SqueakyFloors/ubertooth/README.md

<p align="center">
  <picture>
    <source media="(prefers-color-scheme: dark)" srcset="docs/images/ubertooth_wordmark_dark.png">
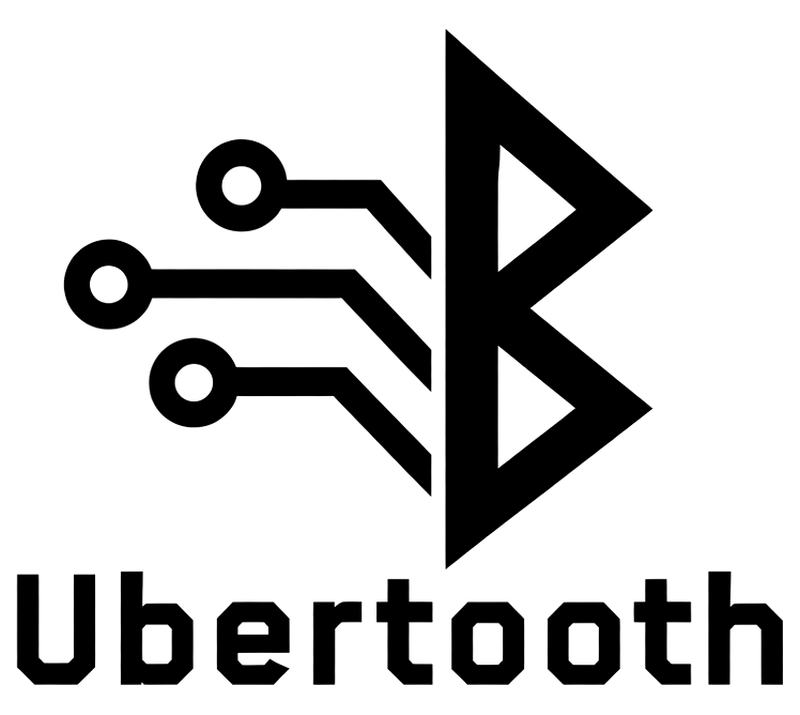
[picture p1: docs/images/ubertooth_wordmark.png]
Ubertooth
    
  </picture>
</p>

# Ubertooth

Project Ubertooth is an open source wireless development platform
suitable for Bluetooth experimentation. Ubertooth ships with a capable
BLE (Bluetooth Smart) sniffer and can sniff some data from Basic Rate
(BR) Bluetooth Classic connections.

This fork was developed largely with the help of AI coding agents, directed by
the maintainer. See [AI-DISCLOSURE.md](AI-DISCLOSURE.md) for how.

## Hardware

An Ubertooth One is a USB 2.4 GHz radio: a CC2400 transceiver behind a CC2591
front end, driven by an LPC175x ARM Cortex-M3, with an RP-SMA antenna jack.

Ubertooth One

The [hardware page](docs/source/ubertooth_one.rst) describes the board, what its
radio can and cannot do, and its connectors and LEDs. The KiCad
[design files](hardware/ubertooth-one) it is built from are in this tree.

## What it is good for

Ubertooth is a sniffer. Unlike a phone app such as nRF Connect or
LightBlue, which sees only its own connection after the operating system
has handled it, Ubertooth listens to the air and hears other devices'
traffic.

- **Passive BLE capture** of advertising and of connections between
  other devices: link-layer packets, connection setup, channels and
  timing, saved as PCAP for Wireshark.
- **Spectrum analysis** of the 2.4 GHz band, to see what else is
  transmitting and where.
- **Bluetooth Classic discovery**: finding nearby piconets by address,
  including devices that are not discoverable.
- **Scriptable**: every feature is a command-line tool with defined output
  and exit codes, so it fits test rigs and automation.
- **Open**: the firmware and host tools can be changed for custom 2.4 GHz
  radio experiments.

## What it cannot do

- **BLE on the 1M PHY only.** The CC2400 radio cannot receive the
  Bluetooth 5 LE 2M or Coded (long-range) PHYs, so it cannot capture
  extended-advertising data, and it loses a connection that switches to
  2M. Most current phones, computers and peripherals switch to 2M right
  after connecting.
- **Classic Bluetooth: Basic Rate only.** The CC2400 radio demodulates only
  GFSK, so no firmware can capture EDR payloads, which use phase modulation
  and carry most audio and fast data. Their access code and header are still
  seen. Following a piconet is slow and partial.
- **No decryption** of encrypted links without their keys.

To sniff Bluetooth 5 traffic, use a sniffer built on a Bluetooth 5 radio,
for example Nordic's nRF Sniffer for Bluetooth LE on an nRF52840 dongle.

## Versions, libbtbb, and firmware

The most recent upstream release is
[2020-12-R1](https://github.com/greatscottgadgets/ubertooth/releases/tag/2020-12-R1),
whose firmware build is on that release page. This fork's own tags are under
[Releases](#releases) below.

That release is paired with [libbtbb 2020-12-R1](https://github.com/greatscottgadgets/libbtbb/releases/tag/2020-12-R1).
The current tree instead builds against this project's
[libbtbb fork](https://github.com/SqueakyFloors/libbtbb), pinned to one commit
that `install.sh`, CI and the build guide all use, so a push to libbtbb cannot
change an Ubertooth build. The fork builds with current CMake and Python
tooling, so no extra policy or compatibility flags are needed.

Instructions for flashing the firmware are in this tree's
[firmware page](docs/source/firmware.rst).

Host tools and firmware belong together: they are built to run against each
other's firmware API version, so flash the firmware whenever you update the
tools, from the same commit or tag —
`./install.sh --flash-device <index|serial|all>`. The API version is bumped
only when a firmware change breaks older host tools, so the same version does
not mean the same commit. Tools built from a release refuse a board whose
firmware reports a different version; tools built from a clone, which is what
`./install.sh` gives you, warn about it and run the command anyway, so reflash
from the commit you built the tools from before trusting what they report.

## Building

Instructions for building libbtbb by hand, with the pin, are in this tree's
[build guide](docs/source/build_guide.rst). libbtbb and libubertooth both
install to whichever library directory the system uses — `lib`, `lib64`, or
`lib/<triplet>` — so the two land together; the host build and `install.sh`
ask CMake and pkg-config which it is rather than assuming, and
`-DCMAKE_INSTALL_LIBDIR=` chooses it.

Build dependencies (required vs optional, and what each enables) are listed in [REQUIREMENTS.md](REQUIREMENTS.md).

The install writes `libubertooth.pc`, so a program of your own built against
the installed library takes its flags from
`pkg-config --cflags --libs libubertooth` rather than being given them by
hand. A CMake project of your own finds the same install with
`find_package(ubertooth)` and links `ubertooth::ubertooth`; see
[host/README.cmake.md](host/README.cmake.md).

## Quick install (Debian/Ubuntu, Fedora, and macOS)

From a checkout of this repository, [`install.sh`](install.sh) does the whole
from-source setup in one command — system dependencies, libbtbb, the host
tools, specan_ui Python deps, and (on Linux) udev rules:

```sh
./install.sh                              # everything but the firmware
./install.sh --venv ~/ubertooth-venv      # isolate the Python tools in a venv
./install.sh --flash-device <index|serial|all>   # also build + flash firmware
./install.sh --uninstall                  # take it all back off again
```

`--update-bootloader`, alongside `--flash-device`, also installs the bootloader
this tree builds and puts the firmware back afterwards. A board that already
has that bootloader is left alone, and boards are done one at a time. Keep a
serial programmer to hand before you run it: an interrupted bootloader write
leaves a board needing one. See `ubertooth-dfu(1)`, UPDATING THE BOOTLOADER.

`--uninstall` removes the files an earlier run recorded — the tools, the
libraries, the man pages, the udev rule — and nothing else: the distribution
or Homebrew packages, the Python packages, and a `--venv` directory all stay.
The libbtbb it installed stays too unless you ask for it with
`--remove-libbtbb`, or say yes when it asks, because anything else
on the machine built against that libbtbb stops building until it is put back.

On Linux it installs into `/usr/local` with `sudo`, taking the dependencies
from `apt` on Debian/Ubuntu and from `dnf` on Fedora. On macOS it needs
[Homebrew](https://brew.sh), installs into the Homebrew prefix without `sudo`,
and skips `ubertooth-scan`/`ubertooth-follow` (no BlueZ on macOS); use
`--venv` there so the Python packages stay out of the system Python. Run
`./install.sh --help` for all options, including `--prefix`,
`--skip-deps` (use already-installed system packages), and
`--libbtbb-url`/`--libbtbb-ref`, which build a libbtbb other than the pinned
fork commit (`--help` prints the pin). This is the from-source path; it is not
a replacement for distro packaging (apt/dnf/brew).

## Releases

Release tags take three forms, all built on the `YYYY-MM-Rn` one this project
has always used:

- `YYYY-MM-DEVn` is a development pre-release: a snapshot of `main` published
  for integration testing. It may be deleted later, so do not build anything
  long-lived on one.
- `YYYY-MM-RCn` is a release candidate.
- `YYYY-MM-Rn` is the release.

Development and release-candidate tags are published as GitHub pre-releases, so
the release page's "Latest" link always points at a release.

Flash the firmware from the same tag as the tools you installed, for the reason
given [above](#versions-libbtbb-and-firmware).

The current pre-release is
[2026-11-DEV1](https://github.com/SqueakyFloors/ubertooth/releases/tag/2026-11-DEV1).

--------------------

# Tools

Ubertooth ships a set of host command-line tools. Each links to its manual page.
"Needs" indicates what a test/use requires beyond the Ubertooth itself.

New to Bluetooth internals? [How Bluetooth sniffing works](docs/concepts.md)
explains the ideas these tools are built on — hopping, address parts,
whitening, clock recovery, the Low Energy connection request — and which tool
does which step.

### BLE
| Tool | What it does | Needs |
|---|---|---|
| [ubertooth-btle](host/doc/ubertooth-btle.md) | Passive BLE monitoring; follow connections (`-f`), capture advertising (`-n`), or stream PCAP to stdout (`-q -`/`-c -`) | ambient BLE |
| [btle-extcap.py](host/doc/btle-extcap.md) | Lets Wireshark capture BLE advertising from an Ubertooth directly, by running `ubertooth-btle` for it ([guide](docs/source/using_ubertooth_with_wireshark.rst)) | Wireshark |

### Classic Bluetooth (BR/EDR)
| Tool | What it does | Needs |
|---|---|---|
| [ubertooth-rx](host/doc/ubertooth-rx.md) | Passive Classic BT discovery/decode (finds piconets, LAP/UAP); saves raw captures (`-d`) and replays them without a device (`-i`) | a Classic BT peer |
| [ubertooth-afh](host/doc/ubertooth-afh.md) | Passively recover a piconet's AFH channel map | an active piconet |
| [ubertooth-follow](host/doc/ubertooth-follow.md) | Active clock discovery + follow a piconet for a target address | BlueZ + target; **Linux only** |
| [ubertooth-scan](host/doc/ubertooth-scan.md) | Active inquiry scan (uses a BlueZ dongle + Ubertooth) | BlueZ dongle; **Linux only** |
| [ubertooth-btbr](host/doc/ubertooth-btbr.md) | **Experimental**, and the only tool that needs the separate `btbr` firmware: take part in Classic BT — inquiry, paging, `monitor` mode (capture a connection as it is set up), and transmitting chosen packet types | the `btbr` image; a Classic BT peer |

`ubertooth-follow` and `ubertooth-scan` drive a second, ordinary Bluetooth
adapter through BlueZ, so they are built on Linux only and are not coming to
macOS: the operations they ask of that adapter — a clock read and the AFH map
for `ubertooth-follow`, the remote version and features for `ubertooth-scan
-x` — are not in macOS's public Bluetooth APIs. On a Mac, cover much of the
same ground passively with `ubertooth-rx` and `ubertooth-afh`, which need no
adapter — see
[COMPATIBILITY.md](COMPATIBILITY.md#macos-ubertooth-scan-and-ubertooth-follow-are-linux-only)
for the operation-by-operation comparison and the alternatives.

### Signal / low-level
| Tool | What it does | Needs |
|---|---|---|
| [ubertooth-specan](host/doc/ubertooth-specan.md) | Spectrum analyzer: stream of 2.4GHz signal strengths | — |
| [ubertooth-specan-ui](host/doc/ubertooth-specan-ui.md) | Graphical live spectrum plot of 2.4GHz ([guide](docs/source/specan_ui.rst)) | Python 3.8+: numpy, qtpy, PySide6 or PyQt5 |
| [ubertooth-dump](host/doc/ubertooth-dump.md) | Raw stream of received bits/symbols, Bluetooth or generic (`-g`, experimental) | — |
| [ubertooth-debug](host/doc/ubertooth-debug.md) | Low-level CC2400 radio register reads, and writes (`-w`, experimental) | — |

### Device administration & firmware
| Tool | What it does | Needs |
|---|---|---|
| [ubertooth-util](host/doc/ubertooth-util.md) | Device admin: versions (`-V`), the board's bootloader (`-B`), LEDs, reset, channel, device count, the watchdog state, why the board last reset itself, and how many radio waits gave up (`-w`) | — |
| [ubertooth-dfu](host/doc/ubertooth-dfu.md) | Flash/read firmware over DFU | — |

### Special-purpose
| Tool | What it does | Needs |
|---|---|---|
| [ubertooth-ducky](host/doc/ubertooth-ducky.md) | Drive an Uberducky BLE HID-injection gadget | Uberducky hardware |
| [ubertooth-ego](host/doc/ubertooth-ego.md) | Sniff a Yuneec E-GO skateboard (niche) | Yuneec E-GO |
| [ubertooth-tx](host/doc/ubertooth-tx.md) | Transmit a generic packet (`-g`, experimental); retransmitting dumped symbols is **non-functional** | — |

### Options every tool has

`-h` prints a tool's usage text. `-V` prints the version, in the same words
whichever tool you ask: the release the host tools and libbtbb were built
from, then the firmware version of the board `-U` names, or of
each attached board. Both are in every tool, including the three written in
Python — `ubertooth-btbr`, `btle-extcap.py` and `ubertooth-specan-ui` — which
answer `-V` by running `ubertooth-util -V` and passing its answer on, so they
need it on their `PATH`. `-v` is not in every tool: see below.

```sh
$ ubertooth-util -V
Host tools version: 2026-11-DEV1+22 (libbtbb 2026-11-DEV1+22)
Firmware version: bluetooth_rxtx 2026-11-DEV1+22 (API:<version>)
```

With no board attached it prints the host line and `Firmware version: no
Ubertooth attached`, and still exits 0, so it answers "which tools am I
running?" on its own. Reading the version does not stop a mode the board is
running, and works on whatever firmware the board is carrying.

`-v` means verbose where a tool has verbose output (`ubertooth-btle -v`,
`ubertooth-specan -v`, `ubertooth-debug -v <0-2>`). One older spelling is kept
for existing scripts: `ubertooth-util -v` prints the firmware version line
alone (deprecated: use `-V`). See the
[Ubertooth overview man page](host/doc/ubertooth.md), COMMON OPTIONS.

### Which firmware a tool needs

Two firmware images run the tools, and a board carries one at a time.
`ubertooth-btbr` needs `btbr`; every other tool needs `bluetooth_rxtx`, the
standard image that `./install.sh --flash-device` builds and writes. Switch a
board to `btbr` and back with:

```sh
ubertooth-dfu -d firmware/btbr/btbr.dfu -r                      # for ubertooth-btbr
ubertooth-dfu -d firmware/bluetooth_rxtx/bluetooth_rxtx.dfu -r  # for everything else
```

Add `-U <index|serial>` to either command to pick one board of several; it
works from both images. A tool run against the wrong image fails rather than
waiting: `ubertooth-btbr` says it could not set the Ubertooth up, naming
`bluetooth_rxtx` and the image to flash, and the other tools fail on the first
request the `btbr` image does not answer. Neither is refused over its firmware
API version, because both images report this tree's.

To see which image a board is carrying, ask it — `-V` names the image as well
as the revision, and answers whichever image is running:

```sh
$ ubertooth-util -U <serial> -V
Host tools version: 2026-11-DEV1+22 (libbtbb 2026-11-DEV1+22)
Firmware version: bluetooth_rxtx 2026-11-DEV1+22 (API:<version>)
```

`ubertooth-dfu` names what is in a firmware file before it writes anything
(`Image: btbr 2026-11-DEV1+22 (API:<version>)`), and refuses a file that is not an
Ubertooth image, so the wrong file is caught before the board is touched.

The API version moves with the firmware, so these samples write it as
`<version>`; [COMPATIBILITY.md](COMPATIBILITY.md) names the value this tree
requires.

See also the [Ubertooth overview man page](host/doc/ubertooth.md).

--------------------

# Documentation

The documentation files are in the [docs folder](docs) of this repository:
[docs/source](docs/source) holds the chapters and `host/doc` the manual pages.
The [Read the Docs site](https://ubertooth.readthedocs.io/en/latest/) is built
from upstream, so it describes upstream rather than this fork.

[CONTRIBUTING.md](CONTRIBUTING.md) covers what a change to this fork needs:
the tests to run, and the CI checks a pull request has to pass.

The [validation folder](validation) holds the manual pre-release checklist a
person works through on a real Ubertooth, and will hold the description of the
validation bench and the per-release validation reports.

After editing a man page source in `host/doc/`, regenerate its committed roff
page and commit both, or the `Man pages` CI job fails:

```sh
cmake -S host -B build
cmake --build build --target refresh-manpages
```

--------------------

# Getting Help

Before asking for help with Ubertooth, check to see if your question is listed
in the [FAQ](docs/source/faq.rst).

For something this fork does, or does not do, open an
[issue here](https://github.com/SqueakyFloors/ubertooth/issues); searching the
closed ones first often answers the question. For Ubertooth in general, the
[upstream issues](https://github.com/greatscottgadgets/ubertooth/issues) are
where most questions have already been asked and answered.

Great Scott Gadgets hosts the project's community discussions on
[Discord](https://discord.gg/rsfMw3rsU8). Technical support requests are
welcome there, but there is no support staff on duty at all times, so open an
issue as well if you have found a bug or want your request tracked. Response
times on this fork's issues are whatever the maintainer can manage; the
two-week response time Great Scott Gadgets offers for "technical support"
issues applies to the upstream repository, not to this one.

--------------------

# Credits

Ubertooth was created by Great Scott Gadgets, with Michael Ossmann
([@mossmann](https://github.com/mossmann)), Dominic Spill
([@dominicgs](https://github.com/dominicgs)), and Mike Ryan
([@mikeryan](https://github.com/mikeryan)) as its principal authors. This fork
builds on their work and on contributions from the wider community. See
[CREDITS.md](CREDITS.md) for the original authors, contributors whose work is
incorporated here, and every upstream contributor.
