SqueakyFloors/ubertooth/firmware/bootloader/README

bootloader.c is the first level firmware on the Ubertooth.  With this installed
you can update the main application over USB.

The bootloader must be installed using a hardware programmer (serial or JTAG).
For example, a Pogoprog (serial programmer) may be used with the In-System
Programming (ISP) mode.  Once the bootloader is installed, application firmware
may be loaded repeatedly over USB without requiring additional hardware.
Commercially produced Ubertooth devices should have the bootloader installed at
the factory.

Operation:

The bootloader executes every time the device starts up from reset or power
cycle.  Normally it just gets out of the way and passes control to the
application firmware very quickly.  Alternatively it can enter DFU mode which
permits firmware upload and download over USB.  There are two ways to tell the
bootloader that you want it to enter DFU mode:

1. soft bootloader entry: By setting a flag in RAM, the application firmware
can instruct the bootloader to enter DFU mode following a reset (without loss
of power).  For example, with the bluetooth_rxtx firmware running you can
update the firmware via DFU mode using the 'ubertooth-dfu' (located in
host/ubertooth-tools/src/).  Soft entry only works on Ubertooth One, not
Ubertooth Zero.

2. hard bootloader entry (aka pin entry): By connecting the entry pin to ground
on the expansion header during reset, you can force the bootloader into DFU
mode. Keep the bridge connected while applying power/reset. Once the distinctive
LED sequence starts or the DFU USB device enumerates, the pin has been sampled
and the bridge may be removed without exiting DFU. Start a DFU request promptly
because an untouched pin-entry session times out after a few seconds.

Remove the bridge before resetting into the application. If it remains
connected, the next reset samples the asserted entry pin again and re-enters the
bootloader. A permanently installed bridge is therefore suitable only when
repeated bootloader entry is intended, not for normal application boot.

The bootloader indicates DFU mode by flashing the LEDs in a distinctive
pattern.  It also identifies itself as "usb_bootloader" on USB.

During DFU mode, firmware may be uploaded or downloaded using ubertooth-dfu.
For usage instructions, run 'ubertooth-dfu -h'.

It is possible that soft bootloader entry may be broken by installing a faulty
application or an application that does not provide a method of triggering soft
entry.  In this case, pin entry must be used (e.g. by holding a paper clip in
the expansion header while plugging in the device) to "unbrick" the unit.

For Ubertooth One, the pins to connect are pins 1 and 3 of the expansion header
(P4).  For Ubertooth Zero, the pins to connect are pins 1 and 13 of the
expansion header (J1).

The bootloader is installed at 0x0000.  It installs application firmware at
0x4000.

To build the bootloader you will need to install libstdc++ for ARM.
On Debian based systems:
apt-get install libstdc++-arm-none-eabi-newlib
