SqueakyFloors/ubertooth/docs/source/sniffing_BR_EDR.rst

Sniffing Classic Bluetooth
~~~~~~~~~~~~~~~~~~~~~~~~~~

Classic Bluetooth Basic Rate/Enhanced Data Rate (BR/EDR) sniffing works
differently from BLE. There is no
advertising channel to watch: a piconet hops across 79 channels, 1600 times a
second, in a sequence derived from the central's address and clock. Ubertooth
recovers those parameters from the air before it can follow a piconet.

Ubertooth's CC2400 radio supports Basic Rate using Gaussian Frequency-Shift
Keying (GFSK) at 1 Mbit/s only. EDR payloads cannot be demodulated, and
encrypted traffic cannot be decrypted.

Bluetooth address parts
^^^^^^^^^^^^^^^^^^^^^^^

A Classic Bluetooth Device Address (BD_ADDR) such as ``22:44:66:88:AA:BB``
has three parts:

.. list-table::
  :header-rows: 1

  * - Part
    - Bits
    - Example
    - How Ubertooth gets it
  * - Non-significant Address Part (NAP)
    - top 16
    - ``22:44``
    - Not transmitted in normal packets (see :ref:`finding-the-nap`)
  * - Upper Address Part (UAP)
    - next 8
    - ``66``
    - Calculated from captured packets (header error check / CRC)
  * - Lower Address Part (LAP)
    - low 24
    - ``88:AA:BB``
    - Read directly from every packet's access code

Normal packets in an established piconet do not carry the NAP. Their access
code is derived from the LAP; their hop sequence uses the LAP, the low bits of
the UAP, and the central's clock; and their header error check and CRC are
seeded with the UAP. Frequency Hop Synchronization (FHS) packets used during
inquiry and paging are the exception: their payload can carry the full
address.

Choosing the tool and firmware
^^^^^^^^^^^^^^^^^^^^^^^^^^^^^^

.. list-table::
  :header-rows: 1
  :widths: 25 20 55

  * - Tool
    - Firmware
    - Use it to
  * - ``ubertooth-rx``
    - ``bluetooth_rxtx``
    - Discover piconets by LAP and UAP, recover the clock, and follow
      passively. Works on Linux and macOS.
  * - ``ubertooth-afh``
    - ``bluetooth_rxtx``
    - Detect the adaptive frequency hopping (AFH) channel map of a known
      piconet.
  * - ``ubertooth-scan``
    - ``bluetooth_rxtx``
    - Find undiscoverable devices with Ubertooth and read each one's name with
      a normal BlueZ adapter; ``-x`` adds its version and features, and ``-s``
      adds a BlueZ inquiry for the discoverable ones. Linux only.
  * - ``ubertooth-follow``
    - ``bluetooth_rxtx``
    - Follow a piconet, given the target's whole address (``-t``) or the LAP
      and UAP a survey found (``-l`` and ``-u``), using a BlueZ adapter to
      recover the clock. Linux only.
  * - ``ubertooth-btbr``
    - ``btbr``
    - Inquiry, paging, and *monitor* mode (capture a connection as it is set
      up, including the FHS packet). Experimental.

``bluetooth_rxtx`` is the standard firmware that every other tool, including
``ubertooth-btle``, needs. The ``btbr`` firmware is a separate image for
``ubertooth-btbr`` only. Flash it with
``ubertooth-dfu -d firmware/btbr/btbr.dfu -r`` (see
:ref:`the-two-firmware-images`), and flash ``bluetooth_rxtx.dfu`` again
afterwards to use the other tools.
``ubertooth-util -V`` says which image a board is carrying, so it confirms
either switch:

	.. code-block:: sh

		$ ubertooth-util -U <serial> -V
		Host tools version: 2026-11-DEV1+22 (libbtbb 2026-11-DEV1+22)
		Firmware version: btbr 2026-11-DEV1+22 (API:<version>)

Typical workflow
^^^^^^^^^^^^^^^^

#. **Survey** for nearby piconets. Survey mode records each LAP it sees and
   calculates UAPs where it can. Devices only show up while they are actively
   communicating, so start some traffic (for example, play audio to a
   headset) during the survey:

	.. code-block:: sh

		ubertooth-rx -z -t 30

#. **Follow** a piconet. With only a LAP, ``ubertooth-rx`` calculates the
   UAP; with both, it skips straight to clock recovery. Write packets to a
   capture file for Wireshark:

	.. code-block:: sh

		ubertooth-rx -l 88aabb -u 66 -r capture.pcapng

   The clock takes a while to arrive: the search needs enough hops of the
   piconet to tell the candidate clocks apart, so following starts some way
   into the capture, and a link heard rarely, or held to a few channels, may
   give no clock at all. The addresses and the packets the board hears are
   recovered either way, and the capture above is still written.
   ``ubertooth-rx(1)``, THE CLOCK SEARCH describes what the search needs and
   what else reaches a clock.

#. **Check the AFH map** if following is unreliable. Many piconets use AFH
   to avoid busy channels, which changes the hop sequence:

	.. code-block:: sh

		ubertooth-afh -l 88aabb -u 66

#. **Open the capture** in Wireshark. The Bluetooth Baseband (BTBB) and
   BR/EDR dissectors are built into Wireshark 2.2 and newer; see the
   Wireshark plugins section of the :doc:`build_guide` for older versions.
   :doc:`bluetooth_captures_PCAP` describes the capture format.

See the man pages in ``host/doc/`` (`ubertooth-rx.md <https://github.com/SqueakyFloors/ubertooth/blob/main/host/doc/ubertooth-rx.md>`__, `ubertooth-afh.md <https://github.com/SqueakyFloors/ubertooth/blob/main/host/doc/ubertooth-afh.md>`__,
`ubertooth-scan.md <https://github.com/SqueakyFloors/ubertooth/blob/main/host/doc/ubertooth-scan.md>`__, `ubertooth-follow.md <https://github.com/SqueakyFloors/ubertooth/blob/main/host/doc/ubertooth-follow.md>`__) for all options.

Following with help from a local Bluetooth device
^^^^^^^^^^^^^^^^^^^^^^^^^^^^^^^^^^^^^^^^^^^^^^^^

``ubertooth-rx`` above recovers the piconet's clock from the air alone, which
takes a piconet that keeps transmitting and can take a while.
``ubertooth-follow`` shortens that: it pages the target through a local
Bluetooth device, reads the clock offset of the connection it gets, and hands
that to the board. It needs Linux with BlueZ and a working local Bluetooth
device; there is none on macOS, so the tool is not built there.

#. **Check the local Bluetooth device.** With none, ``ubertooth-follow`` stops
   before it opens the board:

	.. code-block:: sh

		hciconfig hci0 up

#. **Survey** for the piconet as above, so you have its LAP and UAP:

	.. code-block:: sh

		ubertooth-rx -z -t 30

#. **Follow the piconet**, by the whole address of the device that leads it if
   you know it, or by the four bytes the survey reported:

	.. code-block:: sh

		ubertooth-follow -t 22:44:66:88:aa:bb -q capture.pcap
		ubertooth-follow -l 88aabb -u 66 -q capture.pcap

   The two are the same follow. ``-t`` pages the address as given; ``-l`` and
   ``-u`` are four of the six bytes, so the tool pages ``00:00`` in place of
   the NAP, as described above. Either way the board is given the same LAP and
   UAP, which is all the ordinary traffic of an established piconet carries.

   Neither form stops on its own. Interrupt the run with Ctrl-C when you have
   the capture you wanted, or give it a length with ``timeout``.

#. **Find the right delay for this machine** with ``-w``, if the run prints
   packets and decodes little of what it prints. ``-w`` pays for the host's own
   delay between reading the clock and the board starting to hop, and its
   default of 5 does not suit every machine. "Decoded" here means the packet's
   header passed its check, which is what a wrong ``-w`` spoils while the
   record is still written. Sweep ``-w`` and keep the answer: on this project's
   bench a 25-second capture got 6169 good headers at ``-w 2`` and 28 at the
   default of 5. The ``-w`` section of
   `ubertooth-follow.md <https://github.com/SqueakyFloors/ubertooth/blob/main/host/doc/ubertooth-follow.md>`__
   says how to sweep it and how to read the result.

	.. code-block:: sh

		ubertooth-follow -t 22:44:66:88:aa:bb -w <value the sweep found> -q capture.pcap

#. **Add the AFH map** with ``-a`` if the piconet uses AFH and the follow is
   patchy. It reads the map over a connection it
   makes to the target, so it needs ``-t``; the AFH section of
   `ubertooth-follow.md <https://github.com/SqueakyFloors/ubertooth/blob/main/host/doc/ubertooth-follow.md>`__
   says what that map is, what it is not, and why the option is experimental.

	.. code-block:: sh

		ubertooth-follow -t 22:44:66:88:aa:bb -a -q capture.pcap

A follow captures the piconet's basic rate packets. EDR payloads are sent in a
modulation the radio cannot demodulate, so such a packet
arrives with its header and without its payload, and the contents of an
encrypted link stay unreadable whatever the capture holds.
`ubertooth-follow.md <https://github.com/SqueakyFloors/ubertooth/blob/main/host/doc/ubertooth-follow.md>`__
has the whole procedure, what a follow that has not locked on looks like, and
what it cannot capture.

.. _finding-the-nap:

Finding the NAP
^^^^^^^^^^^^^^^

The NAP is never sent in normal packets, so ``ubertooth-rx`` cannot recover
it.
You need it wherever a tool asks for the whole address: ``ubertooth-follow -t``
and its ``-a`` both do. Some ways to get it:

- **Use a placeholder NAP to connect.** A page uses the paged device's LAP and
  UAP, 32 bits, and no more of its address: the LAP builds the access code that
  every packet of the exchange begins with, the LAP with the low four bits of
  the UAP selects the page hopping frequencies, and the whole 8-bit UAP seeds
  the header error check and the CRC of the FHS packet the pager sends
  (Bluetooth Core, Vol 2, Part B 1.2, 1.3, 6.3.3, 6.4.6, 7.1, and Table 2.3).
  The paged device's NAP is in no packet of the exchange; the only whole address
  that goes out is the pager's own, in that FHS packet (8.3.3.2).
  BlueZ's ``hci_create_connection()`` hands the controller all six bytes, and a
  page teaches the controller no NAP, so the address it reports back in its
  events is the one it was given. BlueZ's own address checks therefore match,
  and the reads that follow a page are keyed on the connection handle or on that
  same address. ``ubertooth-scan`` relies on this: it pages
  ``00:00:<UAP>:<LAP>`` through BlueZ to read the device's name, and with
  ``-x`` its version and features. It prints ``??:??`` where the NAP would be
  in its results, and
  ``00:00`` in the address line of the extended report, which is the address it
  really connected to.

  Three things a placeholder does not cover. The whole UAP is used, so a wrong
  UAP stops the page. Anything that pairs with the target or authenticates the
  link needs its real address; neither ``ubertooth-scan``'s reads nor
  ``ubertooth-follow -a``'s map read does. And a controller refuses to page its
  own address (8.3.2), so a placeholder that happened to match the local
  adapter's would fail. What a real controller makes of the guess has not been
  measured on this project's bench.
- **Narrow it by manufacturer.** The NAP and UAP together form the
  manufacturer's 24-bit Organizationally Unique Identifier (OUI)
  (``22:44:66`` above). Search the `IEEE OUI registry
  <https://regauth.standards.ieee.org/standards-ra-web/pub/view.html#registries>`__
  for OUIs whose last byte equals the recovered UAP. Combined with the device's
  name or vendor, this often leaves a single candidate.
- **Capture an FHS packet.** The FHS packet carries the full BD_ADDR,
  including the NAP (see below).
- **Read it from the device.** If you control a paired device, its Bluetooth
  settings show the full address.

Capturing FHS packets
^^^^^^^^^^^^^^^^^^^^^

FHS packets are brief discovery and connection-establishment traffic. Devices
send them as inquiry responses, and the central sends one to the peripheral
during paging. They contain the sender's full BD_ADDR and clock. Because they are sent only during inquiry or paging,
passively following an established piconet with ``ubertooth-rx`` will not see
them.

``ubertooth-btbr`` monitor mode targets the paging phase. Flash the ``btbr``
firmware, then watch for pages to a peripheral whose address you know:

	.. code-block:: sh

		ubertooth-btbr
		bt> monitor 11:22:33:44:55:66

With more than one board attached, name the one carrying ``btbr`` with
``-U <index|serial>``, as the other tools take it; without it the tool lists
the attached boards and opens none.

Then connect to that peripheral from another device. If Ubertooth receives the
FHS before the real peripheral does, it synchronizes to the new piconet and
prints the FHS and the unencrypted Link Manager Protocol (LMP) traffic that
follows. If no FHS appears,
the peripheral responded first; try connecting again.

Limitations:

- This is a race and often takes several attempts.
- Packets sent after encryption is enabled are shown as raw data and cannot be decrypted.
- ``ubertooth-btbr`` needs the ``btbr`` image. On a board carrying
  ``bluetooth_rxtx`` it stops before its prompt with
  ``error: could not set up``, naming the board it got and the image to
  flash: that
  firmware never reads the endpoint the tool writes to, which is what the
  reports of the tool hanging shortly after start (upstream issue
  `#520 <https://github.com/greatscottgadgets/ubertooth/issues/520>`__) turned
  out to be.

`ubertooth-btbr.md <https://github.com/SqueakyFloors/ubertooth/blob/main/host/doc/ubertooth-btbr.md>`__ documents the other prompt commands
(``inquiry``, ``page``, ``inquiry_scan``, ``page_scan``, ``discoverable``,
``l2ping``, ``tx``, ``bdaddr``, ``idle``), the options, and the limitations.
