SqueakyFloors/ubertooth/host/doc/ubertooth-btle.md

# ubertooth-btle(1) -- Bluetooth Low Energy (BLE) sniffing and more

## SYNOPSIS

    ubertooth-btle {-f | -n | -p} [-A 37|38|39] [-t <BD ADDR>] [-i | -I]
    [-k [01]] [-v] [-x <0-32>] [-r <output.pcapng>] [-q <output.pcap>|-]
    [-c <output.pcap>|-] [-d <output.bin>|-] [-U <index|serial>]
    ubertooth-btle {-f | -n | -p} -R <input.bin> [-v] [-x <0-32>]
    [-r <output.pcapng>] [-q <output.pcap>|-] [-c <output.pcap>|-]
    [-d <output.bin>|-]
    ubertooth-btle -s <BD ADDR> [-A 37|38|39] [-U <index|serial>]
    ubertooth-btle [-a [<address>]] [-k [01]] [-t <BD ADDR>]
    [-U <index|serial>]
    ubertooth-btle [-U <index|serial>] -V
    ubertooth-btle -h

## DESCRIPTION

`ubertooth-btle` is a tool for doing Fun Stuff(TM) with BLE. It can do
the following things:

 - Sniff connections
 - Interfere with connections
 - Send advertising packets (experimental)

Sniffing connections is the most robust feature supported by
`ubertooth-btle`. It has two primary modes of operation: follow mode and
promiscuous mode.

Follow mode is the preferred mode for general use. In this mode,
Ubertooth will listen on one of three advertising channels waiting for a
BLE connection to be established. When a connection is established,
Ubertooth will hop along the data channels, passively capturing the data
sent between the central and peripheral. After the connection
terminates, Ubertooth will return to the advertising channel and wait
for another connection.

One connection is followed at a time. A connection request heard while a
connection is being followed is recorded in the capture like any other packet,
but is not acted on: the follow stays with the connection it started on until
that connection ends.

Ubertooth sees a connection end in one of two ways.

A pair of devices that closes the connection says so on the air. The follow
ends at the first connection event in which nothing is heard, counting from
the packet that closes the connection and the acknowledgment of it that the
other device sends. In practice that is one or two connection events after the
packet, and the capture usually holds the whole exchange: an acknowledgment
the board does not hear is not in it, and counts as the silence that ends the
follow.

Waiting for the connection to go quiet is what tells a real close from a
damaged packet. CRC verification is off unless it is asked for, so a
bit-errored data packet can look like the one that closes a connection, and a
connection that keeps delivering packets after it keeps being followed. The
wait cuts both ways, and `-k1` is the only thing that removes the exposure, by
dropping a damaged packet before the board reads it:

  * A connection event the board simply misses is silence too, so a damaged
    packet followed by a missed event does end a follow.
  * A connection that carries on for more than a connection event or two after
    a real close -- the devices still exchanging something -- keeps its follow
    and then ends it at the supervision timeout, as a connection that dies
    without warning does.

A connection that dies without warning ends at its supervision timeout
instead. The connection itself sets that timeout, anywhere from 100 ms to
32 s, and until it has passed a new connection between the same devices is
not followed.

Follow mode hops with whichever of the two channel selection algorithms the
connection uses. Which one that is was settled when the connection was made:
both ends say in their advertising and connect packets whether they support
algorithm 2, and a connection uses it only if both did. Ubertooth therefore
needs the advertisement as well as the connection request. If it caught only
the request, because the advertisement was lost, it follows the algorithm the
request asks for. That is right unless the advertiser was an older device with
no support for algorithm 2.

No-follow mode is similar to follow mode, but it only logs advertising
packets and will not follow connections as they are established.

Promiscuous mode is an experimental mode for sniffing connections after
they have already been established. This mode can be used to sniff
long-lived connections.

Promiscuous mode takes connections hopping with either channel selection
algorithm, by two different routes. What it has to work out is where the
connection goes next, and it starts from the spacings between the
connection's visits to the channel it is listening on.

Under algorithm 1 the pattern of those spacings repeats every 37 connection
events, however many channels the connection's map leaves in use, and that
gives the connection interval; timing one hop then gives the hop increment,
and the connection is followed from there.

Algorithm 2 has no hop increment: it takes each event's channel from the
access address, the 16-bit event counter, and the channel map. The access
address is known by then, so what remains is the interval -- which still
divides every spacing -- and the event counter. Promiscuous mode searches for
them: for each candidate interval and counter it works out where the
connection would have come to this channel, and takes the pair that accounts
for what it actually heard. Bluetooth 5.0 devices normally use algorithm 2.

That search starts once the algorithm-1 route has had its chance, after about
forty visits to the channel being listened on, and runs again on every set of
that many after it. A connection comes back to one channel about every 37
events, so forty visits is about eleven seconds at the shortest connection
interval a connection may use and many minutes at the longest. The search needs no channel map,
and it declines rather than answer on thin evidence, so a connection whose map
keeps about half the channels may take two or three sets before it is
recovered.

A connection recovered this way is followed without its channel map, because
the map is given out when the connection is made and never repeated. The
follow lands on the right channel for the events whose channel the map did
not move, which is roughly as many as the map keeps out of the 37, so a
capture of such a connection has gaps in it. Capturing from the setup with
`-f` has the map and does not.

That also means a recovered connection is heard less often than it speaks, so
promiscuous mode gives an algorithm-2 follow 64 connection intervals of
silence before it treats the connection as over, or five seconds, whichever is
longer. Five seconds is the longer of the two for any interval under about
78 ms, which is most connections; the 64 intervals are what matters on a slow
one, where they can be minutes.

Three limits are worth knowing. The search needs a run of about forty visits
to the channel being listened on, and a connection at the longest interval the
specification allows, 4 s, comes back to one channel so rarely that the board
cannot time the gaps: at that interval no run is collected and nothing is
recovered. A connection whose channel map keeps less than about a third of the
37 channels is out of reach as well: too many of the visits the board hears
are events the map moved to this channel, which no event counter predicts, so
the search never gets a winner clear enough to adopt. And the interval it
reports is the one the board's clock measured,
which at a long interval can be a unit of 1.25 ms away from the figure the
connection was given, because the two clocks differ by a few hundred parts
per million.

A recovered connection using all 37 channels is not captured whole either. The
follow starts from one packet of one connection event, and where in that event
the packet fell is where every later hop lands, so what share of the
connection a recovered follow catches is settled by that first packet and
differs from run to run. Capturing from the setup with `-f` does not have
that.

When sniffing, Ubertooth can only operate in either follow mode or
promiscuous mode, but not both at the same time. If you are unsure which
mode to use, use follow mode.

While promiscuous mode hunts for an access address it is gated by the board's
squelch; follow and no-follow mode are not. `ubertooth-btle` does not set the
squelch, so it is the default -120 dBm unless `ubertooth-util -z` set another
value while the board was idle, and the firmware resets it on every mode
change, so it never carries over from an earlier capture. See
ubertooth-util(1), SQUELCH.

By default, Ubertooth will follow any connection it observes. You can
limit this to following a specific Bluetooth Address (BD ADDR) using the
`-t` command line flag. `-t` is for follow mode: it picks out a connection by
the device address its advertising and connect packets carry, which is what
`-f` watches for (in `-n` the board drops the advertising packets that do not
match it, and nothing else). Promiscuous mode starts on a connection that is
already running, whose packets carry no device address at all, so `-t` has
nothing to match there and is refused with `-p`. For example, the following
command will only sniff connections where the central or peripheral's BD ADDR
is `22:44:66:88:AA:CC`:

    ubertooth-btle -f -t 22:44:66:88:AA:CC

`-t` can also take a mask length in CIDR-like notation. Masks can be
0 to 48 bits long: 48 matches the entire address, and 0 clears the target as
`-t none` does. Using a /24 mask will filter on just the OUI. For example, to
limit sniffing to just TI devices with the OUI 00:1A:7D, use the
following:

    ubertooth-btle -t 00:1A:7D:00:00:00/24

Filters persist until they are explicitly cleared or the system restarts
(either via `ubertooth-util -r` or unplug/replug). To clear a filter,
use the special filter `none`. Example:

    ubertooth-btle -t none

When filtering, advertising packets that do not match the filter are
dropped.

In all sniffing modes, Ubertooth can log data to PCAP or PcapNG with a
variety of pseudoheaders. The recommended logging format is PcapNG
(`-r`) or PCAP with LE Pseudoheader (`-q`). For compatibility with
crackle (see [USING WITH CRACKLE][]), use PCAP with PPI (`-c`).

A PcapNG capture records the parameters of each connection it sees -- the
interval, the latency, the timeout and the channel map -- so that Wireshark
can follow that connection. They go in a part of the file that is set aside
when it is created, and it has room for a few hundred connections. A capture
long enough to fill it reports

    warning: the capture file has no more room for connection parameters; the packets are still recorded, but later connections cannot be followed in Wireshark

once on standard error and carries on. Start a new capture file to record
more. The format of a PcapNG capture's own options is specified in
`docs/source/bluetooth_captures_PCAP.rst`.

In every sniffing mode, a packet carrying a Bluetooth 4.2 Data Length
Extension payload, up to its 251-byte maximum, is captured whole: on the
screen, in PCAP and in PCAPNG. The board sends such a packet in several
fixed-size records, which are put back together before anything is decoded or
written.

Interfering with connections is a feature for causing intentional
interference with newly established or long-lived connections. When this
attack succeeds, the BLE connection between the central and peripheral
will be terminated. Pair the `-i` or `-I` flag with `-f` to interfere
with new connections or `-p` to interfere with long-lived connections.
`-i` or `-I` (or their older spellings `-j` and `-J`) with neither `-f` nor
`-p` is refused before any device is opened: there is no connection to
interfere with.
This describes the feature as it is meant to work; no capture mode acts on it
at the moment (see KNOWN BROKEN FEATURES).
Note that causing intentional interference may be illegal in your
jurisdiction. Check your local laws before using this feature.

Finally, `ubertooth-btle` supports transmitting advertising packets with
a specified BD ADDR. This feature, referred to as faux peripheral mode, is
experimental and may not function as intended. Use at your own risk.

## EXAMPLES

Sniff all connections on advertising channel 38, logging all data to
PcapNG:

    ubertooth-btle -f -A 38 -r log.pcapng

Log advertising packets without following connections:

    ubertooth-btle -n

Interfere with connections recovered with promiscuous mode:

    ubertooth-btle -p -I

Send advertising packets using BD ADDR `22:44:66:88:AA:CC`:

    ubertooth-btle -s 22:44:66:88:AA:CC

## OPTIONS

 - `-h` :
   Displays help message
 - `-V` :
   print the version: the host tools, then the firmware version of
   each attached board; see ubertooth(7), COMMON OPTIONS

Major modes:

 - `-f` :
   Follow mode: sniff connections as they are established
 - `-n` :
   No-follow mode: log advertising packets but don't follow connections
 - `-p` :
   Promiscuous mode: sniff already-established connections, hopping with
   either channel selection algorithm. An algorithm-2 connection, which is
   what Bluetooth 5.0 devices normally use, takes longer to recover and is
   then followed without its channel map, so the capture has gaps in it:
   where the connection can be caught as it is made, `-f` captures all of it.
   See DESCRIPTION.

   The connection parameters it recovers are reported as they are found:
   `Access Address`, `CRC Init`, `Hop interval`, and then either `Hop
   increment` for an algorithm-1 connection or `Algorithm 2 event counter`,
   the connection event the follow starts on, for an algorithm-2 one.

   It sets no channel of its own, except that an odd frequency becomes 2440
   MHz: the odd frequencies are not BLE data channels, and the board's default
   is 2441 MHz, so a board nobody has tuned listens on 2440. It discovers the
   access address of a connection on the channel it starts on, unless an
   earlier `ubertooth-btle -a <address>` command gave the board one to follow;
   nothing else makes it skip discovery, and `-t` is refused with it. A run
   that discovered its own address works the CRC init value and the interval
   out on 2440 MHz whatever `ubertooth-util -c` asked for, because finishing
   the discovery leaves the board on 2441; a run handed an address keeps the
   channel it was tuned to. Measuring the hop increment then moves the board
   between 2404 MHz and 2406 MHz, from whichever channel the earlier stages
   used. As it
   works a connection out it reports each parameter it has recovered: the
   access address, the CRC init value, the hop interval, and then either the
   hop increment or, for a connection hopping with algorithm 2, the event
   counter the follow starts on.
   Those lines go to standard output, or to standard error once `-q -` or
   `-c -` has taken standard output, so a capture written to a file still says
   which connection it is of.

   The hop interval is not read off the air; it is worked out by timing how
   long the connection takes to come back to the channel being listened on.
   That needs several of those returns in a row, so it arrives well after the
   CRC init value: about ten seconds on a 30 ms connection whose returns are
   all heard, and proportionally longer on a slower one. It is reported only
   once the spacings repeat and give a figure inside the range a connection
   interval may take, so a connection the board hears only part of gives the
   access address and the CRC init value and no interval or increment.

   Three things it does not report an interval for. A connection using fewer
   than about five data channels comes back too often for its pattern to fit
   in what the board keeps. A connection event that runs on for more than one
   interval, which a long exchange does, puts sightings inside it that are
   not returns. And a board that hears the returns unevenly, as a capture
   losing packets does, never sees a pattern repeat.

   One case it cannot see through: a board that hears exactly every second
   return, every time, reports twice the real interval, because two returns
   of one connection and one return of a connection twice as slow are the
   same span.

   Nothing hops until the interval is known, so a capture up to that point
   holds the one channel.
 - `-s <BD ADDR>` :
   Inject advertising packets using specified BD ADDR. Like `-a`, it does not
   go with `-f`, `-n` or `-p`. The value is one whole address and nothing
   else: a faux peripheral advertises from a single address, so the `/<bits>` mask
   and `none` that `-t` takes are refused here, each as the address it is not
   (`error: faux peripheral address must be xx:xx:xx:xx:xx:xx (got none)`).

Interference (only with `-f` or `-p`):

 - `-i` :
   Interfere with one connection and return to idle. Accepted but inert at the
   moment; see KNOWN BROKEN FEATURES
 - `-I` :
   Interfere continuously with many connections. Accepted but inert at the
   moment; see KNOWN BROKEN FEATURES
 - `-j` :
   Original "jam" spelling of `-i`; does exactly what `-i` does
 - `-J` :
   Original "jam" spelling of `-I`; does exactly what `-I` does

Filtering:

 - `-t <BD ADDR>` :
   Limit connection following and interference in follow mode to the
   specified BD ADDR. It is for the follow modes: `-f` follows only a
   connection whose advertising or connect packets carry this address, and
   `-n` drops the advertising packets that do not. Every form of it, `-t none`
   included, is refused with `-p`, which has no device address to match
   against: `error: -t does not go with -p: promiscuous mode has no device
   address to match a target against`. `-s` and `-t` are two different
   addresses and a command can give both: `-s A -t B` advertises from A and
   follows B, and `-t none` clears the target without touching the address
   `-s` was given.

Logging:

 - `-r <output.pcapng>` :
   Log to PcapNG (preferred). PcapNG output cannot be streamed to stdout because
   the writer must seek while finalizing the file, so a value that names that
   stream is rejected, `-r -`, `-r /dev/stdout`, and a symbolic link pointing
   there alike.
 - `-q <output.pcap|->` :
   Log to PCAP with `DLT_BLUETOOTH_LE_LL_WITH_PHDR`. Use `-` to stream binary
   PCAP to stdout.
 - `-d <output.bin|->` :
   Dump the records as the board sent them, which `-R` replays; see
   REPLAYING A SAVED CAPTURE, which also says which records a dump leaves out.
   It is the only one of these files that keeps the parameters promiscuous
   mode recovers, since those records carry no packet for a PCAP writer to
   take. Use `-` to stream the records to stdout.
 - `-c <output.pcap|->` :
   Log to PCAP with PPI (for compatibility with crackle(1)). Use `-` to stream
   binary PCAP to stdout, for example:

       ubertooth-btle -f -c - | wireshark -k -i -

   When stdout capture is selected, regular packet/status text is suppressed so
   it cannot corrupt the binary stream; errors remain on stderr. Such a run
   does not produce the per-packet dump at all, so the decoder's complaints
   about an advertising field it could not read in one of those packets do not
   reach stderr either. The lines that
   answer an option in the same command go to stderr rather than being
   suppressed with it: the `Access address:` line of `-a`, the `CRC:` line of
   `-k`, the target lines of `-t`, and the connection parameters `-p`
   recovers. The tool
   refuses to write binary capture data directly to an interactive terminal:
   `error: stdout is a tty, refusing to write binary capture data to it`, with
   exit status 1 and before any device is opened.

`-` means standard output as the whole value of `-q`, `-c` or `-d`, and so
does a path that names this process's descriptor 1, such as `/dev/stdout` or
`/dev/fd/1`, and a symbolic link pointing at one of those (ubertooth(7),
OPTION VALUES). Standard output carries one stream,
so only one capture can have it: `-d` together with `-q` or `-c` is refused,
however each of the two was spelled, naming the PCAP option written --
`error: -q and -d cannot both write to standard output` -- as it is in
ubertooth-rx(1). The one that asked second would otherwise write to
`/dev/null` without a word.

No two capture options may be one file either: each writer opens its own
destination for writing, which truncates what another has put there, so
`-q collision.pcap -d collision.pcap` is refused with
`error: -q and -d cannot both write to collision.pcap`, before either is
opened and with the file left as it was. Every pair of `-r`, `-q`/`-c`, and
`-d` is checked, and the file is identified rather than the name
(ubertooth(7), OPTION VALUES).

The times in a logged capture follow the board's capture clock, which starts
over every 429.50 s in the `-f` and `-n` modes and every 327.68 s in
promiscuous mode. A promiscuous packet carries a count of how often it has;
the packets of the other two modes carry none, so how often it started over is
worked out from the host's own clock instead: the time the host saw pass
between two packets says how many periods lie between their clock readings, so
a quiet gap keeps its time however long it was.

The `delta_t` printed beside each packet is the gap between two of these
times, so it too holds the whole of a quiet gap and a dump and a capture of
one run agree about a packet. The first packet of a capture reports no gap,
there being nothing to measure from.

Times that still come out short are reported, on standard error: `warning:
packet times are behind the host clock by more than half the capture clock's
429.50 s period: a quiet gap lost a clock wrap, or the host clock was stepped
forwards`. Both causes look the same from here, which is why the message names
each.

A `-q` or `-r` capture record carries the packet's own power, which is the
figure printed as `rssi=` as well. Follow and advertising capture (`-f`, `-n`)
average the readings of the packet in power rather than in dBm, which is what
the average of a set of dBm readings means. A promiscuous record (`-p`) carries
no average of its own, so the figure is the strongest reading the board took
around the packet.

No low-energy record carries a figure for the background, whatever the mode
read: the two status bits that would make one readable are set on Classic
records alone. Those records leave the noise-power-valid flag clear, Wireshark
shows the field as `Unused signed byte`, and no reader computes a
signal-to-noise ratio from them. Classic capture does carry one, which
ubertooth-rx(1) describes.

A `-c` PPI record carries the board's own RSSI readings instead, as described
below.

Miscellaneous:

 - `-A <37|38|39>` :
   Which advertising channel to use in follow mode (`-f`, `-n`) and faux peripheral
   mode (`-s`) (default: 37). Refused with `-p`, which sets no channel of its
   own.
 - `-a [address]` :
   Get (`-a`) or set (`-a <address>`) the access address used in promiscuous
   mode. The address is 1 to 8 hex digits (`-a 8e89bed6`); fewer than 8 means
   leading zeros (`-a 12345` sets `00012345`). Anything else is refused before
   the device is opened. Getting and setting in one command is refused; other
   options such as `-k` still run after a get. `-a` does not go with a
   sniffing mode (`-f`, `-n`, `-p`), which runs until it is interrupted; the
   combination is refused before any device is opened. So an address for `-p`
   is given by a command of its own first: `ubertooth-btle -a <address>` and
   then `ubertooth-btle -p`. It is the one setting that makes `-p` skip
   discovery, and the board keeps it until its low-energy state next resets:
   a connection timing out during a `-p` run, a `-p` run that went looking for
   an address itself, `ubertooth-util -r`, or a re-plug. A follow run (`-f`,
   `-n`) does not clear it. Promiscuous mode then discovers an address again
   rather than falling back to the advertising one.
 - `-k [01]` :
   Read (`-k`) or set (`-k 0` or `-k 1`) CRC verification
   (default: 0). Any other value is refused. A set and a read in one command
   both happen, the set first, so the read reports the new value, in whichever
   order they are written; two sets are refused, as two values for one setting
   are everywhere (ubertooth(7), OPTION VALUES). In a sniffing mode both
   run once the mode has started, because entering a mode clears the setting,
   and the firmware then turns verification on and off itself as it recovers a
   connection.

   Verification also decides what a follow (`-f`) acts on. With it off, a
   bit-errored data packet still reaches the board's reading of the
   connection, where its length and type fields are all that tell it from a
   connection update, a channel map change, or the packet that closes the
   connection; with it on, such a packet is dropped before any of that. It is
   the only way to rule those mistakes out (DESCRIPTION).
 - `-v` :
   Verbose, as in every other tool (ubertooth(7), COMMON OPTIONS): the decoder
   describes each packet whose data it could not read, on standard error, as
   the run goes. Without it a run counts those packets and says how many there
   were in one line when it ends (DIAGNOSTICS). It needs `-f`, `-n` or `-p`,
   since there is no decode to describe otherwise, and it takes no value. A
   capture on standard output, however it was named (`-q -`, `-c -`, `-d -`,
   `-d /dev/stdout`), prints no packets at all, so that too is refused:
   `error: -v does not go with a capture on standard output: a run that hands
   the capture that stream prints no packets to describe`.

   There is one level of it, so writing it twice says what writing it once
   said (ubertooth(7), OPTION VALUES).

   A value written here is refused as any valueless option's value is, and
   `-v` without a sniffing mode reads `error: -v needs -f, -n or -p: there is
   no decode for it to describe; the CRC verify setting is -k now`.
 - `-x <0-32>` :
   Allow n access address violations (default: 32). Filtering occurs on
   host.

Data source:

 - `-U <index|serial>` :
   select an Ubertooth by enumeration index or serial number; see
   ubertooth(7), SELECTING A DEVICE
 - `-R <input.bin>` :
   Replay a dump saved with `-d` instead of opening a board. It needs the
   major mode the dump was recorded with, and goes with no option that drives
   a board; see REPLAYING A SAVED CAPTURE.

## KNOWN BROKEN FEATURES

Interference (`-i`, `-I`, and their original jam spellings `-j` and `-J`) is
accepted, but no capture mode acts on it yet: the board follows or listens to
the connection as usual and transmits nothing, so a run with one of these
options is no different from a run without it. The tool prints one `warning:`
line saying so when any of them is given. The DESCRIPTION and OPTIONS below
describe the feature as it is meant to work; making it work again is tracked in
[issue #871](https://github.com/SqueakyFloors/ubertooth/issues/871).

## USING WITH CRACKLE

`crackle` is a tool for cracking the BLE key exchange and decrypting
encrypted data. To capture data for use with `crackle`, sniff
connections in follow mode using `-f` and log data to PCAP/PPI using
`-c`. Example:

    ubertooth-btle -f -c crack.pcap

Refer to `crackle` documentation for further details.

## TRANSMIT POWER

Injecting advertising packets (`-s`) transmits at the CC2400 power level set
with `ubertooth-util -a` and leaves it unchanged. A board that has not been
given a level transmits at 7 (0 dBm), the CC2400's reset value. Sniffing does
not transmit and does not change the level. Interference (`-i`, `-I`, `-j`,
`-J`) would transmit at the same level, but no capture mode acts on it at the
moment (see KNOWN BROKEN FEATURES), so it transmits nothing.
These levels are at the CC2400 radio; the Ubertooth One's RF amplifier changes
the actual output after that.

## REPLAYING A SAVED CAPTURE

Record the raw records once with `-d <file.bin>`, then decode them as often as
you like with `-R <file.bin>`, without the Ubertooth and without the
connection. Use it to decode again with other options (a tighter `-x`, or `-v`
to see what the decoder could not read), to write a PCAP from a dump you
already have, to analyse on another machine, to attach a capture to a bug
report, or as fixed input for tests:

    ubertooth-btle -p -d promisc.bin               # live, saving the records
    ubertooth-btle -p -R promisc.bin -r log.pcapng # later, no device needed

A dump is the only file that keeps what promiscuous mode works out about the
connection it found. Those four parameters -- the access address, the CRC init
value, the hop interval, and the hop increment or algorithm-2 event counter --
arrive in records of their own, which carry no packet, so a PCAP or PcapNG
capture has nowhere to put them. A replay prints them again, in the order they
were recovered, exactly as the live run did.

A replay needs the major mode the dump was recorded with (`-f`, `-n` or `-p`),
or it is refused: `error: -R needs -f, -n or -p: a dump does not record which
mode wrote it, and the modes stamp their packets with different clocks`. The
mode is what says which of the board's two capture clocks the records carry:
the low-energy engine behind `-f` and `-n` stamps packets from a counter that
starts over every 429.50 s, promiscuous mode from one that starts over every
327.68 s. A replay read with the wrong one comes out a period wrong once a
capture has run longer than the first of them, and nothing in the file would
say so.

The decoding options (`-v`, `-x`) and the capture files (`-r`, `-q`, `-c`,
`-d`) work as they do on live data. Every other option asks for a board the
replay has not opened, and is refused by name: `error: -U cannot be combined
with -R; a replay reads a saved dump rather than driving a board`, exit 1.
That covers `-U`, `-A`, `-k`, `-t` and the interference options; `-a` and `-s`
are already refused beside any major mode.

None of those capture files may be the dump being replayed: each is opened for
writing, which truncates it, so the dump would be emptied before a record of
it was read. `error: -d would write over the dump -R is replaying
(promisc.bin)`, exit 1, with the file left as it was. It is the file that is
compared and not the name, so `./promisc.bin`, a symbolic link to it and a
hard link to it are all refused, and so is a `-d -`, `-q -` or `-c -` whose
standard output the shell has already pointed at the dump. Naming that same
standard output as `/dev/stdout` or `/dev/fd/1` is caught as well, and so is a
destination reached through a descriptor the calling shell opened,
`-d /dev/fd/3` beside `3>>promisc.bin`: the descriptor is asked which file it
holds, rather than the path being looked up.

A redirection of the whole run names no capture option, so there is nothing
to refuse: the shell has already opened the file and pointed standard output
at it. What the decode would land in is said instead. With
`ubertooth-btle -p -R promisc.bin > promisc.bin` the shell empties the file
before ubertooth-btle(1) starts, as it would for any command; with `>>` the
decode is appended to the records, which leaves the file unreadable as a dump.
Either way the run prints `warning: the decode is going to the dump -R is
replaying, so the capture is lost` on standard error and goes on, and its exit
status is the one it would have had anyway. Only a regular file on standard
output is compared, since a pipe or a terminal holds no records to spoil.

The times reported are the recorded ones, not the time of the replay. The
`systime` of each packet line is the host time stored with that record, a
capture written with `-q`, `-c` or `-r` starts from the host time of the first
packet it decodes and follows the board's clock from there, and `-d` writes
the records back out with their original times.

A dump holds every record that carries a packet or a parameter, which for a
dump of a dump this tool wrote is all of them, byte for byte. Two kinds are
left out, live and on a replay alike: a keep-alive, which only says a quiet
capture is still running and holds neither, and a record whose channel is
outside the Bluetooth band. So a dump is a record of what was captured rather
than of every byte the board sent.

A replay that reaches the end of the file exits 0, including for an empty
file. These two are reported on standard error and exit 1, after whatever was
decoded:

 - a file that cannot be read, for example a directory:
   `error: reading <file> failed: Is a directory`
 - a last record cut short:
   `error: <file> ends in a partial record: 58 of 68 bytes, ignored`

A file that cannot be opened at all is reported the same way, before anything
is decoded: `error: <file>: No such file or directory`, exit 1.

A dump of a Classic capture, or any other file of 68-byte records this tool
does not recognize, is read to its end and decoded as nothing: no packets, no
message, exit 0. Nothing in a record says which tool wrote it, so a run that
prints nothing may be the wrong file rather than a quiet capture; ubertooth-rx(1)
replays a Classic dump.

A replay that could not read one whole record takes its own capture files away
again, so a failed run leaves no empty capture to be told apart from one that
caught nothing. From the first whole record on they are kept, however little
of the input came after it.

## ARGUMENTS

`ubertooth-btle` takes options only. A word that is not an option, including a
bare `-`, is refused before any device is opened and named:
`error: unexpected argument '<word>'`, with exit status 1.

`-h` and `-V` end the command only once the whole command line has
parsed, so a stray word or a bad option value is reported even
alongside them. Both answer on standard output, so a command line with both
prints both, the usage text last; the order they were written in makes no
difference.

An option value must be a whole value in its range, or it is refused the same
way instead of being read as 0, for example
`error: advertising channel index must be 37-39 (got 40)`.

A bare `-` is still the stdin/stdout value of `-q`, `-c` and `-r`. See
ubertooth(7), OPTION VALUES, for the forms an option's value can take,
including the optional values of `-a` and `-k`, which may be written as the
next word or attached. `-v` takes no value in either form.

An option combination the tool cannot carry out is refused there too, before
any device is opened, so the message never depends on which boards are
attached: more than one of `-f`, `-n` and `-p` gives
`error: choose one of -f, -n or -p`, and a read and a set of the
access address in one command gives
`error: -a cannot both read and set the access address`.

`-a` or `-s` alongside a sniffing mode gives
`error: -a and -s do not go with -f, -n or -p: a sniffing mode runs until it
is interrupted`, so there is nothing for an access address or faux peripheral mode
request to run after. `-t` and `-k` are not in that list: `-t` is sent before
the mode starts, which is what it is for, and the `-k` options run once it has
started.

`-t` with `-p` gives
`error: -t does not go with -p: promiscuous mode has no device address to
match a target against`, whatever the target is: a connection that is already
running names no device, so `-t none` is refused beside `-p` as well.

`-i` or `-I` without `-f` or `-p` gives
`error: -i needs -f or -p: there is no connection to interfere with
otherwise`, naming the spelling that was used (`-j` and `-J` included).

That includes `-i` on its own: it says more than listing every major mode
would, because only two of them can carry interference.

A command line with no work in it is refused the same way. `-U`, `-A`, `-x`
and the capture options only shape work another option asks for, so a command
made up of those alone, or a bare `ubertooth-btle`, gives
`error: nothing to do: choose a major mode (-f, -n or -p), or -a, -k, -s or -t`,
on standard error with nothing on standard output. A bare `ubertooth-btle` is
the one refusal the usage text follows, also on standard error; every other
refused command line is the `error: ` line alone, and `-h` prints the usage
text on standard output.

A refused command line creates and truncates nothing: `-r`, `-q` and `-c` name
their file while the command line is read, and it is opened only once every
check has passed. The board is opened and its firmware is checked before that,
so a run refused for either reason leaves no empty file behind either.

## DIAGNOSTICS

Standard output carries only what was asked for: either the decoded packets or
the capture data of `-q -` or `-c -`, plus the lines that answer `-a`, `-k` and
`-t` and the parameters `-p` recovers. With the capture on standard output,
standard output belongs to the capture for the whole run: those lines move to
standard error, and the decoded packets are not printed at all.

The `rssi=` figure on each packet's `systime=` line is that packet's own level
in dBm, through a piecewise-linear model of the CC2400 datasheet's RSSI curve:
the mean power of the packet's readings where the record carries that figure,
and the strongest reading the board took around the packet where it does not --
a promiscuous record, or one from a board older than the figure. It is the same
number the signal field of a `-q` or `-r` capture carries for that packet, so a
dump and a capture of one run agree. A `-c` PPI capture carries the board's raw
counts instead, which are not dBm.

The model has ends. Above the top of it the radio reports the same reading for
every level, so there is no figure for how loud such a packet was, and the
column reads `rssi=none` rather than a number the board did not measure. That
is the word the Basic Rate `s=` and `n=` columns of ubertooth-rx(1) already use
for a level the board does not have. An advertiser a few tens of centimeters
away reaches it easily, low-energy receive turning the board's amplifier and
high-gain mode on, so it is a common reading rather than a corner case. At the
bottom, `rssi=-120` means "no louder than this".

A `-q` or `-r` capture records the figure for such a packet regardless, as a
Basic Rate capture does: a record has no way to say that a level was not
measured. So a capture file reads 0 dBm where the screen reads `none`.

Errors, warnings and progress go to standard error, each error as one line
starting `error: `, for example `error: USB poll failed` when the board stops
answering during a capture, `error: jamming not supported by this firmware`,
`error: target set failed`, or
`error: target address must be xx:xx:xx:xx:xx:xx (got 11:22:33:44:55)`. A value
that is not an address reads the same way whatever is wrong with it, and names
the address the option sets, so `-s` gives
`error: faux peripheral address must be xx:xx:xx:xx:xx:xx (got <word>)`, including
for the `none` and `22:44:66:88:aa:cc/24` that `-t` takes, and a bad target
mask gives `error: target mask must be 0-48 (got 49)`. A capture
file that cannot be created is reported as `error: <file>: <reason>`.

A capture that is losing packets says so. This tool reads its packets one at a
time, and a reply that held part of a record cannot be read as one, so it is
dropped and reported once per run: `warning: a poll reply arrived with 32 of a
packet's 64 bytes and was dropped; the capture is losing packets`. The capture
runs on and ends as it otherwise would, so the warning is the only sign.

Packets the board had to throw away are reported too. It holds captured packets
in a queue until this tool reads them, and a queue with no room left loses the
next packet; a packet longer than 50 bytes takes several of the queue's slots
and is lost whole, so a busy capture can lose the long packets while the short
ones still arrive. The first time it happens the capture warns `warning: the
recording board's packet queue filled up and it dropped at least one packet;
this capture has a gap`, and when the capture ends it says how many such gaps
there were: `warning: the capture has 3 gaps where the board's queue filled up
and it dropped packets`. The count is of gaps, not of lost packets: one full
queue can swallow several packets, and the board sends no number. Nothing says
which packets are missing, so a capture with gaps is complete only between
them. The board reports a gap on the first packet that gets through after it,
so a capture that ends in the moment after a gap does not report that last one.

A capture transfer error is reported the same way. The chip's transfer
controller can report an error on the channel a capture receives into: what the
board was receiving at the time had arrived, so it is kept and marked, while
some of its bytes may be wrong and whatever the fault cut short before it is
lost. The first mark warns `warning: the recording board had a transfer error
while capturing; what it was receiving was kept, but some of those bytes may be
wrong and the capture may be missing packets around it`, and when the capture
ends it says how many there were: `warning: the capture has 3 transfer errors
where a packet may be wrong or missing`. ubertooth-util(1) `-w` reports the
board's own count of them since power-on, over every capture the board has run.

Symbols the board wrote over are reported the same way. The board receives
into one block of symbols while its capture loop reads the one before it, and
when a block finishes arriving before the loop has read that one, the new
symbols go over the old ones. The block is gone before anything looked in it
for a packet, so this loss has no packet to point at and nothing in the output
marks where it happened. The first one warns `warning: the recording board fell
behind while capturing and wrote new symbols over a block it had not read yet;
whatever was in the air then is missing from this capture`, and when the
capture ends it says how many such places there were: `warning: the capture has
3 places where the board wrote new symbols over a block it had not read`. The
count is of those places, not of the blocks lost at them: the board has one
flag for this and no field to send a number in, so one place can stand for
several blocks.

Of this tool's capture modes only `-p` can report this loss, because it is the
one that has the board search a stream of symbols. Under `-f` and `-n` the
board receives one whole packet at a time, arming each receive and waiting for
it, so there is no unread block for the next one to go over.

A receiver being driven harder than the radio can measure is the one capture
problem this tool does not report, and it is worth knowing how it looks. It is
the `rssi=none` case above -- the level the model has no number above -- on
packet after packet rather than on one. Beyond that point the radio is also
past where it demodulates reliably, so packets start arriving with bits wrong,
and closer still none arrives at all and the capture simply goes quiet. Put
more distance or more attenuation between the two boards, or turn the transmit
power down with `ubertooth-util -a`.

ubertooth-rx(1) does report it, with the message ubertooth(7) gives, and that
is what to reach for here: this tool's board sends a record for a packet it
demodulated and for nothing else, so a record at the top of the range means a
packet that decoded there, which an ordinary close link produces all day. The
Basic Rate stream sends a record for every block of air instead, so on a bench
where two boards hear each other and nothing decodes, running `ubertooth-rx`
on the same channel is how to tell a deafened receiver from an empty one.

Packets whose data the decoder could not read are summed up in one line when
the run ends: `note: 312 packets held data that could not be decoded; -v
describes each one`, where `-v` is what asks for that description as the run
goes. Data off the air that does not hold what its own length fields describe
is ordinary, not a failure -- both a real packet with a corrupted byte and
noise that decoded as a packet produce one, and busy air gives many of them --
so the run says how many rather than a line per packet, and the
packets are recorded as they arrived. The line goes where the decoded packets
went, because that is what it is about: a run that writes a capture file and
shows no packets decodes nothing and says nothing, which is why a capture
through btle-extcap(1) leaves Wireshark's error output empty.

A poll the board does not answer is tried again, up to three attempts, before
the capture gives up: a board busy elsewhere for a moment no longer ends a
capture that has been running for hours. A board that has left the bus ends it
at once. The retry saves the capture, not the packet: the board takes a packet
out of its queue as it answers the poll, so the one a timed-out poll was
carrying is gone.

Each request that sets a mode up is named on its own, so the line says which
one the board refused: `error: could not set the advertising channel`,
`error: could not set the advertising data`, `error: could not start
advertising` for `-s`, and `error: could not start follow mode` (or
`no-follow`, or `promiscuous`) for the sniffing modes. No capture starts after
one of these.

`-q` and `-c` share one capture handle, so a second file between them is
ignored with `warning: ignoring extra capture file: <name>` and the first one
given is used; `-r` has its own handle, so `-q a.pcap -r b.pcapng` writes both.

A command line the tool will not take is reported as that one `error: ` line
on standard error, with no usage text after it: the line describes the
problem, and `-h` prints the usage text for a reader who wants it. An option
the tool does not know reads `error: unrecognized option '-Z'`; one whose
value is missing reads `error: option '-A' requires a value`.

`-h` is what the user asked for, so the usage text goes to standard output.
Nothing else goes to standard error either, unless the rest of the command
line produced a warning before `-h` ended the command. A bare
`ubertooth-btle`, with no arguments at all, is the one refusal the usage text
does follow, on standard error with the `error: ` line.

## EXIT STATUS

0 when the command did what was asked, including `-h`, and after a capture is
interrupted (Ctrl-C) having polled cleanly to that point.

0 as well for a run stopped by Ctrl-C before it had opened a board: see
ubertooth(7), SELECTING A DEVICE.

1 for a command line the tool will not take or with nothing to do, for a
capture file that cannot be created, when the selected Ubertooth is not found
or cannot be opened, when the board refuses the jam mode, a `-t` target, a
sniffing or faux peripheral mode, or an access address or CRC verify request, and
when a capture stops short because a poll failed. No device is opened for a
refused command line.

A poll the board does not answer is tried again, up to three attempts of one
second each, so one unlucky poll does not end a capture that has been running
for a quarter of an hour. A stop (Ctrl-C, or SIGTERM, SIGHUP or SIGQUIT) drops
the attempts still to come: the attempt already under way finishes, which costs
up to a second, and if it failed, that failure is reported (`error: USB poll
failed`) and the run exits 1, where a capture left to use its remaining
attempts might have recovered and exited 0.

1 as well when the board refuses the request that ends a capture: it is left
in the capture mode, and no other tool can open it until it is reset or
re-plugged. What was captured stays written out, and libubertooth names the
refused request on standard error.

A `-q`, `-c`, `-r` or `-d` file is created once the board has been opened and
its firmware accepted, not before, so a run refused for either reason leaves
no empty capture behind. A file the tool then cannot create is reported with
the name the user gave, and the board is given back.

1 as well for a replay (`-R`) of a file that cannot be opened or cannot be
read whole, after whatever was decoded; see REPLAYING A SAVED CAPTURE.

`-V` reads the attached board, so it exits 1 when a board is attached and
cannot be read, or when the USB bus cannot be listed at all; see ubertooth(7),
COMMON OPTIONS.

## SEE ALSO

ubertooth-util(1): sets the receive squelch (`-z`); SQUELCH describes how
long it lasts

crackle(1): https://github.com/mikeryan/crackle

ubertooth(7): overview of Project Ubertooth; OPTION VALUES describes how
option values are written

## COPYRIGHT

`ubertooth-btle` is Copyright (C) 2012-2018 Mike Ryan. This tool is
released under the GPLv2. Refer to COPYING for further details.
