SqueakyFloors/ubertooth/host/doc/ubertooth-follow.md

# ubertooth-follow(1) -- active (BlueZ) CLK discovery and follow for a target address

## SYNOPSIS

    ubertooth-follow [-t <BD ADDR> | -l <lap> -u <uap>] [-b <hciN>] [-e <0-5>]
    [-w <timeslots>] [-r <file.pcapng>] [-q <file.pcap>|-] [-d <file.bin>|-]
    [-U <index|serial>]
    ubertooth-follow -t <BD ADDR> -a [-b <hciN>] [-e <0-5>] [-w <timeslots>]
    [-r <file.pcapng>] [-q <file.pcap>|-] [-d <file.bin>|-]
    [-U <index|serial>]
    ubertooth-follow [-U <index|serial>] -V
    ubertooth-follow -h

## DESCRIPTION

Follows a classic Bluetooth (BR/EDR) piconet for a given target address.
It uses a local BlueZ Bluetooth device to assist with clock discovery and an
Ubertooth to follow the piconet's frequency hopping.

Name the target one of two ways:

 - `-t` is its whole address, `xx:xx:xx:xx:xx:xx`, in either case of hex
   digit. That is what the tool connects to, and it gives the LAP and UAP the
   board follows, so `-t` needs neither `-l` nor `-u`. Use `-t` for a real
   target: it is the only form `-a` works with, and the only one that connects
   to the target's address rather than a partly guessed one (see AFH below).
 - `-l` and `-u` together are the lower and upper address parts, which is what
   `ubertooth-rx` reports for a piconet it has seen. They are four of the six
   bytes of an address; the two missing ones are the non-significant address
   part (NAP), which ordinary piconet traffic does not carry, and the tool
   fills them in as zero. A page does not carry the paged device's NAP either,
   so that placeholder has nothing to do with whether the page this form makes
   to collect the clock offset succeeds, unless it happens to match the local
   Bluetooth device's own address, which a controller refuses to page (see AFH
   below).

One of `-l` and `-u` without the other names no piconet, so it is refused and
the missing half is named: `error: -l <LAP> requires -u <UAP>`.

`-t` with `-l` or `-u` is refused: the two are the same setting written two
ways, and the tool does not reconcile them. With no target at all, the address
is read from the local Bluetooth device — note this may yield the wrong
address in some cases, so naming the target explicitly is recommended.

A clock read through the adapter can still turn out not to be the piconet's,
and the capture then goes back to searching for one, as ubertooth-rx(1)
describes under THE CLOCK SEARCH. The UAP is not searched for again. However
the target was named, its UAP came from the command line or from the local
Bluetooth device rather than from the air, so a header that fails to decode is
no evidence against it: the UAP is put back and the warning names it.

    warning: the clock being followed was not this piconet's; searching for its clock again, and putting UAP 0d back

If that UAP is in fact wrong, nothing of the piconet will decode, and the line
above says which one the tool is holding you to.

The capture is gated by the board's squelch, which this tool does not set: it
is the default -120 dBm unless `ubertooth-util -z` set another value while the
board was idle, and the firmware resets it whenever the board leaves a mode,
so it never carries over from an earlier capture. See ubertooth-util(1),
SQUELCH.

Requires BlueZ (Linux only). The clock and AFH-map reads this tool is built
around are not reachable from macOS's public Bluetooth APIs, so it is not
built there and no macOS version is planned. `ubertooth-rx -l <LAP>` recovers
the addresses and the clock from the air without an adapter, which takes it
hops of the piconet and some of a capture, and against a link heard rarely may
not get there at all: see ubertooth-rx(1), THE CLOCK SEARCH. Reading the clock through an adapter, as this tool does, takes one page and
one read, with a one-second deadline on the read. See
COMPATIBILITY.md for the comparison.

## OPTIONS

 - `-t <BD_ADDR>` :
   the target's whole address, `xx:xx:xx:xx:xx:xx`, which gives the LAP and
   UAP to follow as well as the address to connect to. Not with `-l` or `-u`,
   and given once.
 - `-l <LAP>` :
   target LAP (3 bytes / 6 hex digits), given once, and with `-u`. Not with
   `-t`.
 - `-u <UAP>` :
   target UAP (1 byte / 2 hex digits), given once, and with `-l`. Not with
   `-t`.
 - `-U <index|serial>` :
   select an Ubertooth by enumeration index or serial number; see
   ubertooth(7), SELECTING A DEVICE
 - `-V` :
   print the version: the host tools, then the firmware version of
   each attached board; see ubertooth(7), COMMON OPTIONS
 - `-r <filename>` :
   capture packets to a PCAPNG file. A PcapNG writer seeks back over what it
   has written, which standard output cannot do, so a value that names that
   stream is refused, `-r -`, `-r /dev/stdout`, and a symbolic link pointing
   there alike:
   `error: PCAPNG capture to stdout is not supported; use -q -`
 - `-q <filename>` :
   capture packets to a PCAP file. `-q -` writes the capture to standard
   output; see CAPTURING TO STANDARD OUTPUT
 - `-d <filename>` :
   dump received symbols to the named file. `-d -` writes them to standard
   output; see CAPTURING TO STANDARD OUTPUT
 - `-e <0-5>` :
   maximum access-code errors to tolerate (default: 2).
 - `-a` :
   enable AFH (adaptive frequency hopping); experimental, and needs `-t`. See
   AFH below.
 - `-b <hciN>` :
   local Bluetooth device to use (default: hci0).
 - `-w <timeslots>` :
   USB delay in 625us timeslots (default: 5). The right value belongs to the
   machine, not to the piconet, and the default is not it on every machine;
   see THE -w DELAY below.
 - `-h` :
   print the usage text on standard output and exit 0. It takes effect once
   the whole command line has parsed, so a bad option value, a stray word or
   an option given twice is still reported.

A record of a `-q` or `-r` capture carries the packet's own power and the
board's estimate of the background on its channel, and the screen shows the two
as `s=` and `n=` with `snr=` the difference. Where the board has admitted no quiet
reading since it last started counting there is no estimate: the capture's
noise-power-valid flag stays clear, Wireshark shows the field as `Invalid Noise
Power`, and the screen prints `n=none snr=none`. A packet whose level is at the
top of the receiver's range is not measured either, and the screen prints
`s=none snr=none` for it. ubertooth-rx(1) describes both figures, what the
estimate rests on, and where the dBm scale ends.

The board has one reading of the channel to work from, so both figures are of
whatever is on it. A transmitter louder than the packet, on the same channel at
the same moment, is what the signal figure describes, and the packet is then
part of the background.

## AFH

`-a` is experimental. It makes the local BlueZ device connect to the target and
asks the local controller for the AFH channel map of *that* link, then follows
the piconet keyed on the target's LAP/UAP. The two are the same hop sequence
only when the target is the Central of the piconet you want to follow, which
`ubertooth-follow` cannot check. Treat a capture made with `-a` accordingly.

`-a` reads the map over a connection to the target, and the tool asks for the
target's own address before it will make one: `-a` without `-t` is refused
before any file is created or device opened, with
`error: -a reads the AFH map over a Bluetooth connection to the target, so it needs the whole target address: give -t xx:xx:xx:xx:xx:xx`.
That is a requirement of the command line rather than of the air interface, as
the next paragraph explains.

A follow keyed on `-l` and `-u` instead connects to `00:00:<UAP>:<LAP>`, with
the two most significant bytes zero, because ordinary piconet traffic does not
carry them. That guess is not what decides whether the page reaches the target:
of the target's address, a page uses only the LAP and the UAP, as the access
code, as the input that selects the page hopping sequence, and as the seed of
the header error check and CRC of the FHS packet the pager sends (Bluetooth
Core, Vol 2, Part B 1.3, 6.4.6, 7.1, and Table 2.3), and the AFH map and clock
offset reads that follow the page are keyed on the connection handle rather
than on an address. So a page that fails here has an ordinary cause: the
target is out of range, it is not accepting connections, or the `-u` given is
wrong. The one way
the guess itself can stop the page is by matching the local Bluetooth device's
own address, which a controller refuses to page. What a real controller makes
of the guessed NAP has not been verified
([#699](https://github.com/SqueakyFloors/ubertooth/issues/699)). When the
page does fail, the command stops, saying what to do about it:

    error: connecting to 00:00:33:44:55:66 failed: Host is down; -l and -u give four of the six bytes of the target address, so 00:00 is a guess: give the whole target address with -t xx:xx:xx:xx:xx:xx

The line offers `-t` because it is the only way to take the guess out of the
picture and is what `-a` needs, not because the guess is why the page failed.
Give the target as `-t` and the connection is made to the address as it is, so
the line is then the reason alone, without the advice. A page that fails
without leaving a reason behind drops the `: <reason>` from whichever of the
two lines it is.

The map is read as soon as the connection is up, which is the earliest the
tool can read it and the latest it can act on it before the follow starts. A
controller that has not yet settled on a hop sequence for a link it has only
just made answers that AFH is off, so that is the common answer against a
freshly paged target, and the follow goes ahead without a map.

The map that comes back is used only when it could be a hop sequence at all:

 - a failed read stops the command (`error: AFH map read failed: ...`), rather
   than following with whatever the map happened to contain. `-a` therefore
   does not work on a controller that does not implement
   HCI_Read_AFH_Channel_Map; run without `-a` on one of those;
 - a reply of AFH off is followed without it:
   `the remote device is not using AFH; following without it`. The board is
   then told to clear its map, as a follow without `-a` does: a board left
   streaming by a follow that was killed is still in the same mode, so it
   takes this run's mode request as a re-sync of the old one and keeps the map
   that run set. An accepted map is applied after the follow has started
   rather than before, because a mode start that does begin afresh forgets a
   map set first (see ubertooth-util(1), CARRY-OVER BETWEEN RUNS);
 - a map with fewer than the 20 channels AFH requires, or none at all, is read
   again — three reads in total, 200ms apart — in case it has not settled. If
   it still reports too few, the command stops and says so;
 - a mode byte that is neither off nor on is refused and printed.

A refused `-a` never reaches the Ubertooth: the map is read before any board is
opened, so the board is left alone and the connection the tool made to the
target is dropped on the way out. The only AFH request a run without an
accepted map makes is the map clear above, from a follow that goes ahead
without one.

## EXAMPLES

Follow a target whose address you know, writing a PCAP:

    ubertooth-follow -t 11:22:33:44:55:66 -q capture.pcap

Follow the same target with an AFH map (see AFH above):

    ubertooth-follow -t 11:22:33:44:55:66 -a

Follow a piconet by the LAP and UAP `ubertooth-rx` reported for it. This
connects to `00:00:33:44:55:66`, whose two most significant bytes are a guess.
If that page fails the command stops and asks for the whole address (see AFH
above). Use `-t` for a real target:

    ubertooth-follow -l 445566 -u 33 -q capture.pcap

## A FOLLOW FROM START TO FINISH

What a run looks like, from not knowing the target to a capture file. It needs
a Linux machine with a working local Bluetooth device, an Ubertooth carrying
`bluetooth_rxtx`, and a piconet that is carrying traffic throughout: a phone
streaming audio to a headset will do. A piconet that goes quiet leaves nothing
to capture.

1. Check the local Bluetooth device is there and up. With none,
   `ubertooth-follow` stops before it opens the board, naming the device it
   looked for. `hciconfig hci0 up` brings one up.

2. Survey for the piconets around you, thirty seconds to start with and longer
   in a crowded room. Each line is a LAP the board heard, with a UAP where it
   has worked one out. That UAP is a guess from the packets the board decoded
   and a short survey can get it wrong, so give the survey time, or take the
   address from the device itself:

       ubertooth-rx -z -t 30

3. Point the follow at the piconet the target leads: `-t` with its whole
   address if you know it, or `-l` and `-u` with the four bytes the survey
   reported. Either way the tool names the target on standard error before it
   opens the board, so a run against the wrong piconet shows before any packet
   does: `-t` prints a `Target` line with the address and the LAP and UAP taken
   from it, and `-l` with `-u` prints the address the page will use, carrying
   `00:00` in place of the two bytes they do not name.

       ubertooth-follow -t 11:22:33:44:55:66 -q capture.pcap
       ubertooth-follow -l 445566 -u 33 -q capture.pcap

4. Watch what the run prints. The tool pages the target through the local
   Bluetooth device, reads the clock of the connection it gets, hands that to
   the board as the clock to hop on, and starts capturing. Unlike
   ubertooth-rx(1), it does not search the air for a clock: it is given one, so
   there is no acquisition to wait for and a follow that is working prints
   packets from the start: the wait before the first record is the wait for a
   packet of the piconet to arrive. A run that prints none has one of five causes: the
   piconet is not transmitting, the board cannot hear the piconet, the `-u`
   given is wrong, the clock the board was given is off by enough to put it on
   the wrong channel, which is what `-w` adjusts for, or the target is not the
   Central of the piconet. The last of those finds nothing at all rather than
   part of the traffic: every packet in a piconet carries the Central's access
   code and hops on the Central's clock, so a follow keyed on a Peripheral's
   address is listening for a piconet that is not there.

   A wrong `-u` silences a run by putting the board on the wrong channels. The
   hop sequence is built from the LAP and the low four bits of the UAP, so a
   `-u` wrong in any of those four bits hops differently from the piconet and
   meets it only now and then. A `-u` wrong only in its top four bits leaves
   the hop sequence alone: such a run prints packets and decodes none of them,
   which is the case DESCRIPTION above describes. A wrong `-u` can also stop
   the page, and then the run exits 1 with the reason.

   The run ends when you interrupt it (Ctrl-C), with exit status 0 and the
   capture written, so give it a length with `timeout` when you script one.
   `timeout` reports 124 for a run it ended; `timeout --preserve-status` gives
   the tool's own status instead.

5. Find the `-w` this machine needs, if the run prints packets and almost none
   of their headers pass, and the `-u` is not the cause (step 4 describes the
   `-u` that looks the same). `-w` pays for the host's own delay between
   reading the clock and the board starting to hop, and the default is not the
   right value on every machine. It is worth doing once per machine and keeping
   the answer; see THE -w DELAY below.

       ubertooth-follow -t 11:22:33:44:55:66 -w <value the sweep found> -q capture.pcap

6. Add `-a` once the capture works without it, if the piconet uses AFH and the
   follow is patchy (see AFH above). It needs `-t`:

       ubertooth-follow -t 11:22:33:44:55:66 -a -q capture.pcap

7. Open `capture.pcap` in Wireshark, which has dissected this format since
   2.2. ubertooth-rx(1) describes the per-packet report the run printed, and
   the project documentation describes the capture format.

## THE -w DELAY

A follow is handed the piconet's clock, so it has nothing to search for. But
between reading that clock through the local Bluetooth device and the board
starting to hop, the host spends time of its own on the USB transfers and the
kernel, and the board's clock has to be moved on by that much to stay with the
piconet. `-w` is how much: a whole number of 625us Bluetooth timeslots, 5 by
default.

The delay is the host's own, so the value that suits one machine is no guide to
another and the default does not suit every machine. Sweep it over a piconet
that is carrying steady traffic, a few values either side of the default, each
leg the same length. Sweep in the form you will capture in, with `-t` or
without: the two take the clock by different routes, so a value found one way
need not hold for the other.

    d=$(mktemp -d)
    for w in 0 1 2 3 4 5 6 7 8; do
      cap="$d/w$w.pcapng"
      timeout 25 ubertooth-follow -t 11:22:33:44:55:66 -e 0 -w $w -r "$cap"
      records=$(tshark -r "$cap" | wc -l)
      bad=$(tshark -r "$cap" -V | grep -c 'Incorrect Packet Header or HEC')
      echo "w=$w $((records - bad / 2)) of $records headers passed"
    done

The count that matters is the headers that passed, not the records written: a
board hopping on a wrong clock still matches the access code now and then and
records every match, so a bad value can write hundreds of records and get
nothing out of any of them. Wireshark marks a bad header `Incorrect Packet
Header or HEC` and `tshark -V` prints that twice per frame, which is the
halving above. Do not count the packet detail the run printed instead: that
needs the payload too, which an enhanced data rate payload never reaches, so
on a link carrying EDR every value would read as zero.

Sweep with `-e 0`, exact access codes only: at the default `-e 2` the extra
records matched with an error allowed are how a bad value comes to look like a
working capture.

Throw away any leg where the piconet went quiet, and any leg that printed the
warning that the clock being followed was not this piconet's (see DESCRIPTION
above): the first reads as a clean zero and the second is no longer a reading
of `-w` at all. Confirm from the devices themselves that each leg had traffic
to capture.

The useful range is narrow: a value a slot or two out can decode nothing at
all, so a machine whose value is not the default captures nothing until the
sweep finds it. The best value repeats from sweep to sweep; how much it
captures does not, and no value of `-w` takes that variation out. So treat
`-w` as deciding whether a follow decodes anything, not how much.

## WHAT A FOLLOW DOES NOT CAPTURE

A capture holds the basic rate packets of one piconet, decoded as far as they
can be without the link's keys. Three things are not in it however well the
follow goes:

 - **Enhanced data rate payloads.** The board's radio demodulates Gaussian
   frequency-shift keying at 1 Mbit/s, which is basic rate. An enhanced data
   rate packet starts at basic rate, so its access code and header are decoded
   and the packet appears in the capture; its payload is sent in a phase-shift
   keying the radio cannot demodulate, and that part is missing.
 - **The contents of an encrypted link.** Encryption covers the payload, and
   the keys are agreed during pairing, which has usually happened long before a
   follow starts. The capture holds the packets, their headers and their
   timing; what the devices said to each other stays unreadable.
 - **Any piconet but the one named.** A follow hops with one piconet's
   sequence, so traffic from everything else around it is off-channel almost
   all of the time. Capture a second piconet with a second board, not with a
   second filter.

Packets lost for other reasons are reported while the run goes; see GAPS IN A
CAPTURE below.

## ARGUMENTS

`ubertooth-follow` takes options only. A word that is not an option, including a
bare `-`, is refused before any device is opened and named:
`error: unexpected argument '<word>'`, with exit status 1.

`-h` and `-V` end the command only once the whole command line has
parsed, so a stray word or a bad option value is reported even
alongside them. Both answer on standard output, so a command line with both
prints both, the usage text last; the order they were written in makes no
difference.

An option the tool does not know is refused the same way, as one line on
standard error with no usage text after it: `error: unrecognized option '-Z'`.
An option whose value is missing reads `error: option '-l' requires a value`.

An option value must be a whole value in its range, or it is refused the same
way instead of being read as 0, for example
`error: LAP must be 6 hex digits (got 4466)` and
`error: target address must be xx:xx:xx:xx:xx:xx (got 11:22:33:44:55)`.

Three more kinds of command line are refused before any device is opened, each
with its one line:

 - any option given a value twice, `error: option '-t' given more than once`:
   the tool does not pick between two answers to the same question. This is
   the rule for every tool; see ubertooth(7), OPTION VALUES;
 - `-t` with `-l` or `-u`,
   `error: -t gives the whole target address, so it cannot be combined with -l or -u`;
 - one of `-l` and `-u` without the other,
   `error: -l <LAP> requires -u <UAP>` or
   `error: -u <UAP> requires -l <LAP>`: the two name a piconet only together.
   `-a` beside half a pair still reports `-a` needing `-t`, since completing
   the pair would not let `-a` run.

`-` means standard output as the whole value of `-q` or `-d`, and so does a
path that names this process's descriptor 1, such as `/dev/stdout` or
`/dev/fd/1`, and a symbolic link pointing at one of those (ubertooth(7),
OPTION VALUES). Any other value is a file name,
including one that starts with `-`: `-q -x` writes the file `-x`. Standard
output carries one stream, so `-q` and `-d` cannot both have it in one
command: `error: -q and -d cannot both write to standard output`. `-r` is not
part of that pair, since it never has the stream: every value naming standard
output is refused when `-r` is read, not only a lone `-`.

A file name cannot be shared either. Each of `-r`, `-q` and `-d` opens its own
destination for writing, which truncates whatever another has put there, so no
two of them may name one file: `error: -q and -d cannot both write to
capture.pcap`, exit 1, with the file left as it was. The file is identified
rather than the name, so two spellings of one path, a symbolic link, a hard
link, a `/dev/fd/N` beside the file that descriptor holds, and `-q -` beside a
`-d` naming the file the shell has pointed standard output at are all caught.
Two destinations that both reach that stream, however each was spelled, get
the one-capture-on-standard-output refusal above instead. `-` is the
stream and `./-` is an ordinary file of that name, so `-q - -d ./-` is two
destinations unless the shell really has pointed standard output at that file.

Writing both captures to `/dev/null` is not refused, since nothing is kept
there and nothing is lost. Some pairs that are one file cannot be told apart
from the names alone and are not refused either; see ubertooth(7), OPTION
VALUES.

What the tool is following — the target address, or the LAP and UAP it read
from the local device — is reported on standard error, with the rest of the
tool's progress. Standard output carries the decoded packets, and, with `-a`,
the accepted channel map — unless a capture has taken that stream, and then
the map is on standard error with the progress; see CAPTURING TO STANDARD
OUTPUT.

A refused command line creates and truncates nothing: `-r`, `-q` and `-d` name
their file while the command line is read, and it is opened only once every
check has passed. The board is opened and its firmware is checked before that,
so a run refused for either reason leaves no empty file behind either. A file
that cannot be created is one `error: ` line naming it, for example `error:
/no/such/dir/dump.bin: No such file or directory`, and exit 1.

## CAPTURING TO STANDARD OUTPUT

`-q -` writes the PCAP capture to standard output and `-d -` the raw symbols,
for a pipe into another program. Either way the capture owns standard output
for the whole run, so the per-packet report is not printed; the packets
themselves are in the capture.

What the tool is following, the notes and the failures are on standard error
and still arrive, and so is the `AFH map:` line of `-a`, which is the answer to
that option.

Redirect standard output to a new file or a pipe, not to one being appended
to: the capture is opened again through a descriptor-filesystem path,
`/dev/fd` where there is one and `/proc/self/fd` otherwise, which truncates,
so `ubertooth-follow -q - >> capture.pcap` loses what the file held.

Binary on a terminal is a mistake rather than a stream anyone reads, so it is
refused: `error: stdout is a tty, refusing to write binary capture data to
it`, exit 1. Redirect or pipe standard output instead.

## GAPS IN A CAPTURE

A capture that is losing packets says so. The board holds captured packets in a
queue until this tool reads them, and a queue with no room left loses the next
packet. The first time it happens the capture warns `warning: the recording
board's packet queue filled up and it dropped at least one packet; this capture
has a gap`, and when the capture ends it says how many such gaps there were:
`warning: the capture has 3 gaps where the board's queue filled up and it
dropped packets`. The count is of gaps, not of lost packets: one full queue can
swallow several packets, and the board sends no number. Nothing says which
packets are missing, so a capture with gaps is complete only between them. The
board reports a gap on the first packet that gets through after it, so a
capture that ends in the moment after a gap does not report that last one.

A capture transfer error is reported the same way. The chip's transfer
controller can report an error on the channel a capture receives into: what the
board was receiving at the time had arrived, so it is kept and marked, while
some of its bytes may be wrong and whatever the fault cut short before it is
lost. The first mark warns `warning: the recording board had a transfer error
while capturing; what it was receiving was kept, but some of those bytes may be
wrong and the capture may be missing packets around it`, and when the capture
ends it says how many there were: `warning: the capture has 3 transfer errors
where a packet may be wrong or missing`. ubertooth-util(1) `-w` reports the
board's own count of them since power-on, over every capture the board has run.

Symbols the board wrote over are reported the same way. The board receives
into one block of symbols while its capture loop reads the one before it, and
when a block finishes arriving before the loop has read that one, the new
symbols go over the old ones. The block is gone before anything looked in it
for a packet, so this loss has no packet to point at and nothing in the output
marks where it happened. The first one warns `warning: the recording board fell
behind while capturing and wrote new symbols over a block it had not read yet;
whatever was in the air then is missing from this capture`, and when the
capture ends it says how many such places there were: `warning: the capture has
3 places where the board wrote new symbols over a block it had not read`. The
count is of those places, not of the blocks lost at them: the board has one
flag for this and no field to send a number in, so one place can stand for
several blocks.

A receiver being driven harder than it can measure is reported once per run:
`warning: the signal is at the top of the receiver's range, so the board
cannot measure it and may not demodulate it; the boards may be too close
together, or the transmit power too high`. The radio reports the power of each
block of air on a scale that runs out, and a receiver held at the top of it is
also past where it demodulates reliably -- so this is the case where nothing
decodes and the board is not at fault. Put more distance or more attenuation
between the boards, or turn the transmit power down. See ubertooth(7).

When the capture ends it says how many such stretches there were:
`warning: the capture has 3 stretches where the signal was at the top of the
receiver's range`, one per block of records judged to be there. The running
warning is said once, so the total is what tells one bad stretch from a
capture that was deaf throughout.

## EXIT STATUS

A follow that was interrupted (Ctrl-C) exits 0 with whatever it captured, and
so does `-h`. A refused command line exits 1 (see ARGUMENTS), as does a file
that cannot be opened and a target the tool could not set up a follow on.

A run stopped by Ctrl-C before it had opened a board exits 0 as well: see
ubertooth(7), SELECTING A DEVICE. That covers everything from the board being
found onwards. The adapter setup before it, and the page in particular, is the
part of a follow that a signal ends the way it would end any other program: the
page waits up to 25 seconds, BlueZ takes its own calls again when a signal cuts
them short, and no handler of this tool's is installed yet, so Ctrl-C there
ends the tool at once rather than cleanly.

A page to the target that fails exits 1 as well, before any board is opened:
the page is what yields the target's clock offset, and a follow of a named
target without it would hop on the local device's clock instead. A follow keyed
on `-l` and `-u` pages a guessed `00:00:<UAP>:<LAP>`, so that line also asks
for the whole address with `-t` (see AFH above).

A board that refuses the target's address, the clock reset, the Basic Rate
modulation, or the AFH map the follow sets or clears exits 1 before the
capture runs, with the request named on standard error. The two map requests
read `error: setting the board's AFH map failed` and `error: clearing the
board's AFH map failed`. Following anyway
would mean a board that is not set up for the piconet: without the target's
address it matches no packet, and with its clock never zeroed it hops on a
clock the offset was not measured from.

Standard output stays empty in that case, and standard error names the request,
why the board refused it and the libusb code, adding a note where there is
something to try:

    error: could not zero the board's clock: the board did not answer in time (libusb -7)
    note: if a mode is running, stop it with ubertooth-util -S; a board that does not answer at all usually resets itself within a few seconds, so run the command again, then reset it with ubertooth-util -r on the same board if it stays silent, and unplug it or power-cycle its hub port if that does not reach it either

That pair is the report, the same one ubertooth-rx(1) and ubertooth-scan(1)
give: the request named as `set the Bluetooth address` for the address, and as
`zero the board's clock` for the clock reset. A request the board's firmware
has not got is stalled, which reads `error: could not zero the board's clock:
the board's firmware does not support it (stalled, libusb -9)`, with notes
naming the board's firmware API version and the one these tools need, and the
reset that recovers a board which stalls every request (see ubertooth(7),
FIRMWARE OF ANOTHER API VERSION). A board that took only part of
either write gives the counts instead, as `error: Bluetooth address write
failed: board took 8 of 16 bytes` or `error: clock write failed: board took 2
of 4 bytes`, and the follow stops on that one line.

A follow whose USB stream fails part-way also exits 1: the board stopped
answering, or dropped off the bus, so the capture stops there and holds only
what arrived before it. The failure is reported on standard error as it
happens, as `error: receive transfer failed: <reason>`. A board that never
hands the transfer back at all exits 1 too, reported by the `warning:` line
ubertooth(7) describes rather than that error.

A follow the board would not stop exits 1 as well: the request that takes the
board out of its capture mode was stalled, so the board is left in that mode
and no other tool can open it until it is reset or re-plugged. What was
captured stays written out, and libubertooth names the refused request on
standard error.

The `-q`, `-r`, and `-d` files are created once the board has been opened and
its firmware accepted, and a run refused after that removes them again, so a
refused follow leaves no empty capture behind whatever refused it. For this
tool they are created later than it sounds: the adapter, the connection to the
target, and the AFH read all come first, so a path that cannot be opened is
reported after them. Every fault in the command line, a terminal on standard
output included, is refused before any of it.

A regular file named by `-q` or `-d` is removed, whether this run created it
or truncated one that was already there, so removing it does not bring the old
contents back. Anything else is left where it is, along with whatever the run
wrote through it: a device, a pipe, a symbolic link, a path naming one of this
process's descriptors, and the file standard output was redirected to. A removal that will not go is
reported as `warning: cannot remove <path>: <reason>` and does not change the
exit status. `-r` refuses a path that exists rather than writing over it, so
it never reaches this.

A run that cannot allocate the piconet it follows exits 1 with `error: out of
memory`, before the adapter or a board is opened; `-h` and `-V` are answered
first and so still work on a machine with no memory for one.

A capture that could not be started at all exits 1 as well, whichever step
failed: the receive transfer libusb would not take, the host thread that
collects the capture, or the request that starts hopping. Standard error
carries the one `error: ` line for that step, for example `error: could not
start the thread that collects the capture: Resource temporarily unavailable`.
The status is 1 in every case, never the failing call's own return value: a
negative libusb code handed to the exit status is wrapped into a byte, so
`libusb -9` reached a script as 247.

An adapter `-b` names that does not exist, or that cannot be opened, exits 1
with one `error: ` line naming it, the same wording ubertooth-scan(1) uses:
`error: Bluetooth device hci7 not found: No such device`.

`-V` reads the attached board, so it exits 1 when a board is attached and
cannot be read, or when the USB bus cannot be listed at all; see ubertooth(7),
COMMON OPTIONS.

## SEE ALSO

ubertooth-util(1): sets the receive squelch (`-z`); SQUELCH describes how
long it lasts, and CARRY-OVER BETWEEN RUNS what else a board keeps from one
command to the next

ubertooth-rx(1): recovers the addresses and the clock from the air, with no
adapter; THE CLOCK SEARCH describes what that costs

ubertooth-scan(1): the other BlueZ tool, which finds the piconets an adapter
cannot see

ubertooth-afh(1): recovers the channel map of a piconet whose LAP and UAP are
known, with no adapter

ubertooth(7): overview of Project Ubertooth; OPTION VALUES describes how
option values are written

## COPYRIGHT

Released under the GPLv2. Refer to [COPYING](https://github.com/SqueakyFloors/ubertooth/blob/main/COPYING) for further details.
