SqueakyFloors/ubertooth/host/doc/ubertooth.md

# ubertooth(7) -- Project Ubertooth

## OVERVIEW

Ubertooth is a platform for Bluetooth experimentation. It is able to
sniff BLE, discover undiscoverable classic Bluetooth devices, and perform
rudimentary sniffing of classic Bluetooth devices.

Ubertooth is **not** a Bluetooth dongle and it will not show up as one
when running `hciconfig`.

## COMMAND LINE TOOLS

The following command line tools included in this package are the
primary means of using Ubertooth. Refer to their manual pages for
example usage and comprehensive documentation.

Useful commands:

 - ubertooth-btle(1) : BLE sniffing and other fun
 - ubertooth-rx(1) : Classic Bluetooth device discovery and rudimentary sniffing
 - ubertooth-scan(1) : Active (BlueZ) scanning of undiscoverable devices; Linux only
 - ubertooth-afh(1) : Detecting the AFH map of a Classic Bluetooth piconet
 - ubertooth-ego(1) : Yuneec E-Go electric skateboard sniffing
 - ubertooth-follow(1) : Active (BlueZ) clock discovery and piconet following;
   Linux only
 - ubertooth-btbr(1) : Experimental Classic Bluetooth connections and
   monitoring; needs the separate `btbr` firmware image

Utility commands:

 - ubertooth-dfu(1) : Firmware update tool
 - ubertooth-dump(1) : Dumping raw RF symbols to disk, Bluetooth or generic
   (experimental)
 - ubertooth-tx(1) : Transmitting a generic packet (experimental), and
   retransmitting symbols dumped with ubertooth-dump
 - ubertooth-ducky(1) : Driving an Uberducky as a BLE USB Rubber Ducky
 - ubertooth-util(1) : "Everything else"

Less useful commands:

 - ubertooth-debug(1) : Reading registers on the CC2400, and writing them
   (experimental)
 - ubertooth-specan(1) : Raw RSSI values used by graphical specan
 - ubertooth-specan-ui(1) : The spectrum analyzer window that plots them

Run by another program rather than by hand:

 - btle-extcap.py(1) : Wireshark's own capture interface, which puts an
   Ubertooth in Wireshark's capture list and captures BLE into the window
   with no file in between. Wireshark starts it; its page says where to
   install it

## COMMON OPTIONS

`-h` and `-V` mean the same thing in every tool, including the three written
in Python -- ubertooth-btbr(1), `btle-extcap.py` and ubertooth-specan-ui(1) --
which take their command lines from getopt in Python, from Wireshark's extcap
protocol and from `argparse`. Those three answer `-V` by running
ubertooth-util(1) `-V` and passing its answer on, so the lines below are the
same words whichever tool was asked; `ubertooth-util` has to be on their
`PATH`, as it is when the tools are installed together, and one that is not
there is reported as `error: could not run ubertooth-util: No such file or
directory`. `btle-extcap.py` has no `-U`, so its `-V` reports every attached
board. ubertooth-specan-ui(1) answers `-V` and `-h` without the `numpy` and
Qt binding its window needs, and ubertooth-btbr(1) answers them without the
Python `libusb1` package a session of its own needs. `-v` is not in every tool; the last paragraph here says what it means
where it is.

`-h` prints that tool's usage text on standard output and exits 0.

`-V` prints the version on standard output, and is the way to ask what is
installed and what a board is running. It exits 0, except for the two
failures below: a board that is attached and cannot be read, and a USB bus
that cannot be listed at all. Every tool answers it in the same words, one
labelled line each, so a script can take the line it wants whichever tool it
ran:

    Host tools version: <release> (libbtbb <release>)
    Firmware version: <image> <release> (API:<version>)
    Firmware build: <the date the image was built>

The first line is the host's and needs no board: the release these tools were
built from, with libbtbb's beside it. A release name, not a commit, so it is
the line to quote when reporting a problem; a build after a release carries
how many commits it is past that release, as in `2026-11-R1+22`, and a `*`
where the tree it was built from had uncommitted changes. Where this run
loaded a libbtbb from somewhere other than the one these tools were built
against -- a distribution or Homebrew build beside this fork's, which decodes
packets its own way -- a `warning:` line on standard error says so.

The two firmware lines describe the board `-U` names, or the only board
attached. With several boards attached and no `-U`, both lines are printed for
each of them with its index in the label, as the identity queries of
ubertooth-util(1) are: `Firmware version (0): ...`, `Firmware build (0): ...`.

With no Ubertooth attached the host line is followed by `Firmware version:
no Ubertooth attached` and the status is still 0: the host half of the answer
needs no board, and nothing attached is an answer rather than a failure. A
board sitting in the DFU bootloader is named in a `note:` on standard error
there, with a second line saying what reaches it where it is the only one
waiting, because no tool but ubertooth-dfu(1) can open one and that is the
usual reason a board is not in the answer. A
board that is attached but cannot be read -- in use by another program, or not
answering -- has the reason on its own line (`Firmware version: unavailable,
in use by another program`, or `Firmware version: read failed`) and the status
is 1. So does a USB bus that cannot be listed at all, which is nothing known
rather than nothing attached: `Firmware version: unavailable, the USB bus
could not be listed`.

Part of an answer can go missing on its own, and the status is 1 then too: a
board that answered its version but not its build string prints `Firmware
build: read failed` under a good version line, or `Firmware build: not
reported` if the read worked and the board had no build string to give, and
one whose API version could not be read prints the version with no
` (API:...)` after it.
So a script that cares about the whole answer should test the status, not
only look for a reason in place of a version.

Asking for the version does not disturb a board: it is not told to stop, so a
mode running on it keeps running, and any firmware is read whatever API
version it reports, which is what makes `-V` the way to identify an unknown
board.

`-v` means verbose, where a tool has verbose output: ubertooth-specan(1) `-v`,
ubertooth-debug(1) `-v <0-2>`, and ubertooth-btle(1) `-v`, which describes each
packet whose data the decoder could not read. One tool spells something else
`-v`, an older spelling kept so that existing scripts keep working:
ubertooth-util(1) `-v` prints the `Firmware version:` line on its own
(deprecated, and unchanged: use `-V`). ubertooth-btle(1) `-v` named that tool's
CRC verify setting until `-k` took it over, so a value written after it is
refused with a line naming `-k`.

## OPTION VALUES

These pages write an option's value as a separate word: `ubertooth-util -c
2440`, `ubertooth-btle -a 8e89bed6`, `ubertooth-rx -l 446688 -u 22`. This
follows a standard, the POSIX Utility Syntax Guidelines (guideline 6: an option
and its value are separate arguments). The value placeholders are written the
same way (`-c <2402-2480>`). The older attached form is still accepted for
backward compatibility with existing scripts, so `-c 2440` and `-c2440` are the
same. Where the value is optional, the next word
is taken as the value only when it is a valid value, so an option never
swallows the option after it: `-c -b` reads the channel and then the board ID,
while `-z -90` sets the squelch to -90 dBm. The `ubertooth-*` tools written in
C take single-letter options only, apart from ubertooth-dfu(1), whose
`--update-bootloader` and `--force` are words because of what they do; a long
option no tool knows is refused with `error:
unrecognized option '--bogus': the tools take single-letter options`, and so
does ubertooth-btbr(1). The long options that take a value belong to two
tools -- `btle-extcap.py`, whose are Wireshark's, and ubertooth-specan-ui(1)
`--wifi` and `--padding` -- and are written `--name value` or `--name=value`,
never attached without the `=`. ubertooth-dfu(1)'s two take no value and have
to be written out in full. A lone `-` as the value of
a file option means standard output, so `ubertooth-btle -q -` writes the
capture to stdout. A capture destination that names the same descriptor by
path -- `/dev/stdout` or `/dev/fd/1`, and `/proc/self/fd/1` on Linux, with any
redundant `/` or `.` between
the names in it -- is that stream too, so the capture owns it and the tool's
own report lines stay out of it, and so is a symbolic link whose chain ends at
one of those names, because a writer writes through a link. Any other spelling
the system itself answers with descriptor 1 counts as well: the BSDs read a
leading zero as part of the number, so `/dev/fd/01` is that stream there and
names nothing at all on Linux. `/dev/fd/N` for
any other `N` is not that stream: it reaches whatever the calling shell opened
on that descriptor, so the capture goes there and the report stays on standard
output. `/dev/stdin` and `/dev/stderr` are the same -- not standard output, but
still identified as the descriptor they name, so the check below sees one of
them beside the file that descriptor is on. A descriptor the shell has pointed
at standard output itself (`-d /dev/fd/3 3>&1`) is one place a capture and the
tool's own report do still share the stream, and the report interleaves into
the capture: write `-` or `/dev/stdout` to hand the capture that stream.
No option reads its input from a lone `-`: for those it is
a file name like any other, and there is no such file. Any other value is a
file name too, including one that starts with `-`, so a forgotten file name
writes a file rather than guessing. A destination whose writer seeks back over
what it has written cannot be `-` at all, which a pipe does not allow: the
PcapNG captures (`-r`) and `ubertooth-dfu -u` refuse that value and say what
to use instead. The PcapNG option refuses every destination that reaches
standard output, a link to it included, while the command line is read, rather
than leaving the writer to report the stream's own device entry as a name that
already exists. Another unseekable destination -- a named pipe, or a
descriptor the shell opened on one -- is still the writer's to turn down. Standard output carries one stream, so two capture options cannot
both have it, and the tool whose capture has it prints none of its own packet
report there. A file cannot be shared between two capture options either:
each writer opens its own destination for writing, which truncates whatever
another has put there, so a run whose destinations are one file is refused
before any of them is opened, naming both options. The file is identified
rather than the name, so a second spelling of one path, a link, a hard link, a
`-` beside a file name the shell has pointed standard output at, and a
`/dev/fd/N` beside the file that descriptor holds are all caught, while
`/dev/null` twice is not, since nothing is kept there. Some pairs that
are one file cannot be told apart from the names alone and are not refused:
a symbolic link whose target is not there yet and more than sixteen links
away, two names whose directory does not exist yet, and two names a
case-folding filesystem would make one file while neither is there yet. Each
is caught once the file exists. ubertooth-rx(1), ubertooth-btle(1), and
ubertooth-follow(1) all make this check.

Options can be written together behind one dash (`-f -n` is `-fn`), so a stray
dash inside such a word is a letter the tools do not have. The refusal names
the word it was written in rather than the dash on its own:
`ubertooth-util -v-` and `ubertooth-util -r-x` both read
`error: unrecognized option '-' in '<word>'`. The trailing form used to be
blamed on `--`, or on the option after it (`ubertooth-util -v- -h` named
`-h`), neither of which the user had written. Where several words hold a dash,
the one named is the word the parse stopped in, which is the first word the
tools would not take: `ubertooth-util -v- -Ufoo-` names `-v-`, because the
dash in `-Ufoo-` is part of `-U`'s value and nothing in that word is wrong.

An option may be given a value only once. `-l 446688 -l aabbcc` names two
LAPs for one capture, so it is refused with `error: option '-l' given more
than once` before any board is opened, rather than one of them being kept and
the other dropped without a word. Only a value counts: repeating an option
that takes none says the same thing twice, and an option whose value is
optional has two jobs, so `ubertooth-util -c 2426 -c` sets the channel and
then reads it back. A tool may still refuse a repeat of its own where the
second one is more likely a typo than a request, and says so on its page:
`ubertooth-specan -v` is the one that does.

The rule covers every `ubertooth-*` tool. `btle-extcap.py` and
`ubertooth-specan-ui` take their command lines from Wireshark's extcap
protocol and from `argparse`, and still keep the last value.

For the same reason, two options that cannot both run are refused with one
`error: ` line: two major modes, two modulations for one capture, two output
formats for one sweep, or the same setting written two ways
(`ubertooth-util -c 2440 -C 24`). Each page lists its own.

## SELECTING A DEVICE

With a single Ubertooth attached, the tools find it automatically. With more
than one attached, every tool takes `-U <index|serial>` to choose one: an
index is a position in the list of attached Ubertooths (`-U 0` is the first),
and a serial-number string selects that board whatever the enumeration order.
An index that is not attached is refused (`error: no Ubertooth at index 2 (2
attached)`) and the tool exits non-zero. Indexes are positions in the list of
boards attached when the command runs, so they shift when a board is added or
removed; to keep targeting the same board, select it by serial.

With several attached and no `-U`, no board is selected: the tools refuse the
command and then list the boards, so the next command can name one. Reading
those serials opens each board briefly, and none is kept open.

    error: multiple Ubertooth devices found; select one with -U <index|serial>
      Device 0: aa1100112233445566778899aabbccdd
      Device 1: 19bb00112233445566778899aabbccdd

With none attached, every tool says `error: no Ubertooth devices found`.

Selecting by serial number is the slower form, because every attached board is
opened and asked for its serial, and a board that does not answer costs a
second. A Ctrl-C during that search ends the run: the search gives up where it
is, no board is selected, and the tool exits 0 without a message of its own,
because the user stopped a run that had not yet asked anything of a board. A
Ctrl-C between the board being opened and the first request made of it ends the
run the same way. A search that did finish and matched nothing still says so
and exits 1, whether or not a signal arrived while it ran: the answer is true
either way, and a script reading the status to learn whether its board is there
must not be told that it is.

SIGTERM, SIGHUP, SIGQUIT and an alarm (SIGALRM, as `timeout` and `kill` send
them) end a run the same way Ctrl-C does, which means exit 0 rather than death
by the signal. SIGHUP is caught even when it was inherited ignored, so a
capture run under `nohup` stops when the terminal closes instead of carrying on
with its mode left running on the board.

A serial may be shortened to its first few characters, in either case, so
`-U aa11` and `-U AA11` select the same board. If those characters start more
than one attached board's serial, the tool lists the matching serials and
selects neither. An all-digits string is read as an index, so include a
non-digit (`-U 19b` rather than `-U 19`). See ubertooth-util(1), SELECTING A
DEVICE, for the full description and for listing the attached devices.

## WHEN A BOARD CANNOT BE USED

A board can be attached and still be unavailable, because only one program at
a time can use it and because a mode keeps running on the board until it is
stopped. Both cases are reported in words, with the libusb code in parentheses
for a bug report.

The board opened, and then something else turned out to be holding it:

    error: Ubertooth 19bb00112233445566778899aabbccdd is in use by another program (libusb -3)

That is another tool from this package, a graphical specan, or anything else
holding its USB interface; on Linux it may be a kernel driver. Stop that
program and run the command again. Which libusb code says so depends on the
system, which is why the message does not depend on it. Nothing is sent to the
board on this path, so the command does not disturb whatever is using it.

With one board attached and no `-U`, there is no name to use, and a `-U
<index>` run has only the index:

    error: the Ubertooth is in use by another program (libusb -6)
    error: Ubertooth at index 1 is in use by another program (libusb -3)

The board took the request and sent nothing back:

    error: the Ubertooth did not answer in time (libusb -7)

A board that has stopped answering control requests does this: it happens
after some captures end, and a board left in a mode that keeps polling can do
it too. Try `ubertooth-util [-U <selector>] -S` to stop a mode and
`ubertooth-util -r` to reset the board; a board that answers neither usually
resets itself, as the next paragraphs describe. The line says
only what happened, because what it means depends on what the command was
doing: mid-flash, for instance, it is a bootloader that lost its place, and no
mode is involved.

A board still answering, left in a mode by a run that was killed, needs no
`-S` before most captures. `ubertooth-rx`, `ubertooth-dump`, `ubertooth-scan`,
`ubertooth-follow`, `ubertooth-afh` and `ubertooth-specan` read which mode the
board is in as they start, stop a mode they find and wait for the board to
report itself idle before they read. They say so, because the capture they
stopped was somebody's:

    warning: the board is still in mode 9 from an earlier run; stopping it first (ubertooth-util -w names the modes)

Without that wait, the stopped mode could hand the board's receive endpoint
one more packet before the new capture's own mode had started, and the capture
would open with a packet or two of the earlier run's. A board that does not
reach idle within about a second is a second warning, and the capture goes
ahead.

`ubertooth-btle` and `ubertooth-ego` read their packets a different way — one
request per packet rather than the stream endpoint — so neither does this, and
a board left in a mode is still theirs to meet: stop it with
`ubertooth-util -S` first.

A board running this tree's firmware usually recovers itself: it resets about
three seconds after it stops servicing USB, drops off the bus and comes back
idle, so the fix is to run the command again. `ubertooth-util [-U <selector>]
-w` then says how often that has happened and which mode and which wait the
board was in the last time.

Not every board gets that self-reset, and where it does not the fallback is
always the same: unplug the board or power-cycle its hub port. That is what the
`note: ` line the tools print after the error names (see ubertooth-rx(1),
EXIT STATUS). Firmware without the watchdog, such as `2020-12-R1`, has
no self-reset at all. Neither has anything that feeds the watchdog from its
loop rather than from a USB service pass — the six modes that service USB from
the interrupt, and the `btbr` image — because that loop keeps turning when the
USB path alone has died (see ubertooth-util(1), WATCHDOG). The bootloader runs
with the watchdog off by design, so a `-7` mid-flash, where no mode is
involved, waits for nothing either; ubertooth-dfu(1) reports that one in its
own words, and its page says the same about a board that answers nothing.

A serial-number selector names the reason, because a board it could not read
may be the board asked for:

    error: no Ubertooth found with serial matching 'aa1'
    1 attached Ubertooth device did not answer the serial read
    note: a board that does not answer may be in use by another program, or busy in a mode; stop a mode with ubertooth-util -U <index> -S, or reset a board that answers nothing with -r

The remedy is by index there because a board whose serial could not be read
cannot be selected by serial. `-r` on a board that answers nothing resets its
USB connection before it asks the board to reset itself, because the board
would refuse that request as it refuses every other one; the connection reset
is what recovers it, and the board is then reset like any other. See
ubertooth-util(1).

A board in the DFU bootloader is named too, because it is not a board that
went away: while it is being flashed it enumerates as the bootloader, which no
tool but ubertooth-dfu(1) can open, so every selection finds nothing until the
flash finishes. An interrupted flash leaves it there until the next one
succeeds. Neither form of `-U` can name such a board -- the bootloader reports
no serial number, and an index counts only the boards running their firmware
-- so the second line says what reaches it instead.

    error: no Ubertooth found with serial matching 'aa1'
    note: a board is in the DFU bootloader, so no tool but ubertooth-dfu can open it: it is being flashed, or a flash left it there
    note: ubertooth-dfu with no -U is what reaches that board: -d <image> -r writes an image and asks the board to start it, and -r alone asks without writing

`-r` on its own is the shorter way out, and enough for a board that was asked
into DFU by a command and still holds its application. Both forms say what
they ask for rather than what the board will do, because neither can be
promised: the bootloader starts an application only when the region passes its
check, so a board left half-written by an interrupted download stays there
until a whole image is written, and a board whose bootloader entry pin reads
grounded is asked into DFU again by every reset, with or without a fresh
image, until the bridge is removed. A write needs `-r` as well, or the board
stays in the bootloader.

Several boards in the bootloader are counted instead, with no such advice:
ubertooth-dfu(1) with no `-U` refuses to choose between them, and this note
cannot say which of them was meant.

A board that cannot be *opened* at all is a different problem, usually file
permissions: on Linux, install the udev rules shipped with this package (see
ubertooth-util(1), SELECTING A DEVICE).

## FIRMWARE OF ANOTHER API VERSION

These tools drive the firmware built from the same source tree, which both
run-time images report as their USB device version. A release build refuses
anything else, naming both versions and which side to replace:

    error: Ubertooth firmware API version <version> found, libubertooth 1.1 requires <version>.
    note: flash the firmware built from the same source tree, for example: ./install.sh --flash-device aa11

A build made from a git checkout that is not on a tag is a development build,
and says the same thing as a warning and carries on, because host tools and
firmware from different commits are the normal state of lab work and
debugging:

    warning: Ubertooth firmware API version <version> found, libubertooth 1.1 requires <version>.
    note: flash the firmware built from the same source tree, for example: ./install.sh --flash-device aa11
    note: this is a development build, so the command runs on; what it reports may be wrong, and a request this firmware has not got will fail

Both notes are worth reading before the output is trusted. What the two
versions disagree about may be the layout of a record, in which case the
capture is decoded by the wrong rules and is wrong rather than empty. Where
the firmware is simply missing a request, the command fails on it:

    error: could not set the channel: the board's firmware does not support it (stalled, libusb -9)
    note: the board reports firmware API version <version>, libubertooth 1.1 requires <version>
    note: a board that stalls every request is wedged rather than short of this one; reset it with ubertooth-util -r on the same board

That is the one wording for a request the board refuses, wherever the request
came from. The board answers such a request by stalling it and says nothing
else, so the line names the request that was refused, and the first note puts
the two versions beside each other: different versions name the reflash that
fixes it, and equal versions say the version is not the problem. The libusb
code is there for a request sent and answered one at a time; a request sent
without waiting for its answer has only the stall to report, so that line ends
`(stalled)`. A board in the DFU bootloader runs no application firmware, so
ubertooth-dfu(1) reports a refused request without either note.

The second note is for the other reason a request stalls, which the first
cannot be told apart from: a wedged board stalls everything sent to it,
whatever its firmware implements, so a report naming the firmware would send
the user to reflash a board that is not short of the request at all. The
question that separates the two is whether any request gets through, and
`ubertooth-util -r` is the recovery for the wedge: it resets the board's USB
connection and then the board, with no one at the bench.

A board that has left the USB bus stalls a request too, on some hosts, and its
firmware is not the reason: the board whose version the note would quote is
not there any more. Before the firmware is blamed the bus is listed, and a
board that has gone from it gets one line of its own, with no note:

    error: could not stop the running mode: the board is no longer attached

Nothing is asked of the board to find that out, so a board that is merely
silent is left alone. A bus that cannot be listed says nothing either way, and
the request is reported as the stall it arrived as. So is one sent to a board
whose version was never recorded, which is ubertooth-dfu(1) talking to the
bootloader: there is no handle there to ask the bus about. Every board these
tools open through libubertooth is recorded as it is opened, so every board a
mode runs on is covered.

Which answer a build gives can be set either way with
`UBERTOOTH_ALLOW_API_MISMATCH` (see ENVIRONMENT below).

The version is only half of it: this tree builds two run-time images, and they
report the same version. So the tools that check the version check the image
as well, as the board is opened, and one carrying the other image is refused
by name with the line that flashes it:

    error: the Ubertooth is running btbr; this tool needs bluetooth_rxtx
    note: flash it with ubertooth-dfu -U aa11 -d firmware/bluetooth_rxtx/bluetooth_rxtx.dfu -r

`btbr` answers the requests both images share and nothing else, so without
that the command failed on the first request it does not answer, reported as a
refused request — true, but about the wrong thing. ubertooth-btbr(1) is the
tool that drives `btbr`, and makes no such check: a board carrying
`bluetooth_rxtx` reaches its session and is reported from the write that times
out there. ubertooth-util(1) and ubertooth-dfu(1) check neither version nor
image, because both have to work on whatever firmware a board is carrying.
ubertooth-debug(1) checks the image and not the version: reading CC2400
registers is debugging work on whatever revision a board carries, but the
other image answers no register read, so that board is named rather than left
to fail on the read.

A board that will not say which image it runs is left to the request that
needs it. Two boards answer nothing there: one too busy to take the read, and
one running firmware older than the info block, which a development build
reaches because it reports the version mismatch and runs on. Both are boards
somebody means to use, and neither can be told from the other, so neither is
refused.

## GENERIC RADIO MODE

Experimental, and all of it is reachable from the command line now:
`ubertooth-debug -w` writes the radio's registers, `ubertooth-dump -g`
receives with them, and `ubertooth-tx -g` transmits one packet. Both halves of
the receive work on our bench -- the symbol stream, and the packet framing
where the radio matches a sync word -- and two boards set to the same framing
pass a payload between them. Expect the options and the output to change.

The CC2400 on an Ubertooth is a plain 2.4 GHz radio, and Bluetooth is only
what the firmware usually asks it to do. The generic receive hands that choice
to you: it programs no demodulator of its own and receives with whatever
configuration is already in the radio's registers. So a 2.4 GHz protocol that
is not Bluetooth can be captured without new firmware, as long as the CC2400
can be set up for it.

Two commands do it. `ubertooth-debug -w` writes the registers, and
`ubertooth-dump -g` starts the capture:

    ubertooth-debug -w %manand=0x7fff,%lmtst=0x2b22,%mdmtst0=0x134b,%grmdm=0x0101,%fsdiv=2401,%mdmctrl=0x0029
    ubertooth-dump -g -b -d symbols.txt

One `-w` takes the whole list, so the registers go in one of them.

That example is Bluetooth Basic Rate, as a case you can check against
`ubertooth-dump -c`: GFSK at 160 kHz deviation (MDMCTRL `0x0029`) on 2402 MHz
(FSDIV is the frequency in MHz less the 1 MHz intermediate frequency), with
GRMDM `0x0101` for un-buffered mode and no packet framing. The board streams
demodulated symbols and `-b` prints them as `0` and `1`.

The registers that matter, and what each decides:

 - MDMCTRL : the frequency deviation, which is the data rate the demodulator
   expects. `0x0029` is 160 kHz, `0x0040` is 250 kHz.
 - FSDIV : the channel, as the frequency in MHz less 1 for the intermediate
   frequency.
 - GRMDM : buffered or un-buffered, packet mode or not, how many preamble
   bytes, how much of the sync word to match, and whether the radio checks a
   CRC. Its packet-mode bit is what the board reads to choose between the two
   receives below.
 - SYNCH and SYNCL : the sync word, in packet mode.
 - MANAND, LMTST and MDMTST0 : the analog and test settings the Bluetooth
   receives use; a protocol at a different rate may want others.

`ubertooth-debug -r` reads any of them back, and the CC2400 datasheet is where
the fields come from. Nothing in these tools knows which values make sense
together: a configuration that does not work gives a capture with nothing in
it, not an error.

With GRMDM's packet-mode bit set, the board waits for the sync word instead,
and sends one record each time the radio reports one: the four sync-word
bytes, then a fixed 32 bytes read out of the radio's FIFO. It reads no length
and waits for no end of packet, so a record is a sample of the FIFO and not
necessarily one whole packet. It keeps waiting on a quiet channel, answering
requests, until the capture is stopped.

That path asks more of the configuration than the symbol stream does, because
the radio does the framing: the preamble length, how much of the sync word it
matches and its CRC choice all have to match what is on the air, and a choice
that does not gives a capture with no records in it rather than a message.

The configuration lives in the radio and nothing stores it, so write the
registers and start the capture as two commands with nothing in between. A
mode ending takes the radio through its own reset, which clears what `-w`
wrote; the board being idle is what keeps it. `ubertooth-util -S` leaves an
idle board, so a run that is stopped properly can be set up again and
restarted.

### A generic packet between two boards

`ubertooth-tx -g` transmits one generic packet, and that is the way to see the
packet-framing receive above work: it is the one transmitter whose framing is
known. The board frames the packet in the radio -- 6 preamble bytes of
`01010101`, the whole 32-bit sync word, the radio's CRC, which is GRMDM
`0x0f71` -- so the receiving board has to be set to the same value and the
same sync word.

Two boards, the first receiving on 2402 MHz and the second sending it 32
counted bytes ten times:

    ubertooth-debug -U 0 -w %manand=0x7fff,%lmtst=0x2b22,%mdmtst0=0x134b,%grmdm=0x0f71,%mdmctrl=0x0057,%synch=0xcb87,%syncl=0x6543,%fsdiv=2401
    ubertooth-dump -U 0 -g -d packets.bin &
    ubertooth-util -U 1 -a 1
    ubertooth-tx -U 1 -g 0102030405060708090a0b0c0d0e0f101112131415161718191a1b1c1d1e1f20 -a cb876543 -c 2402 -n 10

What has to agree between the two, and what does not:

 - GRMDM, exactly: `0x0f71` at the receiving end is the value the transmit
   programs, so the preamble, the part of the sync word matched, and the CRC
   all match. The CRC bit is what makes the record's CRC byte mean anything:
   with it clear the radio reports a CRC_OK for packets that carry no CRC at
   all. The payload above is 32 bytes because that is the length the CRC byte
   has been measured at: the receive reads a fixed 32 bytes and the radio
   answers the CRC question at the point the read stopped. See
   ubertooth-dump(1), THE GENERIC RECEIVE.
 - the sync word: `-a cb876543` is SYNCH `0xcb87` and SYNCL `0x6543`.
 - the channel, less 1 MHz at the receiving end: a transmit tunes the carrier
   directly and a receive subtracts its 1 MHz intermediate frequency, so
   `-c 2402` goes with FSDIV `2401`.
 - the deviation: MDMCTRL `0x0057`, which is what the firmware writes for the
   packet as it stands. It is wider than any of the Bluetooth receives use,
   and writing it on both boards is the recipe that works whether or not the
   firmware goes on setting it for the packet.
 - the power: `ubertooth-util -a` sets it, and two boards side by side at the
   default 7 are too loud for each other -- the receiving board reads nothing
   at all. Turn the transmitter down to 0 or 1 for a short path, or put an
   attenuator in front of the receiver.

Each record in `packets.bin` then holds the sync word the radio matched, the
payload that followed it, and what the radio made of the packet's CRC;
ubertooth-dump(1), THE GENERIC RECEIVE says where in the record they are, so a
counted payload can be checked against what was sent. The receive reads a
fixed 32 bytes, so keep a payload that is meant to be read back whole to 32
bytes or fewer.

## OUTPUT AND DIAGNOSTICS

Every tool follows this split. Each tool's own page gives the lines it prints
and the statuses it exits with, under DIAGNOSTICS, EXIT STATUS, or both.

Standard output carries only what was asked for: the report a query returns,
the packets or samples a capture decodes, the capture data itself when the
file argument is `-`, and the usage text for `-h`. Everything else goes to
standard error, so a script reading a tool's standard output is not fed a
diagnostic or a progress line.

Errors are one line starting `error: `; warnings start `warning: ` and notes
start `note: `. Progress and status ("Resetting ...", "Ubertooth stopped", DFU
progress) carry no prefix. The usage text goes to standard output for `-h`, and
to standard error after the `error: ` line when a tool that needs arguments is
run with none (a tool with work to do and no options, such as
ubertooth-specan(1), runs instead). Every other refused command line is the
`error: ` line alone: it describes the problem, so `-h` is where the usage text
comes from.

Exit status is 0 only when the command did what was asked, including `-h`, and
1 otherwise: a usage error, a command line with nothing to do, a device that
is missing or failed, a partial failure. ubertooth-afh(1) also uses 2, for a
detection phase that received no packet.

One warning is worth knowing on sight. When a capture ends, the USB transfer
it was reading into has to come back before the device can be closed; a board
that never returns it leaves the tool no safe way to close the device, so it
says `warning: the receive transfer did not finish; the Ubertooth is left open
and may still be capturing`, asks that board for nothing further, and exits 1:
the capture lost its stream, so it holds less than was asked for. The
board usually needs `ubertooth-util [-U <selector>] -S` or `-r` afterwards, and
one that answers neither usually resets itself about three seconds later and
comes back idle.

A capture that is losing packets says so, whichever way it reads them. A
receive transfer that arrived with part of a packet cannot be read as a
record, so it is dropped, and the capture reports it once per run, because
such a fault usually repeats: `warning: a receive transfer arrived with 32 of
a packet's 64 bytes and was dropped; the capture is losing packets`. That is
the path `ubertooth-dump`, `ubertooth-rx`, `ubertooth-scan`, `ubertooth-afh`,
`ubertooth-follow` and `ubertooth-specan` read through. `ubertooth-btle` and
`ubertooth-ego` poll for their packets one at a time instead, and report the
same fault in the same way: `warning: a poll reply arrived with 32 of a
packet's 64 bytes and was dropped; the capture is losing packets`. The short
replies a board sends on purpose are not reported: the keep-alive a quiet
streaming capture gets, a single byte, and the one-byte "nothing queued"
answer every poll of a quiet capture gets. The capture runs on and ends as it
otherwise would, so the warning is the only sign: it says packets were lost,
it does not fail the run.

A capture also says when its receiver is being driven harder than it can
measure: `warning: the signal is at the top of the receiver's range, so the
board cannot measure it and may not demodulate it; the boards may be too close
together, or the transmit power too high`. Said once per capture, with a
total when the capture ends: `warning: the capture has 3 stretches where
the signal was at the top of the receiver's range`, one per block of
records judged to be there.

The signal figure a record carries comes from the radio on a scale that runs
out: above a certain reading the host can only say "at least this loud", and a
receiver held there is also past where it demodulates reliably. A Basic Rate
packet line says as much, printing `s=none snr=none` in place of a figure the
board did not measure, and a low-energy line prints `rssi=none`; see
ubertooth-rx(1) and ubertooth-btle(1). A capture record still holds 0 dBm for
such a packet, because a record has no way to say the level was not measured,
so a capture file reads 0 dBm where either line reads `none`.

Every receive that captures turns the board's amplifier on and the Basic Rate
and low-energy ones turn its high-gain mode on too, which is what makes the
near end of a bench reach it. On the bench this measures as two separate
regimes rather than
a borderline: a transmitting board a few centimeters from the receiver holds
every record at the top of the scale at every one of the eight transmit power
levels, while the same board a meter away behind a 20 dB attenuator stays well
below it even at level 7. So where the link is two boards of your own, the
warning is about the link rather than the setting of any one option: put more
distance or more attenuation between them, or turn the transmit power down,
and the capture has a signal it can both measure and read. Anything else close
and loud enough will do it too, and the board cannot say what is deafening
it -- only that something is.

One packet at the top of the scale is not this, and is not reported: a short
packet from a board a few centimeters away arrives with a valid CRC, reported
as `none` in place of its level on either kind of line. What is reported is a
receiver held there, which is judged over a block of records rather than one.

Only the captures whose records are samples of the air report it, and that is
the point rather than a limitation. The Basic Rate stream sends a record for
every block of air it collects, packet or no packet, so `ubertooth-rx`,
`ubertooth-dump` with `-c` or `-l` (which is every run that does not ask for
`-g`), `ubertooth-scan`, `ubertooth-afh` and `ubertooth-follow` notice a
receiver that is pinned even while they decode nothing at all -- which is the
case worth knowing about, since that is what a deafened receiver looks like.

ubertooth-btle(1) does not report it, under any of `-f`, `-n` and `-p`. Its
board sends a record for a packet it demodulated and for nothing else, so a
record at the top of the range there says a packet decoded at the top of the
range, which an ordinary close link produces all day: a short packet from a
board a few centimeters away arrives at the ceiling with a valid CRC. Judging
such records would warn about captures that are working, and the case that
matters -- a link so loud that nothing decodes -- sends that tool no records
to judge at all. Run ubertooth-rx(1) on the same channel to tell a deafened
receiver from an empty one.

The generic receive (`ubertooth-dump -g`) reports it or not according to which
of its two receives the radio's configuration selects, which GENERIC RADIO
MODE above describes: with GRMDM's packet-mode bit clear it reads a stream of
symbols through the same path as a Basic Rate capture, takes a reading per
poll and reports this as that capture does, while with the bit set the board
waits on a sync word, takes no readings at all, and its records state no
signal figure for anything to judge.

ubertooth-ego(1) never reports it: its records state no signal figure either,
and its receive leaves the high-gain mode off in any case.
ubertooth-specan(1) is left out for a different reason: its sweep also reads
the radio with the high-gain mode off and reports the raw readings themselves,
so its figures are not on the scale this warning is about. The `btbr` image's
own tools report nothing here at all, because that firmware sends none of
these records.

libubertooth follows the split already: it returns what it reads to the tool
that called it and reports its own problems on standard error, so a library
message does not land in the middle of a capture. The clock trim and AFH
channel notes raised while following a piconet are `note: ` lines on standard
error. What the library still writes to standard output is the calling tool's
result — the decoded packet reports, the AFH map of `ubertooth-afh`, the
version line — which is the right stream for them, whichever layer prints
them. libbtbb writes there for that reason and nothing else, which today is
the decoded packet's type and payload and that same map. What it says while it
works out a piconet's address and clock — the candidate counts, `got CLK1-27`,
the clock offset, the UAP it settled on — is on standard error, so a capture
collected on standard output holds the capture alone. The channel map the two
BlueZ tools report is the exception to all of this: those tools print it
themselves, so no library writes it. libubertooth's device-selection
messages are `error: ` lines on standard error, each with whatever detail it
needs under it: the boards listed after a refusal for several attached, and
the counts and reason after a serial that matched nothing.

## ENVIRONMENT

`UBERTOOTH_ALLOW_API_MISMATCH` decides what a tool does about firmware of
another API version, whatever the build it came from. `1` warns and runs the
command, which is how a release build is made to talk to firmware from
another commit for debugging; `0` refuses it, which is how a development
build is made strict, for a test harness that wants a refusal rather than a
warning. Only those two exact values decide: unset, empty or anything else leaves the
build's own answer, so a typo cannot turn the guard off. See FIRMWARE OF
ANOTHER API VERSION above.

`UBERTOOTH_TEST_NO_DEVICES=1` makes every tool behave as if no Ubertooth were
attached: nothing is listed or opened on the USB bus, and the tool reports that
it found no device. It exists for the project's own test suite, which runs the
tools while boards may be in use elsewhere, and it is the only setting that
changes device selection. Only the exact value `1` turns it on; unset, empty or
any other value leaves device selection alone. A tool that finds no board
because of it says so:
`note: UBERTOOTH_TEST_NO_DEVICES is set, so no board is selected`.

## SUPPORT

Ubertooth is an open source project maintained primarily by volunteers.
Please keep that in mind when seeking support.

If you are having issues with one of these tools or believe you have found a
bug, please file an issue on this fork:
<https://github.com/SqueakyFloors/ubertooth>

Upstream Project Ubertooth, which this fork builds on, is at
<https://github.com/greatscottgadgets/ubertooth>, and that is where to report
something these tools share with it.

For interactive support, join the `#ubertooth` channel on Discord:
<https://discord.gg/rsfMw3rsU8>

## COPYRIGHT

The code and documentation for Project Ubertooth are Copyright 2010-2017
and are available under the terms of the GPLv2. Refer to [COPYING](https://github.com/SqueakyFloors/ubertooth/blob/main/COPYING) for
details. Ubertooth is a registered trademark of Great Scott Gadgets.

## AUTHOR

This manual page was written by Mike Ryan.
