SqueakyFloors/ubertooth/host/README.md

Ubertooth Host
==============
This is host code for use with bluetooth_rxtx firmware.

Required Software
-----------------
These tools link to libbtbb, and are built and tested against this project's
fork of it (https://github.com/SqueakyFloors/libbtbb) at one pinned commit.
The [build guide](../docs/source/build_guide.rst) names that commit; the
simplest way to get it is [install.sh](../install.sh), which clones and builds
it for you. By hand:
```
$ git clone https://github.com/SqueakyFloors/libbtbb.git
$ cd libbtbb/
$ git checkout <the commit named in the build guide>
$ mkdir build
$ cd build
$ cmake -DENABLE_PYTHON=OFF ..
$ make
$ sudo make install
```

libbtbb installs its library to the directory the system keeps libraries in
(`lib`, or `lib64` and `lib/<triplet>` on the systems that use those), and the
build below asks pkg-config and CMake where it is rather than assuming `lib`.

This software also requires libusb 1.0 or higher, which can be found at
http://www.libusb.org or installed from your OS's package repository.

An optional, but recommended, dependency is libPcap, which is available from
http://www.tcpdump.org or can be found in your OS's package repository.

Building
--------
Build the library and tools using the following steps:
```
$ mkdir build
$ cd build
$ cmake ..
$ make
$ make install (may require root privileges)
```

If previous versions of libbtbb or Ubertooth tools are installed they should be
removed before building the latest release.  A script to do so can be found in
the libbtbb archive and run as follows:
```
$ sudo libbtbb/cmake/cleanup.sh -d
```
Running the script without the '-d' option will print the files to be removed.

The Tools
---------
ubertooth-util: various utility functions including firmware and host versions,
LEDs, reset, channel and the attached-device count. Reflashing is
ubertooth-dfu's job.

ubertooth-rx: a general purpose Bluetooth sniffing tool, will promiscuously
find LAPs or, if given a LAP, will determine a UAP.  Given both a LAP and a UAP
it will attempt to calculate a clock and hop along with the piconet.

ubertooth-dump: dumps a raw Bluetooth symbol stream from an Ubertooth board.
If you pipe it into xxd, you should see various ones and zeros.  If you pipe it
into dd, you can find out the transfer rate (should be 1 MB/s).  Timestamps are
dumped to stderr.

ubertooth-specan: outputs signal strength data suitable for feeding into spectrum
analyser software. e.g.
```
ubertooth-specan -G | feedgnuplot --stream 0.5 --domain --3d
```

will use feedgnuplot to drive gnuplot to draw a realtime animated 3D plot of the
frequency spectrum.

Privledge Reduction
-------------------
If you desire to run any program which accesses the ubertooth hardware as a user
you may do so by copying libubertooth/40-ubertooth.rules to wherever your distro
keeps udev rules, typically /lib/udev/rules.d

This action will allow any user in the "usb" group to access the ubertooth
hardware. If you want to give access to a different group you can easily edit
the rules file and change usb to whatever group you prefer.

Troubleshooting
---------------

If trying to run any of the host tools results in error message like 
```
ubertooth-specan: error while loading shared libraries: libubertooth.so.1: cannot open shared object file: No such file or directory
```
there could be a problem with your library path configuration.

On Arch Linux and Fedora it could be neccessary to edit the `/etc/ld.so.conf` (or create a corresponding file with the path in `/etc/ld.so.conf.d/`) file to include the default library installation path `/usr/local/lib`.
