SqueakyFloors/ubertooth/COMPATIBILITY.md

# Compatibility and Support

This document states which platforms and tool versions this fork **requires**,
which it has been **tested against**, and which are **not supported**.

> **Honesty rule for this doc:** a cell is only marked *Verified* if it was
> actually exercised — by a CI run or on real hardware (see
> [validation/](validation/)). Requirements we intend to meet but have **not yet verified**
> are marked *Target (unverified)*. We do not claim support we have not proven:
> this fork exists to make the tree build and run on current systems, and the
> matrix is the record of where that has actually been exercised.

Legend:
- ✅ **Verified** — exercised by CI or hardware, known good.
- 🎯 **Target (unverified)** — intended to be supported; not yet tested. Must
  not be advertised as working until verified.
- ❌ **Unsupported** — explicitly not supported; will not be fixed.

---

## Support matrix

| Dimension | Minimum (required) | Tested / known-good | Unsupported | Status of minimum |
|---|---|---|---|---|
| **Ubuntu** | 20.04 LTS | 20.04, 22.04, 24.04 (CI, host+fw); 24.04.4 x86_64 on hardware (host tools) | ≤ 18.04 (use 2020-12-R1) | ✅ 20.04 verified in CI (container) |
| **Fedora** | none declared: whatever `fedora:latest` is ([note below](#fedora-is-the-unpinned-canary)) | `fedora:latest` (CI): the host tools and their tests, and all of `install.sh` | older than `latest`: untested | ✅ verified in CI only; no Fedora machine has run it, and `install.sh --with-firmware` there is unverified |
| **macOS** | 14 (Sonoma) | 14, 15, 26 / arm64 (CI, host+fw); 26.7.1 arm64 on hardware (host tools) | ≤ 13 | ✅ 14 verified in CI |
| **Windows** | — | — | all | ❌ Unsupported (libusb + udev; use Linux/VM) |
| **CMake** | 3.5 | 3.5 … 3.27 (enforced range); 3.28.3 (Ubuntu 24.04) and 4.4.4 (macOS 26) build the host tools | < 3.5 (CMake 4 removed it) | ✅ floor enforced in CMakeLists |
| **GNU make (firmware)** | 3.81 | 3.81 (macOS), 4.3 (Linux) | — | ✅ 3.81 verified; build avoids make ≥ 4.0 features |
| **perl (firmware tests)** | 5, any version | the system perl on the Ubuntu 24.04 and macOS 26 CI runners | — | ✅ verified in CI on both. Only `make -C firmware test` needs it |
| **Python (host tools)** | 3.8 | 3.8 (U20 CI) … 3.14 (macOS CI) | 2.x (removed upstream) | ✅ 3.8 verified in CI |
| **GCC (host)** | 9.4 | 9.4 (Ubuntu 20.04 CI), 11.4 (22.04), 13.3 (24.04), 16.2 (Fedora CI); Apple clang 15 (macOS 14), 17 (macOS 15), 21 (macOS 26); also `-std=c17`/`-std=c2x` | older than 9.4 (not tested) | ✅ 9.4 verified in CI (oldest tested) |
| **arm-none-eabi-gcc (firmware)** | 9-2019-q4 (GCC 9.2.1) | 9-2019-q4 (Ubuntu 20.04 CI), 10.3-2021.07 (22.04), 13.2.rel1 (24.04), 15.3.1 (macOS 14/15/26 CI); 13.2 (Linux) and 15.3 (macOS) on hardware | older than 9-2019-q4 (not tested) | ✅ 9-2019-q4 verified in CI (oldest tested) |
| **libusb** | 1.0.23 | 1.0.23 (Ubuntu 20.04 CI), 1.0.25 (22.04), 1.0.27 (24.04), 1.0.30 (macOS) | pre-1.0; older than 1.0.23 (not tested) | ✅ 1.0.23 verified in CI (oldest tested) |
| **libbtbb** | the pinned fork commit ([`d356e9d`](https://github.com/SqueakyFloors/libbtbb/commit/d356e9da7fb03969371aa14d603a8aad2f0ef198), C lib) | that commit (CI, `install.sh`); upstream master was CI's dependency until the switch to the pin | one missing a function the tools call or a macro they read: refused at configure time; one from another commit: a warning. Any other libbtbb, upstream's included: untested here | ✅ the pin is what CI builds |
| **libbluetooth (BlueZ)** — optional, for `ubertooth-scan` and `ubertooth-follow` | 5.53 | 5.53 (Ubuntu 20.04 CI), 5.64 (22.04), 5.72 (24.04), 5.87 (Fedora CI) | macOS: no BlueZ, and the operations these tools need are not in macOS's public APIs either, so both are skipped there and will stay that way ([note below](#macos-ubertooth-scan-and-ubertooth-follow-are-linux-only)) | ✅ 5.53 verified in CI. Both tools have since run against a real adapter: `ubertooth-scan` ([#1175](https://github.com/SqueakyFloors/ubertooth/pull/1175)) and `ubertooth-follow` ([#518](https://github.com/SqueakyFloors/ubertooth/issues/518)), the latter not yet reliably, for a timing reason rather than a BlueZ one (the `-w` delay, in `host/doc/ubertooth-follow.md`). Neither run recorded the adapter's BlueZ version |
| **ronn-ng (man pages)** | 0.10.1, exactly | 0.10.1 (`Man pages` CI job on Ubuntu 24.04; macOS 26 via Homebrew) | any other version: it renders the same Markdown differently, so the committed pages would stop matching a refresh | ✅ 0.10.1 verified in CI. Optional: only `refresh-manpages` needs it, and a build neither needs it nor runs it |
| **git (only to make a source archive)** | 2.35 | 2.48 and 2.51 (`git archive` of a release tag, read back and built) | older than 2.35: `git archive` does not fill the release into `RELEASE-VERSION` (`%(describe)` arrived in 2.32 and its `tags` option in 2.35), so an archive it makes reports its release as `unknown` | ✅ verified by building an archive of a tag. Optional: building from a git checkout, or from an archive someone else made, needs no particular git |
| **Ubertooth firmware (API)** | 1.58 (this tree), exactly | 1.58 on an Ubertooth One, both images reporting this tree's version | any other, 1.57 and 1.07 (`2020-12-R1`) included: refused, except by the three tools that have to work on whatever firmware a board is carrying ([note below](#firmware-api-version-exact-match-bumped-for-a-breaking-change)) | ✅ 1.58 verified on the air; 1.56 and 1.57 over USB. 🎯 1.52, 1.54, and 1.55 untested on hardware, 1.53 only in part ([#824](https://github.com/SqueakyFloors/ubertooth/issues/824)). The symbol transmit mode and the E-GO access code have not been on the air |
| **Ubertooth bootloader** | whichever one is on the board; no tool checks it (its DFU-mode `bcdDevice` is a fixed 1.00) | the one the boards shipped with; this tree's is compiled and linked in CI, which also checks that it fits its 16 KiB region and carries its version block. `ubertooth-util -B` reports which bootloader a board has: this tree's (2.00 and up) by version and revision, an earlier or factory one by the hash of its region alone | — | ✅ `ubertooth-dfu --update-bootloader` installs one over USB, verified on a real part (an LPC1756) ([#1056](https://github.com/SqueakyFloors/ubertooth/issues/1056)) |

---

## Key compatibility notes

### Ubuntu 18.04 and older: not supported by this fork (use 2020-12-R1)
This fork targets modern distributions and does **not** support Ubuntu 18.04 or
older. We will not verify or maintain compatibility with that era's toolchain
(CMake 3.10, Python 3.6, GCC 7.x).

Users on Ubuntu 18.04 should use the **`2020-12-R1` legacy release**, which was
built for that era. A maintainer of this fork has run that release on Ubuntu
18.04 for years in regular use, so the common workflows are known to work there;
that is the known-good path for 18.04 — not this fork's current branch. It is
mirrored on this fork (unmodified upstream code, provided as-is) for convenience:
<https://github.com/SqueakyFloors/ubertooth/releases/tag/2020-12-R1>
(original: <https://github.com/greatscottgadgets/ubertooth/releases/tag/2020-12-R1>)

### Fedora is the unpinned canary
Every other row of the matrix names the versions it was exercised against.
Fedora deliberately does not: the job follows `fedora:latest`, so each run
takes whatever Fedora ships now. That is the point of having it. Fedora gets a
new compiler, CMake and Python before the distributions pinned above, so a
break that would reach an Ubuntu LTS user a year from now shows up here first,
which is the one thing a pinned image could not tell us. The cost is that a
green run says nothing about an older Fedora, and that a failure can be the
new toolchain rather than this tree.

Two CI jobs cover it, both in containers, because GitHub hosts no Fedora
runner: `build.yml`'s full tier builds the host tools and runs their tests,
and `install-sh.yml` runs all of `install.sh` — the `dnf` dependencies,
libbtbb, the build, the install, and the uninstall. Neither covers
`--with-firmware`: the ARM toolchain packages are named in the script and
present in the Fedora repositories, but nothing has built firmware with them.

### Windows is not supported
libusb on Windows and the absence of udev rules make this impractical. Run the
host tools under Linux (native or VM). Documented as a hard non-goal.

### macOS: arm64 verified, Intel (x86_64) not CI-tested
CI covers Apple-Silicon (arm64) macOS 14/15/26. Intel macOS is not tested in CI:
GitHub's `macos-13` (last Intel) runners are capacity-constrained and queue
unreliably, so an Intel CI job stalls rather than giving a timely signal. The
code should build on Intel (no include path in the build names a Homebrew
prefix: the configure step takes libusb's include directories from libusb,
wherever Homebrew put it), but this is unverified. Test locally if you build on
an Intel Mac.

### macOS: `ubertooth-scan` and `ubertooth-follow` are Linux only
These two are the only tools that need a second, ordinary Bluetooth adapter
beside the Ubertooth, and they drive it through BlueZ, which exists on Linux
only. On macOS they are not built, and that is where it stays: the adapter
operations they depend on are not reachable from macOS's public Bluetooth
APIs. CoreBluetooth is an LE API and cannot do Classic at all; IOBluetooth
does Classic, but only the parts Apple exposes:

| Adapter operation | Used by | BlueZ | Public IOBluetooth |
|---|---|---|---|
| Choose and open a local adapter (`-b hciN`) | both tools | `hci_devid()`, `hci_open_dev()`, `hci_devinfo()` | only the default controller, `+defaultController`, with no choice of adapter; its address is there (`-addressAsString`), its LMP features are not |
| Inquiry | `ubertooth-scan -s` | `hci_inquiry()` | yes, `IOBluetoothDeviceInquiry` |
| Connect / disconnect | `ubertooth-scan -x`, `ubertooth-follow` | `hci_create_connection()`, `hci_disconnect()` | yes, `-openConnection:`, `-closeConnection` |
| Remote name, bound to the address it was asked of | `ubertooth-scan` | `hci_send_req()` with `OCF_REMOTE_NAME_REQ`, reading the completing event so that the name can be held against the address asked about; `hci_read_remote_name()` returns the name alone | yes, `-remoteNameRequest:`, which answers on the `IOBluetoothDevice` the request was made of, so the binding is there |
| Remote version, LMP features | `ubertooth-scan -x` | `hci_read_remote_version()`, `hci_read_remote_features()`, `hci_read_remote_ext_features()` | **no** |
| Clock offset | `ubertooth-scan -x`, `ubertooth-follow` | `hci_read_clock_offset()` | only `-getClockOffset`, whose value its own documentation calls meaningful only for a device seen during an inquiry; the read itself cannot be asked for |
| The adapter's own clock, which with that offset gives the piconet's CLKN | `ubertooth-follow` | `hci_read_clock()` | **no** |
| AFH channel map of a link | `ubertooth-scan -x`, `ubertooth-follow -a` | `hci_read_afh_map()` | **no** |

So a native backend could cover `ubertooth-scan`'s inquiry and names, but not
the extra device detail of `-x`, and it could not choose which adapter to use.
`ubertooth-follow` exists for the clock and the AFH map, so it cannot be
supported at all. Sending the missing HCI commands needs private Apple
interfaces, which this project will not ship. (The per-piconet channel map
`ubertooth-scan` prints in its survey results is a different thing, built by
libbtbb from what the Ubertooth itself heard, and it needs no adapter.)

Driving an external USB adapter directly, through a user-space stack such as
BTstack or Bumble, would sidestep the public API, but it means taking the
controller away from macOS (`nvram bluetoothHostControllerSwitchBehavior`),
re-implementing the Classic operations against that stack, and living with a
macOS 26 bug in the USB host stack that can panic the machine for particular
devices and operations — BTstack's
[libusb port](https://github.com/bluekitchen/btstack/tree/master/port/libusb)
documents it and avoids device resets because of it. Not worth it for two
tools, so this fork does not take that route either.

**What to do on a Mac instead.** Both tools exist to shorten work the Ubertooth
can do by listening, so do that work passively: `ubertooth-rx -z` surveys the
band and reports the LAPs it hears, `ubertooth-rx -l <LAP>` recovers that
piconet's UAP and clock and then follows and decodes it, and `ubertooth-afh`
recovers a piconet's AFH channel map. None of them needs an adapter, and all
three are built on macOS. They cover much of the same ground, not all of it:
if you need an active inquiry, the remote version and features of
`ubertooth-scan -x`, or a clock read from an adapter, run these two tools on
Linux, native or in a virtual machine with the Ubertooth and the adapter
passed through.

### The host library needs C11 atomics
`libubertooth` uses `<stdatomic.h>` for the two pointers of the capture ring
buffer, which one thread advances and the other reads. The header is a public
one, so the C11 floor applies to any C program that includes `ubertooth.h`, not
only to this project's own build. Every compiler in the table above has
atomics, and the default standard of GCC and clang (`gnu17`) is past C11, so a
normal build is unaffected; a `CFLAGS` of `-std=c99` or older is not supported,
and an implementation that defines `__STDC_NO_ATOMICS__` is refused with a
message. C++ code that includes the header is unaffected: it sees those two
fields as the plain integer they are built on, and nothing outside the library
touches them.

### `install.sh` platforms
`install.sh` supports Debian/Ubuntu (`apt`), Fedora (`dnf`) and macOS with
Homebrew. On macOS it installs into the Homebrew prefix without `sudo`, builds
without BlueZ (no `ubertooth-scan`/`ubertooth-follow`), and installs no udev
rules. Verified on macOS 26 arm64 with two Ubertooths: a full run that
installed the missing Homebrew packages (`fftw`, `dfu-util`), the host tools,
and a firmware build and flash of both boards with `--flash-device all`. Intel
Macs are unverified.

Fedora is verified in CI only, by the `install-sh` workflow's `fedora:latest`
container leg: that run lets the script install the dependencies itself, so the
Fedora package names are exercised rather than assumed, and then builds,
installs, and uninstalls as the Ubuntu leg does. No Fedora machine has run it
by hand, and the firmware packages (`arm-none-eabi-gcc-cs`,
`arm-none-eabi-newlib`) are listed from the Fedora repositories rather than
built with: `--with-firmware` on Fedora is unverified.

### CMake 4.x
Modern CMake (4.x) removed compatibility with `cmake_minimum_required < 3.5`.
This fork declares `cmake_minimum_required(VERSION 3.5...3.27)`, and the
pinned `libbtbb` fork commit declares a range too, so neither needs
`-DCMAKE_POLICY_VERSION_MINIMUM=3.5` any more. Upstream `libbtbb` still
declares `VERSION 2.8` and does need it. That is moot for these tools now:
they call entry points only the fork's libbtbb has, so upstream's does not
configure at all (see below).

### libbtbb comes from this project's fork, at a pinned commit
CI, `install.sh` and the build guide all build the same
`SqueakyFloors/libbtbb` commit, so a push to libbtbb cannot change an
Ubertooth build. The pin lives in `.github/workflows/build.yml`; the
`libbtbb pin` workflow, which runs on every change including a documentation
one, fails if any other file naming it, this one included, falls behind, or if
the pin is not a commit on the fork's default branch: a squash-merged pull request
head whose branch has been deleted is still served to CI by its hash, but is
in nobody's clone. Only the C library is built (`-DENABLE_PYTHON=OFF`): the
Ubertooth tools link nothing else from libbtbb.

These tools call entry points the fork's libbtbb adds to `btbb.h`, so the pin
is what they build against and upstream master — which CI built until the pin
— no longer configures: the configure-time check in the table above names the
functions a libbtbb is missing and stops there, which no CMake option
settles. Older upstream releases, `2020-12-R1` included, have not been
exercised here either.

That check catches a libbtbb that cannot satisfy a call these tools make, which
is what a pin bump adding an entry point leaves behind. A bump that only
changes how libbtbb behaves adds none, so the configure step also prints the
commit the library it found was built from beside the pinned commit, and warns
when the two differ; the [build guide](docs/source/build_guide.rst) shows the
line. It warns rather than refusing, because a libbtbb from a distribution
package records no commit for the comparison to use.

### Firmware API version: exact match, bumped for a breaking change
The host tools require firmware whose API version (`UBERTOOTH_API_VERSION`,
reported as the USB `bcdDevice`) is exactly their own. A release build refuses
any other. Three tools have to work on whatever firmware a board is carrying,
so they do not check the version: `ubertooth-dfu`, which refuses a file its
image check rejects, or one with no firmware info block, both before the board
is asked to leave its application, but warns about -- and still writes -- an
image built for another API version, because it is the way back from a board
whose firmware does not match; `ubertooth-util`, whose only exception is `-I`,
which checks the version itself before it drives a mode; and
`ubertooth-debug`, which checks which of this tree's two images a board runs
but not the version.

A build made from a git checkout that is not on a tag is a development build:
it warns and runs the command, because host tools and firmware from different
commits are the normal state of lab work. `UBERTOOTH_ALLOW_API_MISMATCH` sets
either answer whatever the build (`1` runs on, `0` refuses). During development
the minor version stays where it is through an ordinary firmware change,
because host tools and firmware are built and flashed together and a
development build only warns when the two disagree; it is bumped for a change
that breaks older host tools -- a request removed or renumbered, a reply layout
an older host would misread -- so that such a board is reported rather than
used silently. The first fork release takes 2.00, to mark that its host tools
and firmware only work with each other.

The bootloader is not covered by that number. It reports a fixed `bcdDevice`
of 1.00, no host tool checks it, and `./install.sh --flash` writes the
application only, so a change to the bootloader reaches a board only when
someone flashes it deliberately. A bump that moves bootloader behaviour
therefore marks the change in the tree rather than anything a host can read
off a board sitting in DFU.

The number still does not pin down a commit, since every commit that does not
bump it shares the number before it, which is why the firmware revision shown
by `ubertooth-util -v` beside the API version is what identifies a build. Host
tools and firmware built from the same commit always match, so after pulling,
rebuild and reflash both from the same commit (`./install.sh --flash`).

The firmware keeps its largest buffers in the part's second RAM bank (AHB
SRAM, at `0x2007C000`), so the microcontroller has to have that bank. The
Ubertooth One's LPC1756 does. A part without it would fault at the first
access to one of those buffers, so check the part's own memory map before
building this firmware for anything else.

### Building the firmware: GNU make 3.81 (macOS) and the generated version.h
The firmware builds with the stock GNU make on macOS (**3.81**) as well as the
modern make on Linux (4.3). The build intentionally avoids make ≥ 4.0 features
(e.g. `$(file ...)`) so a Mac with only Xcode Command Line Tools can build
firmware without installing a newer make.

The firmware version string reported by `ubertooth-util -v` / `-V` is produced
by a generated `version.h`, not a `-D` compile flag. It names the release the
image was built from, or the nearest release and how many commits are past it;
`firmware/version.mk` works it out and `host/cmake/set_release.cmake` works
the host tools' out the same way, so a board and the tools that talk to it
report one version between them. It is regenerated only when the build
identity changes, so `-v` always matches the firmware actually built and
flashed — verified across incremental rebuilds on make 3.81 and 4.3, and
end-to-end on real hardware (built version == on-device `-v`) on both macOS
and the Linux test bench. The header carries nothing else about the build —
no date, no time, no user, no host — so the same source always builds the same
bytes, and telling apart two builds that report the same release means
comparing the `.dfu` file's checksum. A source archive with no `.git`
(downloaded zip / release tarball) uses a shipped `version.h` as-is, or the
release `git archive` wrote into `RELEASE-VERSION`, and reports `unknown` where
it has neither; `tools/ubertooth-release.sh` writes both into the archive it
builds.

### Python 3 only
Python 2 support was removed upstream in 2020-12-R1. This fork targets modern
Python 3; verified from 3.8 (Ubuntu 20.04) through 3.14 (current macOS runner).
Older distros (e.g. Ubuntu 18.04 / Python 3.6) are out of scope — see above.

**Prefix-safe Python installation.** CMake installs the in-tree pure-Python
`specan` and `ubtbr` modules directly under `CMAKE_INSTALL_PREFIX`, with no
`setup.py install` and no setuptools. The configured launchers locate those
modules relative to their own installed path, so custom prefixes and `DESTDIR`
work without `PYTHONPATH` and without modifying the system Python
([#33](https://github.com/SqueakyFloors/ubertooth/issues/33)). The runtime
dependencies stay external: NumPy, QtPy, and PySide6 for specan_ui, and
`libusb1` for ubtbr.

### Wireshark extcap: interfaces are named by serial
`btle-extcap.py` names each capture interface `ubertooth<serial>` rather than
`ubertooth<index>`
([#269](https://github.com/SqueakyFloors/ubertooth/issues/269)), so a board
keeps its interface across a replug. The
name changed with it: an interface saved by an earlier Wireshark session is
gone from the list and the Ubertooth has to be picked once more, after which
Wireshark remembers it. An `ubertooth<index>` from such a profile is still
accepted on the command line.

The script tolerates `--extcap-version` and `--extcap-capture-filter`, the
options Wireshark adds to its own calls, and refuses the ones Wireshark sends
only to an extcap program that advertised the feature behind them. A word that
is not an option or the value of one is refused, as the other host tools refuse
one. A capture filter is not applied: Wireshark's verification call is answered
with the reason, which turns the filter box red.

Every call exits 0 or 1, `--capture` included
([#343](https://github.com/SqueakyFloors/ubertooth/issues/343)); see
`host/python/extcap/README.md`.

---

## Hardware validation

Hardware evidence is not accumulated in this file. It is recorded per release in
a validation report published with the release (tracked in
[#85](https://github.com/SqueakyFloors/ubertooth/issues/85)). The "on
hardware" entries in the platform and toolchain rows above reflect the most
recent runs there, which covered the host tools only (build, unit tests,
read-only device queries, and firmware flashing), not radio capture. A row
resting on a run of its own says whether that run was over the air or over
USB; the pull request that did it holds the numbers.

---

## How these claims are kept honest

1. **Enforced floors** — minimums are asserted in the build where possible
   (`cmake_minimum_required(... )`) so the floor can't silently drift from the
   docs. The Python 3.8 floor is checked in `host/python/cmake/UbertoothPythonFloor.cmake`:
   an older interpreter skips the Python tools with a warning, or fails the
   configure with `-DREQUIRE_ALL=ON`.
2. **CI matrix = the "tested" column** — the "Tested / known-good" entries
   above must mirror the pinned full-tier CI matrix in
   `.github/workflows/build.yml`, which runs weekly, on a published release, or
   on request; a pull request runs a smaller tier, so the minimum versions are
   exercised by the weekly run rather than on every pull request. Pin explicit
   versions (not `-latest`) so the record is reproducible, and test the
   **minimum and the newest** of each dimension. Which workflow runs when, and
   what each one checks, is in
   [CONTRIBUTING.md](CONTRIBUTING.md#the-checks-a-pull-request-has-to-pass).
3. **Hardware-only claims** — anything about radio behaviour (BLE/BR-EDR
   capture) is only "tested" when run on a real Ubertooth per [validation/TEST_PLAN.md](validation/TEST_PLAN.md).
