SqueakyFloors/ubertooth/docs/source/index.rst

Ubertooth
=====================================

.. toctree::
  :maxdepth: 1
  :caption: User Documentation

  ubertooth_one
  build_guide
  How Bluetooth sniffing works <https://github.com/SqueakyFloors/ubertooth/blob/main/docs/concepts.md>
  faq
  getting_started
  getting_help
  using_ubertooth_with_wireshark
  capturing_BLE_Wireshark
  sniffing_BR_EDR
  bluetooth_captures_PCAP
  history
  ubertooth_projects_mentions

.. toctree::
  :maxdepth: 1
  :caption: Software

  building_from_git
  software
  hardware_leds
  specan_ui
  third_party_software

.. toctree::
  :maxdepth: 1
  :caption: Firmware

  firmware
  programming

.. toctree::
  :maxdepth: 1
  :caption: Hardware

  assembling_hardware

.. toctree::
  :maxdepth: 1
  :caption: Releases

  release_procedure
  Release_2015-10-R1
  Release_2017_03_R2
  Release_2018-08-R1
  Release_2018-12-R1
  Release_2020-12-R1

.. toctree::
  :maxdepth: 1
  :caption: Retired Content

  to_do
  ubertooth_two_wishlist
