SqueakyFloors/ubertooth/docs/images/ubertooth_mark.png

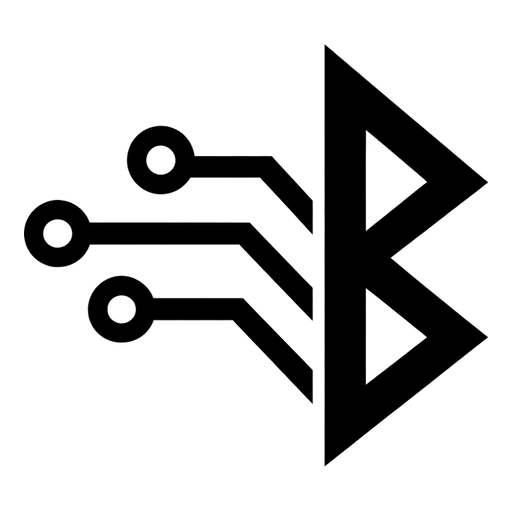
docs/images/ubertooth_mark.png
