SqueakyFloors/ubertooth/docs/images/ubertooth_mark_dark.png

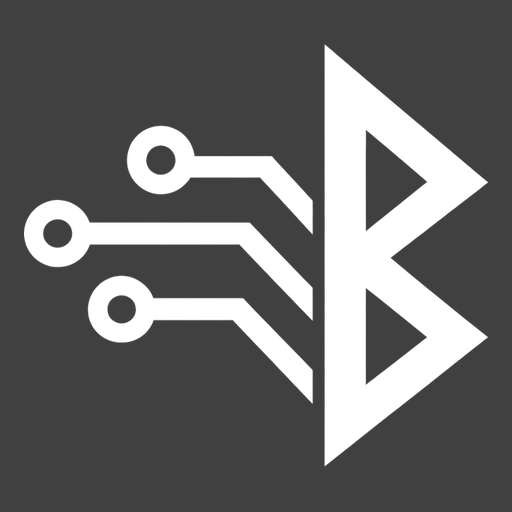
docs/images/ubertooth_mark_dark.png
