SqueakyFloors/ubertooth/docs/images/ubertooth_social_preview.png

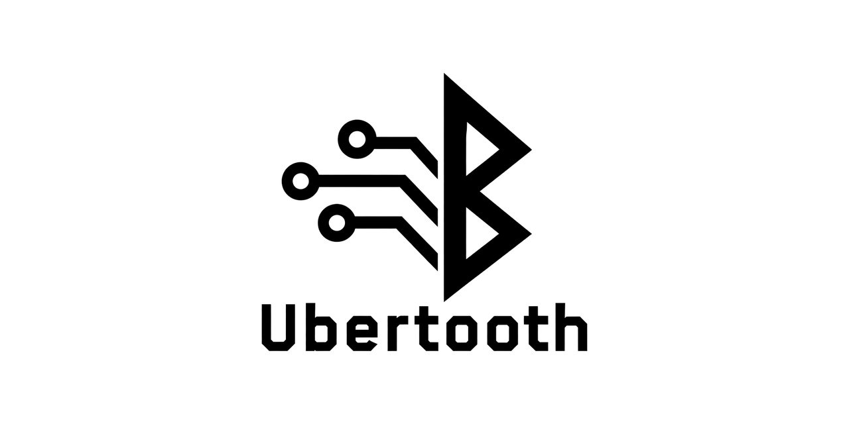
docs/images/ubertooth_social_preview.png
