SqueakyFloors/ubertooth/docs/images/ubertooth_wordmark_dark.png

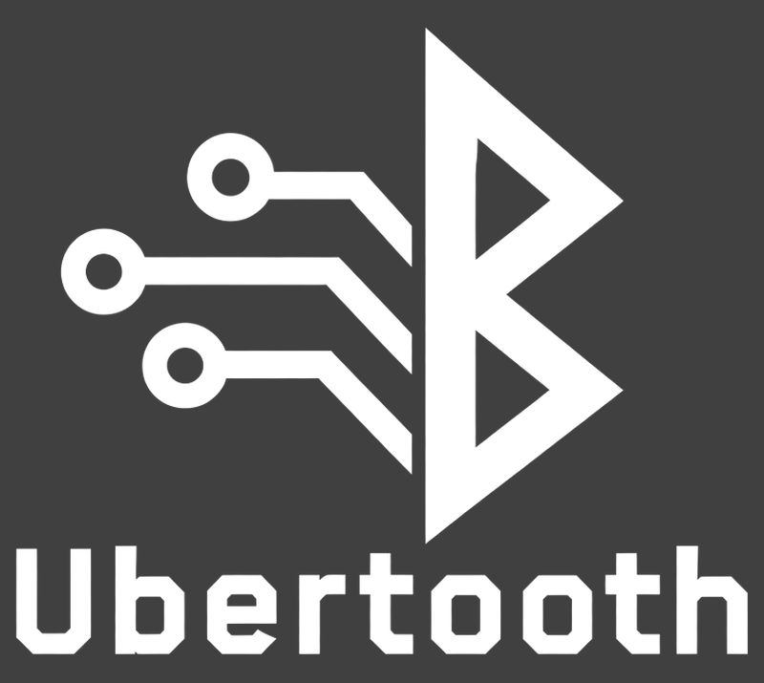
docs/images/ubertooth_wordmark_dark.png
