SqueakyFloors/ubertooth/docs/source/build_guide.rst

===========
Build Guide
===========

This page builds the current tree of this fork: the host tools, the libbtbb
commit they are pinned to, and the optional Wireshark plugins. `COMPATIBILITY.md
<https://github.com/SqueakyFloors/ubertooth/blob/main/COMPATIBILITY.md>`__ says
which systems and tool versions it has been tested on.
:doc:`building_from_git` is the same build starting from a git clone, and
:doc:`firmware` is the next step after it.

Older releases have notes of their own: :doc:`Release_2020-12-R1` and
:doc:`Release_2018-12-R1`.

Host tools and libbtbb
~~~~~~~~~~~~~~~~~~~~~~

Prerequisites
^^^^^^^^^^^^^

There are some prerequisites that need to be installed before building libbtbb and the Ubertooth tools. Many of these are available from your operating system's package repositories, for example:

Debian 10 / Ubuntu 20.04 / Kali
+++++++++++++++++++++++++++++++

	.. code-block:: sh

		sudo apt install git cmake libusb-1.0-0-dev make gcc g++ libbluetooth-dev \
		libfftw3-dev wget pkg-config python3 python3-numpy python3-qtpy \
		python3-pyqt5 python3-usb1

Fedora 33
+++++++++

	.. code-block:: sh

		sudo dnf install git libusb1-devel make gcc gcc-c++ cmake pkgconf-pkg-config \
		wget tar bluez-libs-devel fftw-devel
		# libbtbb and the Ubertooth library both install to /usr/local/lib64 on this system:
		printf '/usr/local/lib\n/usr/local/lib64\n' | sudo tee /etc/ld.so.conf.d/libc.conf

RHEL 8
++++++

	.. code-block:: sh

		sudo subscription-manager repos --enable=codeready-builder-for-rhel-8-x86_64-rpms
		sudo dnf install libusb1-devel make gcc gcc-c++ wget tar bluez-libs-devel python36 python36-devel
		# libbtbb and the Ubertooth library both install to /usr/local/lib64 on this system:
		printf '/usr/local/lib\n/usr/local/lib64\n' | sudo tee /etc/ld.so.conf.d/libc.conf
		# Note: you will also need to install CMake 3.12.0 or greater. See https://cmake.org/install/

CentOS 8
++++++++

	.. code-block:: sh

		sudo dnf config-manager --enable powertools
		sudo dnf install libusb1-devel make gcc gcc-c++ wget tar bluez-libs-devel python36 python36-devel
		# libbtbb and the Ubertooth library both install to /usr/local/lib64 on this system:
		printf '/usr/local/lib\n/usr/local/lib64\n' | sudo tee /etc/ld.so.conf.d/libc.conf
		# Note: you will also need to install CMake 3.12.0 or greater. See https://cmake.org/install/

macOS (Homebrew)
++++++++++++++++

macOS 15 (Sequoia) or newer is supported; see `COMPATIBILITY.md <https://github.com/SqueakyFloors/ubertooth/blob/main/COMPATIBILITY.md>`__ for the
tested versions and `REQUIREMENTS.md <https://github.com/SqueakyFloors/ubertooth/blob/main/REQUIREMENTS.md>`__ for what each dependency enables.
macOS 14 (Sonoma) should still build, but it is no longer tested: GitHub
retired the macOS 14 runner image.
Install the Xcode command line tools (``xcode-select --install``) and
`Homebrew <https://brew.sh>`__, then:

	.. code-block:: sh

		brew install git cmake pkg-config libusb wget fftw
		# firmware build and flashing (optional):
		brew install --cask gcc-arm-embedded
		brew install dfu-util

For the spectrum analyzer user interface's (UI) Python dependencies
(installed in a venv because Homebrew's Python rejects system-wide
``pip install``), see
:doc:`specan_ui`.

``ubertooth-scan`` and ``ubertooth-follow`` need BlueZ (Linux only), so they are
not built on macOS. The host tools in this repository need no CMake options of
their own, and neither does the pinned libbtbb; the archived host source of an
older release needs two, which the Ubertooth Tools section below gives.

FreeBSD users can install the host tools and library directly from the ports and package system:
++++++++++++++++++++++++++++++++++++++++++++++++++++++++++++++++++++++++++++++++++++++++++++++++++++++

	.. code-block:: sh

		sudo pkg install ubertooth

libbtbb
^^^^^^^

Next the Bluetooth baseband library (libbtbb) needs to be built for the Ubertooth tools to decode Bluetooth packets. These tools build against `this project's libbtbb fork <https://github.com/SqueakyFloors/libbtbb>`__, pinned to one commit so that a push to libbtbb cannot change an Ubertooth build. ``ENABLE_PYTHON=OFF`` skips libbtbb's own Python tools, which the Ubertooth tools do not use:

	.. code-block:: sh

		git clone https://github.com/SqueakyFloors/libbtbb.git
		cd libbtbb
		git checkout d356e9da7fb03969371aa14d603a8aad2f0ef198
		mkdir build
		cd build
		cmake -DENABLE_PYTHON=OFF ..
		make
		sudo make install
		sudo ldconfig     # Linux only

libbtbb installs its library to the directory the system keeps libraries in: ``lib`` under most prefixes, ``lib64`` on a 64-bit Fedora, RHEL or SUSE, and ``lib/<triplet>`` where the prefix is ``/usr`` on Debian or Ubuntu. The Ubertooth build asks pkg-config and CMake where it is rather than assuming ``lib``, so nothing here changes with it, and libubertooth goes into that same directory: ``-DCMAKE_INSTALL_LIBDIR=`` chooses it for either library, and `libbtbb's README <https://github.com/SqueakyFloors/libbtbb#where-it-installs>`__ says how to choose the directory there.

That is the commit CI tests against and `install.sh <https://github.com/SqueakyFloors/ubertooth/blob/main/install.sh>`__ builds, and a CI step fails if this page falls behind it. ``./install.sh`` does all of the above for you, and ``./install.sh --libbtbb-url``/``--libbtbb-ref`` build a different libbtbb, which has to carry the entry points the tools call: a libbtbb without them, upstream's included, is refused by the configure step described next.

The Ubertooth tools' own configure step checks the libbtbb it finds for the functions they call, and refuses one that is missing any of them, naming them and the commit above. So if you built the tools once and come back to them later, you may need to rebuild libbtbb at the commit the tree now asks for before the tools will configure.

It also prints one line saying which libbtbb it found, the commit that library was built from, and the commit these tools are built against:

	.. code-block:: text

		-- libbtbb: /usr/local/lib/libbtbb.so, built from commit d356e9da7fb03969371aa14d603a8aad2f0ef198, which is the commit this tree is built against (d356e9da7fb03969371aa14d603a8aad2f0ef198)

A libbtbb built from a git clone records the commit it came from, and the configure step reads that back out of the library. Where the two commits differ the line says both and a warning follows it, because the tools behave the way the libbtbb they link behaves: a capture or a clock measured against them is then a result for that libbtbb rather than for the pinned one. The build is not stopped on that account. A libbtbb installed from a distribution package, or built from a source archive rather than a clone, records no commit; the line says so and names the pin.

A release pins a tag of the libbtbb fork rather than a commit. A tag names no commit for the library's own to be compared with, so the line then names both ends and leaves it there, and no warning follows. The one thing it can still say is that a library was built from a tree with uncommitted changes, which is not the pinned libbtbb whatever the pin names; that warns either way.

Ubertooth Tools
^^^^^^^^^^^^^^^

The Ubertooth repository contains host code for sniffing Bluetooth packets, configuring the Ubertooth and updating firmware. All three are built and installed by default using the following method:

	.. code-block:: sh

		git clone https://github.com/SqueakyFloors/ubertooth.git
		cd ubertooth/host
		mkdir build
		cd build
		cmake ..
		make
		sudo make install
		sudo ldconfig     # Linux only

On macOS the install goes into the Homebrew prefix, which you own, so
``make install`` needs no ``sudo`` there; ``ldconfig`` is Linux only.

``./install.sh`` in the root of the checkout does the libbtbb step above and
this one together, installs the specan_ui Python dependencies, and on Linux
writes the udev rule. ``./install.sh --help`` lists its options, among them
``--prefix``, ``--venv``, ``--with-firmware``, and ``--uninstall``.

An older release is built from its own archive instead of a clone. The
archived host source needs two CMake options a current system does not give it
by default: ``-DCMAKE_POLICY_VERSION_MINIMUM=3.5`` under CMake 4, which current
Homebrew installs, and ``-DCMAKE_C_FLAGS="-I$(brew --prefix)/include"`` on any
Homebrew install, because it looks for libusb's headers in one place only and
that is not where the compiler searches:

	.. code-block:: sh

		wget https://github.com/greatscottgadgets/ubertooth/releases/download/2020-12-R1/ubertooth-2020-12-R1.tar.xz
		tar -xf ubertooth-2020-12-R1.tar.xz
		cd ubertooth-2020-12-R1/host
		mkdir build
		cd build
		cmake ..          # Linux / CMake before 4
		# macOS with CMake 4 (use instead of the command above):
		cmake -DCMAKE_POLICY_VERSION_MINIMUM=3.5 \
		  -DCMAKE_C_FLAGS="-I$(brew --prefix)/include" ..
		make
		sudo make install
		sudo ldconfig     # Linux only

That release's host tools want the firmware of their own era, and they are
built against upstream's libbtbb rather than the commit pinned above, so do not
mix the two trees.

Wireshark plugins
^^^^^^^^^^^^^^^^^

Wireshark 1.12 and newer ships the Ubertooth BLE plugin, and 2.2 and newer
needs none of the plugins below built by hand (see `this comment
<https://github.com/greatscottgadgets/libbtbb/issues/50#issuecomment-284128258>`__),
so users of Debian 10+, Ubuntu 20.04+, Fedora 33+, RHEL 8.3+, and most other
Linux distributions can skip this section. Help --> About Wireshark says which
version you have. It is also possible to :doc:`capture BLE from Ubertooth
directly into Wireshark <capturing_BLE_Wireshark>`.

The Wireshark Bluetooth Baseband (BTBB) and Basic Rate/Enhanced Data Rate
(BR/EDR) plugins allow Bluetooth baseband traffic captured with Kismet to be
analyzed and dissected in the Wireshark graphical user interface (GUI). They
are built separately from the rest of the Ubertooth and libbtbb software.

The directory passed to cmake as ``CMAKE_INSTALL_LIBDIR`` varies from system to system, but it should be the location of existing Wireshark plugins, such as ``asn1.so`` and ``ethercat.so``: the path in the commands below is one Wireshark 2.x layout, not a value to copy blindly. On macOS this is likely ``/Applications/Wireshark.app/Contents/PlugIns/wireshark/``.

	.. code-block:: sh

		sudo apt-get install wireshark wireshark-dev libwireshark-dev cmake
		cd libbtbb/wireshark/plugins/btbb
		mkdir build
		cd build
		cmake -DCMAKE_INSTALL_LIBDIR=/usr/lib/x86_64-linux-gnu/wireshark/libwireshark3/plugins ..
		make
		sudo make install

Then repeat for the BT BR/EDR plugin:

	.. code-block:: sh

		sudo apt-get install wireshark wireshark-dev libwireshark-dev cmake
		cd libbtbb/wireshark/plugins/btbredr
		mkdir build
		cd build
		cmake -DCMAKE_INSTALL_LIBDIR=/usr/lib/x86_64-linux-gnu/wireshark/libwireshark3/plugins ..
		make
		sudo make install

Third Party Software
~~~~~~~~~~~~~~~~~~~~

There are a number of pieces of :doc:`third party software <third_party_software>` that support the Ubertooth. Some support Ubertooth out of the box, while others require plugins to be built.

Firmware
~~~~~~~~

This completes the install of the Ubertooth tools, and the next step is :doc:`firmware`. The host tools require firmware of their own API version, so flash the firmware built from the same commit before you use them. Tools built from a tagged commit, or from a source archive with no git history, refuse a board reporting any other version; tools built from a checkout that is not on a tag warn and carry on, and ``UBERTOOTH_ALLOW_API_MISMATCH`` sets either answer whatever the build. ``./install.sh --flash-device <index|serial|all>`` builds and writes it for you.
