SqueakyFloors/ubertooth/validation/README.md

# Validation

This folder holds the hardware validation material for this fork:

- **The manual checklist**, [TEST_PLAN.md](TEST_PLAN.md): the tests a person
  runs on a real Ubertooth per release, with the command and the expected
  result for each.
- **The lab setup** used for validation: which Ubertooths, peer radios, and
  hosts are on the bench, and how they are wired. It will be written here from
  the configuration of the
  [test harness](https://github.com/SqueakyFloors/ubertooth-test-harness), so
  that it describes the bench as it actually is rather than a plan for one.
- **Validation reports** produced by the harness test runs: what was tested,
  on which hardware and firmware revision, and what the results were.

The checklist is the only one of the three in the tree so far.
