SqueakyFloors/ubertooth/TEST_PLAN.md

# Ubertooth Test Plan

Hardware required: Ubertooth One, Linux machine (Ubuntu 22.04+ preferred), a BLE device
(phone, fitness tracker, etc.) and a classic Bluetooth device for BR/EDR tests.
A second Ubertooth One for the range test (2i) and for the board-selection
checks (2a-1, 5b).

---

## 1. Build Verification

The clean build itself is CI's work: the `host` job builds the tools and runs
the unit tests on Ubuntu 22.04, Ubuntu 24.04, and macOS 26 on every change,
and the scheduled and release runs add macOS 14, macOS 15, and
`ubuntu-latest`; container jobs cover Ubuntu 20.04 and Fedora. What the steps
below add is the install side, which no job exercises: the staged and
installed Python launchers, and a source tree and a system Python that must
not be written to.

### 1a. Clean build on Ubuntu 22.04
- [ ] Clone repo fresh on Ubuntu 22.04
- [ ] Install dependencies: the Debian and Ubuntu `apt` line in
      [the build guide](docs/source/build_guide.rst), which is the list kept
      up to date
- [ ] Build libbtbb from the pinned fork commit (see the same guide)
- [ ] Run `cmake .. && make` in `host/build/`
- [ ] Confirm: no errors, no warnings about CMake version (the tree asks for
      the range 3.5 to 3.27)
- [ ] Confirm: `ubertooth-util` binary exists in build output, under
      `ubertooth-tools/src/`
- [ ] Install to a temporary `CMAKE_INSTALL_PREFIX`; with `PYTHONPATH` unset,
      confirm the installed `ubertooth-specan-ui --help` and
      `ubertooth-btbr -h` reach their normal usage output (no import error)

### 1b. Clean build on Ubuntu 24.04
- [ ] Same steps as 1a on Ubuntu 24.04
- [ ] Confirm: Python installation does not modify the source tree or system
      Python outside `CMAKE_INSTALL_PREFIX`
- [ ] Confirm: a `DESTDIR` install stages modules and launchers under
      `DESTDIR + CMAKE_INSTALL_PREFIX`, and staged launchers run without
      `PYTHONPATH`

### 1c. Clean build on macOS (Homebrew)
- [ ] `brew install cmake libusb pkg-config`
- [ ] Build libbtbb with local prefix
- [ ] Build host tools
- [ ] Confirm: binaries run (even without a device attached — `error: no
      Ubertooth devices found` is the expected refusal)

---

## 2. Basic Device Communication

*Requires: Ubertooth plugged in via USB*

### 2a. Firmware version check
- [ ] Run `ubertooth-util -v`
- [ ] Confirm: returns `Firmware version: <image> <revision> (API:1.58)` (firmware
      built from this tree; a release build of the host tools refuses any other
      API version and a development build warns about it, and a board whose
      firmware has no info block shows the revision without an image name)
- [ ] Confirm: no `is in use by another program` or `claiming the USB
      interface` errors
- [ ] Confirm: no timeout errors

### 2a-1. Choosing a board, and choosing none
*Requires: two or more Ubertooths attached*
- [ ] Run `ubertooth-util -S` with no `-U`
- [ ] Confirm: it exits 1 with one `error: multiple Ubertooth devices found;
      select one with -U <index|serial>` on standard error, then a
      `  Device <n>: <serial>` line per board, nothing on standard output, and
      no further line after the list
- [ ] Run `ubertooth-util -U 99 -s`
- [ ] Confirm: `error: no Ubertooth at index 99 (<n> attached)` and the line
      about indexes shifting, and nothing after them
- [ ] Run `ubertooth-util -U ffffffffffffffff -s`
- [ ] Confirm: `error: no Ubertooth found with serial matching
      'ffffffffffffffff'`
- [ ] Unplug every board and run `ubertooth-util -s`
- [ ] Confirm: `error: no Ubertooth devices found`, exit 1

### 2b. The version answer
- [ ] Run `ubertooth-util -V`
- [ ] Confirm: four lines -- `Host tools version:`, `libbtbb loaded from:`,
      `Firmware version:` and `Firmware build:` -- and exit 0
- [ ] Run `ubertooth-util -V` with no board attached
- [ ] Confirm: the two host lines, then
      `Firmware version: no Ubertooth attached`, and exit 0

### 2c. LED test (identify)
- [ ] Run `ubertooth-util -I` (flash all LEDs)
- [ ] Confirm: the command returns at once, and the LEDs keep flashing
- [ ] Run `ubertooth-util -d` a few times while it blinks
- [ ] Confirm: the board still answers, and the values change over time
- [ ] Run `ubertooth-util -S`
- [ ] Confirm: the blink stops and all three LEDs end off (`-d` reads 0 0 0)
- [ ] Run `ubertooth-util -I` then `ubertooth-util -x`
- [ ] Confirm: identify gives way to the xmas pattern; `-S` ends that too
- [ ] Flash the `btbr` image, which this tree builds, then run
      `ubertooth-util -v`, `ubertooth-util -I` and `ubertooth-specan`
- [ ] Confirm: `-v` names `btbr` at this tree's API version, so the version
      check passes; `ubertooth-specan` is refused by image instead, with
      `error: the Ubertooth is running btbr; this tool needs bluetooth_rxtx`
      and the `note:` that flashes it; `-I` still fails on a request that
      image does not answer, because `ubertooth-util` makes no such check.
      Both on stderr with exit 1, and nothing blinks
- [ ] Flash `bluetooth_rxtx` again before the rest of the plan

### 2c-i. Firmware of another API version
Needs a board carrying an older API version. Build `bluetooth_rxtx` from an
earlier commit of this tree whose `UBERTOOTH_API_VERSION` is lower and flash
that; it has a firmware info block, so `ubertooth-dfu` takes it. An older
upstream release such as `2020-12-R1` cannot be used, because `ubertooth-dfu`
refuses an image with no info block and putting one on a board needs ISP or
JTAG.

- [ ] Run `ubertooth-util -I` with host tools configured
      `-DUBERTOOTH_RELEASE=ON` (`-I` is the one ubertooth-util option that
      checks the version; `ubertooth-rx` and the other tools all do)
- [ ] Confirm: `error: Ubertooth firmware API version ...`, the note naming the
      reflash, nothing on stdout, exit 1
- [ ] Run the same command from host tools built from the checkout, with no
      `-DUBERTOOTH_RELEASE`
- [ ] Confirm: the same line as `warning:`, the note saying the command runs
      on because this is a development build, the tool's own result after it,
      exit 0
- [ ] Run it again with `UBERTOOTH_ALLOW_API_MISMATCH=0`
- [ ] Confirm: refused, as a release build refuses it
- [ ] Run a mode the older firmware does not answer
- [ ] Confirm: `error: could not <request>: the board's firmware does not
      support it (stalled, libusb -9)` and `note: the board reports firmware
      API version ..., libubertooth ... requires ...`
- [ ] Reflash the board with this tree's `bluetooth_rxtx` before the rest of
      the plan

### 2d. Hardware info
- [ ] Run `ubertooth-util -b` (board ID)
- [ ] Run `ubertooth-util -p` (part ID)
- [ ] Run `ubertooth-util -s` (serial number)
- [ ] Confirm: all return values without errors

### 2e. Watchdog state
- [ ] Run `ubertooth-util -w` on a freshly plugged-in board
- [ ] Confirm: `Last boot cause: power-on`, the watchdog is armed, and
      0 unrequested resets
- [ ] Run `ubertooth-util -r`, wait for the board, then `-w` again
- [ ] Confirm: `Last boot cause: watchdog` (that is how the part resets) and
      the unrequested count is still 0
- [ ] Confirm: `Most stack ever used since boot:` has started again from a few
      hundred bytes — it is measured from a word written at every boot, so a
      reset loses the figure
- [ ] Reflash with `ubertooth-dfu -d <image>.dfu -r`, then `-w`
- [ ] Confirm: the unrequested count is still 0 — a flash is not a wedge
- [ ] Run `ubertooth-util -x`, leave it blinking for a minute, then `-S` and
      `-w`. This is the tightest margin in the design: xmas mode waits up to
      1600 ms between blinks against a three-second timeout, and it is one of
      the modes whose loop feeds on its own rather than by answering the host.
- [ ] Confirm: the LEDs blink for the whole minute and the unrequested count
      is still 0 — a board working normally is never reset
- [ ] Repeat with `ubertooth-util -I` (identify), which toggles every 167 ms
- [ ] Confirm: the same
- [ ] Run `ubertooth-util -w` while a capture is running (`ubertooth-rx` in
      another shell)
- [ ] Confirm: the last line names a wait of the running mode, not "servicing
      USB" — a reply is always written from the USB path, so that line would
      say nothing
- [ ] Confirm: `Radio waits that gave up since boot:` reads 0 for every count
      on a board whose radio is working, before and after a capture
- [ ] Confirm: `Capture transfer errors since power-on:` reads 0 on a board
      whose radio is working, before and after a capture, and that no
      `Last processor fault:` line is printed — a board that has faulted
      names the fault's status register and the address it refused
- [ ] Confirm: `Most stack ever used since boot:` names a figure well under
      the size beside it, after a capture and after each mode above. An image
      anywhere near its size has a stack problem, whatever else it reports
- [ ] Force an overflow on a bench board: build `bluetooth_rxtx` with
      `COMPILE_OPTS=-DSTACK_GUARD_TEST`, flash it, run `ubertooth-util -S`,
      wait for the board to come back, then `-w`
- [ ] Confirm: the board blinks a fault code, resets itself, and `-w` prints a
      `Last processor fault:` line whose address is just below the stack. Flash
      a normal image back afterwards

### 2e-1. A mode starts from the same radio state every time

- [ ] Run `ubertooth-debug -U <serial> -r %manand` on a freshly reset board
- [ ] Confirm: `%MANAND = 0xFFFF`, the chip's reset value
- [ ] Run `ubertooth-util -U <serial> -e`, then read `%manand` again
- [ ] Confirm: `0x7FFF` — the running mode's own override
- [ ] Run `ubertooth-util -U <serial> -S`, then read `%manand` again
- [ ] Confirm: `0xFFFF` again, so the next mode inherits nothing
- [ ] Run `ubertooth-specan -U <serial> -t 5` on a freshly reset board, and
      again after a `ubertooth-btle -f` capture has been started and stopped
- [ ] Confirm: both sweeps cover the same range of levels — the sweep no
      longer depends on which mode ran before it

### 2e-2. The on-chip programmer answers the host first

*This leaves the board unusable until its power is cut, so run it last on a
board you can unplug or whose hub port you can power-cycle. Run it once on
`bluetooth_rxtx` and once on `btbr`: each image defers the hand-over in its
own way.*

- [ ] Run `ubertooth-util -U <serial> -i`
- [ ] Confirm: `Entering flash programming (ISP) mode`, then
      `note: the board hands itself to its on-chip programmer and answers
      nothing else until it is power-cycled`, no `libusb -7`, and exit 0
- [ ] Wait a few seconds — the board answers until it hands over, about a
      second on `bluetooth_rxtx` — then run `ubertooth-util -U <serial> -v`
- [ ] Confirm: the board no longer answers — it is in the programmer
- [ ] Power-cycle the board, then `-v` again
- [ ] Confirm: it answers with the firmware it was running

### 2f. Bootloader refuses a read-back past the end of flash

*Needs a board whose part is smaller than 512 KiB (`ubertooth-util -p` reports
0x25011722 for the 128 KiB LPC1754) and ISP or JTAG: `ubertooth-dfu` cannot
write a bootloader.*

*Attach only this board, and run the `ubertooth-dfu` steps below without `-U`:
these steps put the board in DFU by hand first, and DFU mode exposes no serial
number, so an explicit selector looks for an application device that is not
there and the run ends at `DFU entry failed`. See
[`ubertooth-dfu(1)`](host/doc/ubertooth-dfu.md).*

- [ ] Install `firmware/bootloader/bootloader.hex` over ISP or JTAG
- [ ] Put the board in DFU and send `REQ_UPLOAD` (class request 2) with wValue
      512, which is 0x20000, the first block past a 128 KiB part
- [ ] Confirm: the request is refused and `REQ_GETSTATUS` reports status 0x08
      (`ERRADDRESS`); the board still answers `REQ_GETSTATE`
- [ ] Send `REQ_CLRSTATUS`, then run `ubertooth-dfu -u <file> -r`
- [ ] Confirm: the read-back still returns all 114688 bytes above the
      bootloader, and the board comes back running its application

### 2g. Bootloader refuses an image past the end of flash

*Same board and the same ISP or JTAG requirement as 2f. `ubertooth-dfu -d`
refuses an oversize image before it sends anything, so these steps send the
requests directly. The first step starts from the running application, so it
can select the board by serial; the last one starts from DFU, so it must not,
for the reason given in 2f.*

- [ ] First, with nothing clever: flash the application with
      `ubertooth-dfu -U <serial> -d bluetooth_rxtx.dfu -r`
- [ ] Confirm: it succeeds and `ubertooth-util -U <serial> -v` reports the
      revision just written. This is the step that matters most, because the
      bootloader now reports a failed program instead of discarding it, and
      that is the only change that affects an ordinary flash
- [ ] Put the board in DFU and send `REQ_DNLOAD` (class request 1) with a
      256-byte block and a wValue past the end of the part's flash: 512, which
      is 0x20000, on a 128 KiB part. On a larger part use its own figure, or
      that block is flash the part has and will be programmed
- [ ] Confirm: `REQ_GETSTATUS` reports status 0x08 (`ERRADDRESS`), and the
      board still answers `REQ_GETSTATE`
- [ ] Send `REQ_CLRSTATUS`, then flash the application again with
      `ubertooth-dfu -d bluetooth_rxtx.dfu -r`, with no `-U`
- [ ] Confirm: it succeeds, so the refusal left the part usable
- [ ] Not reachable on an Ubertooth: the sector probe, which only runs on a
      part the bootloader's table has no entry for. Every board shipped is
      built from a listed part

### 2g-1. An interrupted download leaves the board in DFU

*Needs a board at the bench and the same ISP or JTAG requirement as 2f, since
the half that refuses to start an application is in the bootloader. It is a
destructive test: a board that ends up elsewhere needs the entry pin bridged
(pins 1 and 3 of P4 on an Ubertooth One), so run it only on a board you can
reach.*

- [ ] Install `firmware/bootloader/bootloader.hex` over ISP or JTAG
- [ ] Flash the application with
      `ubertooth-dfu -U <serial> -d bluetooth_rxtx.dfu -r` and confirm
      `ubertooth-util -U <serial> -v` reports the revision just written
- [ ] Start the same flash again and interrupt it part way through, before its
      last row of dots: unplug the board, or kill `ubertooth-dfu`
- [ ] Power-cycle the board with the entry pin left alone
- [ ] Confirm: it comes up as the bootloader, USB ID `1d50:6003`, with the
      chasing LED pattern, and not as the application; `ubertooth-util -v`
      finds no board
- [ ] Run `ubertooth-dfu -d bluetooth_rxtx.dfu -r`, with no `-U` for the
      reason given in 2f
- [ ] Confirm: the flash succeeds and the board comes back running the
      application, so a board left this way is recovered over USB
- [ ] Repeat the interruption inside the transfer's last row of dots, which is
      the sector holding the vector table: that sector has to be written as a
      whole, so the board ends up with a vector table in front of flash that
      is only partly written
- [ ] Confirm: the same result. The record the tool writes with the vector
      table covers every byte of the image, so the bootloader finds that the
      image does not add up and waits in DFU rather than starting it

### 2g-2. A flashed board carries the vector checksum and the record

*Any board, no ISP: this is the host half of 2g-1, and a board carrying an
earlier bootloader ignores both and runs as it always did.*

- [ ] Flash with `ubertooth-dfu -U <serial> -d bluetooth_rxtx.dfu -r`, then
      read the flash back with `ubertooth-dfu -U <serial> -u <dump> -r`
- [ ] Confirm: the board comes back running the image just written, and the
      first eight words of the dump add up to zero with the word at offset
      0x1c not zero — the checksum the tool filled in
- [ ] Confirm: the dump reads `UBTIMGCK` at offset 0xe0, with flags 0x0003 at
      0xea, a length at 0xec that matches the image rounded up to whole
      256-byte blocks, its bitwise complement at 0xf0, and that many bytes of
      the dump, read as little-endian words, adding up to zero

### 2h. Flashing back off the btbr image

*Needs a board that can be reached at the bench: a run that leaves it in the
bootloader needs the entry pin or a power cycle.*

- [ ] Run `ubertooth-dfu -U <serial> -d firmware/btbr/btbr.dfu -r`
- [ ] Run `ubertooth-dfu -U <serial> -d firmware/bluetooth_rxtx/bluetooth_rxtx.dfu -r`
- [ ] Confirm: each flash exits 0, with no `DFU entry failed`; the board comes
      back and `ubertooth-util -v` reports the image and revision just
      written, `btbr` for the first and `bluetooth_rxtx` for the second
      (`-r` reads both off the board directly). The image name is what makes
      this step a real check: both images carry the same revision, so a write
      that did not take between them would pass on the revision alone
- [ ] Flash `btbr.dfu` again, start `ubertooth-btbr`, and flash
      `bluetooth_rxtx.dfu` while it is capturing
- [ ] Confirm: the same result, and the board does not stop answering

### 2i. Two-board range test ([issue #601](https://github.com/SqueakyFloors/ubertooth/issues/601))

*Needs two Ubertooth boards a short distance apart, both running `bluetooth_rxtx`
from this tree, so both are at the API version the host tools require. The
packets carry no version of their own, so the two boards need not be built from
the same revision. The exchange completes within a couple of seconds.*

- [ ] Run `ubertooth-util -U <repeater> -e`; it keeps running until
      `ubertooth-util -U <repeater> -S` stops it
- [ ] Run `ubertooth-util -U <sender> -n`
- [ ] Confirm: it prints a level in each direction and exits 0 — not
      `error: invalid range test: mismatch on byte <n>`. Close together, the
      lowest level gets through first try both ways. It also prints a
      `waiting for the repeater... (<n> s)` line for each second the exchange
      is still running, which with the boards side by side is usually none at
      all: a repeater in range answers inside the first second.

      standard error:  Starting range test

      standard output: request PA level : 0
                       request number   : 0
                       reply PA level   : 0
                       reply number     : 0

- [ ] Run `ubertooth-util -U <sender> -m`
- [ ] Confirm: the same four lines, read back from the board
- [ ] Weaken the link — move the boards apart, or attenuate one — and run
      `ubertooth-util -U <sender> -n > out.txt 2> err.txt`
- [ ] Confirm: `out.txt` holds the four result lines and nothing else, and any
      `waiting for the repeater... (<n> s)` line a slower exchange printed is
      in `err.txt`, under `Starting range test`
- [ ] Confirm: the levels still report, with a higher packet number than
      before: more of the sixteen packets at that level were lost before one
      got through. The level itself may rise too, since the firmware moves up
      one once all sixteen are lost. What the figures come out at depends on
      the room, so these are an example rather than values to match:

      request PA level : 0
      request number   : 15
      reply PA level   : 0
      reply number     : 4

- [ ] Reset the sender (`ubertooth-util -U <sender> -r`), wait for it to come
      back, and run `-m` on it again
- [ ] Confirm: `no range test result yet` on standard output, exit 0 — a board
      that has not completed a test since it started has no result, which is
      not a failure
- [ ] Stop the repeater (`ubertooth-util -U <repeater> -S`) and run `-n` on the
      sender with nothing answering it
- [ ] Confirm, all on standard error: a waiting line a second for nine
      seconds, then `error: no reply from the repeater within 10 s: ...; the
      range test has been stopped`, with standard output empty and exit 1.
      `-m` afterwards says
      `no range test result yet`, and the board is idle: `-w` reads
      `Now in idle mode`
- [ ] Run `ubertooth-util -U <sender> -n 3` with nothing answering
- [ ] Confirm: the same, after three seconds, with `within 3 s` in the message
- [ ] Run `ubertooth-util -U <sender> -n 0` with nothing answering, let it
      print a few waiting lines, and stop it with Ctrl+C
- [ ] Confirm: `-n 0` waits with no deadline, and the interrupt ends the run
      with `error: interrupted before the range test finished; the range test
      has been stopped` and exit 1, leaving the board idle: `-w` reads
      `Now in idle mode`
- [ ] Swap the two roles — `-e` on the board that was the sender, `-n` on the
      other — and confirm the first two results again, so each board is seen
      transmitting

### 2j. Flashing with the bootloader entry pin still bridged ([issue #304](https://github.com/SqueakyFloors/ubertooth/issues/304))

*Needs a board at the bench: the entry pin has to be bridged by hand, and the
board is left in the bootloader at the end. Nothing here can wedge it; it comes
back by unplugging it with the bridge removed.*

*The bridge goes on while the board is already up and running its application,
not before it is plugged in. The pin is only sampled at reset, so the flash
below still starts normally and the reset at the end of it is the one that
lands in the bootloader. Fitting the bridge first would leave the board in DFU
with no application to open, and `-U <serial>` never adopts a device that was
already in DFU, so the run would end at `DFU entry failed` instead.*

- [ ] With the board plugged in and running its application, bridge pins 1 and
      3 of the expansion header (P4)
- [ ] Leave the bridge fitted and run
      `ubertooth-dfu -U <serial> -d firmware/bluetooth_rxtx/bluetooth_rxtx.dfu -r`
- [ ] Confirm: it exits 1 with
      `error: detach failed: the board reset and came back in the bootloader`,
      then the `note:` lines saying the firmware was written, naming the
      bootloader's three entry conditions, and telling you to remove the
      bridge. The note about an interrupted download is not among them,
      because this run wrote a whole image.
      No bare libusb status line in front of them, and no second copy of the
      failure from cleanup
- [ ] Unplug the board, remove the bridge, plug it back in, and run
      `ubertooth-util -U <serial> -v`
- [ ] Confirm: it reports the image and revision that were written, so the
      flash the command reported as failed had in fact reached the flash

---

## 3. BLE Sniffing (tests the cherry-picked CRC fix, [upstream #550](https://github.com/greatscottgadgets/ubertooth/pull/550))

*Requires: a BLE advertising device nearby (phone with BT on is sufficient)*

### 3a. Basic BLE advertising capture
- [ ] Run `ubertooth-btle -f` for 10 seconds, Ctrl+C
- [ ] Confirm: packets are captured (non-zero output)
- [ ] Confirm: no hangs or crashes

### 3b. CRC verification mode
- [ ] Run `ubertooth-btle -k1 -f` for 10 seconds
- [ ] Confirm: fewer packets than without `-k1` (bad-CRC packets are now filtered)
- [ ] Confirm: no crash
- [ ] Compare packet count with and without `-k1` — `-k1` should be equal or fewer

### 3b-2. CRC verification on a followed connection
*Requires: a BLE central and peripheral that connect and keep exchanging data
(two scripted nRF52840 DKs, or a phone and any peripheral it talks to)*
- [ ] Run `ubertooth-btle -f -k1 -c follow.pcap` and let the pair connect while
      it listens
- [ ] Confirm: the capture shows the CONNECT_REQ and then data-channel packets
      for as long as the connection lasts
- [ ] Confirm: the capture does not stop at the CONNECT_REQ. It did until
      [#657](https://github.com/SqueakyFloors/ubertooth/issues/657): the
      connection's CRC starting value was reversed over 32 bits instead of 24,
      so every data packet failed verification and was dropped. Section 3b
      cannot catch that, because dropping everything is also "fewer"

### 3c. BLE PCAP capture
- [ ] Run `ubertooth-btle -f -c capture.pcap` for 10 seconds
- [ ] Confirm: `capture.pcap` file is created and non-empty
- [ ] Open in Wireshark and confirm valid BLE packets visible
- [ ] Confirm: in each packet's PPI header the average RSSI sits between the
      minimum and the maximum of the same packet

### 3d. Data Length Extension packet capture
*Requires: a DLE-capable BLE central and peripheral (recommended: two scripted
nRF52840 DKs) plus one Ubertooth.*
- [ ] Have the endpoints negotiate DLE and send deterministic 100-byte and
      251-byte data-channel payloads
- [ ] Run `ubertooth-btle -f -r long-packets.pcapng` before establishing the
      connection, so the CONNECT_IND and subsequent data-channel traffic are
      captured
- [ ] Confirm: PCAPNG contains complete packets over 50 bytes, including the
      expected payload pattern and CRC (no truncation)
- [ ] Confirm: short/legacy advertising packets remain unchanged
- [ ] Repeat with `ubertooth-btle -p -r long-packets-promisc.pcapng`, the
      other capture path in the firmware and the one whose long-packet
      handling is covered only by unit tests. `-p` cannot be pointed at a
      connection: leave it running on the established connection and wait
      while it works the connection out, reporting each parameter as it goes.
      Allow a minute or two.
- [ ] Confirm: the access address is reported, as the first of the four
      parameters and before the CRC init value, and matches the one the
      capture's packets carry
- [ ] Confirm: the packets of that connection which land on the channel the
      board is holding are recorded whole, 251-byte payloads included
- [ ] Confirm: with the nRF52840 DKs as the endpoints, which negotiate channel
      selection algorithm 2, the run reports the access address and then no
      interval and no increment, and never follows. That is the documented
      limit of `-p`, not a failure of this step; see ubertooth-btle(1). Raise
      the squelch while the board is idle first (`ubertooth-util -z-60`, which
      gates only the discovery pass): at the default -120 dBm candidate
      addresses from ambient traffic crowd the search and the run may not get
      as far as the CRC init value.
- [ ] Confirm, only with endpoints that hop with algorithm 1, which the DKs
      cannot be made to do: the hop interval is the connection's own, within a
      1.25 ms unit of what the peer says it negotiated, and the same complete
      payloads arrive once the capture is following. The interval is worked
      out from several returns to one channel in a row, so allow ten seconds
      or more after the CRC init value. A figure that disagrees with the
      peer's is a failure.

### 3e. Promiscuous mode finds its own access address

*Needs a BLE connection that stays up, and a board reset (`ubertooth-util -r`)
before the first step so nothing is carried over.*

- [ ] Run `ubertooth-btle -t <peer BD ADDR> -p`
- [ ] Confirm: `error: -t does not go with -p: promiscuous mode has no device
      address to match a target against`, exit status 1, nothing on standard
      output. The same for `-t none -p`.
- [ ] Run `ubertooth-btle -f -t <peer BD ADDR>` for half a minute, stop it,
      then run `ubertooth-btle -p`
- [ ] Confirm: `-p` reports the connection's own access address and the
      CRCInit, and captures its packets. The target left on the board must not
      send it to `8e89bed6`, where it would capture nothing.
- [ ] Run `ubertooth-btle -a <that access address>`, then `ubertooth-btle -p`
- [ ] Confirm: it takes that address at once, with no discovery pass, and
      every packet it reports carries it
- [ ] With that `-p` still running, drop the connection for a minute and
      bring it back up
- [ ] Confirm: it goes back to discovering and finds the new connection's
      access address. No packet is reported on `8e89bed6`.

---

## 4. Spectrum analyzer, LED specan, and board state between modes

4b is the one step in this section that exercises the specan_ui Python fixes.
The rest are the command-line sweep, the LED threshold, and what state a board
is left in when a mode stops.

### 4a. CLI spectrum analyzer
- [ ] Run `ubertooth-specan > sweep.bin`, or `ubertooth-specan -g` to read it
      at a terminal: without `-g` or `-G` the samples are raw 3-byte records,
      and a terminal on standard output is refused with
      `error: stdout is a tty, refusing to write binary samples to it`
- [ ] Confirm: it starts and reports no error
- [ ] Confirm: the file grows, or the `-g` lines arrive

### 4a-1. A sweep that cannot be written
*Linux only: `/dev/full` stands in for a full disk*
- [ ] Run `ubertooth-specan -U <serial> -l 2402 -u 2410 -v -d /dev/full`, then
      the same with `-g` and with `-G`
- [ ] Confirm: each ends within a second, exits 1, and says
      `error: writing samples failed: ...` once -- `wrote <n> of 3 bytes` for the
      raw form, `could not write the sample` for `-g` and `-G`, both naming
      `No space left on device`. A run that swept for seconds before reporting
      `could not flush the samples` is the fault to report
- [ ] Run the same three into a file on a disk with room
- [ ] Confirm: each exits 0 on Ctrl-C and the file holds the samples, as text
      for `-g`/`-G` and as 3-byte records without them

### 4b. Spectrum analyzer UI
- [ ] Run `ubertooth-specan-ui`
- [ ] Confirm: GUI launches without `ModuleNotFoundError: No module named 'specan'`
- [ ] Confirm: spectrum data displayed
- [ ] The rest of what only a person at a desktop can judge — the window, the
      waterfall, the controls — is section 10's
      [manual test](https://github.com/SqueakyFloors/ubertooth/issues/952)

### 4c. LED spectrum analyzer threshold
- [ ] Run `ubertooth-util -q 120`, then `ubertooth-util -d` a few times
- [ ] Confirm: LEDs light (ambient noise is above -120 dBm)
- [ ] Run bare `ubertooth-util -q` (-85 dBm)
- [ ] Confirm: an LED lights only with Wi-Fi traffic on its channel (TX: 1, RX: 6, USR: 11)
- [ ] Run `ubertooth-util -q 20`
- [ ] Confirm: LEDs stay off (-20 dBm is far above ambient signals)
- [ ] Run `ubertooth-util -q 19` and `-q 121`
- [ ] Confirm: each is refused (exit 1)
- [ ] Run `ubertooth-util -S`

### 4d. Stopping a mode resets the board
- [ ] Run `ubertooth-util -c2470 -z-60`, then `-q 120`, then `-S`
- [ ] Run `ubertooth-util -d -C -z -a`
- [ ] Confirm: LEDs 0 0 0, channel 2441 MHz, squelch -120, PA level unchanged
- [ ] Repeat with `ubertooth-specan` stopped by Ctrl+C, then `-d -C -z`
- [ ] Repeat with `ubertooth-btle -s22:44:66:88:aa:cc` (faux peripheral, transmits)
      stopped by Ctrl+C, then `-d -C -z`
- [ ] Repeat with `ubertooth-btle -p` stopped by Ctrl+C, then `-d -C -z`
      (this one already reset before the fix; it must still do so)
- [ ] Confirm: the same idle state each time

### 4e. Control requests while a mode runs
- [ ] Run `ubertooth-util -q 120`, then `ubertooth-util -d`, `-C` and `-z`
      300 times each, 0.1 s apart, recording the exit status of each
- [ ] Confirm: every read succeeds; no stalled transfer (`-9`), no timeout
      (`-7`), and every `-d` reports all three LEDs
- [ ] Run `ubertooth-util -S`

### 4f. Two mode requests in a row
- [ ] Run `ubertooth-util -c2470 -z-60`, then `-q 120` and `-x` with no `-S`
      between them, then `ubertooth-util -d -C -z`
- [ ] Confirm: channel 2441 MHz and squelch -120, so leaving `-q` reset the
      board before xmas started
- [ ] Repeat the other way round (`-x` then `-q 120`), then `-S`, then
      `-d -C -z`
- [ ] Confirm: LEDs 0 0 0, channel 2441 MHz, squelch -120

### 4g. A new capture holds only its own packets
- [ ] Run `ubertooth-btle -n -A37` for about 3 s and stop it with Ctrl+C
- [ ] Run `ubertooth-util -S`
- [ ] Run `ubertooth-dump -d dump.bin` for about 2 s and stop it with Ctrl+C
- [ ] Read byte 4 (`pkt_type`) of each record in `dump.bin`. A record is 68
      bytes: a four-byte big-endian host timestamp, then the 64 bytes the
      board sent
- [ ] Confirm: every record is 0 (`BR_PACKET`) — no 1 (`LE_PACKET`) left by
      the BLE capture, and no 3 (`KEEP_ALIVE`), which the dump drops before
      writing anything so that no record in the file has packet fields
      nothing ever set
- [ ] Repeat about ten times: it used to show two `LE_PACKET` records at the
      head roughly one run in three

### 4h. Modes still start after repeated starts and stops
- [ ] Five times in a row: run `ubertooth-btle -n` for about 3 s, Ctrl+C, then
      `ubertooth-util -S`
- [ ] Five times in a row: run `ubertooth-specan -d - > sweep.bin` for about
      3 s, Ctrl+C, then `ubertooth-util -S`. The redirect is needed: raw
      samples to a terminal are refused, as 4a says
- [ ] Confirm: every run produces data, and `ubertooth-util -v` still answers
      after the last one
- [ ] Why: the firmware's waits on the radio give up after a bound rather than
      waiting forever, so a bound set too low would show here as a mode that
      starts but produces nothing

---

## 5. Classic Bluetooth / BR/EDR (tests the cherry-picked paging improvement, [upstream #540](https://github.com/greatscottgadgets/ubertooth/pull/540))

*Requires: a classic BT device (not BLE-only)*

### 5a. Basic BR/EDR capture
- [ ] Run `ubertooth-rx` for 10 seconds
- [ ] Confirm: no crash, some output
- [ ] Look at the `s=` and `n=` columns: `s=` is the packet's own power and
      `n=` the board's estimate of the background on that channel, with `snr=`
      the difference. `n=none snr=none` is normal, on any record whose channel
      the board has not heard both loud and quiet lately. The fault to report is
      `n=` sitting at one value across hundreds of records on many channels, or
      every record reading `n=none` over a capture long enough to visit many
      channels

### 5b. Paging
*Requires: the board carrying the `btbr` image*
- [ ] Run `ubertooth-btbr -U <serial>`, then `page <BD_ADDR>` at its prompt
      against a known classic BT device. The command line takes no address;
      the target is a prompt command (see
      [`ubertooth-btbr(1)`](host/doc/ubertooth-btbr.md))
- [ ] Confirm: with two boards attached and no `-U`, the tool lists both and
      opens neither (`error: multiple Ubertooth devices found; select one
      with -U <index|serial>`)
- [ ] Confirm: the `bt> ` prompt appears within a couple of seconds
- [ ] Confirm: packets captured after paging completes
- [ ] Confirm: on a board carrying `bluetooth_rxtx` instead, the tool exits 1
      within a few seconds with `error: could not set up Ubertooth <serial>: `
      and a reason, naming the board it was given, and a
      `note: ` naming that firmware and the image to flash, rather than waiting
      on the board
- [ ] Confirm: Ctrl-C before the `bt>` prompt appears ends the tool with exit
      status 1
- [ ] Confirm: Ctrl-C with a command running returns to the `bt>` prompt, and
      `q` then exits

### 5c. AFH channel map detection ([issue #238](https://github.com/SqueakyFloors/ubertooth/issues/238))
*Requires: two classic BT devices with an active connection, for example audio
streaming, so the piconet is transmitting throughout*
- [ ] Find the piconet's LAP and UAP with `ubertooth-rx`
- [ ] Run `ubertooth-afh -l <lap> -u <uap> -t 30`
- [ ] Confirm: the detection phase prints a map that fills in across many
      different channels, and the monitor phase that follows holds it — the
      board is hopping, not parked on one channel (parked, only one channel
      number can ever appear, and the map holds one bit)
- [ ] Run `ubertooth-afh -l <lap> -u <uap> -r -m 30` and confirm the
      once-a-second binary map has bits in different places over successive
      lines, not a single 1 in the same place every time (individual bits
      coming and going is expected here: `-m 30` drops a channel far sooner
      than the default of 800, see
      [#194](https://github.com/SqueakyFloors/ubertooth/issues/194))
- [ ] Interrupt each run with Ctrl-C, confirm exit status 0, then confirm
      `ubertooth-util -d -C -z` reports LEDs 0 0 0, channel 2441 MHz,
      squelch -120

### 5d. What a board carries over between runs ([issue #261](https://github.com/SqueakyFloors/ubertooth/issues/261), [issue #312](https://github.com/SqueakyFloors/ubertooth/issues/312))
*Requires: the same active piconet as 5c. The channel a mode is on is sampled
with `ubertooth-util -c`, which answers while a capture runs: a few dozen reads
in a row show whether the board is hopping and over which channels.*
- [ ] Run `ubertooth-afh -l <lap> -u <uap> -t 20` and let it find a map with
      clearly fewer than 79 channels, then interrupt it (Ctrl-C)
- [ ] Start `ubertooth-rx -l <lap> -u <uap>`, sample the channel a few dozen
      times while it runs, and confirm: the channels seen cover the whole band,
      including ones the map above had marked unused — the map did not carry
      over
- [ ] Repeat with the `ubertooth-afh` run killed rather than interrupted
      (`kill -9`, so no stop reaches the board and it is left streaming), and
      confirm the same: the capture that follows does not inherit the killed
      run's hopping. `ubertooth-util -S` puts such a board back to idle
- [ ] With no mode running, confirm `ubertooth-util -C 10` then
      `ubertooth-util -c` still reads `2412 MHz` back, and that a mode started
      afterwards runs on it: a channel set on its own is kept, and the next mode
      starts on it unless that tool sets a channel of its own

---

## 6. RSSI (tests the cherry-picked channel bounds, [upstream #481](https://github.com/greatscottgadgets/ubertooth/pull/481))

- [ ] Run `ubertooth-btle -f` and observe RSSI values in output
- [ ] Confirm: RSSI values are in a plausible range (-100 to 0 dBm)
- [ ] Confirm: no out-of-bounds channel values in RSSI output

---

## 7. Scapy Integration (tests the cherry-picked `PcapReader` update, [upstream #519](https://github.com/greatscottgadgets/ubertooth/pull/519))

*Requires: Python scapy installed (`pip3 install scapy`)*

This change is in a documented recipe rather than in a script the package
ships: see "Capturing BLE in Scapy" in
[Capturing BLE with Wireshark](docs/source/capturing_BLE_Wireshark.rst).

- [ ] Capture to a PCAP file with `ubertooth-btle -n -c /tmp/bluesCap`
- [ ] Read it back with the recipe's `PcapReader`, as the page gives it
- [ ] Confirm: the packets are read, and Scapy prints no deprecation warning
- [ ] Confirm: reading the same handle again after a pause returns the packets
      that arrived in between, which is what `PcapReader` is there for

---

## 8. Stress / Stability

### 8a. Long-running BLE capture (tests the reported memory leaks, [upstream #542](https://github.com/greatscottgadgets/ubertooth/issues/542) and [upstream #543](https://github.com/greatscottgadgets/ubertooth/issues/543))
- [ ] Run `ubertooth-btle -f` for 30 minutes
- [ ] Monitor memory usage: `watch -n 5 'ps aux | grep ubertooth'`
- [ ] Confirm: RSS memory does not grow unboundedly
- [ ] Note: if memory grows consistently, memory leaks are NOT fixed yet

### 8b. Device reconnection
- [ ] Start `ubertooth-btle -f`
- [ ] Unplug and replug Ubertooth
- [ ] Confirm: tool detects disconnect and exits cleanly (rather than hanging)

### 8c. Recovering a board that answers nothing ([issue #731](https://github.com/SqueakyFloors/ubertooth/issues/731), [issue #239](https://github.com/SqueakyFloors/ubertooth/issues/239))
A board that stops answering control requests is reached by killing a capture
mid-stream; about one run in ten does it, so this may take several tries.
- [ ] Run `ubertooth-btle -U <serial> -n`, kill it with `SIGKILL` after a few
      seconds, then run `ubertooth-util -U <serial> -v`
- [ ] Repeat until the version read fails with `1 attached Ubertooth device did
      not answer the serial read`
- [ ] Run `ubertooth-util -U <index> -r` on that board, by index: its serial
      cannot be read, so it cannot be selected by serial
- [ ] Confirm: `Ubertooth device <index> is not answering; resetting its USB
      connection`, then the reset, and `-r` exits 0
- [ ] Run `ubertooth-util -U <serial> -v`, `-b` and a capture
      (`ubertooth-rx -U <serial> -l <LAP> -u <UAP> -t 20`)
- [ ] Confirm: the board answers again and captures, with no re-plug and no
      hub port power cycle

---

## 9. Features once deferred, now in main

Both are in `main`, and no branch is waiting to be tried.

### Selecting a board by index or serial
Every tool's `-U` takes a USB enumeration index or a serial number, which is
how the rest of this plan addresses a board. 2a-1 covers the choice and each
refusal, and the host test suite pins those messages, so nothing extra is
needed here.

### Capture to standard output, [upstream #362](https://github.com/greatscottgadgets/ubertooth/pull/362)
`ubertooth-btle -q -` and `-c -` write PCAP to standard output, so
`ubertooth-btle -f -c - | wireshark -k -i -` works; everything else the tool
says goes to standard error. PCAPNG has no such form: `-r -` is refused with a
line naming the two options that do. The `host` CI job checks on every change
that standard output stays byte-for-byte empty on that path when no board is
found, so what is left to try on hardware is that a live capture reaches
Wireshark.

---

## 10. Manual tests

Checks that only a person can do: they need a graphical application, a
judgment about what appeared on screen, or hands on the hardware, so neither
the host test suite nor the test harness can run them. Each one is tracked as
an issue labeled
[`manual test`](https://github.com/SqueakyFloors/ubertooth/issues?q=label%3A%22manual+test%22),
which carries the setup, the boxes to tick and where to report the result.
Close the issue when every box is ticked, and file a bug for anything that
fails.

- [The Wireshark plugin in the Wireshark GUI](https://github.com/SqueakyFloors/ubertooth/issues/892)
  — `btle-extcap.py` driven from Wireshark itself: the interface
  appears with the board's serial, the options dialog opens, a capture runs
  and stops cleanly, a capture filter is refused in the capture-filter box,
  a real failure is reported, and a second capture works without restarting
  Wireshark. The automated tests drive the plugin the way Wireshark does and
  the harness checks it with `tshark`, but nothing exercises the GUI.
  See [Using Ubertooth with Wireshark](docs/source/using_ubertooth_with_wireshark.rst)
  for the install and capture steps.
- [The `ubertooth-specan-ui` window on a real desktop](https://github.com/SqueakyFloors/ubertooth/issues/952)
  — the live plot, the keys and the on-screen key help, `--wifi 14` at
  2484 MHz, and exit status 0 on quitting from the window. The unit tests and
  4b above cover the launcher and the module import; a plot that draws wrongly
  or a window that never appears would pass both.

The same label also carries jobs for a person that are not checks of the
tools: photographing the board for the hardware docs
([#915](https://github.com/SqueakyFloors/ubertooth/issues/915)) and exporting
the Ubertooth One schematic to PDF from the KiCad application
([#1092](https://github.com/SqueakyFloors/ubertooth/issues/1092)).

---

## Notes

- The host `ctest` suite needs no Ubertooth, and the tests that run the tools
  do not open one, so the suite can run while boards are in use. Those tests
  set `UBERTOOTH_TEST_NO_DEVICES=1`, which makes device selection behave as if
  nothing were attached; nothing else sets it, so normal use is unaffected.
  Every check in this plan needs a real board unless it says otherwise.
- Tests 3b, 5b, 6 directly exercise the cherry-picked fixes — these are the most important to run
- Memory leak tests (8a) require extended time but are important for production use
- Document any unexpected behavior as a new issue in the repo
