SqueakyFloors/ubertooth/hardware/ubertooth-one/ubertooth-one-schematic.pdf

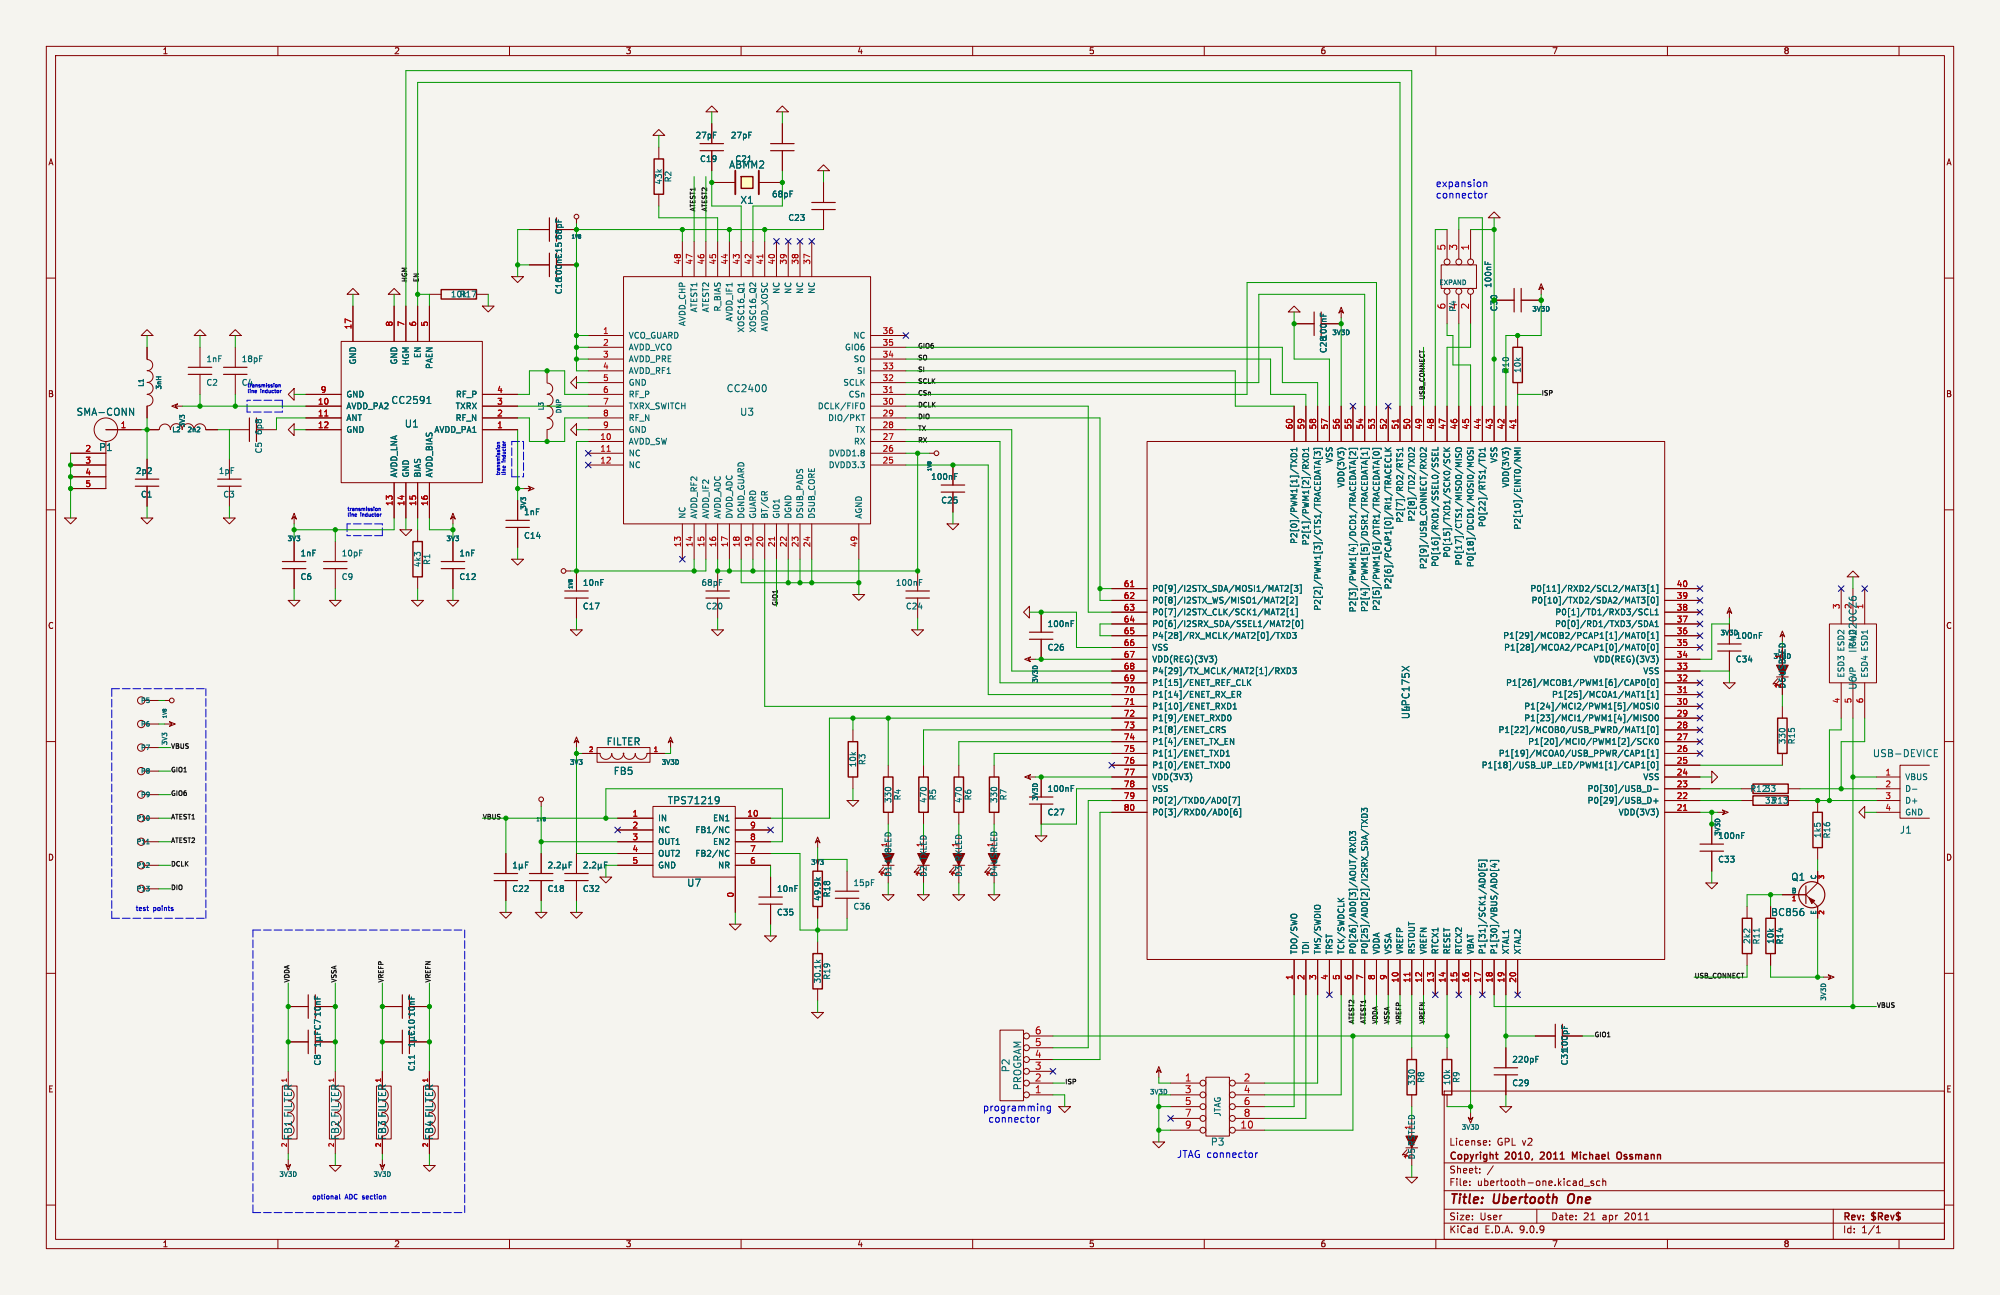
[picture p8: page 1]

8 GND 17 GND 12 ANT 11 AVDD_PA2 10 GND 9 U1 CC2591

8 GND 17 GND 12 ANT 11 AVDD_PA2 10 GND 9

connector transmission line inductor

9 VREFP 10 RSTOUT 11 VREFN 12 RTCX1 13 RESET 14 RTCX2 15 VBAT 16 P1[31]/SCK1/AD0[5] 17 P1[30]/VBUS/AD0[4] 18 XTAL1 19 XTAL2 20

Id: 1/1 Title: Ubertooth One
