SqueakyFloors/ubertooth/firmware/bluetooth_rxtx/bluetooth_rxtx.c

/*
 * Copyright 2010-2013 Michael Ossmann
 * Copyright 2011-2013 Dominic Spill
 *
 * This file is part of Project Ubertooth.
 *
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
 * You should have received a copy of the GNU General Public License
 * along with this program; see the file COPYING.  If not, write to
 * the Free Software Foundation, Inc., 51 Franklin Street,
 * Boston, MA 02110-1301, USA.
 */

#include <stddef.h>
#include <string.h>

#include "version.h"
#include "ubertooth.h"
#include "ubertooth_usb.h"
#include "ubertooth_interface.h"
#include "ubertooth_rssi.h"
#include "ubertooth_cs.h"
#include "ubertooth_dma.h"
#include "ubertooth_clock.h"
#include "bluetooth.h"
#include "bluetooth_le.h"
#include "cc2400_rangetest.h"
#include "cc2400_wait.h"
#include "ego.h"
#include "rx_fifo_lead.h"
#include "debug_uart.h"
#include "xmas.h"
#include "identify.h"
#include "watchdog.h"
#include "bl_report.h"

#define MIN(x,y)	((x)<(y)?(x):(y))
#define MAX(x,y)	((x)>(y)?(x):(y))

#ifdef STACK_GUARD_TEST
/*
 * A stack overflow on demand, so the guard at the bottom of the stack can be
 * shown to catch one. No shipped image defines STACK_GUARD_TEST.
 * UBERTOOTH_STOP is the trigger because every tool sends it as it exits.
 *
 * Every word of each frame is written, so the descent cannot step over the
 * 32-byte guard, and the recursive call goes through a volatile pointer: at
 * -Os the compiler otherwise turns plain self-recursion into a loop over one
 * frame and the stack never grows.
 */
static volatile uint8_t overflow_the_stack_now = 0;

static unsigned long overflow_the_stack(unsigned long depth);
static unsigned long (*volatile overflow_next)(unsigned long) =
	overflow_the_stack;

static __attribute__((noinline)) unsigned long
overflow_the_stack(unsigned long depth)
{
	volatile unsigned long frame[8];
	unsigned i;

	for (i = 0; i < 8; i++)
		frame[i] = depth;
	return frame[depth & 7] + overflow_next(depth + 1);
}
#endif

/*
 * The build string reported by UBERTOOTH_GET_COMPILE_INFO, which is the date
 * this image was built. Keep it identical to the one in
 * btbr/src/btctl/vendor_request_handler.c. The image name and version a host
 * matches against are in the firmware info block (../common/fw_info.c), not
 * here, and who built it is in neither: an image is handed around, so a
 * builder's user and host names say nothing a reader of it needs.
 */
const char compile_info[] = TIMESTAMP;

/* hopping stuff */
volatile uint8_t  hop_mode = HOP_NONE;
volatile uint8_t  do_hop = 0;                  // set by timer interrupt
volatile uint16_t channel = 2441;
volatile uint16_t hop_direct_channel = 0;      // for hopping directly to a channel
volatile uint16_t hop_timeout = 158;
volatile uint16_t requested_channel = 0;
volatile uint16_t le_adv_channel = BT_FREQ_MIN;
volatile int      cancel_follow = 0;

/* bulk USB stuff */
volatile uint8_t  idle_buf_clkn_high = 0;
volatile uint32_t idle_buf_clk100ns = 0;
volatile uint16_t idle_buf_channel = 0;
volatile uint8_t  dma_discard = 0;
volatile uint8_t  status = 0;

/* operation mode */
volatile uint8_t mode = MODE_IDLE;
volatile uint8_t requested_mode = MODE_IDLE;
volatile uint8_t jam_mode = JAM_NONE;
volatile uint8_t ego_mode = EGO_FOLLOW;
/* Set by UBERTOOTH_EGO, read and cleared by ego_main(): a mode start for the
 * running E-GO loop, which the mode dispatch never sees. */
volatile uint8_t ego_restart = 0;

volatile uint8_t modulation = MOD_BT_BASIC_RATE;

/* specan stuff */
volatile uint16_t low_freq = 2400;
volatile uint16_t high_freq = 2483;
/* raw-scale LED specan threshold; 16-bit so the host's whole -q range fits
 * (see ubertooth_rssi.h) */
volatile int16_t rssi_threshold = -30;  // -54dBm - 30 = -84dBm

/* Generic TX stuff */
generic_tx_packet tx_pkt;

/*
 * How many times to send tx_pkt, from the request's wValue.
 *
 * One request per packet cannot keep up: the board answers no USB request
 * while a packet is going out, about a millisecond of radio waits, so a
 * request handed over in that window fails and the packet is lost. Carrying
 * the count costs one transfer for the whole burst.
 */
volatile uint16_t tx_pkt_repeat;

/* The registers, length and level a UBERTOOTH_TX_GENERIC_PACKET request
 * carries in front of its payload. */
#define TX_GENERIC_HEADER_LEN offsetof(generic_tx_packet, data)

/* le Peripheral stuff */
uint8_t peripheral_mac_address[6] = { 0, };
/* The advertising data MODE_BT_PERIPHERAL_LE transmits, as the host set it. Sized
 * for the most a legacy ADV_IND can carry, which is all this ever sends. */
uint8_t le_adv_data[ADV_IND_MAX_DATA] = { 0x02, 0x01, 0x05 };
unsigned le_adv_len = 3;

le_state_t le = {
	.access_address = 0x8e89bed6,           // advertising channel access address
	.access_address_set = 0,                // the host has not given one
	.synch = 0x6b7d,                        // bit-reversed adv channel AA
	.syncl = 0x9171,
	.crc_init  = 0x555555,                  // advertising channel CRCInit
	.crc_init_reversed = 0xAAAAAA,
	.crc_verify = 0,

	.link_state = LINK_INACTIVE,
	.conn_epoch = 0,
	.do_follow = 1,
	.target_set = 0,
	.last_packet = 0,
};

typedef struct _le_promisc_active_aa_t {
	u32 aa;
	int count;
} le_promisc_active_aa_t;

/* How many of the gaps between one connection's returns to this channel the
 * estimator keeps. It needs two runs of a pattern to see a repeat, so this is
 * twice the longest pattern it can find: up to eight returns a trip round the
 * channels. A smaller channel map returns more often, about 37/U times for U
 * used channels, because the remapping spreads the unused positions over the
 * used ones: a map of five fills this exactly, and a smaller one returns too
 * often for the pattern to fit, so nothing is reported. */
#define LE_PROMISC_GAPS 16

typedef struct _le_promisc_state_t {
	// LFU cache of recently seen AA's
	le_promisc_active_aa_t active_aa[32];

	/* Recovering the connection interval. The mode listens on one data
	 * channel, so every gap between two sightings is a whole number of
	 * connection intervals. The spacings repeat every trip round the 37 hop
	 * positions, so the gaps are kept in arrival order and the estimator
	 * looks for the pattern they repeat. The oldest falls off the end,
	 * which is how a figure stops being reported once the connection it
	 * described has changed or gone. */
	u32 gap[LE_PROMISC_GAPS];
	u8 gap_count;
	int consec_intervals;

	/* When a packet of the connection was last seen on the channel being
	 * listened to, and whether one has been. A pass must start with no
	 * stamp: the mode's teardown stops and zeroes the capture clock, so a
	 * stamp from an earlier pass reads a clock that has since restarted and
	 * the gap computed from it belongs to nothing. */
	u32 prev_clk;
	/* The same moment on CLKN, which does not come round again for a
	 * fortnight. The capture clock does every 327 s, and a gap longer than
	 * that cannot be told from a short one without this. */
	u32 prev_clkn;
	u8 seen_a_packet;

	/* When any packet was last seen, as against prev_clk above, which is
	 * the last one taken as the start of a connection event. The two
	 * differ while an event is running, which is how a packet is told from
	 * an event -- see promisc_recover_hop_interval(). */
	u32 last_clk;

	/* The sighting on 2404 MHz that the hop increment is counted from,
	 * which is the same kind of stamp and wants the same clearing. */
	u32 first_ts;

	/* The same gaps again for the algorithm-2 search, which needs more of
	 * them: a ring of its own, because the estimator above is bounded by
	 * the pattern length its own ring can hold. sightings is how many have
	 * arrived since the last search, which gives each estimator a run of
	 * consecutive returns to work from. */
	u32 csa2_gap[LE_CSA2_SIGHTINGS - 1];
	u8 csa2_gap_count;
	u16 sightings;
} le_promisc_state_t;
le_promisc_state_t le_promisc;
#define AA_LIST_SIZE (int)(sizeof(le_promisc.active_aa) / sizeof(le_promisc_active_aa_t))

/* LE jamming */
#define JAM_COUNT_DEFAULT 40
int le_jam_count = 0;

/* set LE access address */
static void le_set_access_address(u32 aa);

/* Tell the host one parameter of the connection promiscuous mode has worked
 * out. The access address is reported by bt_le_sync(), which is further up the
 * file than this definition. */
void le_promisc_state(u8 type, void *data, unsigned len);

typedef int (*data_cb_t)(char *);
data_cb_t data_cb = NULL;

typedef void (*packet_cb_t)(u8 *);
packet_cb_t packet_cb = NULL;

/*
 * The receive buffer of a low-energy mode. The two halves of such a mode need
 * very different buffers and share one because they never run at the same
 * time: bt_generic_le() fills `symbols` and has returned before bt_le_sync(),
 * which receives whole packets into `packet`, is entered. bt_promisc_le()
 * runs the two in that order.
 *
 * It is in the other RAM bank (AHB_SRAM), which the transfer controller
 * reaches as it reaches main SRAM.
 */
static AHB_SRAM union {
	/* One byte per received symbol, two DMA buffers' worth: the previous
	 * buffer followed by the one just received, so an access address that
	 * straddles the two is still found. */
	char symbols[DMA_SIZE*8*2];
	/* One whole captured packet: the four bytes of the access address the
	 * radio synchronized on, then the PDU header, the payload and the CRC.
	 * Long enough for any payload the header's 8-bit length field can
	 * claim, so a Data Length Extension packet arrives whole. */
	uint8_t packet[LE_MAX_USB_PACKET_SIZE];
} le_rx;

/* How many bytes the radio can put after the access address: everything in
 * le_rx.packet except the four the access address takes. */
#define LE_RX_PDU_MAX (LE_MAX_USB_PACKET_SIZE - 4)

/* dma_init_le() splits what it is given into a first item of LE_DMA_HEAD
 * bytes and a second of the rest, and the controller's transfer size is a
 * 12-bit field. Both bounds are checked at compile time because the length is
 * a constant at the only call site; a size that overflowed would run into the
 * burst-size bits and mis-program the controller rather than fail. */
_Static_assert(LE_RX_PDU_MAX > LE_DMA_HEAD,
               "the low-energy receive buffer is shorter than the first DMA item");
_Static_assert(LE_RX_PDU_MAX - LE_DMA_HEAD <= 0xfff,
               "the low-energy receive buffer does not fit one DMA transfer");

static int enqueue(uint8_t type, uint8_t* buf)
{
	usb_pkt_rx* f = usb_enqueue();

	/* fail if queue is full */
	if (f == NULL) {
		status |= FIFO_OVERFLOW;
		return 0;
	}

	f->pkt_type = type;
	/* A record comes off the ring with whatever the last one left in it, so
	 * clear what the branch below may not fill in. The status bits that
	 * would make a noise figure readable stay clear with it, so a zero is
	 * not reported as a measurement. */
	f->rssi_noise = 0;
	f->reserved = 0;
	if(type == SPECAN) {
		f->clkn_high = (clkn >> 20) & 0xff;
		f->clk100ns = CLK100NS;
	} else {
		f->clkn_high = idle_buf_clkn_high;
		f->clk100ns = idle_buf_clk100ns;
		f->channel = ubertooth_channel_byte(idle_buf_channel);
		f->rssi_min = rssi_min;
		f->rssi_max = rssi_max;
		f->rssi_avg = rssi_get_signal();
		f->rssi_count = rssi_count;
		/* Only a record that carries a packet gets the power figures: a
		 * state change or a message has no packet for one to belong to. */
		if (type == BR_PACKET && rssi_count != 0) {
			status |= SIGNAL_VALID;
			if (rssi_noise_estimated()) {
				f->rssi_noise = (uint8_t) rssi_get_noise();
				status |= NOISE_ESTIMATE;
			}
		}
	}

	memcpy(f->data, buf, DMA_SIZE);

	f->status = status;
	status = 0;

	return 1;
}

int enqueue_with_ts(uint8_t type, uint8_t* buf, uint32_t ts)
{
	usb_pkt_rx* f = usb_enqueue();

	/* fail if queue is full */
	if (f == NULL) {
		status |= FIFO_OVERFLOW;
		return 0;
	}

	f->pkt_type = type;

	f->clkn_high = 0;
	f->clk100ns = ts;

	f->channel = ubertooth_channel_byte(channel);
	f->rssi_avg = 0;
	f->rssi_count = 0;
	/* This path takes no readings, so no noise figure. */
	f->rssi_noise = 0;
	f->reserved = 0;

	memcpy(f->data, buf, DMA_SIZE);

	f->status = status;
	status = 0;

	return 1;
}

/*
 * Registers one UBERTOOTH_WRITE_REGISTERS request can write, three bytes
 * each. The count arrives in a 16-bit field, so without this bound the
 * handler would walk past the buffer the data stage landed in.
 */
#define WRITE_REGISTERS_MAX (VENDOR_REQ_DATA_LEN / 3)

/*
 * The registers UBERTOOTH_READ_ALL_REGISTERS answers with: every CC2400
 * address from MAIN (0x00) through SYNCH (0x2d), the last register below the
 * command strobes, three bytes of reply each. A few addresses in that run
 * are not registers the radio documents, and are read anyway, as they always
 * have been. The filling loop and the
 * reported length both come from this one count, so the reply cannot claim
 * fewer registers than it carries.
 */
#define READ_ALL_REGISTERS_COUNT (SYNCH + 1)
#define READ_ALL_REGISTERS_LEN   (READ_ALL_REGISTERS_COUNT * 3)

/*
 * Forget the AFH channel map and the flag that says to hop on it. The map
 * belongs to the run that found it: a channel set the host narrowed down for
 * one piconet says nothing about the next capture.
 */
static void clear_afh_map(void)
{
	size_t i;

	for (i = 0; i < sizeof(afh_map); i++)
		afh_map[i] = 0;
	afh_enabled = 0;
	used_channels = 0;
}

/*
 * The three modes bt_stream_rx()'s loop keeps streaming for. A request for one
 * of them that arrives while another of them runs is absorbed by that loop and
 * never reaches the mode dispatch in main().
 */
static int streams_symbols(uint8_t m)
{
	return m == MODE_RX_SYMBOLS || m == MODE_BT_FOLLOW || m == MODE_AFH;
}

/*
 * The hopping a mode start forgets. cc2400_idle() does this for a mode start
 * that reaches the dispatch; the two callers below are the mode starts that do
 * not, so the rule holds wherever a mode starts. The channel is not part of
 * it: one set while no mode was running belongs to the mode about to start.
 */
static void forget_hop_state(void)
{
	hop_mode = HOP_NONE;
	do_hop = 0;
	hop_direct_channel = 0;
	clear_afh_map();
}

/*
 * Reset what a mode start resets, for a mode request the running symbol
 * stream absorbs. Such a request never reaches the dispatch -- the loop
 * carries on under the new mode's name -- so without this it would also carry
 * on with the previous mode's hop mode, AFH map and modulation.
 *
 * Only state a running receive can be reset under: the radio stays tuned and
 * receiving, so the channel it is on is left alone, and so are the
 * per-channel power averages, which are what the radio has been hearing
 * rather than something the mode configures. Dropping those would cost the
 * new capture the few hundred packets the filter needs to build up again.
 *
 * Call this before the request's own setup. Re-sending the mode that is
 * already streaming resets nothing, which is what keeps a follow that
 * re-syncs its clock mid-session -- it sends UBERTOOTH_START_HOPPING again --
 * from throwing away the AFH map it is following on.
 *
 * The test is against `requested_mode`, not `mode`: an absorbed request never
 * reaches the dispatch, so `mode` still names the mode that entered the loop.
 * Reading `mode` would skip the reset on a second switch back, as in follow,
 * then capture, then follow again.
 */
static void reset_absorbed_mode_state(uint8_t requested)
{
	if (requested == requested_mode || !streams_symbols(mode) ||
	    !streams_symbols(requested))
		return;

	forget_hop_state();
	modulation = MOD_BT_BASIC_RATE;
}

/* Declared here because the request handler calls it; defined with the rest of
 * the copy below, where what it drops is explained. */
static void drop_kept_settings(uint8_t requested);

/*
 * Tune to a channel, or sweep the band, as UBERTOOTH_SET_CHANNEL asks.
 *
 * A frequency above the band's top asks for the band sweep rather than for a
 * channel. Every frequency that reaches here is one the radio can tune: the
 * request handler refuses the rest, and the channel the dispatch re-applies
 * is one it already accepted.
 */
static void set_channel_request(uint16_t requested)
{
	requested_channel = requested;
	/* bluetooth band sweep mode, start at the bottom of the band */
	if (requested_channel > MAX_FREQ) {
		hop_mode = HOP_SWEEP;
		requested_channel = BT_FREQ_MIN;
	}
	/* Fixed channel mode, which can be outside the Bluetooth band: the
	 * radio tunes from MIN_FREQ to MAX_FREQ and a frequency in that range
	 * is taken as it was asked for. There is nothing to clamp -- the
	 * request handler refuses anything below MIN_FREQ, and this branch is
	 * the one at or below MAX_FREQ. */
	else {
		hop_mode = HOP_NONE;
	}

	le_adv_channel = requested_channel;
	channel = requested_channel;
	requested_channel = 0;

	/* The carrier-sense threshold follows from the channel, so set it here
	 * for whichever mode is running -- except in LE follow mode, where the
	 * low-energy engine (le_phy.c) owns the radio and reaches it over the
	 * same serial bus a write from here would use, and uses no carrier
	 * sense anyway. Whatever mode starts next sets the threshold from
	 * `channel` as it brings the radio up (cc2400_rx()). */
	if (mode != MODE_BT_FOLLOW_LE)
		cs_threshold_calc_and_set(channel);
}

/*
 * What the host stated after its mode request, kept for the mode that is
 * starting.
 *
 * A mode start resets the board's mode state -- hop mode, channel,
 * modulation, AFH map, E-GO access code -- so that one run cannot capture
 * with what another left behind. A tool therefore states its channel, band
 * sweep, modulation, or access code after the request that starts its mode.
 *
 * On a board left in a mode that captures no symbols the reset runs late: the
 * mode's loop notices the request, returns, and the dispatch in main() resets
 * on the way out, by which time the stated channel has arrived and would be
 * thrown away. So the requests that state one of these keep a copy, and the
 * dispatch applies it again after the reset.
 *
 * The copy names the mode request it followed and is only applied to that
 * mode: one left behind by a run the host has moved on from is dropped rather
 * than carried into whatever starts next, which is the carry-over the reset
 * exists to prevent.
 */
#define STATED_CHANNEL     (1 << 0)
#define STATED_ACCESS_CODE (1 << 1)
#define STATED_AFH_MAP     (1 << 2)
#define STATED_MODULATION  (1 << 3)

static volatile uint8_t  stated_what;       /* STATED_* bits, 0 for nothing */
static volatile uint8_t  stated_for_mode;   /* the mode request it followed */
static volatile uint16_t stated_channel;    /* as the host asked for it */
static volatile uint8_t  stated_modulation;
static volatile uint32_t stated_access_code;
static volatile int      stated_access_code_len;
/* The ten map bytes as the host sent them, one bit per channel. The map is
 * kept rather than the hop sequence built from it, so applying it runs the
 * same code the request ran. */
static volatile uint8_t  stated_afh_map[sizeof(afh_map)];

/*
 * Note which mode request this setting followed. A copy kept for an earlier
 * request is replaced, not added to: that request's mode is not the one
 * starting. Only the value is recorded, not the state it leaves behind, so
 * applying it again runs the same code the request ran.
 */
static void stated_for_starting_mode(uint8_t what)
{
	if (stated_for_mode != requested_mode)
		stated_what = 0;
	stated_for_mode = requested_mode;
	stated_what |= what;
}

/*
 * Apply what was stated after the request for the mode now starting.
 *
 * Called from the dispatch after the reset and before the mode's own setup,
 * which still wins.
 *
 * A copy for another mode is dropped, unless that mode is still the one the
 * host is waiting for. The dispatch reads the request once on its way in and
 * the reset takes a while, so a second tool's request and its setting can
 * both be answered in between: dropping the second tool's copy would leave
 * its capture on the reset defaults.
 */
static void apply_stated_settings(uint8_t starting_mode)
{
	uint8_t what;

	if (stated_what == 0)
		return;

	if (stated_for_mode != starting_mode) {
		/* Still pending: leave it for the mode start it was stated for.
		 * Otherwise it belongs to a run that is over. */
		if (stated_for_mode != requested_mode)
			stated_what = 0;
		return;
	}

	what = stated_what;
	stated_what = 0;

	/* A modulation is never left on an idle board: a mode starting from
	 * idle runs no reset of its own to undo it. The channel is deliberately
	 * kept across a stop, which is what `ubertooth-util -S -c 2440` asks
	 * for. */
	if (starting_mode == MODE_IDLE)
		what &= ~STATED_MODULATION;

	if (what & STATED_CHANNEL)
		set_channel_request(stated_channel);
	if (what & STATED_MODULATION)
		modulation = stated_modulation;
	if (what & STATED_ACCESS_CODE) {
		access_code = stated_access_code;
		access_code_len = stated_access_code_len;
	}
	if (what & STATED_AFH_MAP) {
		uint8_t map[sizeof(afh_map)];
		unsigned i;

		/* Copied out first, because bluetooth_set_afh_map() takes a plain
		 * pointer and the copy is volatile. */
		for (i = 0; i < sizeof(map); i++)
			map[i] = stated_afh_map[i];
		bluetooth_set_afh_map(map);
	}
}

/*
 * What the host stated *before* its mode request, kept for the mode that
 * request starts.
 *
 * Two settings are sent in that order rather than after the request: the jam
 * mode, which ubertooth-btle sends for -j, and the E-GO capture length. A
 * mode start puts both back to their defaults, so without a copy
 * `ubertooth-btle -f -j` followed the connection and never jammed. The
 * dispatch applies the copy again after the reset, as it does for the
 * settings stated after a mode request above.
 *
 * The copy names no mode, because the request that names one has not arrived
 * yet, so it reaches exactly as far as the next mode request and is dropped
 * there whether it was used or not. That drop happens in both places such a
 * request can end up: the dispatch (apply_kept_settings()), and, for a
 * request the running loop absorbs, the request itself
 * (drop_kept_settings()). An absorbed request needs no copy -- no reset runs,
 * so the value the host set is already in force.
 *
 * Nothing is kept while the board is idle: a mode starting from idle runs no
 * teardown, so the value the host just set already survives.
 */
#define KEEP_JAM_MODE   (1 << 0)
#define KEEP_CAP_LEN    (1 << 1)

static volatile uint8_t keep_what;        /* KEEP_* bits, 0 for nothing */
static volatile uint8_t keep_jam_mode;
static volatile uint8_t keep_cap_len;

/* Keep what the request has just set, for the mode start it comes before. */
static void keep_for_next_mode_start(uint8_t what)
{
	if (mode == MODE_IDLE)
		return;
	if (what & KEEP_JAM_MODE)
		keep_jam_mode = jam_mode;
	if (what & KEEP_CAP_LEN)
		keep_cap_len = packet_len;
	keep_what |= what;
}

/*
 * Put the kept E-GO capture length back, and forget it.
 *
 * Its own function because the E-GO mode start happens in two places: the
 * dispatch below, and an E-GO request a running E-GO loop absorbs, which does
 * the mode start's work -- ego_capture_reset() included -- inside the request
 * handler.
 *
 * Only this bit is cleared, where the other absorbable requests throw the
 * whole copy away, so a jam mode kept by a killed `ubertooth-btle -j`
 * survives an E-GO request. Nothing today sets both in one run.
 */
static void apply_kept_cap_len(void)
{
	if (!(keep_what & KEEP_CAP_LEN))
		return;
	keep_what &= (uint8_t)~KEEP_CAP_LEN;
	packet_len = keep_cap_len;
}

/*
 * Drop a copy for a mode request the running loop absorbs.
 *
 * No mode start follows such a request, so the live value stands on its own
 * and keeping the copy would leave it waiting for whatever mode starts next.
 */
static void drop_kept_settings(uint8_t requested)
{
	if (requested == mode)
		keep_what = 0;
}

/*
 * Put back what was stated before the mode request, and forget it. Called
 * from the dispatch after the reset and before the mode's own setup, which
 * still wins.
 *
 * A stop keeps nothing: a value left on an idle board would reach the next
 * mode whatever that mode asked for, because a mode starting from idle runs
 * no reset of its own.
 */
static void apply_kept_settings(uint8_t starting_mode)
{
	uint8_t what = keep_what;

	keep_what = 0;

	if (starting_mode == MODE_IDLE)
		return;
	if (what & KEEP_JAM_MODE)
		jam_mode = keep_jam_mode;
	if (what & KEEP_CAP_LEN)
		packet_len = keep_cap_len;
}

/*
 * Returning 0 stalls the request. `data` is the buffer the USB stack filled
 * from the request's data stage and `data_in_len` how many bytes the host
 * sent with it, so a case that reads `data` must refuse a request carrying
 * less than it reads. That keeps out both a short request and a
 * device-to-host request of the same number, which arrives with no data stage
 * and a buffer still holding the previous request's bytes. A case whose body
 * may be empty cannot tell those apart by length, and uses `data_from_host`.
 */
static int vendor_request_handler(uint8_t request, uint16_t* request_params,
                                  uint8_t* data, int data_from_host,
                                  unsigned data_in_len, int* data_len)
{
	uint32_t clock;
	size_t length; // string length
	usb_pkt_rx* p = NULL;
	uint16_t reg_val;
	/* A frequency, not a register value, and named apart from the global
	 * `channel` the receives tune, which it must not shadow. */
	uint16_t tx_channel;
	uint8_t i;
	int32_t drift_ppm;

	switch (request) {

	case UBERTOOTH_PING:
		*data_len = 0;
		break;

	case UBERTOOTH_RX_SYMBOLS:
		/* A plain symbol capture sets nothing up of its own, so this is
		 * all that keeps it from inheriting a running stream's hopping. */
		reset_absorbed_mode_state(MODE_RX_SYMBOLS);
		drop_kept_settings(MODE_RX_SYMBOLS);
		requested_mode = MODE_RX_SYMBOLS;
		*data_len = 0;
		break;

#ifdef TX_ENABLE
	case UBERTOOTH_TX_SYMBOLS:
		hop_mode = HOP_BLUETOOTH;
		requested_mode = MODE_TX_SYMBOLS;
		*data_len = 0;
		break;
#endif

	case UBERTOOTH_GET_USRLED:
		data[0] = (USRLED) ? 1 : 0;
		*data_len = 1;
		break;

	case UBERTOOTH_SET_USRLED:
		if (request_params[0])
			USRLED_SET;
		else
			USRLED_CLR;
		break;

	case UBERTOOTH_GET_RXLED:
		data[0] = (RXLED) ? 1 : 0;
		*data_len = 1;
		break;

	case UBERTOOTH_SET_RXLED:
		if (request_params[0])
			RXLED_SET;
		else
			RXLED_CLR;
		break;

	case UBERTOOTH_GET_TXLED:
		data[0] = (TXLED) ? 1 : 0;
		*data_len = 1;
		break;

	case UBERTOOTH_SET_TXLED:
		if (request_params[0])
			TXLED_SET;
		else
			TXLED_CLR;
		break;

	case UBERTOOTH_GET_1V8:
		data[0] = (CC1V8) ? 1 : 0;
		*data_len = 1;
		break;

	case UBERTOOTH_SET_1V8:
		if (request_params[0])
			CC1V8_SET;
		else
			CC1V8_CLR;
		break;

	case UBERTOOTH_GET_PARTNUM:
		get_part_num(data, data_len);
		break;

	case UBERTOOTH_RESET:
		requested_mode = MODE_RESET;
		break;

	case UBERTOOTH_GET_SERIAL:
		get_device_serial(data, data_len);
		break;

#ifdef UBERTOOTH_ONE
	case UBERTOOTH_GET_PAEN:
		data[0] = (PAEN) ? 1 : 0;
		*data_len = 1;
		break;

	case UBERTOOTH_SET_PAEN:
		if (request_params[0])
			PAEN_SET;
		else
			PAEN_CLR;
		break;

	case UBERTOOTH_GET_HGM:
		data[0] = (HGM) ? 1 : 0;
		*data_len = 1;
		break;

	case UBERTOOTH_SET_HGM:
		if (request_params[0])
			HGM_SET;
		else
			HGM_CLR;
		break;
#endif

#ifdef TX_ENABLE
	case UBERTOOTH_TX_TEST:
		requested_mode = MODE_TX_TEST;
		break;

	case UBERTOOTH_GET_PALEVEL:
		data[0] = cc2400_get(FREND) & FREND_PA_LEVEL;
		*data_len = 1;
		break;

	case UBERTOOTH_SET_PALEVEL:
		if( request_params[0] < 8 ) {
			cc2400_set(FREND, FREND_RESERVED_ONE | request_params[0]);
		} else {
			return 0;
		}
		break;

	case UBERTOOTH_RANGE_TEST:
		requested_mode = MODE_RANGE_TEST;
		break;

	case UBERTOOTH_REPEATER:
		requested_mode = MODE_REPEATER;
		break;
#endif

	case UBERTOOTH_RANGE_CHECK:
		data[0] = rr.valid;
		data[1] = rr.request_pa;
		data[2] = rr.request_num;
		data[3] = rr.reply_pa;
		data[4] = rr.reply_num;
		data[5] = rr.discarded;
		*data_len = UBERTOOTH_RANGE_RESULT_LEN;
		break;

	case UBERTOOTH_STOP:
		requested_mode = MODE_IDLE;
#ifdef STACK_GUARD_TEST
		overflow_the_stack_now = 1;
#endif
		break;

	case UBERTOOTH_GET_MOD:
		data[0] = modulation;
		*data_len = 1;
		break;

	case UBERTOOTH_SET_MOD:
		/* Only the two modulations the radio setup configures.
		 * cc2400_rx() and cc2400_rx_sync() write no modem registers for
		 * a value they do not recognize, so storing any other would
		 * leave the next capture running on whatever the previous mode
		 * left in the radio. That rules out the rest of enum
		 * modulations too: no mode implements MOD_80211_FHSS, and the
		 * one mode that wants MOD_NONE -- spectrum analysis -- sets it
		 * itself. */
		if (request_params[0] != MOD_BT_BASIC_RATE &&
		    request_params[0] != MOD_BT_LOW_ENERGY)
			return 0;
		modulation = request_params[0];
		/* Stated after the mode request, as the channel is, so a mode
		 * start still to come keeps it; see
		 * stated_for_starting_mode(). */
		if (requested_mode != mode) {
			stated_modulation = request_params[0];
			stated_for_starting_mode(STATED_MODULATION);
		}
		break;

	case UBERTOOTH_GET_CHANNEL:
		data[0] = channel & 0xFF;
		data[1] = (channel >> 8) & 0xFF;
		*data_len = 2;
		break;

	case UBERTOOTH_SET_CHANNEL:
		/* A frequency the synthesizer cannot reach is refused rather
		 * than pulled up to MIN_FREQ, which would tune a frequency
		 * nobody asked for and report success. Anything from MIN_FREQ
		 * up is kept, including the deliberately out-of-band
		 * frequencies the radio can reach; above MAX_FREQ means the
		 * band sweep, which is how the host asks for it.
		 *
		 * The check comes first, so a refused request leaves the
		 * channel and the hop mode as it found them and no mode begins
		 * on a frequency the board said it could not have.
		 */
		if (request_params[0] < MIN_FREQ)
			return 0;

		set_channel_request(request_params[0]);
		if (requested_mode != mode) {
			stated_channel = request_params[0];
			stated_for_starting_mode(STATED_CHANNEL);
		}
		break;

	case UBERTOOTH_SET_ISP:
		/* Handed to the mode dispatch rather than done here, for the
		 * reason UBERTOOTH_RESET is: the on-chip programmer takes the
		 * board off the bus, and this transfer is not finished when the
		 * handler returns -- its status stage waits in the endpoint 0
		 * buffer for the host's next IN token, up to a whole 1 ms frame
		 * away. Leaving from in here throws that packet away, and the
		 * host reports a timeout for a request the board accepted.
		 *
		 * The price is that the running mode's loop has to notice this
		 * and return to the dispatch, as it does for a reset request. */
		requested_mode = MODE_ISP;
		break;

	case UBERTOOTH_FLASH:
		/* The bootloader is reached by resetting, so MODE_RESET below is
		 * what tells the watchdog the reset was asked for. Saying it here
		 * instead would excuse a board that wedged before getting there. */
		bootloader_ctrl = DFU_MODE;
		requested_mode = MODE_RESET;
		break;

	case UBERTOOTH_GET_WATCHDOG:
		watchdog_report(data);
		*data_len = UBERTOOTH_WATCHDOG_INFO_LEN;
		break;

	case UBERTOOTH_GET_RADIO_TIMEOUTS:
		cc2400_wait_report(data);
		*data_len = UBERTOOTH_RADIO_TIMEOUTS_LEN;
		break;

	case UBERTOOTH_SPECAN:
		if (request_params[0] < 2049 || request_params[0] > 3072 ||
				request_params[1] < 2049 || request_params[1] > 3072 ||
				request_params[1] < request_params[0])
			return 0;
		low_freq = request_params[0];
		high_freq = request_params[1];
		requested_mode = MODE_SPECAN;
		*data_len = 0;
		break;

	case UBERTOOTH_RX_GENERIC:
		requested_mode = MODE_RX_GENERIC;
		*data_len = 0;
		break;

	case UBERTOOTH_LED_SPECAN:
		/* the threshold is -N dBm, N as ubertooth-util accepts it; refuse
		 * anything else, as the other range-checked requests do */
		if (!rssi_threshold_n_valid(request_params[0]))
			return 0;
		rssi_threshold = rssi_threshold_from_n(request_params[0]);
		requested_mode = MODE_LED_SPECAN;
		*data_len = 0;
		break;

	case UBERTOOTH_GET_REV_NUM:
		data[0] = 0x00;
		data[1] = 0x00;

		length = strlen(GIT_REVISION);
		if (length > UBERTOOTH_REVISION_MAX)
			length = UBERTOOTH_REVISION_MAX;
		data[2] = (u8)length;
		memcpy(&data[3], GIT_REVISION, length);
		*data_len = 2 + 1 + length;
		break;

	case UBERTOOTH_GET_COMPILE_INFO:
		length = strlen(compile_info);
		if (length > UBERTOOTH_COMPILE_INFO_MAX)
			length = UBERTOOTH_COMPILE_INFO_MAX;
		data[0] = (u8)length;
		memcpy(&data[1], compile_info, length);
		*data_len = 1 + length;
		break;

	/* The same 64 bytes this image carries at a fixed offset, so a board and
	 * a firmware file describe themselves in one format. Keep this identical
	 * to the one in btbr/src/btctl/vendor_request_handler.c. */
	case UBERTOOTH_GET_FW_INFO:
		memcpy(data, &fw_info_block, UBERTOOTH_FW_INFO_LENGTH);
		*data_len = UBERTOOTH_FW_INFO_LENGTH;
		break;

	/* What this board's bootloader is. Keep this identical to the one in
	 * btbr/src/btctl/vendor_request_handler.c. */
	case UBERTOOTH_GET_BOOTLOADER_INFO:
		/* Refused until startup has worked the report out, rather than
		 * answered with a hash of zero. */
		if (!bl_report_build(data))
			return 0;
		*data_len = UBERTOOTH_BL_REPORT_LENGTH;
		break;

	case UBERTOOTH_GET_BOARD_ID:
		data[0] = BOARD_ID;
		*data_len = 1;
		break;

	case UBERTOOTH_SET_SQUELCH:
		cs_threshold_req = (int8_t)request_params[0];
		cs_threshold_calc_and_set(channel);
		break;

	case UBERTOOTH_GET_SQUELCH:
		data[0] = cs_threshold_req;
		*data_len = 1;
		break;

	case UBERTOOTH_SET_BDADDR:
		if (data_in_len < 16) /* an 8-byte address and an 8-byte syncword */
			return 0;
		target.address = 0;
		target.syncword = 0;
		for(int i=0; i < 8; i++) {
			target.address |= (uint64_t)data[i] << 8*i;
		}
		for(int i=0; i < 8; i++) {
			target.syncword |= (uint64_t)data[i+8] << 8*i;
		}
		precalc();
		break;

	case UBERTOOTH_START_HOPPING:
		if (data_in_len < 6) /* a 4-byte CLKN offset and a 2-byte 100 ns one */
			return 0;
		clkn_offset = 0;
		for(int i=0; i < 4; i++) {
			clkn_offset <<= 8;
			clkn_offset |= data[i];
		}
		reset_absorbed_mode_state(MODE_BT_FOLLOW);
		hop_mode = HOP_BLUETOOTH;
		dma_discard = 1;
		DIO_SSEL_SET;
		clk100ns_offset = (data[4] << 8) | (data[5] << 0);
		requested_mode = MODE_BT_FOLLOW;
		break;

	/*
	 * Start AFH detection: hop to the channels the piconet is not known to
	 * use and stream what arrives there, from an empty map that the host
	 * fills in with UBERTOOTH_SET_AFHMAP as packets come in. This is the
	 * whole request the host needs; a UBERTOOTH_RX_SYMBOLS on top of it
	 * would take the board straight back out of this mode.
	 */
	case UBERTOOTH_AFH:
		reset_absorbed_mode_state(MODE_AFH);
		hop_mode = HOP_AFH;
		requested_mode = MODE_AFH;

		clear_afh_map();
		afh_enabled = 1;
		break;

	case UBERTOOTH_HOP:
		do_hop = 1;
		break;

	case UBERTOOTH_SET_CLOCK:
		if (data_in_len < 4)
			return 0;
		clock = data[0] | data[1] << 8 | data[2] << 16 | data[3] << 24;
		clkn = clock;
		cs_threshold_calc_and_set(channel);
		break;

	case UBERTOOTH_SET_AFHMAP:
		if (data_in_len < sizeof(afh_map))
			return 0;
		bluetooth_set_afh_map(data);
		/* Kept for the mode request this followed, as a channel is:
		 * ubertooth-follow states its map just after asking for the
		 * hopping, and the teardown's clear_afh_map() can run a moment
		 * after that request was answered, which would leave the follow
		 * hopping all 79 channels.
		 *
		 * Only when the mode the host asked for is not the one running.
		 * A map sent by a capture already in that mode -- AFH detection
		 * sends one whenever it finds another channel -- needs no copy,
		 * and keeping one would hand that run's map to the next
		 * capture asking for the same mode. */
		if (requested_mode != mode) {
			for (i = 0; i < sizeof(afh_map); i++)
				stated_afh_map[i] = data[i];
			stated_for_starting_mode(STATED_AFH_MAP);
		}
		*data_len = 10;
		break;

	case UBERTOOTH_CLEAR_AFHMAP:
		clear_afh_map();
		/* Including a map stated for a mode whose start is still to come:
		 * a host that clears the map means the capture to hop the whole
		 * band, and applying the earlier map at the mode start would be
		 * the opposite of what it asked for. */
		stated_what &= ~STATED_AFH_MAP;
		*data_len = 10;
		break;

	case UBERTOOTH_GET_CLOCK:
		clock = clkn;
		for(int i=0; i < 4; i++) {
			data[i] = (clock >> (8*i)) & 0xff;
		}
		*data_len = 4;
		break;

	case UBERTOOTH_TRIM_CLOCK:
		if (data_in_len < 2)
			return 0;
		clk100ns_offset = (data[0] << 8) | (data[1] << 0);
		break;

	case UBERTOOTH_FIX_CLOCK_DRIFT:
		if (data_in_len < 2)
			return 0;
		/*
		 * Each request adds to a running figure, kept within what the
		 * correction can act on: one correction every CLKN tick is
		 * CLK_DRIFT_PPM_MAX, and nothing beyond it corrects any faster.
		 *
		 * Added in 32 bits and then stored, because the figure is 16
		 * bits wide: an overflowed figure comes back with the other
		 * sign, and the board would speed its clock up because the host
		 * had asked it to slow down.
		 */
		drift_ppm = (int32_t)clk_drift_ppm +
		            (int16_t)((data[0] << 8) | (data[1] << 0));
		if (drift_ppm > CLK_DRIFT_PPM_MAX)
			drift_ppm = CLK_DRIFT_PPM_MAX;
		else if (drift_ppm < -CLK_DRIFT_PPM_MAX)
			drift_ppm = -CLK_DRIFT_PPM_MAX;
		clk_drift_ppm = (int16_t)drift_ppm;

		/* How many CLKN ticks apart the corrections go. A correction
		 * interval of zero means "do not correct at all", so the floor
		 * of 1 stands: the fastest this can correct is once a tick. */
		// Too slow
		if (clk_drift_ppm < 0) {
			clk_drift_correction = CLK_DRIFT_PPM_MAX / (uint16_t)(-clk_drift_ppm);
			if (clk_drift_correction == 0)
				clk_drift_correction = 1;
			clkn_next_drift_fix = clkn_last_drift_fix + clk_drift_correction;
		}
		// Too fast
		else if (clk_drift_ppm > 0) {
			clk_drift_correction = CLK_DRIFT_PPM_MAX / clk_drift_ppm;
			if (clk_drift_correction == 0)
				clk_drift_correction = 1;
			clkn_next_drift_fix = clkn_last_drift_fix + clk_drift_correction;
		}
		// Don't trim
		else {
			clk_drift_correction = 0;
			clkn_next_drift_fix = 0;
		}

		break;

	case UBERTOOTH_BTLE_SNIFFING:
		le.do_follow = request_params[0];
		*data_len = 0;

		do_hop = 0;
		hop_mode = HOP_BTLE;
		drop_kept_settings(MODE_BT_FOLLOW_LE);
		requested_mode = MODE_BT_FOLLOW_LE;

		usb_queue_init();
		cs_threshold_calc_and_set(channel);
		break;

	case UBERTOOTH_GET_ACCESS_ADDRESS:
		for(int i=0; i < 4; i++) {
			data[i] = (le.access_address >> (8*i)) & 0xff;
		}
		*data_len = 4;
		break;

	case UBERTOOTH_SET_ACCESS_ADDRESS:
		if (data_in_len < 4)
			return 0;
		le_set_access_address(data[0] | data[1] << 8 | data[2] << 16 | data[3] << 24);
		/* The only request that gives promiscuous mode an access
		 * address to follow. It has to be a setting of its own:
		 * UBERTOOTH_BTLE_SET_TARGET names a device address and no
		 * access address at all, so a target set for follow mode must
		 * not make promiscuous mode skip its discovery half. */
		le.access_address_set = 1;
		break;

	case UBERTOOTH_GET_CRC_VERIFY:
		data[0] = le.crc_verify ? 1 : 0;
		*data_len = 1;
		break;

	case UBERTOOTH_SET_CRC_VERIFY:
		le.crc_verify = request_params[0] ? 1 : 0;
		break;

	case UBERTOOTH_POLL:
		p = dequeue();
		if (p != NULL) {
			memcpy(data, (void *)p, sizeof(usb_pkt_rx));
			*data_len = sizeof(usb_pkt_rx);
		} else {
			data[0] = 0;
			*data_len = 1;
		}
		break;

	case UBERTOOTH_BTLE_PROMISC:
		*data_len = 0;

		hop_mode = HOP_NONE;
		drop_kept_settings(MODE_BT_PROMISC_LE);
		requested_mode = MODE_BT_PROMISC_LE;

		usb_queue_init();
		cs_threshold_calc_and_set(channel);
		break;

	case UBERTOOTH_READ_REGISTER:
		reg_val = cc2400_get(request_params[0]);
		data[0] = (reg_val >> 8) & 0xff;
		data[1] = reg_val & 0xff;
		*data_len = 2;
		break;

	case UBERTOOTH_WRITE_REGISTER:
		cc2400_set(request_params[0] & 0xff, request_params[1]);
		break;

	case UBERTOOTH_WRITE_REGISTERS:
		/* A count the buffer cannot hold is refused before the count
		 * is used at all. */
		if (request_params[0] > WRITE_REGISTERS_MAX)
			return 0;
		/* a register number and a 16-bit value per register */
		if (data_in_len < request_params[0] * 3u)
			return 0;
		for (unsigned reg = 0; reg < request_params[0]; reg++) {
			reg_val = (data[(reg*3)+1] << 8) | data[(reg*3)+2];
			cc2400_set(data[reg*3], reg_val);
		}
		break;

	case UBERTOOTH_READ_ALL_REGISTERS:
		for (i = 0; i < READ_ALL_REGISTERS_COUNT; i++) {
			reg_val = cc2400_get(i);
			data[i*3] = i;
			data[(i*3)+1] = (reg_val >> 8) & 0xff;
			data[(i*3)+2] = reg_val & 0xff;
		}
		*data_len = READ_ALL_REGISTERS_LEN;
		break;

#ifdef TX_ENABLE
	case UBERTOOTH_TX_GENERIC_PACKET:
		/*
		 * The payload length is a byte of the request, checked before
		 * anything is copied: tx_pkt has room for DMA_SIZE payload
		 * bytes with other globals behind it, and the length reaches
		 * the radio's FIFO in tx_generic(). The length the host
		 * declared bounds the copy as well, so it cannot run past what
		 * was sent.
		 */
		if (data_in_len < TX_GENERIC_HEADER_LEN)
			return 0;
		i = data[offsetof(generic_tx_packet, length)];
		if (i > DMA_SIZE || data_in_len - TX_GENERIC_HEADER_LEN < i)
			return 0;
		/*
		 * The channel reaches FSDIV unchanged in tx_generic(), so a
		 * frequency outside the synthesizer's range would have the
		 * transmit wait out its lock timeout, send nothing, and leave
		 * that frequency in the register for whatever ran next.
		 *
		 * Both ends are refused, unlike UBERTOOTH_SET_CHANNEL, where a
		 * frequency above MAX_FREQ asks for the band sweep. Nothing
		 * here sweeps.
		 */
		tx_channel = data[offsetof(generic_tx_packet, channel)]
		           | ((uint16_t)data[offsetof(generic_tx_packet, channel) + 1] << 8);
		if (tx_channel < MIN_FREQ || tx_channel > MAX_FREQ)
			return 0;
		/*
		 * A running burst sends from tx_pkt, so a second request would
		 * splice its payload into the packets the burst has left and
		 * lose the count it asked for. It is refused, and refused
		 * before the copy, or the splice has happened by the time the
		 * refusal is decided.
		 */
		if (mode == MODE_TX_GENERIC)
			return 0;
		memcpy(&tx_pkt, data, TX_GENERIC_HEADER_LEN + i);
		/* wValue is how many of this packet to send; a host that leaves
		 * it 0 gets one. */
		tx_pkt_repeat = request_params[0] > 0 ? request_params[0] : 1;
		requested_mode = MODE_TX_GENERIC;
		*data_len = 0;
		break;

	case UBERTOOTH_BTLE_PERIPHERAL:
		if (data_in_len < 6)
			return 0;
		memcpy(peripheral_mac_address, data, 6);
		drop_kept_settings(MODE_BT_PERIPHERAL_LE);
		requested_mode = MODE_BT_PERIPHERAL_LE;
		break;
#endif

	case UBERTOOTH_LE_SET_ADV_DATA:
		/* An empty payload is a request in its own right, so the
		 * direction is what tells it apart from a read of this number;
		 * every other case that reads data needs a byte of it and is
		 * refused by its own length check.
		 *
		 * The bound is what the advertising mode can transmit, so a
		 * program that asks for more is refused here, where it can see
		 * which request the board turned down, rather than left with a
		 * board that quietly drops out of the mode. */
		if (!data_from_host || data_in_len > ADV_IND_MAX_DATA)
			return 0;
		le_adv_len = data_in_len;
		memcpy(le_adv_data, data, le_adv_len);
		break;

	case UBERTOOTH_BTLE_SET_TARGET:
		if (data_in_len < 7) /* six address bytes and a mask length */
			return 0;
		// Addresses appear in packets in reverse-octet order.
		// Store the target address in reverse order so that we can do a simple memcmp later
		if (data[6] > 48) {
			return 0; // invalid mask
		}
		else if (data[6] == 0) {
			le.target_set = 0;
			memset(le.target, 0, 6);
			memset(le.target_mask, 0, 6);
		} else {
			unsigned last;

			for (i = 0; i < 6; ++i)
				le.target[i] = data[5-i];

			// compute mask
			memset(le.target_mask, 0, 6);
			for (i = 5; data[6] > 8; --i, data[6] -= 8) {
				le.target_mask[i] = 0xff;
			}
			last = i;

			if (data[6] > 0) {
				uint8_t final_byte = 0;
				for (i = 0; i < data[6]; ++i) {
					final_byte >>= 1;
					final_byte |= 0b10000000;
				}
				le.target_mask[last] = final_byte;
			}

			// in case the user specifies a bad mask
			for (i = 0; i < 5; ++i)
				le.target[i] &= le.target_mask[i];

			le.target_set = 1;
		}
		break;

	case UBERTOOTH_CANCEL_FOLLOW:
		// cancel following an active connection
		cancel_follow = 1;
		break;

#ifdef TX_ENABLE
	case UBERTOOTH_JAM_MODE:
		jam_mode = request_params[0];
		/* ubertooth-btle sends this before its mode request too. */
		keep_for_next_mode_start(KEEP_JAM_MODE);
		break;
#endif

	case UBERTOOTH_EGO:
		/*
		 * Checked before anything is stored, so a refused request
		 * leaves no mode behind for a later run to start in: ego_main()
		 * has no state machine for a mode it does not know.
		 */
		switch (request_params[0]) {
		case EGO_FOLLOW:
		case EGO_CONTINUOUS_RX:
#ifdef TX_ENABLE
		case EGO_JAM:
#endif
			break;
		default:
			return 0;
		}

		ego_mode = request_params[0];

		/*
		 * A board already in E-GO mode absorbs this request, the way
		 * the symbol captures absorb theirs, so no mode starts and the
		 * dispatch's reset never runs. Do that mode start's work here
		 * instead: put the access code back to the one
		 * ubertooth-ego(1) documents, forget the hopping, and tell the
		 * loop to start its state machine over.
		 *
		 * The restart flag is what makes this a mode start at all:
		 * without it the state machine the first run entered carries
		 * on and the mode stored above is never read. Set it after the
		 * mode, because the loop reads the mode only once it has seen
		 * the flag.
		 */
		if (mode == MODE_EGO && requested_mode == MODE_EGO) {
			ego_capture_reset();
			/* The host sends the capture length before this
			 * request, so nothing else puts it back after the
			 * reset above. */
			apply_kept_cap_len();
			forget_hop_state();
			ego_restart = 1;
		}
		requested_mode = MODE_EGO;
		break;

	case UBERTOOTH_RFCAT_SUBCMD:
		if (!rfcat_subcommand(request_params[0], data, data_in_len))
			return 0;
		/* An access code stated after the mode request belongs to the
		 * capture that is starting, and the mode start puts the code
		 * back to its default: keep a copy for it. */
		if (request_params[0] == RFCAT_SET_AA && requested_mode != mode) {
			stated_access_code = access_code;
			stated_access_code_len = access_code_len;
			stated_for_starting_mode(STATED_ACCESS_CODE);
		}
		/* The capture length comes before the mode request instead, so
		 * it is kept rather than stated, or `ubertooth-ego -l` would
		 * capture at the default the mode start puts back. */
		if (request_params[0] == RFCAT_CAP_LEN)
			keep_for_next_mode_start(KEEP_CAP_LEN);
		break;

	case UBERTOOTH_XMAS:
		requested_mode = MODE_XMAS;
		break;

	case UBERTOOTH_IDENTIFY:
		requested_mode = MODE_IDENTIFY;
		break;

	default:
		return 0;
	}
	return 1;
}

/* Update CLKN. */
void TIMER0_IRQHandler()
{
	if (T0IR & TIR_MR0_Interrupt) {

		clkn += clkn_offset + 1;
		clkn_offset = 0;

		uint32_t le_clk = (clkn - le.conn_epoch) & 0x03;

		/* Trigger hop based on mode */

		/* NONE or SWEEP -> 25 Hz */
		if (hop_mode == HOP_NONE || hop_mode == HOP_SWEEP) {
			if ((clkn & 0x7f) == 0)
				do_hop = 1;
		}
		/* BLUETOOTH -> 1600 Hz */
		else if (hop_mode == HOP_BLUETOOTH) {
			if ((clkn & 0x1) == 0)
				do_hop = 1;
		}
		/* BLUETOOTH Low Energy -> 7.5ms - 4.0s in multiples of 1.25 ms */
		else if (hop_mode == HOP_BTLE) {
			// Only hop if connected
			if (le.link_state == LINK_CONNECTED && le_clk == 0) {
				--le.interval_timer;
				if (le.interval_timer == 0) {
					do_hop = 1;
					++le.conn_count;
					le.interval_timer = le.conn_interval;
				} else {
					TXLED_CLR; // hack!
				}
			}
		}
		else if (hop_mode == HOP_AFH) {
			if( (last_hop + hop_timeout) == clkn ) {
				do_hop = 1;
			}
		}

		// Fix linear clock drift deviation
		if(clkn_next_drift_fix != 0 && clk100ns_offset == 0) {
			if(clkn >= clkn_next_drift_fix) {

				// Too fast
				if(clk_drift_ppm >= 0) {
					clk100ns_offset = 1;
				}

				// Too slow
				else {
					clk100ns_offset = 6249;
				}
				clkn_last_drift_fix = clkn;
				clkn_next_drift_fix = clkn_last_drift_fix + clk_drift_correction;
			}
		}

		// Negative clock correction
		if(clk100ns_offset > 3124)
			clkn += 2;

		T0MR0 = 3124 + clk100ns_offset;
		clk100ns_offset = 0;

		/* Ack interrupt */
		T0IR = TIR_MR0_Interrupt;
	}
}

/* The carrier-sense edge on GIO6 arrives here, on the GPIO interrupt's shared
 * EINT3 vector. A board whose GIO6 cannot raise that interrupt (see
 * GIO6_HAS_INTERRUPT in ubertooth.h) never enables EINT3, so it gets no
 * handler from here and keeps the weak default; the badge has its own in
 * ubertooth.c for its button. */
#if GIO6_HAS_INTERRUPT
void EINT3_IRQHandler()
{
	/* TODO - check specific source of shared interrupt */
	GIO6_INT_CLR;           // clear interrupt
	DIO_SSEL_CLR;           // enable SPI
	cs_trigger  = 1;        // signal trigger
	if (hop_mode == HOP_BLUETOOTH)
		dma_discard = 0;

}
#endif // GIO6_HAS_INTERRUPT

/*
 * Sleep (busy wait) for 'millis' milliseconds
 * Needs clkn. Be sure to call clkn_init() before using it.
 */
static void msleep(uint32_t millis)
{
	uint32_t now = (clkn & 0xffffff);
	uint32_t stop_at = now + millis * 10000 / CLK100NS_PER_CLKN; // millis -> clkn ticks

	// handle clkn overflow
	if (stop_at >= ((uint32_t)1<<28)) {
		stop_at -= ((uint32_t)1<<28);
		while ((clkn & 0xffffff) >= now || (clkn & 0xffffff) < stop_at);
	} else {
		while ((clkn & 0xffffff) < stop_at);
	}
}

void legacy_DMA_IRQHandler();
void le_DMA_IRQHandler();
void DMA_IRQHandler(void) {
	if (mode == MODE_BT_FOLLOW_LE)
		le_DMA_IRQHandler();
	else
		legacy_DMA_IRQHandler();

	// DMA channel 7: debug UART
	if (DMACIntStat & (1 << 7)) {
		// TC -- DMA completed, unset flag so another printf can occur
		if (DMACIntTCStat & (1 << 7)) {
			DMACIntTCClear = (1 << 7);
			debug_dma_active = 0;
		}
		// error -- blow up
		if (DMACIntErrStat & (1 << 7)) {
			DMACIntErrClr = (1 << 7);
			// FIXME do something better here
			USRLED_SET;
			/* This loop never returns and never services USB, so the
			 * watchdog resets the board a few seconds later. The
			 * mark is what names this site in ubertooth-util -w
			 * afterwards. */
			watchdog_mark(WATCHDOG_SITE_DEBUG_DMA);
			while (1) { }
		}
	}
}

/*
 * Every mode that receives through the symbol DMA has to be listed here: the
 * buffer swap below is what makes a transfer complete for the mode loop
 * (rx_tc), so a mode left out of the list waits for a buffer that is never
 * handed over.
 */
void legacy_DMA_IRQHandler()
{
	if ( mode == MODE_RX_SYMBOLS
	   || mode == MODE_BT_FOLLOW
	   || mode == MODE_AFH
	   || mode == MODE_SPECAN
	   || mode == MODE_BT_FOLLOW_LE
	   || mode == MODE_BT_PROMISC_LE
	   || mode == MODE_BT_PERIPHERAL_LE
	   || mode == MODE_RX_GENERIC)
	{
		/* interrupt on channel 0 */
		if (DMACIntStat & (1 << 0)) {
			if (DMACIntTCStat & (1 << 0)) {
				DMACIntTCClear = (1 << 0);

				if (hop_mode == HOP_BLUETOOTH)
					DIO_SSEL_SET;

				idle_buf_clk100ns  = CLK100NS;
				idle_buf_clkn_high = (clkn >> 20) & 0xff;
				idle_buf_channel   = channel;

				/* Keep buffer swapping in sync with DMA. */
				volatile uint8_t* tmp = active_rxbuf;
				active_rxbuf = idle_rxbuf;
				idle_rxbuf = tmp;

				++rx_tc;
			}
			if (DMACIntErrStat & (1 << 0)) {
				DMACIntErrClr = (1 << 0);
				++rx_err;
				watchdog_count_transfer_error();
			}
		}
	}
}

/*
 * Put the radio and the board back to a known state.
 *
 * This decides nothing about what runs next: the main loop's dispatch owns
 * `mode` and `requested_mode`, and runs this whenever a mode is left. Keeping
 * the two apart is what stops the teardown from dropping a mode request that
 * arrives while it runs -- the LE paths call it with USB interrupts enabled,
 * so writing `requested_mode` here would leave the board idle while the host,
 * whose request had succeeded, believed the mode had started.
 */
static void cc2400_idle()
{
	cc2400_strobe(SRFOFF);
	cc2400_wait_fs_unlock();

	/*
	 * Drop the manual signal overrides the mode that is ending may have
	 * written, so the next mode starts with the radio front end a freshly
	 * booted board has. The LE PHY forces the low-noise amplifier and
	 * mixers on and the receive paths hold the receive gain amplifier out
	 * of reset, while the two spectrum analyzers write no MANAND value of
	 * their own, so without this what they measure depends on which mode
	 * ran before them.
	 */
	cc2400_set(MANAND, MANAND_RESET_VALUE);

#ifdef UBERTOOTH_ONE
	PAEN_CLR;
	HGM_CLR;
#endif

	RXLED_CLR;
	TXLED_CLR;
	USRLED_CLR;

	clkn_stop();
	dio_ssp_stop();
	cs_reset();
	rssi_reset();

	/* hopping stuff */
	hop_mode = HOP_NONE;
	do_hop = 0;
	channel = 2441;
	hop_direct_channel = 0;
	hop_timeout = 158;
	requested_channel = 0;
	le_adv_channel = BT_FREQ_MIN;

	/*
	 * The AFH map goes with the mode that was using it, or the next
	 * capture would hop adaptively on a channel set found for someone
	 * else's piconet while the host reported it was not using AFH. A mode
	 * that wants a map sends one once it has started.
	 */
	clear_afh_map();

	/* bulk USB stuff */
	idle_buf_clkn_high = 0;
	idle_buf_clk100ns = 0;
	idle_buf_channel = 0;
	dma_discard = 0;
	status = 0;

	/* operation mode */
	jam_mode = JAM_NONE;

	/* Not ego_mode. This teardown runs between the request that stores it
	 * and the dispatch that reads it, so resetting it here would throw
	 * away the mode that request asked for. Nothing else writes it, and
	 * MODE_EGO is only ever asked for by that request. */

	modulation = MOD_BT_BASIC_RATE;

	/* specan stuff */
	low_freq = 2400;
	high_freq = 2483;
	rssi_threshold = -30;

	target.address = 0;
	target.syncword = 0;
}

/*
 * What a polled mode loop does between radio status polls instead of spinning.
 *
 * USB in this firmware is polled from whichever mode loop is running
 * (handle_usb()), and endpoint 0 -- the one control requests arrive on -- is
 * single-buffered. A loop that polls once per pass is a whole pass behind the
 * host: a SETUP packet arriving while the previous transfer's status packet is
 * still in the endpoint is read back short, decodes to a request this
 * firmware does not know, and lpcusb halts the endpoint, which the host sees
 * as a stalled control transfer.
 *
 * Passing this into the bounded radio waits keeps endpoint 0 within a few
 * microseconds of the host, and keeps it serviced between the waits'
 * bit-banged CC2400 transfers rather than inside one.
 *
 * clkn is the bulk stream's keep-alive timestamp, and it stands still in the
 * modes that never start the Bluetooth clock. None of those streams bulk
 * packets, so there is no keep-alive to be late either way.
 */
void service_usb(void)
{
	handle_usb(clkn);
}

/* Whether the Bluetooth receive below configures the radio for this
 * modulation. The other values of enum modulations reach no modem register:
 * the generic receive is set up by the host, and spectrum analysis uses no
 * demodulator. */
static int programs_modulation(uint8_t m)
{
	return m == MOD_BT_BASIC_RATE || m == MOD_BT_LOW_ENERGY;
}

/*
 * The frequency deviation the demodulator expects for one of those two, as
 * MDMCTRL holds it. In one place rather than in each caller, so that the
 * capture loop -- which writes this register again when the host states a
 * modulation after its mode request -- writes what the mode start would have.
 */
static u16 mdmctrl_deviation(uint8_t m)
{
	if (m == MOD_BT_BASIC_RATE)
		return 0x0029; // 160 kHz frequency deviation
	return 0x0040;         // 250 kHz frequency deviation
}

/* start un-buffered rx */
static void cc2400_rx()
{
	if (programs_modulation(modulation)) {
		u16 mdmctrl = mdmctrl_deviation(modulation);

		cc2400_set(MANAND,  0x7fff);
		cc2400_set(LMTST,   0x2b22);
		cc2400_set(MDMTST0, 0x134b); // without PRNG
		cc2400_set(GRMDM,   0x0101); // un-buffered mode, GFSK
		// 0 00 00 0 010 00 0 00 0 1
		//      |  | |   |  +--------> CRC off
		//      |  | |   +-----------> sync word: 8 MSB bits of SYNC_WORD
		//      |  | +---------------> 2 preamble bytes of 01010101
		//      |  +-----------------> not packet mode
			//      +--------------------> un-buffered mode
		cc2400_set(FSDIV,   channel - 1); // 1 MHz IF
		cc2400_set(MDMCTRL, mdmctrl);
	}

	// Set up CS register
	cs_threshold_calc_and_set(channel);

	clkn_start();

	/* Bounded, so a radio that stops answering cannot keep the mode loop
	 * below from ever starting -- and that loop is what services USB, so a
	 * board stuck here answers no control request until it is re-plugged.
	 *
	 * No service callback: a control request serviced here could change the
	 * channel or the modulation between the register writes above and the
	 * receive strobe below. This happens once per mode start, not once per
	 * hop, so bounding it is enough. */
	cc2400_wait_xosc_stable(NULL);
	cc2400_strobe(SFSON);
	cc2400_wait_fs(1, NULL);
	cc2400_strobe(SRX);
#ifdef UBERTOOTH_ONE
	PAEN_SET;
	HGM_SET;
#endif
}

/* start un-buffered rx */
static void cc2400_rx_sync(u32 sync)
{
	u16 grmdm, mdmctrl;

	if (modulation == MOD_BT_BASIC_RATE) {
		mdmctrl = 0x0029; // 160 kHz frequency deviation
		grmdm = 0x0461; // un-buffered mode, packet w/ sync word detection
		// 0 00 00 1 000 11 0 00 0 1
		//   |  |  | |   |  +--------> CRC off
		//   |  |  | |   +-----------> sync word: 32 MSB bits of SYNC_WORD
		//   |  |  | +---------------> 0 preamble bytes of 01010101
		//   |  |  +-----------------> packet mode
		//   |  +--------------------> un-buffered mode
		//   +-----------------------> sync error bits: 0

	} else if (modulation == MOD_BT_LOW_ENERGY) {
		mdmctrl = 0x0040; // 250 kHz frequency deviation
		grmdm = 0x0561; // un-buffered mode, packet w/ sync word detection
		// 0 00 00 1 010 11 0 00 0 1
		//   |  |  | |   |  +--------> CRC off
		//   |  |  | |   +-----------> sync word: 32 MSB bits of SYNC_WORD
		//   |  |  | +---------------> 2 preamble bytes of 01010101
		//   |  |  +-----------------> packet mode
		//   |  +--------------------> un-buffered mode
		//   +-----------------------> sync error bits: 0

	} else {
		/* oops */
		return;
	}

	cc2400_set(MANAND,  0x7fff);
	cc2400_set(LMTST,   0x2b22);

	cc2400_set(MDMTST0, 0x124b);
	// 1      2      4b
	// 00 0 1 0 0 10 01001011
	//    | | | | |  +---------> AFC_DELTA = ??
	//    | | | | +------------> AFC settling = 4 pairs (8 bit preamble)
	//    | | | +--------------> no AFC adjust on packet
	//    | | +----------------> do not invert data
	//    | +------------------> TX IF freq 1 0Hz
	//    +--------------------> PRNG off
	//
	// ref: CC2400 datasheet page 67
	// AFC settling explained page 41/42

	cc2400_set(GRMDM,   grmdm);

	cc2400_set(SYNCL,   sync & 0xffff);
	cc2400_set(SYNCH,   (sync >> 16) & 0xffff);

	cc2400_set(FSDIV,   channel - 1); // 1 MHz IF
	cc2400_set(MDMCTRL, mdmctrl);

	// Set up CS register
	cs_threshold_calc_and_set(channel);

	clkn_start();

	/* Bounded without a service callback, as in cc2400_rx(). */
	cc2400_wait_xosc_stable(NULL);
	cc2400_strobe(SFSON);
	cc2400_wait_fs(1, NULL);
	cc2400_strobe(SRX);
#ifdef UBERTOOTH_ONE
	PAEN_SET;
	HGM_SET;
#endif
}

#ifdef TX_ENABLE
/* Polls before the wait for the radio's FIFO to empty gives up. The loop is
 * five instructions, about 80 ns at 100 MHz, so this is some fifteen
 * milliseconds -- far longer than the 256 us a full FIFO takes to go out at
 * 1 Mbit/s, and so out of reach of a radio that is transmitting at all. */
#define FIFO_EMPTY_POLLS 200000

/*
 * Wait, with a bound, for the radio to have sent what is in its FIFO, so the
 * next piece of a packet longer than the FIFO can go in.
 *
 * GIO6 has to be configured as the radio's FIFO_EMPTY signal for this to mean
 * anything; both callers do that before they start writing and put IOCFG back
 * when the packet is out.
 *
 * The bound matters because a radio that stops draining -- the synthesizer
 * dropped out, or the transmit strobe was lost -- would hold the transmit
 * loop forever, and that loop is what services USB.
 *
 * A caller that times out stops writing and lets the packet end there, rather
 * than carrying on as the other bounded radio waits do: the radio still holds
 * what it was given, so the next piece would go past the end of the FIFO. The
 * packet goes out short and the receiver drops it, and the board keeps
 * answering the host.
 *
 * These timeouts are not among the counts UBERTOOTH_GET_RADIO_TIMEOUTS
 * reports, so a board that keeps truncating packets reads as a quiet one.
 *
 * Returns 1 if the FIFO emptied, 0 if the wait timed out.
 */
static int fifo_wait_empty(void)
{
	unsigned polls;

	for (polls = FIFO_EMPTY_POLLS; polls != 0; polls--)
		if (GIO6)
			return 1;
	return 0;
}

/* start buffered tx */
static void cc2400_tx_sync(uint32_t sync)
{
	// Bluetooth-like modulation
	cc2400_set(MANAND,  0x7fff);
	cc2400_set(LMTST,   0x2b22);    // LNA and receive mixers test register
	cc2400_set(MDMTST0, 0x134b);    // no PRNG

	cc2400_set(GRMDM,   0x0c01);
	// 0 00 01 1 000 00 0 00 0 1
	//      |  | |   |  +--------> CRC off
	//      |  | |   +-----------> sync word: 8 MSB bits of SYNC_WORD
	//      |  | +---------------> 0 preamble bytes of 01010101
	//      |  +-----------------> packet mode
	//      +--------------------> buffered mode

	cc2400_set(SYNCL,   sync & 0xffff);
	cc2400_set(SYNCH,   (sync >> 16) & 0xffff);

	cc2400_set(FSDIV,   channel);
	// keep the amplifier level set with `ubertooth-util -a` (7 at power-on)
	cc2400_set(FREND,   frend_keep_pa_level(cc2400_get(FREND)));

	if (modulation == MOD_BT_BASIC_RATE) {
		cc2400_set(MDMCTRL, 0x0029);    // 160 kHz frequency deviation
	} else if (modulation == MOD_BT_LOW_ENERGY) {
		cc2400_set(MDMCTRL, 0x0040);    // 250 kHz frequency deviation
	} else {
		/* oops */
		return;
	}

	clkn_start();

	/* Bounded without a service callback, as in cc2400_rx(). */
	cc2400_wait_xosc_stable(NULL);
	cc2400_strobe(SFSON);
	cc2400_wait_fs(1, NULL);

#ifdef UBERTOOTH_ONE
	PAEN_SET;
#endif

	cc2400_wait_fsm(STATE_STROBE_FS_ON, NULL);
	cc2400_strobe(STX);

}
#endif

/* How long a packet le_transmit() can be asked to send. Its length is a u8,
 * so 255 bytes is the worst case, and the buffer it whitens into has to hold
 * that much. This is not a limit on advertising data -- ADV_IND_MAX_DATA is
 * that -- only on what the caller below can hand the radio. */
#define LE_TX_MAX_LEN 255

/*
 * Transmit a BTLE packet with the specified access address.
 *
 * All modulation parameters are set within this function. The data
 * should not be pre-whitened, but the CRC should be calculated and
 * included in the data length.
 *
 */
#ifdef TX_ENABLE
void le_transmit(u32 aa, u8 len, u8 *data)
{
	unsigned int fifo_space, i, j;
	int bit;
	u8 txbuf[LE_TX_MAX_LEN];
	u8 tx_len;
	u8 byte;
	uint32_t sync = rbit(aa);
	u16 gio_save;

	// whiten the data and copy it into the txbuf
	int idx = whitening_index[btle_channel_index(channel)];
	for (i = 0; i < len; ++i) {
		byte = data[i];
		txbuf[i] = 0;
		for (j = 0; j < 8; ++j) {
			bit = (byte & 1) ^ whitening[idx];
			idx = (idx + 1) % sizeof(whitening);
			byte >>= 1;
			txbuf[i] |= bit << (7 - j);
		}
	}

	// Bluetooth-like modulation
	cc2400_set(MANAND,  0x7fff);
	cc2400_set(LMTST,   0x2b22);    // LNA and receive mixers test register
	cc2400_set(MDMTST0, 0x134b);    // no PRNG

	cc2400_set(GRMDM,   0x0ce1);
	// 0 00 01 1 001 11 0 00 0 1
	//      |  | |   |  +--------> CRC off
	//      |  | |   +-----------> sync word: all 32 bits of SYNC_WORD
	//      |  | +---------------> 1 preamble byte of 01010101
	//      |  +-----------------> packet mode
	//      +--------------------> buffered mode

	cc2400_set(FSDIV,   channel);
	// keep the amplifier level set with `ubertooth-util -a` (7 at power-on)
	cc2400_set(FREND,   frend_keep_pa_level(cc2400_get(FREND)));
	cc2400_set(MDMCTRL, 0x0040);    // 250 kHz frequency deviation
	cc2400_set(INT,     0x0010);    // FIFO_THRESHOLD: 16 bytes
	// Nothing waits on that threshold: the loop below refills when the
	// radio reports its FIFO empty, which is a different signal.

	// set sync word to bit-reversed AA
	cc2400_set(SYNCL,   sync & 0xffff);
	cc2400_set(SYNCH,   (sync >> 16) & 0xffff);

	// GIO6 reports the radio's FIFO empty, which is what the write loop
	// below waits on. It must not be FIFO_FULL, which br_transmit() asks
	// for: that is a different signal with the opposite sense.
	gio_save = cc2400_get(IOCFG);
	cc2400_set(IOCFG, (GIO_FIFO_EMPTY << 9) | (gio_save & 0x1ff));

	// turn on the radio
	/* Bounded without a service callback: this sends one packet for the
	 * caller, which is a mode loop that services USB itself. */
	cc2400_wait_xosc_stable(NULL);
	cc2400_strobe(SFSON);
	cc2400_wait_fs(1, NULL);
	TXLED_SET;
#ifdef UBERTOOTH_ONE
	PAEN_SET;
#endif
	cc2400_wait_fsm(STATE_STROBE_FS_ON, NULL);
	/*
	 * The radio's FIFO holds CC2400_FIFO_SIZE bytes, so a longer packet
	 * goes in a piece at a time: wait for the radio to have sent what it
	 * has, write the next piece, strobe it out, repeat. A single longer
	 * write pushes past the end of the FIFO and what goes on the air is
	 * undefined.
	 */
	fifo_space = CC2400_FIFO_SIZE; // the FIFO is empty to start with
	i = 0;
	while (len != 0)
	{
		// Wait for the radio to have sent what is in the FIFO. Before
		// the first piece there is nothing to drain, so GIO6 already
		// reads high and this returns at once. A wait that gives up ends
		// the packet rather than writing the next piece past the end of
		// a FIFO the radio has not emptied.
		if (!fifo_wait_empty())
			break;
		// Decide how much we should send in this iteration
		if (len >= fifo_space) {
			len -= fifo_space;
			tx_len = fifo_space;
		} else {
			tx_len = len;
			len = 0;
		}
		// Signal FIFO to send data
		cc2400_fifo_write(tx_len, txbuf + i);
		cc2400_strobe(STX);
		i += tx_len;
		// Half a FIFO for every piece after the first, as the
		// advertising path has always written. The wait above is on the
		// FIFO being empty, so a whole FIFO would fit.
		fifo_space = CC2400_FIFO_SIZE / 2;
	}
	cc2400_wait_fsm(STATE_STROBE_FS_ON, NULL);
	TXLED_CLR;

	cc2400_strobe(SRFOFF);
	cc2400_wait_fs_unlock();

#ifdef UBERTOOTH_ONE
	PAEN_CLR;
#endif
	// Restore GIO
 	cc2400_set(IOCFG, gio_save);
}
#endif

#ifdef TX_ENABLE
void le_jam(void) {
	cc2400_set(MANAND,  0x7fff);
	cc2400_set(LMTST,   0x2b22);    // LNA and receive mixers test register
	cc2400_set(MDMTST0, 0x234b);    // PRNG, 1 MHz offset

	cc2400_set(GRMDM,   0x0c01);
	// 0 00 01 1 000 00 0 00 0 1
	//      |  | |   |  +--------> CRC off
	//      |  | |   +-----------> sync word: 8 MSB bits of SYNC_WORD
	//      |  | +---------------> 0 preamble bytes of 01010101
	//      |  +-----------------> packet mode
	//      +--------------------> buffered mode

	// cc2400_set(FSDIV,   channel);
	// jam at the amplifier level set with `ubertooth-util -a` (7 at power-on)
	cc2400_set(FREND,   frend_keep_pa_level(cc2400_get(FREND)));
	cc2400_set(MDMCTRL, 0x0040);    // 250 kHz frequency deviation

	/* Bounded without a service callback, as in le_transmit(). */
	cc2400_wait_xosc_stable(NULL);
	cc2400_strobe(SFSON);
	cc2400_wait_fs(1, NULL);
	TXLED_SET;
#ifdef UBERTOOTH_ONE
	PAEN_SET;
#endif
	cc2400_wait_fsm(STATE_STROBE_FS_ON, NULL);
	cc2400_strobe(STX);
}
#endif

/* TODO - return whether hop happened, or should caller have to keep
 * track of this? */
/*
 * Retune to the next channel.
 *
 * `service` is what to do between radio status polls while the synthesizer
 * settles: service_usb() from the loops that poll USB, NULL from the loops
 * that run USB off its interrupt. Those two waits are most of a hop, around
 * 300 us, and in follow mode a hop happens every 625 us, so without the
 * callback endpoint 0 goes unserviced for most of every slot pair (see
 * service_usb()).
 *
 * A request serviced inside those waits cannot disturb the hop mode or the
 * AFH map, which are read before the first wait, and that is also what keeps
 * the map rebuild safe (see precalc()). It can disturb the channel: FSDIV
 * below is written from the global, so a UBERTOOTH_SET_CHANNEL retunes this
 * hop to the host's channel. Nothing ends up inconsistent, since the channel
 * reported and the one in the packet headers come from that same global. A
 * request that writes a radio register directly, which only the developer
 * requests behind `ubertooth-util -a` and `ubertooth-debug` do, can land
 * between the register write and the strobe below and spoil the one hop.
 */
void hop(void (*service)(void))
{
	do_hop = 0;
	last_hop = clkn;

	// No hopping, if channel is set correctly, do nothing
	if (hop_mode == HOP_NONE) {
		if (cc2400_get(FSDIV) == (channel - 1))
			return;
	}
	/* Slow sweep (100 hops/sec)
	 * only hop to currently used channels if AFH is enabled
	 */
	else if (hop_mode == HOP_SWEEP) {
		do {
			channel += 32;
			if (channel > BT_FREQ_MAX)
				channel -= BT_FREQ_MAX - BT_FREQ_MIN + 1;
		} while ( used_channels != 0 && afh_enabled && !( afh_map[(channel-BT_FREQ_MIN)/8] & 0x1<<((channel-BT_FREQ_MIN)%8) ) );
	}

	/* AFH detection
	 * only hop to currently unused channesl
	 */
	else if (hop_mode == HOP_AFH) {
		do {
			channel += 32;
			if (channel > BT_FREQ_MAX)
				channel -= BT_FREQ_MAX - BT_FREQ_MIN + 1;
		} while( used_channels != NUM_BREDR_CHANNELS && (afh_map[(channel-BT_FREQ_MIN)/8] & 0x1<<((channel-BT_FREQ_MIN)%8)) );
	}

	else if (hop_mode == HOP_BLUETOOTH) {
		channel = next_hop(clkn);
	}

	else if (hop_mode == HOP_BTLE) {
		channel = btle_next_hop(&le);
	}

	else if (hop_mode == HOP_DIRECT) {
		channel = hop_direct_channel;
	}
	/* IDLE mode, but leave amp on, so don't call cc2400_idle(). */
	cc2400_strobe(SRFOFF);
	cc2400_wait_fs(0, service);

	/* Retune */
	if(mode == MODE_TX_SYMBOLS)
		cc2400_set(FSDIV, channel);
	else
		cc2400_set(FSDIV, channel - 1);

	/* Update CS register if hopping.  */
	if (hop_mode > 0) {
		cs_threshold_calc_and_set(channel);
	}

	/* Wait for lock */
	cc2400_strobe(SFSON);
	cc2400_wait_fs(1, service);

	dma_discard = 1;

	if(mode == MODE_TX_SYMBOLS) {
#ifdef TX_ENABLE
		cc2400_strobe(STX);
#endif
	} else {
		cc2400_strobe(SRX);
	}
}

/*
 * Program the demodulator for a modulation the host stated after its mode
 * request, and return the modulation the radio now has.
 *
 * `programmed` is the one cc2400_rx() wrote MDMCTRL for as the mode came up.
 * Every per-capture setting is stated after the mode request, because a mode
 * start puts it back to its default; the channel survives that order because
 * every hop writes FSDIV again, but MDMCTRL is written once, so without this
 * a modulation stated in the same order would reach the global and not the
 * radio.
 *
 * The radio comes off the air for the write and back on afterwards, as a hop
 * does, so the demodulator starts on the new deviation rather than taking it
 * part-way through a packet. The buffer being filled goes with it: a block
 * marked discarded is a better answer than a block of two halves.
 *
 * Only between the two modulations the Bluetooth receive configures. A generic
 * receive comes into the loop with MOD_NONE and its modem registers set by the
 * host, and those are not this function's to overwrite.
 */
static uint8_t program_stated_modulation(uint8_t programmed)
{
	/* One read of a value the request handler writes, so the register and
	 * the return below cannot be for two different modulations. */
	uint8_t wanted = modulation;

	if (wanted == programmed || !programs_modulation(wanted) ||
	    !programs_modulation(programmed))
		return programmed;

	/* IDLE mode, but leave the amplifier on, as hop() does. */
	cc2400_strobe(SRFOFF);
	cc2400_wait_fs(0, service_usb);

	cc2400_set(MDMCTRL, mdmctrl_deviation(wanted));

	cc2400_strobe(SFSON);
	cc2400_wait_fs(1, service_usb);

	dma_discard = 1;

	cc2400_strobe(SRX);

	return wanted;
}

/* Bluetooth packet monitoring */
void bt_stream_rx()
{
	int8_t rssi;
	int8_t rssi_at_trigger;
	/* The modulation MDMCTRL has been written for; see
	 * program_stated_modulation(). Read after cc2400_rx(), because that is
	 * what it programmed the radio from. */
	uint8_t radio_modulation;

	RXLED_CLR;

	usb_queue_init();
	dio_ssp_init();
	dma_init_rx_symbols();
	dio_ssp_start();

	cc2400_rx();
	radio_modulation = modulation;

	cs_trigger_enable();

	/*
	 * Every mode the dispatch runs through this loop has to be listed here,
	 * or the mode returns at once and the board streams nothing while the
	 * dispatch sits in it. test_mode_dispatch.c checks the list against the
	 * dispatch.
	 *
	 * Asking for one of these modes while another is streaming is absorbed
	 * here rather than going through the dispatch, so a mode in the list
	 * must be one whose own vendor request sets up everything it needs, and
	 * each of the three calls reset_absorbed_mode_state() first to clear
	 * what leaving a mode would have cleared.
	 *
	 * MODE_RX_GENERIC is listed only while it is the mode the dispatch
	 * recorded, because rx_generic() is where its two receives are told
	 * apart and the symbol stream is set up. So a request for it from
	 * another streaming mode ends this loop and goes through the dispatch
	 * instead, and the other three are kept out of a generic receive, which
	 * is entered with modulation = MOD_NONE and would stream unmodulated
	 * symbols under their name.
	 */
	while ( ( requested_mode == MODE_RX_GENERIC
	          && mode == MODE_RX_GENERIC )
	     || ( mode != MODE_RX_GENERIC
	          && ( requested_mode == MODE_RX_SYMBOLS
	            || requested_mode == MODE_BT_FOLLOW
	            || requested_mode == MODE_AFH ) ) )
	{

		RXLED_CLR;

		/* Wait for DMA transfer. TODO - need more work on
		 * RSSI. Should send RSSI indications to host even
		 * when not transferring data. That would also keep
		 * the USB stream going. This loop runs 50-80 times
		 * while waiting for DMA, but RSSI sampling does not
		 * cover all the symbols in a DMA transfer. Can not do
		 * RSSI sampling in CS interrupt, but could log time
		 * at multiple trigger points there. The MAX() below
		 * helps with statistics in the case that cs_trigger
		 * happened before the loop started. */
		rssi_reset();
		rssi_at_trigger = INT8_MIN;
		while (!rx_tc) {
			rssi = (int8_t)(cc2400_get(RSSI) >> 8);
			if (cs_trigger && (rssi_at_trigger == INT8_MIN)) {
				rssi = MAX(rssi,(cs_threshold_cur+54));
				rssi_at_trigger = rssi;
			}
			rssi_add(rssi);

			service_usb();

			/* Here rather than once per block, so a capture spends
			 * microseconds on a modulation it was not asked for
			 * rather than a whole block. */
			radio_modulation = program_stated_modulation(radio_modulation);

			/* If timer says time to hop, do it. The hop keeps
			 * servicing USB while the synthesizer settles. */
			if (do_hop) {
				/* A background level belongs to one channel. */
				rssi_noise_reset();
				hop(service_usb);
			} else {
				TXLED_CLR;
			}
			/* TODO - set per-channel carrier sense threshold.
			 * Set by firmware or host. */
		}

		RXLED_SET;

		if (rx_err) {
			status |= DMA_ERROR;
		}

		/* Missed a DMA trasfer? */
		if (rx_tc > 1)
			status |= DMA_OVERFLOW;

		if (dma_discard) {
			status |= DISCARD;
			dma_discard = 0;
		}

		rssi_iir_update(channel);

		/* Set squelch hold if there was either a CS trigger, squelch
		 * is disabled, or if the current rssi_max is above the same
		 * threshold. Currently, this is redundant, but allows for
		 * per-channel or other rssi triggers in the future. */
		if (cs_trigger || cs_no_squelch) {
			status |= CS_TRIGGER;
			cs_trigger = 0;
		}

		if (rssi_max >= (cs_threshold_cur + 54)) {
			status |= RSSI_TRIGGER;
		}

		enqueue(BR_PACKET, (uint8_t*)idle_rxbuf);

		service_usb();
		rx_tc = 0;
		rx_err = 0;
	}

	dio_ssp_stop();
	cs_trigger_disable();
}

static uint8_t reverse8(uint8_t data)
{
	uint8_t reversed = 0;

	for(size_t i=0; i<8; i++)
	{
		reversed |= ((data >> i) & 0x01) << (7-i);
	}

	return reversed;
}

static uint16_t reverse16(uint16_t data)
{
	uint16_t reversed = 0;

	for(size_t i=0; i<16; i++)
	{
		reversed |= ((data >> i) & 0x01) << (15-i);
	}

	return reversed;
}

/*
 * Transmit a BTBR packet with the specified access code.
 *
 * All modulation parameters are set within this function.
 */
#ifdef TX_ENABLE
/* How long before br_transmit()'s transmit point it stops servicing USB, in
 * T0TC's 100 ns ticks: 100 us, longer than a typical service pass.
 *
 * It is not a guarantee, since handle_usb() has no deadline of its own and a
 * single request can be long. A pass that overruns costs this packet its
 * slot, which the host sees as a gap in the transmitted stream rather than as
 * a board that stopped answering. */
#define TX_USB_SERVICE_MARGIN 1000

void br_transmit()
{
	uint16_t gio_save;

	uint32_t clkn_saved = 0;

	uint16_t preamble = (target.syncword & 1) == 1 ? 0x5555 : 0xaaaa;
	uint8_t trailer = ((target.syncword >> 63) & 1) == 1 ? 0xaa : 0x55;

	uint8_t data[16] = {
		reverse8((target.syncword >> 0) & 0xFF),
		reverse8((target.syncword >> 8) & 0xFF),
		reverse8((target.syncword >> 16) & 0xFF),
		reverse8((target.syncword >> 24) & 0xFF),
		reverse8((target.syncword >> 32) & 0xFF),
		reverse8((target.syncword >> 40) & 0xFF),
		reverse8((target.syncword >> 48) & 0xFF),
		reverse8((target.syncword >> 56) & 0xFF),
		reverse8(trailer),
		reverse8(0x77),
		reverse8(0x66),
		reverse8(0x55),
		reverse8(0x44),
		reverse8(0x33),
		reverse8(0x22),
		reverse8(0x11)
	};

	cc2400_tx_sync(reverse16(preamble));

	cc2400_set(INT,     0x0014);    // FIFO_THRESHOLD: 20 bytes

	// set GIO to FIFO_FULL
	gio_save = cc2400_get(IOCFG);
	cc2400_set(IOCFG, (GIO_FIFO_FULL << 9) | (gio_save & 0x1ff));

	while ( requested_mode == MODE_TX_SYMBOLS )
	{

		/* Wait for the next pair of slots, servicing USB meanwhile, or
		 * endpoint 0 goes unserviced for most of 625 us.
		 *
		 * The service has to stop before the transmit point. T0TC counts
		 * 100 ns ticks and wraps every 3125, so `T0TC < 2250` is the
		 * last 87.5 us of a tick and the FIFO write below has to land in
		 * it: the service stops a margin ahead of 2250 and the loop
		 * spins out the rest. While the slot pair has not advanced there
		 * is no deadline at all, because the wait for T0TC starts over
		 * on the next tick. */
		while ((clkn >> 1) == (clkn_saved >> 1) || T0TC < 2250) {
			if ((clkn >> 1) == (clkn_saved >> 1)
			    || T0TC < 2250 - TX_USB_SERVICE_MARGIN) {
				service_usb();
			}

			// If timer says time to hop, do it.
			if (do_hop) {
				hop(service_usb);
			}
		}

		clkn_saved = clkn;

		TXLED_SET;

		cc2400_fifo_write(16, data);

		/* The waits below are bounded and keep servicing USB, so a radio
		 * that stops advancing does not take the board with it: the host
		 * can still stop the mode. */
		cc2400_wait_fsm(STATE_STROBE_FS_ON, service_usb);
		TXLED_CLR;

		cc2400_strobe(SRFOFF);
		cc2400_wait_fs(0, service_usb);

		cc2400_wait_xosc_stable(service_usb);
		cc2400_strobe(SFSON);
		cc2400_wait_fs(1, service_usb);

		cc2400_wait_fsm(STATE_STROBE_FS_ON, service_usb);
		cc2400_strobe(STX);

		service_usb();
	}

#ifdef UBERTOOTH_ONE
	PAEN_CLR;
#endif

	// reset GIO
	cc2400_set(IOCFG, gio_save);
}
#endif

/* set LE access address */
static void le_set_access_address(u32 aa) {
	u32 aa_rev;

	le.access_address = aa;
	aa_rev = rbit(aa);
	le.syncl = aa_rev & 0xffff;
	le.synch = aa_rev >> 16;
}

/*
 * reset le state, called by bt_generic_le and bt_follow_le()
 *
 * This runs after the request that asked for the mode has been answered, so
 * every field of le_state_t is cleared except the four carrying what the host
 * asked this capture for: do_follow and the address filter (target,
 * target_mask, target_set). Clearing those would throw away the command line
 * the capture was started with.
 *
 * The CRC check is a host setting too, but a promiscuous capture recovers
 * CRCInit and turns it on by itself, so it starts off again here and
 * ubertooth-btle(1) sends it after the mode request rather than before.
 *
 * test_le_state_reset.c fails if a field is added to the struct without being
 * cleared here or named there as one to keep.
 */
void reset_le() {
	le_set_access_address(0x8e89bed6);     // advertising channel access address
	/* The address above is this reset's own, not one the host chose, so
	 * the next promiscuous pass has to discover one rather than follow
	 * it. The connection timeout resets here too, which is how an
	 * access address the host gave stops being followed after the
	 * connection it belonged to has gone. */
	le.access_address_set = 0;
	le.crc_init  = 0x555555;               // advertising channel CRCInit
	le.crc_init_reversed = 0xAAAAAA;
	le.crc_verify = 0;
	le.last_packet = 0;

	le.link_state = LINK_INACTIVE;

	le.channel_idx = 0;
	le.channel_increment = 0;
	le.chan_sel_2 = 0;
	le.event_counter = 0;

	le.conn_epoch = 0;
	le.interval_timer = 0;
	le.conn_interval = 0;
	le.conn_count = 0;

	le.win_size = 0;
	le.win_offset = 0;

	le.update_pending = 0;
	le.update_instant = 0;
	le.interval_update = 0;
	le.win_size_update = 0;
	le.win_offset_update = 0;

	do_hop = 0;
}

// reset LE Promisc state
void reset_le_promisc(void) {
	memset(&le_promisc, 0, sizeof(le_promisc));
}

/* generic le mode */
void bt_generic_le(u8 active_mode)
{
	u8 hold;
	int i, j;
	int8_t rssi, rssi_at_trigger;
	uint8_t site;

	modulation = MOD_BT_LOW_ENERGY;
	mode = active_mode;

	reset_le();

	/* The loop below searches the whole symbol buffer from the first pass
	 * on, including the half it has not filled yet. That half holds
	 * whatever the other half of the mode left in the shared buffer, so it
	 * is cleared rather than searched as if it were received symbols. */
	memset(le_rx.symbols, 0, sizeof(le_rx.symbols));

	// enable USB interrupts
	ISER0 = ISER0_ISE_USB;

	RXLED_CLR;

	usb_queue_init();
	dio_ssp_init();
	dma_init_rx_symbols();
	dio_ssp_start();
	cc2400_rx();

	cs_trigger_enable();

	hold = 0;

	while (requested_mode == active_mode) {
		watchdog_usb_ready();

		if (requested_channel != 0) {
			cc2400_strobe(SRFOFF);
			cc2400_wait_fs_unlock();

			/* Retune */
			cc2400_set(FSDIV, channel - 1);

			/* Wait for lock */
			cc2400_strobe(SFSON);
			cc2400_wait_fs(1, NULL);

			/* RX mode */
			cc2400_strobe(SRX);

			/* A background level belongs to one channel. */
			rssi_noise_reset();
			requested_channel = 0;
		}

		/* No service callback: this mode runs USB off its interrupt, which
		 * it enabled on the way in, so endpoint 0 is serviced during the
		 * hop without the loop doing anything. */
		if (do_hop) {
			/* A background level belongs to one channel. */
			rssi_noise_reset();
			hop(NULL);
		} else {
			TXLED_CLR;
		}

		RXLED_CLR;

		/* Wait for DMA. Meanwhile keep track of RSSI. */
		rssi_reset();
		rssi_at_trigger = INT8_MIN;
		/* This wait has no deadline: on a quiet channel no packet ever
		 * completes the transfer, so it can last as long as the capture
		 * does. It feeds the watchdog, as the top of the loop does,
		 * because it is the loop's own code and runs below every
		 * interrupt handler. */
		site = watchdog_mark(WATCHDOG_SITE_LE_RX);
		while ((rx_tc == 0) && (rx_err == 0))
		{
			watchdog_usb_ready();
			rssi = (int8_t)(cc2400_get(RSSI) >> 8);
			if (cs_trigger && (rssi_at_trigger == INT8_MIN)) {
				rssi = MAX(rssi,(cs_threshold_cur+54));
				rssi_at_trigger = rssi;
			}
			rssi_add(rssi);
		}
		watchdog_mark(site);

		if (rx_err) {
			status |= DMA_ERROR;
		}

		/* No DMA transfer? */
		if (!rx_tc)
			goto rx_continue;

		/* Missed a DMA trasfer? */
		if (rx_tc > 1)
			status |= DMA_OVERFLOW;

		rssi_iir_update(channel);

		/* Set squelch hold if there was either a CS trigger, squelch
		 * is disabled, or if the current rssi_max is above the same
		 * threshold. Currently, this is redundant, but allows for
		 * per-channel or other rssi triggers in the future. */
		if (cs_trigger || cs_no_squelch) {
			status |= CS_TRIGGER;
			hold = CS_HOLD_TIME;
			cs_trigger = 0;
		}

		if (rssi_max >= (cs_threshold_cur + 54)) {
			status |= RSSI_TRIGGER;
			hold = CS_HOLD_TIME;
		}

		/* Hold expired? Ignore data. */
		if (hold == 0) {
			goto rx_continue;
		}
		hold--;

		// copy the previously unpacked symbols to the front of the buffer
		memcpy(le_rx.symbols, le_rx.symbols + DMA_SIZE*8, DMA_SIZE*8);

		// unpack the new packet to the end of the buffer
		for (i = 0; i < DMA_SIZE; ++i) {
			/* output one byte for each received symbol (0x00 or 0x01) */
			for (j = 0; j < 8; ++j) {
				le_rx.symbols[DMA_SIZE*8 + i * 8 + j] = (idle_rxbuf[i] & 0x80) >> 7;
				idle_rxbuf[i] <<= 1;
			}
		}

		int ret = data_cb(le_rx.symbols);
		if (!ret) break;

	rx_continue:
		rx_tc = 0;
		rx_err = 0;
	}

	// disable USB interrupts
	ICER0 = ICER0_ICE_USB;

	// Reset the radio completely. bt_promisc_le() runs this mode and
	// bt_le_sync() in turn and starts each half from the state this leaves,
	// so it is not only a teardown.
	cc2400_idle();
	dio_ssp_stop();
	cs_trigger_disable();
}


/*
 * How long a followed connection may go unheard before it is taken to be over
 * and the mode starts again.
 *
 * Five seconds for a connection the board can hear every event of.
 *
 * A connection recovered by the algorithm-2 search is followed without its
 * channel map, so the board lands on the right channel for only some of its
 * events and a run of unheard events is normal. It is given
 * LE_CSA2_SILENCE_EVENTS connection intervals instead, so that a connection
 * being followed correctly is not thrown away and recovered from the
 * beginning, which at a long interval takes many minutes.
 */
static u32 le_silence_timeout(void)
{
	u32 events;

	if (!le.chan_sel_2 || le.conn_interval == 0)
		return 5 * 10000000u;

	/* Unsigned, as LE_PROMISC_MAX_GAP is: at the longest interval a
	 * connection may use this product is 2.56 billion, which does not fit
	 * in the int the operands would otherwise promote to. */
	events = (u32)LE_CSA2_SILENCE_EVENTS * le.conn_interval * LE_BASECLK;
	return events > 5 * 10000000u ? events : 5 * 10000000u;
}

/*
 * Keeps reads of the low-energy receive buffer after the wait that ended
 * because the DMA had filled it. The controller writes the buffer without the
 * compiler knowing, and the waits watch registers rather than the buffer, so
 * without this a load could legally be hoisted above one of them.
 *
 * A data barrier, not only a compiler one: the waits read the controller's
 * registers, which are device memory, and ARMv7-M allows a read of ordinary
 * memory to be reordered against those.
 */
static inline void le_rx_barrier(void)
{
	__asm__ volatile ("dmb" ::: "memory");
}

void bt_le_sync(u8 active_mode)
{
	int8_t rssi;
	uint8_t site;
	static int restart_jamming = 0;

	modulation = MOD_BT_LOW_ENERGY;
	mode = active_mode;

	le.link_state = LINK_LISTENING;

	// enable USB interrupts
	ISER0 = ISER0_ISE_USB;

	RXLED_CLR;

	usb_queue_init();
	dio_ssp_init();
	dma_init_le(le_rx.packet + 4, LE_RX_PDU_MAX);
	dio_ssp_start();

	/* The access address promiscuous mode is about to follow. Announced
	 * here because the queue reset above empties anything queued earlier,
	 * so this is the first point at which the host can be told and the only
	 * place it is told, and both ways into the mode come through here.
	 *
	 * The clock is stopped and the channel registers are clear here, so the
	 * record is stamped channel 0 at clock 0; the host prints the state
	 * line and returns before it reads either. */
	if (active_mode == MODE_BT_PROMISC_LE)
		le_promisc_state(0, &le.access_address, 4);

	cc2400_rx_sync(rbit(le.access_address)); // bit-reversed access address

	while (requested_mode == active_mode) {
		watchdog_usb_ready();

		if (requested_channel != 0) {
			cc2400_strobe(SRFOFF);
			cc2400_wait_fs_unlock();

			/* Retune */
			cc2400_set(FSDIV, channel - 1);

			/* Wait for lock */
			cc2400_strobe(SFSON);
			cc2400_wait_fs(1, NULL);

			/* RX mode */
			cc2400_strobe(SRX);

			/* A background level belongs to one channel. */
			rssi_noise_reset();
			requested_channel = 0;
		}

		RXLED_CLR;

		/* Wait for DMA. Meanwhile keep track of RSSI. */
		rssi_reset();
		/* Nothing bounds this wait: following a connection, the next
		 * thing to end it is the hop at the end of the connection
		 * interval, which BLE allows to be as long as 4 s. It feeds the
		 * watchdog for the reason the wait in bt_generic_le() does. */
		site = watchdog_mark(WATCHDOG_SITE_LE_RX);
		while ((rx_tc == 0) && (rx_err == 0) && (do_hop == 0) && requested_mode == active_mode)
			watchdog_usb_ready();
		watchdog_mark(site);

		/* One reading for the whole packet, taken as it ends: this mode
		 * has the radio deliver whole packets rather than polling
		 * through them, so there is one moment to read its power at. */
		rssi = (int8_t)(cc2400_get(RSSI) >> 8);
		rssi_add(rssi);

		if (requested_mode != active_mode) {
			goto cleanup;
		}

		if (rx_err) {
			status |= DMA_ERROR;
		}

		if (do_hop)
			goto rx_flush;

		/* No packet. A transfer error is the only thing that can end the
		 * wait without one, since a mode change and a hop are handled
		 * above, so this must go where the error is recovered from:
		 * rx_flush drains the symbols the error left in the receiver and
		 * arms the transfer again, and is the one place rx_err is
		 * cleared. A `continue` here would leave rx_err set, so every
		 * later pass would arrive back here and the capture would look
		 * alive while receiving nothing. */
		if (!rx_tc)
			goto rx_flush;

		/////////////////////
		// process the packet

		/* The packet as the host will see it: the access address the radio
		 * synchronized on, then the bytes the DMA put after it. */
		u8 *p = le_rx.packet;
		/* The DMA writes into that buffer without the compiler knowing,
		 * so a read of it must not be moved above the wait that has just
		 * ended because the bytes are there. The buffer is not volatile:
		 * the dewhitening below reads it a word at a time. */
		le_rx_barrier();
		memcpy(p, &le.access_address, 4);

		/* The first four bytes, which is what the DMA's first item has
		 * delivered so far (LE_DMA_HEAD). The length field is among
		 * them, and it is what says how much more to wait for. */
		le_dewhiten_from(p + 4, LE_DMA_HEAD, channel, 0);

		/* The buffer holds whatever the 8-bit length field can claim, so
		 * nothing has to be refused to keep the capture inside it. Two
		 * lengths are still refused, because waiting for bytes is not
		 * free: noise occasionally looks like a 32-bit access address,
		 * and the longest packet takes about 2 ms to arrive -- blind
		 * time in which the next connection event is missed. */
		if (!le_length_is_possible(p[5], le.crc_verify))
			goto rx_flush;

		unsigned len = p[5] + 2;
		unsigned pdu_bytes = len + 3;   /* header, payload and CRC */

		/* Take only the bytes this packet needs, so there is time to resume
		 * receive before the next packet on this channel.
		 *
		 * The wait ends when the controller has the bytes, when it runs out
		 * of packet to deliver them into, on a mode change, or when the
		 * bytes are overdue: a length field corrupted by noise can ask for
		 * the longest packet there is, and a host that stops the mode
		 * meanwhile must not be left waiting for bytes the radio has
		 * stopped sending.
		 *
		 * The deadline is what covers the radio stopping mid-packet
		 * while the transfer stays armed: nothing else ends the wait
		 * then, and a host waiting for capture data never changes mode,
		 * so the capture would look alive and record nothing.
		 *
		 * The time is added up step by step rather than compared against
		 * a deadline, because the capture clock briefly runs backwards:
		 * clk100ns_step() says why. */
		unsigned want = 4 * ((pdu_bytes + 3) / 4);
		uint32_t wait_budget = le_rx_byte_wait_clk100ns(want);
		uint32_t waited = 0;
		uint32_t last_tick = T0TC;
		int overdue = 0;
		while (DMACC0DestAddr < (uint32_t)(p + 4) + want
		       && (DMACC0Config & DMACCxConfig_E) && rx_err == 0
		       && requested_mode == active_mode) {
			uint32_t now_tick = T0TC;

			waited += clk100ns_step(last_tick, now_tick);
			last_tick = now_tick;
			if (waited > wait_budget) {
				overdue = 1;
				break;
			}
		}
		/* Whether the whole packet arrived, which is why the wait ended.
		 * The receive buffer is reused, so the bytes a packet cut short by
		 * a transfer error or by the deadline is missing are the previous
		 * packet's: a record built from those would be a packet that was
		 * never on the air. */
		int whole = rx_err == 0 && !overdue &&
		            DMACC0DestAddr >= (uint32_t)(p + 4) + want;
		if (requested_mode != active_mode)
			goto cleanup;
		if (rx_err)
			status |= DMA_ERROR;
		if (overdue)
			cc2400_wait_count_timeout(CC2400_WAIT_RX_BYTES);
		DIO_SSP_DMACR &= ~SSPDMACR_RXDMAE;
		if (!whole)
			goto rx_flush;
		le_rx_barrier();

		// strobe SFSON to allow the resync to occur while we process the packet
		cc2400_strobe(SFSON);

		/* Unwhiten the rest of the packet, carrying on from the four
		 * bytes already done above. */
		le_dewhiten_from(p + 4 + LE_DMA_HEAD, pdu_bytes - LE_DMA_HEAD,
		                 channel, LE_DMA_HEAD);

		if (le.crc_verify) {
			u32 calc_crc = btle_crcgen_lut(le.crc_init_reversed, p + 4, len);
			u32 wire_crc = (p[4+len+2] << 16)
						 | (p[4+len+1] << 8)
						 | (p[4+len+0] << 0);
			if (calc_crc != wire_crc) // skip packets with a bad CRC
				goto rx_flush;
		}


		RXLED_SET;
		packet_cb(p);

		le_pkt_meta meta;
		meta.status = status;
		meta.channel = ubertooth_channel_byte(idle_buf_channel);
		meta.clkn_high = idle_buf_clkn_high;
		meta.clk100ns = idle_buf_clk100ns;
		meta.rssi_min = rssi_min;
		meta.rssi_max = rssi_max;
		meta.rssi_avg = rssi_get_signal();
		meta.rssi_count = rssi_count;
		meta.rssi_noise = 0;
		if (rssi_count != 0) {
			meta.status |= SIGNAL_VALID;
			if (rssi_noise_estimated()) {
				meta.rssi_noise = (uint8_t) rssi_get_noise();
				meta.status |= NOISE_ESTIMATE;
			}
		}

		// hold the USB interrupt off while we touch USB data structures:
		// UBERTOOTH_POLL dequeues from the vendor request handler, which
		// runs from that interrupt in this mode
		u32 usb_irq = usb_irq_hold();
		/* A packet of more than 50 bytes goes out as several records, which
		 * the host puts back together. */
		if (usb_enqueue_le_packet(&meta, p, p + 4, pdu_bytes))
			status = 0;
		else
			status |= FIFO_OVERFLOW;
		usb_irq_release(usb_irq);

		le.last_packet = CLK100NS;

	rx_flush:
		// this might happen twice, but it's safe to do so
		cc2400_strobe(SFSON);

		// flush any excess bytes from the SSP's buffer
		DIO_SSP_DMACR &= ~SSPDMACR_RXDMAE;
		while (SSP1SR & SSPSR_RNE) {
			u8 tmp = (u8)DIO_SSP_DR;
		}

		// timeout - FIXME this is an ugly hack
		u32 now = CLK100NS;
		if (now < le.last_packet)
			now += CLK100NS_PERIOD; // handle rollover
		if  ( // timeout
			((le.link_state == LINK_CONNECTED || le.link_state == LINK_CONN_PENDING)
			&& (now - le.last_packet > le_silence_timeout()))
			// jam finished
			|| (le_jam_count == 1)
			)
		{
			reset_le();
			le_jam_count = 0;
			TXLED_CLR;

			if (jam_mode == JAM_ONCE) {
				jam_mode = JAM_NONE;
				requested_mode = MODE_IDLE;
				goto cleanup;
			}

			// go back to promisc if the connection dies
			if (active_mode == MODE_BT_PROMISC_LE)
				goto cleanup;

			le.link_state = LINK_LISTENING;

			cc2400_strobe(SRFOFF);
			cc2400_wait_fs_unlock();

			/* Retune */
			channel = le_adv_channel != 0 ? le_adv_channel : BT_FREQ_MIN;
			restart_jamming = 1;
		}

		cc2400_set(SYNCL, le.syncl);
		cc2400_set(SYNCH, le.synch);

		/* No service callback, as in bt_generic_le(): USB runs off its
		 * interrupt here. */
		if (do_hop) {
			/* A background level belongs to one channel. */
			rssi_noise_reset();
			hop(NULL);
		}

		/* The terminal count is cleared by dma_init_le() below, before it
		 * arms the channel, so nothing clears it here: a count raised after
		 * arming is this iteration's and has to be kept. */

		// ♪ you can jam but you keep turning off the light ♪
		if (le_jam_count > 0) {
#ifdef TX_ENABLE
			le_jam();
#endif
			--le_jam_count;
		} else {
			/* RX mode */
			dma_init_le(le_rx.packet + 4, LE_RX_PDU_MAX);
			dio_ssp_start();

			if (restart_jamming) {
				cc2400_rx_sync(rbit(le.access_address));
				restart_jamming = 0;
			} else {
				// wait till we're in FSLOCK before strobing RX
				cc2400_wait_fs(1, NULL);
				cc2400_strobe(SRX);
			}
		}
	}

cleanup:

	// disable USB interrupts
	ICER0 = ICER0_ICE_USB;

	// reset the radio completely (as in bt_generic_le(): bt_promisc_le()
	// starts its next pass from this state)
	cc2400_idle();
	dio_ssp_stop();
	cs_trigger_disable();
}



/* How much of a packet the callback below decodes out of the symbol buffer:
 * the four bytes of the access address and 42 bytes of PDU. Nothing may be
 * read past the bytes this number covers. */
#define FOLLOW_LE_BYTES 46

_Static_assert(FOLLOW_LE_BYTES <= DMA_SIZE,
               "the connection-follow callback decodes more than its buffer holds");

/* low energy connection following
 * follows a known AA around */
int cb_follow_le() {
	int i, j, k;
	int idx = whitening_index[btle_channel_index(channel)];

	u32 access_address = 0;
	for (i = 0; i < 31; ++i) {
		access_address >>= 1;
		access_address |= (le_rx.symbols[i] << 31);
	}

	for (i = 31; i < DMA_SIZE * 8 + 32; i++) {
		access_address >>= 1;
		access_address |= (le_rx.symbols[i] << 31);
		if (access_address == le.access_address) {
			for (j = 0; j < FOLLOW_LE_BYTES; ++j) {
				u8 byte = 0;
				for (k = 0; k < 8; k++) {
					int offset = k + (j * 8) + i - 31;
					if (offset >= DMA_SIZE*8*2) break;
					int bit = le_rx.symbols[offset];
					if (j >= 4) { // unwhiten data bytes
						bit ^= whitening[idx];
						idx = (idx + 1) % sizeof(whitening);
					}
					byte |= bit << k;
				}
				idle_rxbuf[j] = byte;
			}

			/* The length field is a whole byte in a low-energy
			 * header: the six-bit field belongs to the Basic Rate
			 * packets elsewhere in this file. */
			int len = idle_rxbuf[5] + 2;

			/* A header claiming more than the bytes decoded above
			 * belongs to a packet that arrived cut short: there is
			 * no CRC of it to check without reading past the
			 * buffer, and a record of it would claim bytes that
			 * were never decoded.
			 *
			 * This is the buffer's own bound, not the judgment
			 * le_length_is_possible() makes for the other capture
			 * loop, which allows a Data Length Extension payload
			 * that does not fit here. */
			if (4 + len + 3 > FOLLOW_LE_BYTES)
				break;

			// verify CRC
			if (le.crc_verify) {
				u32 calc_crc = btle_crcgen_lut(le.crc_init_reversed, (uint8_t*)idle_rxbuf + 4, len);
				u32 wire_crc = (idle_rxbuf[4+len+2] << 16)
				             | (idle_rxbuf[4+len+1] << 8)
				             |  idle_rxbuf[4+len+0];
				if (calc_crc != wire_crc) // skip packets with a bad CRC
					break;
			}

			// send to PC
			enqueue(LE_PACKET, (uint8_t*)idle_rxbuf);
			RXLED_SET;

			packet_cb((uint8_t*)idle_rxbuf);

			break;
		}
	}

	return 1;
}

/**
 * Called when we receive a packet in connection following mode.
 */
void connection_follow_cb(u8 *packet) {
	int i;
	u32 aa = 0;

#define ADV_ADDRESS_IDX 0
#define HEADER_IDX 4
#define DATA_LEN_IDX 5
#define DATA_START_IDX 6

	// u8 *adv_addr = &packet[ADV_ADDRESS_IDX];
	u8 header = packet[HEADER_IDX];
	u8 *data_len = &packet[DATA_LEN_IDX];
	u8 *data = &packet[DATA_START_IDX];
	// u8 *crc = &packet[DATA_START_IDX + *data_len];

	if (le.link_state == LINK_CONN_PENDING) {
		// We received a packet in the connection pending state, so now the device *should* be connected
		le.link_state = LINK_CONNECTED;
		le.conn_epoch = clkn;
		le.interval_timer = le.conn_interval - 1;
		le.conn_count = 0;
		le.update_pending = 0;

		// hue hue hue
		if (jam_mode != JAM_NONE)
			le_jam_count = JAM_COUNT_DEFAULT;

	} else if (le.link_state == LINK_CONNECTED) {
		u8 llid =  header & 0x03;

		// Apply any connection parameter update if necessary
		if (le.update_pending && le.conn_count == le.update_instant) {
			// This is the first packet received in the connection interval for which the new parameters apply
			le.conn_epoch = clkn;
			le.conn_interval = le.interval_update;
			le.interval_timer = le.interval_update - 1;
			le.win_size = le.win_size_update;
			le.win_offset = le.win_offset_update;
			le.update_pending = 0;
		}

		/* A connection update carries twelve bytes: the opcode and the
		 * eleven fields read below. A shorter control packet claiming to
		 * be one would have those fields read from whatever the buffer
		 * held before it, and the connection followed from there. */
		if (llid == 0x03 && *data_len >= 12 && data[0] == 0x00) {
			// This is a CONNECTION_UPDATE_REQ.
			// The host is changing the connection parameters.
			le.win_size_update = packet[7];
			le.win_offset_update = packet[8] + ((u16)packet[9] << 8);
			le.interval_update = packet[10] + ((u16)packet[11] << 8);
			le.update_instant = packet[16] + ((u16)packet[17] << 8);
			if (le.update_instant - le.conn_count < 32767)
				le.update_pending = 1;
		}

	} else if (le.link_state == LINK_LISTENING) {
		u8 pkt_type = packet[4] & 0x0F;
		if (pkt_type == 0x05) {
			uint16_t conn_interval;

			// ignore packets with incorrect length
			if (*data_len != 34)
				return;

			// conn interval must be [7.5 ms, 4.0s] in units of 1.25 ms
			conn_interval = (packet[29] << 8) | packet[28];
			if (conn_interval < LE_MIN_CONN_INTERVAL ||
					conn_interval > LE_MAX_CONN_INTERVAL)
				return;

			// This is a connect packet
			// if we have a target, see if InitA or AdvA matches
			if (le.target_set &&
				memcmp(le.target, &packet[6], 6) &&  // Target address doesn't match Initiator.
				memcmp(le.target, &packet[12], 6)) {  // Target address doesn't match Advertiser.
				return;
			}

			le.link_state = LINK_CONN_PENDING;
			le.crc_verify = 0; // we will drop many packets if we attempt to filter by CRC

			for (i = 0; i < 4; ++i)
				aa |= packet[18+i] << (i*8);
			le_set_access_address(aa);

#define CRC_INIT (2+4+6+6+4)
			le.crc_init = (packet[CRC_INIT+2] << 16)
						| (packet[CRC_INIT+1] << 8)
						|  packet[CRC_INIT+0];
			/* CRCInit is 24 bits wide. rbit() reverses all 32 bits of
			 * the word, so the result has to come down by a byte to be
			 * the reversal of the field: 0x123456 reverses to 0x6a2c48,
			 * not 0x2c4800. */
			le.crc_init_reversed = rbit(le.crc_init) >> 8;

#define WIN_SIZE (2+4+6+6+4+3)
			le.win_size = packet[WIN_SIZE];

#define WIN_OFFSET (2+4+6+6+4+3+1)
			le.win_offset = packet[WIN_OFFSET];

#define CONN_INTERVAL (2+4+6+6+4+3+1+2)
			le.conn_interval = (packet[CONN_INTERVAL+1] << 8)
							 |  packet[CONN_INTERVAL+0];

#define CHANNEL_INC (2+4+6+6+4+3+1+2+2+2+2+5)
			le.channel_increment = packet[CHANNEL_INC] & 0x1f;
			le.channel_idx = le.channel_increment;

			// Hop to the initial channel immediately
			do_hop = 1;
		}
	}
}

void le_phy_main(void);
void bt_follow_le() {
	le_phy_main();

	/* old method
	reset_le();
	packet_cb = connection_follow_cb;
	bt_le_sync(MODE_BT_FOLLOW_LE);
	*/
}

// issue state change message
void le_promisc_state(u8 type, void *data, unsigned len) {
	/* DMA_SIZE because that is what enqueue() copies, and one byte of it is
	 * the type. */
	u8 buf[DMA_SIZE] = { 0 };
	if (len > DMA_SIZE - 1)
		len = DMA_SIZE - 1;

	buf[0] = type;
	memcpy(&buf[1], data, len);
	enqueue(LE_PROMISC, (uint8_t*)buf);
}

/*
 * Handing a recovered connection to the follow.
 *
 * Promiscuous recovery works a connection out while listening on one channel,
 * then hands it to the hopping follow. Two of its paths do that -- the hop
 * increment of a connection using channel selection algorithm 1, and the
 * event counter of one using algorithm 2 -- and both set the same state:
 * hop_mode, do_hop, the connection's own fields, and le.link_state.
 *
 * The order matters, because TIMER0_IRQHandler() runs between any two of
 * these statements. It asks for a hop on whichever branch hop_mode selects,
 * and its low-energy branch asks only once link_state says connected. So:
 *
 *   hop_mode = HOP_BTLE   first: from here the interrupt is on a branch that
 *                         waits for the link state, so it asks for nothing
 *   do_hop = 0            then: drop a hop the previous mode asked for
 *   the connection's fields
 *   le_handoff_barrier()  then: hold all of those above the store below
 *   le.link_state = LINK_CONNECTED  last: this starts the hopping, and by
 *                         now there is a connection to hop
 *
 * Setting the state first leaves the interrupt on the previous mode's branch,
 * which asks for a hop on a plain clock tick with no connection to time it.
 * The follow takes that as its first hop, spends an event counter and retunes
 * at once, so the capture starts an event away from the connection and hears
 * nothing until the search runs again.
 */

/*
 * Keeps every store before this call ahead of every store after it.
 *
 * hop_mode, do_hop and le.link_state are volatile, so those three keep their
 * order on their own. The connection's other fields are plain, and
 * conn_epoch and conn_interval are read by TIMER0_IRQHandler(), so without
 * this the compiler may move those stores below the store of the link state
 * and hand the interrupt a connection with a stale epoch or interval. A
 * compiler barrier is enough: a core sees its own stores in program order.
 */
static inline void le_handoff_barrier(void)
{
	__asm__ volatile ("" ::: "memory");
}

/* Works the hop increment out from how long the connection takes to get from
 * 2404 MHz to 2406 MHz, and then follows it. Only channel selection
 * algorithm 1 has an increment to find, and only such a connection reaches
 * here: algorithm 2 picks each event's channel from the access address, the
 * event counter, and the channel map, so its visits to one channel do not
 * repeat on the 37-event cycle the interval estimator looks for.
 * promisc_try_csa2() takes those connections, from the same sightings. */
void promisc_recover_hop_increment(u8 *packet) {
	/* The interval the span below is divided by. The estimator hands over
	 * nothing outside the range a connection may use, but the division is
	 * checked anyway: the LPC17xx leaves DIV_0_TRP clear, so a zero divisor
	 * makes UDIV answer 0 rather than fault, and hop_interval_lut[0] is 0 --
	 * a board that has stopped hopping and reports both numbers as zero.
	 */
	if (le.conn_interval < LE_MIN_CONN_INTERVAL ||
			le.conn_interval > LE_MAX_CONN_INTERVAL) {
		hop_direct_channel = 2404;
		do_hop = 1;
		return;
	}

	if (channel == 2404) {
		le_promisc.first_ts = CLK100NS;
		hop_direct_channel = 2406;
		do_hop = 1;
	} else if (channel == 2406) {
		u32 second_ts = CLK100NS;
		if (second_ts < le_promisc.first_ts)
			second_ts += CLK100NS_PERIOD; // handle rollover
		// Number of channels hopped between previous and current timestamp.
		u32 channels_hopped = LE_DIVIDE_ROUND(second_ts - le_promisc.first_ts,
										   le.conn_interval * LE_BASECLK);
		/* At least one: the two sightings are a whole number of connection
		 * events apart, and a span shorter than half an interval rounds to
		 * none of them. hop_interval_lut[0] is 0, so taking it would be a
		 * hop increment of 0 and a board that stops hopping. */
		if (channels_hopped >= 1 && channels_hopped < LE_HOP_CHANNELS &&
				hop_interval_lut[channels_hopped] >= LE_MIN_HOP_INCREMENT &&
				hop_interval_lut[channels_hopped] <= LE_MAX_HOP_INCREMENT) {
			/* Move on to regular connection following: the hop mode first
			 * and the link state last; see "Handing a recovered connection
			 * to the follow" above. */
			hop_mode = HOP_BTLE;
			do_hop = 0;
			/* Only a dozen of the table's entries are an increment a
			 * connection may use; the rest come from a span measured
			 * against an interval that was not this connection's, and
			 * following one chases a sequence no connection uses. */
			le.channel_increment = hop_interval_lut[channels_hopped];
			le.interval_timer = le.conn_interval / 2;
			le.conn_count = 0;
			le.conn_epoch = 0;
			le.channel_idx = (1 + le.channel_increment) % LE_HOP_CHANNELS;
			le.crc_verify = 0;
			le_handoff_barrier();
			le.link_state = LINK_CONNECTED;
			packet_cb = connection_follow_cb;
			le_promisc_state(3, &le.channel_increment, 1);

			if (jam_mode != JAM_NONE)
				le_jam_count = JAM_COUNT_DEFAULT;

			return;
		}
		hop_direct_channel = 2404;
		do_hop = 1;
	}
	else {
		hop_direct_channel = 2404;
		do_hop = 1;
	}
}

/* Add a gap to the end of the ring, dropping the oldest. */
static void promisc_note_gap(u32 gap) {
	if (le_promisc.gap_count < LE_PROMISC_GAPS) {
		le_promisc.gap[le_promisc.gap_count++] = gap;
		return;
	}

	memmove(&le_promisc.gap[0], &le_promisc.gap[1],
			(LE_PROMISC_GAPS - 1) * sizeof(le_promisc.gap[0]));
	le_promisc.gap[LE_PROMISC_GAPS - 1] = gap;
}

/* The gap this many places back from the newest. */
static u32 promisc_gap_back(unsigned back) {
	return le_promisc.gap[le_promisc.gap_count - 1 - back];
}

/* The connection interval the gaps say, in units of 1.25 ms, or 0 when they
 * do not say one that can be believed.
 *
 * A connection returns to this channel at spacings that repeat every trip
 * round the 37 hop positions, and those spacings add up to 37 connection
 * events because the trip visits every position once. That holds whatever
 * the channel map is, and needs no guess about it: a full map gives one
 * spacing, a smaller map several, because every unused position is remapped
 * onto a used one.
 *
 * So: find the shortest pattern the gaps repeat, and take its total. Nothing
 * is reported until they do repeat, which is also what keeps a missed return
 * out of the answer: it makes one gap the sum of two, and a run containing
 * such a gap does not repeat.
 */
static u16 promisc_interval(void) {
	unsigned period, i;

	for (period = 1; period <= LE_PROMISC_GAPS / 2; ++period) {
		u32 total = 0;
		u32 interval, unit;

		if (le_promisc.gap_count < 2 * period)
			break;

		/* Two runs of `period` gaps back to back, the newer against the
		 * older. */
		for (i = 0; i < period; ++i)
			if (!le_same_span(promisc_gap_back(i),
					promisc_gap_back(i + period)))
				break;
		if (i < period)
			continue;

		for (i = 0; i < period; ++i)
			total += promisc_gap_back(i);

		/* One repeat is one trip round the channels, so it cannot be
		 * longer than the longest trip. Checked before the division,
		 * because the sum of this many gaps can also be more than a
		 * 32-bit count holds. */
		if (total > LE_PROMISC_MAX_GAP || total < promisc_gap_back(0))
			continue;

		interval = LE_DIVIDE_ROUND(total, LE_HOP_CHANNELS * LE_BASECLK);

		/* Nothing outside the range a connection interval may take is
		 * one. That rules out every pattern totalling less than the
		 * 277.5 ms a trip round 37 channels takes at the shortest
		 * interval. */
		if (interval < LE_MIN_CONN_INTERVAL ||
				interval > LE_MAX_CONN_INTERVAL)
			return 0;

		/* Every gap in the pattern is a whole number of connection
		 * events, so it has to be a whole number of this interval, and
		 * no more events than a trip round the channels holds. This is
		 * what tells a part of a longer pattern from the whole: a part
		 * repeats too, but its total is not 37 events, so the interval
		 * it gives does not measure its own gaps. */
		unit = interval * LE_BASECLK;
		for (i = 0; i < period; ++i) {
			u32 gap = promisc_gap_back(i);
			u32 events = LE_DIVIDE_ROUND(gap, unit);

			if (events < 1 || events > LE_HOP_CHANNELS)
				return 0;
			if (!le_same_span(gap, events * unit))
				return 0;
		}

		return (u16)interval;
	}

	return 0;
}

/*
 * How many sightings in a row the estimator above gets to itself before an
 * algorithm-2 search runs, and again between one search and the next.
 *
 * A search leaves the receiver deaf while it runs, so the two sightings either
 * side of one are not neighbours and the gap between them is not a gap between
 * consecutive returns. The estimator above reads the pattern the gaps repeat
 * and needs a run of consecutive ones: two runs of the longest pattern it
 * looks for, so 16 gaps, the pattern being capped at half the ring, and then
 * five more reports that agree, so 21. Both estimators start again after every
 * search, so this has to be more than that or a connection the estimator
 * above could have settled on would never get the chance.
 */
#define LE_PROMISC_CSA2_RUN 40

/*
 * Throw away what both estimators have collected and start again from the
 * next sighting.
 *
 * Both read a run of gaps between consecutive returns to this channel: the one
 * above looks for the pattern they repeat, and the algorithm-2 search adds
 * them up to say how many connection events apart the sightings are. So
 * anything that breaks the run has to empty them, not just leave a gap out.
 * A ring with a gap missing from the middle is still a chain of numbers that
 * add up, and every sighting older than the hole then looks nearer the newest
 * than it was: the search finds the counter that explains those offsets,
 * scores it well, and adopts an answer that puts the follow on the wrong
 * channel for every event. Nothing in the answer says so; the capture simply
 * comes back empty.
 *
 * Clearing the stamp is what makes the next sighting an anchor rather than the
 * end of a gap measured across the break.
 */
static void promisc_restart_estimators(void) {
	le_promisc.gap_count = 0;
	le_promisc.csa2_gap_count = 0;
	le_promisc.sightings = 0;
	le_promisc.consec_intervals = 0;
	le_promisc.seen_a_packet = 0;
	le.conn_interval = 0;
}

/* Add a gap to the algorithm-2 ring, dropping the oldest. */
static void promisc_csa2_note_gap(u32 gap) {
	unsigned i;

	if (le_promisc.csa2_gap_count < LE_CSA2_SIGHTINGS - 1) {
		le_promisc.csa2_gap[le_promisc.csa2_gap_count++] = gap;
		return;
	}

	for (i = 0; i + 1 < LE_CSA2_SIGHTINGS - 1; ++i)
		le_promisc.csa2_gap[i] = le_promisc.csa2_gap[i + 1];
	le_promisc.csa2_gap[LE_CSA2_SIGHTINGS - 2] = gap;
}

/*
 * Search for a connection hopping with channel selection algorithm 2 in the
 * sightings collected so far, and follow it if the search finds one. Returns
 * whether it did.
 *
 * `sighting` is the capture clock at the packet that has just arrived, which
 * is the event the search's answer belongs to. The search takes a couple of
 * hundred milliseconds, so the clock is read again afterwards and the event
 * counter carried forward over the events that went by in the meantime.
 */
static int promisc_try_csa2(u32 sighting) {
	le_csa2_recovery_t rec;
	le_csa2_handoff_t handoff;
	u32 now, elapsed;
	uint8_t site;
	int found;

	/* The longest this capture goes without feeding the watchdog from its
	 * own loop: see WATCHDOG_SITE_LE_CSA2. */
	site = watchdog_mark(WATCHDOG_SITE_LE_CSA2);
	found = le_csa2_recover(le_promisc.csa2_gap, le_promisc.csa2_gap_count,
			btle_channel_index(channel), le.access_address, &rec);
	watchdog_mark(site);

	if (!found)
		return 0;

	now = CLK100NS;
	elapsed = now >= sighting ? now - sighting
			: (CLK100NS_PERIOD - sighting) + now;

	/* Where the follow's first hop lands against the connection's real
	 * event boundary.
	 *
	 * Everything that rounds here rounds early, so the hop is between
	 * about 1.6 ms early and however deep in its own event the sighting
	 * was. That depth is the part nothing here can bound or correct -- see
	 * LE_CSA2_SIGHTING_SPREAD -- and at the far end of it the receiver
	 * misses the central's packet of every event it hops to. Which packets
	 * of an event this follow hears is settled here and never revisited. */
	if (!le_csa2_handoff(&rec, elapsed, &handoff))
		return 0;

	le.conn_interval = rec.conn_interval;
	le.chan_sel_2 = 1;
	le.event_counter = handoff.event_counter;
	/* The follow compares a connection update's instant against this, and
	 * an instant is an event counter. */
	le.conn_count = handoff.conn_count;
	le.conn_epoch = clkn;
	le.interval_timer = handoff.interval_timer;
	/* The hop mode first and the link state last; see "Handing a recovered
	 * connection to the follow" above. */
	hop_mode = HOP_BTLE;
	do_hop = 0;
	le.crc_verify = 0;
	le_handoff_barrier();
	le.link_state = LINK_CONNECTED;
	packet_cb = connection_follow_cb;

	le_promisc_state(2, &le.conn_interval, 2);
	/* The counter the follow starts on, not the one the search answered
	 * with, which belongs to a sighting a few hundred milliseconds old. */
	le_promisc_state(4, &le.event_counter, 2);

	if (jam_mode != JAM_NONE)
		le_jam_count = JAM_COUNT_DEFAULT;

	return 1;
}
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
