SqueakyFloors/ubertooth/host/libubertooth/src/ubertooth_callback.c

/*
 * Copyright 2015 Hannes Ellinger
 *
 * This file is part of Project Ubertooth.
 *
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
 * You should have received a copy of the GNU General Public License
 * along with this program; see the file COPYING.  If not, write to
 * the Free Software Foundation, Inc., 51 Franklin Street,
 * Boston, MA 02110-1301, USA.
 */

#include <stdint.h>
#include <stdio.h>
#include <stdlib.h>
#include <string.h>
#include <time.h>
#include <unistd.h>

#include "ubertooth_callback.h"

extern unsigned int packet_counter_max;

/* An access code is 64 symbols long. The search reads all 64 from every start
 * position it tries, so a search allowed to start anywhere in the bank reads
 * past the symbols that were captured. */
#define AC_SYMBOLS 64

/* How many start positions a search for an access code may try, which is what
 * libbtbb's btbb_find_ac_n() takes as its search length: it tries positions 0
 * to search_length - 1. The last position whose whole access code lies inside
 * the bank begins AC_SYMBOLS symbols before the bank's end, so counting from
 * zero to that position inclusive is one more than the difference between them.
 *
 * The _n form also takes how many symbols the buffer holds, so the library
 * checks this bound instead of taking the caller's word for it. */
#define AC_SEARCH_POSITIONS (BANK_LEN - AC_SYMBOLS + 1)

/* How long a bank of symbols is in the 100 ns ticks the firmware stamps it
 * with. One symbol is one microsecond of air, so the 400-symbol bank a record
 * carries is 400 µs, and the firmware takes its stamp at the END of the bank:
 * the bank began this many ticks earlier. */
#define BANK_100NS (BANK_LEN * 10)

/* 100 ns ticks in a 625 µs Bluetooth slot, which is two CLKN ticks. A packet's
 * offset from the clock's rising edge is measured within one slot, and the
 * firmware's clock trim carries a correction within one slot. */
#define CLK100NS_PER_SLOT (2 * CLK100NS_PER_CLKN)

/* CLKN is CLK27-0: a counter of 2^28 312.5 µs ticks, which runs for 23 hours
 * and starts over. */
#define CLKN_MASK 0x0fffffffu

/* CLKN ticks in a second, and the parts per million one 100 ns tick of error
 * per CLKN tick comes to (1000000 / 3125). */
#define CLKN_PER_SECOND 3200
#define PPM_PER_100NS_PER_CLKN 320

/* Where the scale below runs out: the lowest raw reading that comes out as
 * 0 dBm. A record at or above it says only "at least this loud", so a capture
 * held there cannot be told how loud what it is hearing is -- and on this
 * radio that is also where it stops demodulating reliably, which is what
 * ubertooth_watch_signal_level() reports.
 *
 * The map below is written in terms of this rather than repeating the number,
 * so it stays the first reading that reports 0 dBm whatever the top segment
 * becomes. That makes it load-bearing twice over, and the two uses have to
 * move together: it is where the dBm scale ends as well as what the warning
 * goes on, so changing it to suit the warning would change the dBm figure
 * every capture reports and every capture file records. Retune the warning
 * through SIGNAL_BLOCK_RECORDS and SIGNAL_BLOCK_AT_CEILING instead, and
 * change this only to follow the radio's own curve. */
#define RSSI_CEILING_RAW 35

static int8_t cc2400_rssi_to_dbm( const int8_t rssi )
{
	/* models the cc2400 datasheet fig 22 for 1M as piece-wise linear */
	if (rssi < -48) {
		return -120;
	}
	else if (rssi <= -45) {
		return 6*(rssi+28);
	}
	else if (rssi <= 30) {
		return (int8_t) ((99*((int)rssi-62))/110);
	}
	else if (rssi < RSSI_CEILING_RAW) {
		return (int8_t) ((60*((int)rssi-RSSI_CEILING_RAW))/11);
	}
	else {
		return 0;
	}
}

/* The noise figure handed to the capture writers, which means "no background
 * figure for this packet".
 *
 * libbtbb sets the noise-power-valid flag of a record only when the noise
 * figure it is given is below that record's signal figure, so a figure no
 * signal can reach leaves the flag clear and a reader does not take the byte
 * for a measurement. +127 dBm is such a figure: the signal field is derived
 * from the board's RSSI and tops out at 0 dBm. With the flag clear the byte
 * itself means nothing, which is why a value no receiver could report is the
 * safe one to write there. */
#define NOISE_ABSENT INT8_MAX

/* The reading the packet's own power comes from.
 *
 * A record that does not say its average is this packet's power is one from a
 * board or a `.dump` file older than the measurement, where the field held the
 * board's running average for the channel. Its strongest reading of the packet
 * is the nearest thing to the packet's own level that such a record carries. */
static int8_t record_signal_rssi( const usb_pkt_rx *rx )
{
	return (rx->status & SIGNAL_VALID) ? rx->rssi_avg : rx->rssi_max;
}

/* What the board reports for this packet: the packet's own power, measured,
 * and an estimate of the background on its channel where the mode it came
 * from has one.
 *
 * Both figures are the board's, one record at a time. The signal used to be
 * worked out here instead, as the loudest reading in the last ten records of
 * the packet's channel, which reported the loudest of ten packets rather than
 * this one -- a quiet packet arriving after a loud one read as loud as the
 * loud one, in the capture file as well as on screen.
 */
static void determine_signal_and_noise( const usb_pkt_rx *rx, int8_t *sig,
                                        int8_t *noise )
{
	*sig = cc2400_rssi_to_dbm( record_signal_rssi( rx ) );
	*noise = (rx->status & NOISE_ESTIMATE)
	       ? cc2400_rssi_to_dbm( (int8_t) rx->rssi_noise )
	       : NOISE_ABSENT;
}

/* Whether this packet's level is at the top of the radio's scale, where the
 * dBm figure is no measurement of the packet but only "at least this loud".
 *
 * The raw reading rather than the dBm figure, because the scale stops rising
 * at RSSI_CEILING_RAW: every reading from there up gives the same figure, so
 * the figure cannot say which of them it came from. */
static int signal_is_at_the_ceiling( const usb_pkt_rx *rx )
{
	return record_signal_rssi( rx ) >= RSSI_CEILING_RAW;
}

/* Room for a dBm figure or the word that stands for a missing one. */
#define RSSI_FIELD_LEN 8

/* A level column: the figure, or `none` where the board has no level to give.
 * Shared by every such column, so that the words they print cannot drift
 * apart -- which is how the low-energy column came to say 0 dBm long after the
 * Basic Rate ones stopped. */
static void format_level( char field[RSSI_FIELD_LEN], int dbm, int have_it )
{
	if (have_it)
		snprintf(field, RSSI_FIELD_LEN, "%d", dbm);
	else
		snprintf(field, RSSI_FIELD_LEN, "none");
}

/* The three level columns of a per-packet line: the packet's power, the
 * background estimate, and the ratio between them. Each is a figure or the
 * word `none`, because neither level is always one the board has: a mode with
 * no background estimate has no noise figure, and a reading at the ceiling is
 * no measurement of the packet, only "at least this loud". The ratio needs
 * both, so it goes whenever either does.
 *
 * The figures are taken from the record here, so the level printed and the
 * judgment of whether it is a measurement always rest on the same reading. */
static void format_signal_noise_and_snr( const usb_pkt_rx *rx,
                                         char s[RSSI_FIELD_LEN],
                                         char n[RSSI_FIELD_LEN],
                                         char snr[RSSI_FIELD_LEN] )
{
	int8_t sig, noise;
	int measured = !signal_is_at_the_ceiling( rx );

	determine_signal_and_noise( rx, &sig, &noise );

	format_level( s, sig, measured );
	format_level( n, noise, noise != NOISE_ABSENT );
	format_level( snr, sig - noise, measured && noise != NOISE_ABSENT );
}

static uint64_t clock_ns( clockid_t clock_id )
{
	struct timespec ts = { 0, 0 };
	(void) clock_gettime( clock_id, &ts );
	return (1000000000ull*(uint64_t) ts.tv_sec) + (uint64_t) ts.tv_nsec;
}

/* The host time a packet arrived, from the two clocks read together and the
 * monotonic reading the packet itself arrived with: the time that has passed
 * since the packet arrived, measured on the monotonic clock, taken off the
 * current host time.
 *
 * Three readings are no use and give back the current host time instead: a
 * packet with no arrival reading at all, one that claims to have arrived after
 * the monotonic reading just taken, and one so far back that taking it off
 * would land before the host clock's epoch. A host whose clock has never been
 * set reaches that last one: its current time is only a few seconds past the
 * epoch, while the monotonic clock has been counting since this boot, which
 * happened earlier than that. */
static uint64_t host_ns_at_arrival( uint64_t real_ns, uint64_t mono_ns,
                                    uint64_t arrival_ns )
{
	uint64_t waited_ns;

	if (arrival_ns == 0 || arrival_ns > mono_ns)
		return real_ns;
	waited_ns = mono_ns - arrival_ns;
	if (waited_ns > real_ns)
		return real_ns;
	return real_ns - waited_ns;
}

/* The host time a packet arrived, worked out from the reading the record it
 * came from arrived with: for a replay the host time stored with that record,
 * so a capture written with -q/-r while replaying keeps the recorded times,
 * and for a live capture the current time less however long the packet has
 * been waiting. The first packet's is where a capture's timestamps start.
 *
 * It is the reading passed in that decides, never the record the caller
 * happens to be holding. A packet that arrived as a chain of records is
 * placed where the chain started, and reassembly hands back that record's
 * reading for it; a replay that read the host time of the chain's last record
 * into systime must not move the packet to it.
 *
 * A live capture cannot simply read the clock here, because the poll thread
 * fills the ring buffer well ahead of the loop that drains it: a capture
 * written to a pipe nothing is reading yet, or taken by a process that was
 * descheduled, reaches its first packet long after the packet arrived, and
 * the clock read here would start every timestamp in the capture that late.
 * What says how long ago the packet arrived is the monotonic reading the ring
 * buffer stamped it with as its transfer completed, and reading the two
 * clocks together is what relates that reading to a host time. */
static uint64_t packet_host_ns( uint64_t arrival_ns )
{
	uint64_t real_ns, mono_ns;

	/* A replayed record's reading is the host time it was recorded with,
	 * in nanoseconds: that is what ubertooth_packet_arrival_ns() pushed
	 * into the ring buffer with it. */
	if (infile != NULL)
		return arrival_ns;
	/* The host clock first, so the monotonic reading is the later of the
	 * two and the wait is never understated: the error that leaves is a
	 * packet time fractionally early, not late. */
	real_ns = clock_ns( CLOCK_REALTIME );
	mono_ns = clock_ns( CLOCK_MONOTONIC );
	return host_ns_at_arrival( real_ns, mono_ns, arrival_ns );
}

uint32_t ubertooth_packet_systime( uint64_t arrival_ns )
{
	return (uint32_t) (packet_host_ns( arrival_ns ) / 1000000000ull);
}

uint64_t ubertooth_packet_arrival_ns( void )
{
	if (infile != NULL)
		return 1000000000ull * (uint64_t) systime;
	return clock_ns( CLOCK_MONOTONIC );
}

void ubertooth_bredr_follow_reset( ubertooth_t* ut )
{
	ut->br_following = 0;
	ut->br_calibrated = 0;
	ut->br_heard_ms = 0;
	ut->br_clock_gone = 0;
	ut->br_trim_counter = 0;
	ut->br_clkn_trim = 0;
	ut->br_searching = 0;
	ut->br_search_start_ms = 0;
	ut->br_clock_confirmed = 0;
}

void ubertooth_capture_clock_reset( ubertooth_t* ut )
{
	ut->abs_start_ns = 0;
	ut->start_clk100ns = 0;
	ut->last_clk100ns = 0;
	ut->last_clkn_high = 0;
	ut->clk100ns_upper = 0;
	ut->clk100ns_started = 0;
	ut->clk100ns_counted = 0;
	ut->clk100ns_pending_move = 0;
	ut->clk100ns_moved = 0;
	ut->last_arrival_ns = 0;
	ut->clk100ns_anchor_open = 0;
	ut->clk100ns_gap_warned = 0;
	ut->prev_packet_ns = 0;
	ut->prev_packet_seen = 0;
}

/* How far what two packets' clock readings claim about the time between them
 * may be from the gap the host's own clock saw, and still be believed of one
 * capture. It is sized to how imprecisely that gap is known, not to the
 * clock's period: a replayed record's host time is a whole second, so two of
 * them can misstate the gap by just under a second either way, and a live
 * capture reads the host as each packet's transfer completes, a packet's
 * latency apart. Two seconds covers both, and a genuine gap's own figure is
 * good to well inside it.
 *
 * Whichever way the decision goes wrong it costs a whole period, so this does
 * not bound the error; what it bounds is how far the two measures have to
 * disagree before the decision flips. Small is still the safer direction. Too
 * small reads a real gap between the capture's first two packets as a leftover
 * packet, and the times come out that much short, which the host clock catches
 * and reports below. That is the one way a real gap can be lost here, and it
 * takes a gap whose two measures are further apart than this: a capture whose
 * first packet waited on the board while the host was not reading, for
 * instance, has the time it waited in the clock reading and not in the gap.
 * Too large reads the leftover packet as part of the capture: the times come
 * out a period or more long, and nothing says so, because that report only
 * looks for times behind the host clock. */
#define CLK100NS_WRAP_SLACK_NS 2000000000ull

/* Whether the period count the capture's first packet carried belonged to the
 * mode before it, that packet being one left over from it. The firmware resets
 * CLKN when a mode starts, so the capture's own first count drops to whatever
 * the new mode has reached; read as a difference from the leftover's, the drop
 * is time that never passed. Where the mode before had run 200 periods that
 * came to 56 periods forwards, five hours into every time from there on, and
 * where it had run fewer than 128 the difference read backwards and was
 * rejected, which left the stale count as the baseline and stopped the capture
 * counting its own periods at all.
 *
 * What says so is the host's own clock, as it does for a wrap above: the two
 * packets' counts and readings together claim how much time passed between
 * them, and only a count from another mode claims an amount the host never
 * saw. The slack is the wrap test's, for the same reason - it is how far the
 * host's measure of the gap may be out - plus a whole period, because the
 * firmware latches a packet's count and its clock reading with separate reads
 * of CLKN: a packet caught as the count ticks over carries one a period from
 * its own reading, which is legitimate and has to be believed. One period is
 * as far as that can take a single packet, and one period is also as far as it
 * can take a pair of them. The two reads happen at one place in the firmware
 * per capture, in a fixed order - a counted capture's packets are stamped by
 * the receive interrupt, which reads the clock before the count - so whichever
 * way that order leans, both packets lean the same way and the difference
 * between their counts is out by at most the one period. Two packets leaning
 * opposite ways would have to come from two different places, which is a mode
 * change: the case below.
 *
 * The two allowances share one budget, and the budget cannot be widened: a
 * leftover count two periods from the capture's own already claims only about
 * two periods, so anything wider would stop catching it. A packet whose count
 * really was latched a period from its reading therefore leaves only the gap
 * slack to cover error in the host's measure of the gap, which is why that
 * measure is taken as each packet's transfer completes rather than where the
 * reconstruction is reached: a capture whose output is blocked on a slow pipe
 * can be minutes behind by the time it reads its first packet, and measured
 * there the gap before the second would be almost nothing, rejecting a count
 * the firmware legitimately latched and losing the whole gap between the two.
 *
 * What is left unsettled is a leftover count a period from the capture's own,
 * which looks exactly like that latch, or two periods from it where the two
 * readings are also within the slack of a whole period apart. Either costs
 * those one or two periods, as it did before, and no more: the capture runs at
 * the right rate from there, a fixed amount behind. ubertooth-rx(1) says so. */
static int count_came_from_the_mode_before( const ubertooth_t* ut,
                                            uint32_t clk100ns, uint8_t periods,
                                            uint64_t since_last_ns )
{
	/* The periods the count moved, as a signed difference: a count that
	 * reads lower is time going backwards, not 255 periods forwards. The
	 * byte's top half is read as that, rather than cast to a signed type,
	 * which C leaves to the compiler for a value that does not fit. */
	uint8_t stepped = (uint8_t) (periods - ut->last_clkn_high);
	int64_t moved = (stepped < 128) ? (int64_t) stepped :
	                                  (int64_t) stepped - 256;
	int64_t claim_ns = 100 * (moved * (int64_t) ut->clk100ns_period +
	                          (int64_t) clk100ns -
	                          (int64_t) ut->last_clk100ns);
	int64_t gap_ns = (int64_t) since_last_ns;
	int64_t apart_ns = (claim_ns > gap_ns) ? claim_ns - gap_ns :
	                                         gap_ns - claim_ns;

	return apart_ns > (int64_t) (100 * ut->clk100ns_period +
	                             CLK100NS_WRAP_SLACK_NS);
}

/* Whether the host's own clock can say how long passed between the last
 * packet and this one, closely enough to count the wraps of the capture clock
 * in between.
 *
 * A live capture can: each record arrives stamped with a reading of the
 * monotonic clock, taken as its transfer completed, so the gap between two
 * records is known to well under a second however late the loop reaches them.
 * A record carrying no reading at all - a ring buffer slot nothing stamped -
 * says nothing about when it arrived, and nor does the record before it if
 * that one carried none.
 *
 * A replay cannot. The host time a record carries is a whole second, and it
 * is whatever the machine that recorded the file wrote there, so a file is
 * replayed the way it always has been: the readings alone decide. A saved
 * capture is also the one place where the clock reading of the next record
 * really can be anything, records having been reordered or edited, and the
 * host times in the file are no help in telling that from a quiet gap. */
static int the_host_measured_the_gap( const ubertooth_t* ut,
                                      uint64_t arrival_ns )
{
	return infile == NULL && arrival_ns != 0 && ut->last_arrival_ns != 0;
}

/* How many times the capture clock started over between the last packet and
 * this one, taken from the time the host saw pass between the two: the count
 * whose claim about the clock comes closest to that gap.
 *
 * Two packets' readings claim an amount of time for each number of wraps that
 * could lie between them - the difference between the readings, plus a period
 * for every wrap - and only one of those claims is near what the host saw. A
 * reading that dropped is then one wrap of several that would fit, and a
 * reading that rose is not necessarily no wrap at all: a capture quiet for
 * longer than a period comes back reading higher with whole periods gone,
 * which is what the clock alone can never show.
 *
 * *apart_ns comes back as how far the closest claim still is from the gap.
 * Wraps can only bring a claim up, and where that is all the gap was short of
 * the closest one lands within half a period of it - any further and the next
 * wrap up would fit better. A claim still far out is a pair of readings the
 * gap cannot account for at all, a clock already past it being the common
 * case, which the caller reads as a packet left over from the mode before. */
static uint64_t wraps_the_gap_accounts_for( const ubertooth_t* ut,
                                            uint32_t clk100ns,
                                            uint64_t since_last_ns,
                                            uint64_t* apart_ns )
{
	int64_t period = (int64_t) ut->clk100ns_period;
	/* Where the clock reads now against where it read, within one period:
	 * negative where it reads lower than it did. */
	int64_t moved = (int64_t) clk100ns - (int64_t) ut->last_clk100ns;
	int64_t gap = (int64_t) (since_last_ns / 100);
	/* The wraps the rest of the gap comes to, rounded to the nearest whole
	 * one. Never fewer than none: a gap the clock has already overshot is
	 * the clock reading further on than the host saw time for, which no
	 * number of wraps improves. That is also what the division gives for a
	 * negative numerator, C truncating towards zero rather than rounding,
	 * so the clamp below is where such a gap is settled. */
	int64_t wraps = (gap - moved + period / 2) / period;
	int64_t claim;

	if (wraps < 0)
		wraps = 0;
	claim = wraps * period + moved;
	*apart_ns = 100 * (uint64_t) ((claim > gap) ? claim - gap : gap - claim);
	return (uint64_t) wraps;
}

/* Whether the move the capture is waiting for is the one that happened between
 * the last packet and this one.
 *
 * A piconet follow puts the board on the piconet's clock, so that it hops with
 * it (UBERTOOTH_START_HOPPING, sent from cb_rx() below). The amount is known
 * exactly - the firmware adds the offset the request carried to CLKN once, at
 * its next tick - but which packet is the first on the moved clock is not: the
 * request goes out asynchronously, so a packet or two can still be stamped on
 * the clock the board had. What tells the two apart is the gap the host's own
 * clock saw: of the two amounts this packet's reading could stand for, with
 * the move and without it, only one is near that gap, and they are a whole
 * move apart.
 *
 * The amount this packet's reading stands for is read as a difference in CLKN,
 * from the period count and the reading together, so that a move in either
 * direction reads as the signed amount it is. The byte's own wrap costs
 * nothing, and the half of its range kept for backwards differences covers
 * every move a follow can ask for, note_a_move_of_the_clock() above having
 * reduced the amount into that same range.
 *
 * What the test takes as the measure of the gap can itself be out by a period,
 * for reasons that have nothing to do with the move: a count that reads
 * backwards is declined, and a packet caught as the count ticks over carries
 * one a period from its own reading. So a move within a period or two of
 * 327.68 s can be found on such a packet instead of the right one. That costs
 * that packet's time and the move's, the same as any other wrong reading here,
 * and the slack below is what keeps the much commoner small case out. */
/* Records a move of the board's clock the capture has asked for, so that the
 * reconstruction can find it and take it out.
 *
 * offset is in CLKN ticks, as the request carries it, and comes from the
 * decoder as a plain signed difference between two clocks. It is reduced into
 * the range a record can state: a packet gives its clock as a period count and
 * a reading, 256 periods between them, and an amount past half of that is the
 * same reading reached the short way round. That 2^28 ticks of CLKN is also
 * the modulus the decoder works the offset out in, so the two agree on which
 * way round a given amount is. The firmware's own clkn counts further, to
 * 2^32, but nothing outside it ever sees those top bits.
 *
 * A move no larger than the slack is not recorded at all. Looking for it would
 * as often find it on a packet stamped before the board moved, which costs
 * that packet's time and clears the move, leaving the real one in the capture.
 * A move that small is worth less than the precision finding it would cost, so
 * it stays in the times. */
static void note_a_move_of_the_clock( ubertooth_t* ut, int offset )
{
	/* The range a record states its clock in, which is the clock CLKN
	 * drives and not whatever the current mode stamps with: a mode that
	 * stamps from timer1 sends no period count and never asks for a move. */
	int64_t window = 256 * (int64_t) CLK100NS_PERIOD;
	int64_t move = ut->clk100ns_pending_move +
	               (int64_t) offset * CLK100NS_PER_CLKN;

	move %= window;
	if (move > window / 2)
		move -= window;
	else if (move < -window / 2)
		move += window;

	ut->clk100ns_pending_move =
	        (llabs( move ) > (int64_t) (CLK100NS_WRAP_SLACK_NS / 100)) ?
	        move : 0;
}

static int the_move_landed_on_this_packet( const ubertooth_t* ut,
                                           uint32_t clk100ns, uint8_t periods,
                                           uint8_t count_before,
                                           uint64_t since_last_ns )
{
	uint8_t stepped = (uint8_t) (periods - count_before);
	int64_t moved = (stepped < 128) ? (int64_t) stepped :
	                                  (int64_t) stepped - 256;
	int64_t reading = moved * (int64_t) ut->clk100ns_period +
	                  (int64_t) clk100ns - (int64_t) ut->last_clk100ns;
	int64_t gap = (int64_t) (since_last_ns / 100);
	int64_t without = reading - gap;
	int64_t with = reading - ut->clk100ns_pending_move - gap;

	return llabs( with ) < llabs( without );
}

/* Takes out of the reconstruction the move the host asked for, on the packet
 * the test above found it on.
 *
 * Read as time passing, such a move stretched a capture's record times by up
 * to the clock's whole period, and sent individual times backwards where the
 * reading dropped. It is not a rate error, so there is no factor to correct:
 * each capture is out by whatever its own piconet's clock happened to be away
 * from the board's.
 *
 * What is taken out is the whole disagreement between what the reconstruction
 * made of this packet and the gap the host saw, rather than the amount asked
 * for. The two differ: the reconstruction declines a period count that reads
 * backwards, so a move backwards shows in it only as far as the reading
 * itself went, and taking out more than it holds would leave the capture a
 * period adrift. So the capture re-anchors on this packet: the one gap that
 * spans the move is measured on the host clock, and every other gap keeps the
 * board clock's precision, which is the point of using it.
 *
 * The period count is re-based here too. A move backwards makes the count read
 * backwards, which the counted branch above rightly declines to believe, but it
 * also leaves the baseline on the clock the capture no longer has: every later
 * count would read backwards from it as well, and the periods after the move
 * would stop being counted.
 *
 * One move is taken out per request. A packet read wrongly as the move costs
 * that packet's time and the real move's, which is the whole of what a wrong
 * reading here can cost; nothing else in the capture is second-guessed. */
static void take_out_the_move_of_the_clock( ubertooth_t* ut,
                                            uint64_t upper_before,
                                            uint32_t clk100ns, uint8_t periods,
                                            uint64_t since_last_ns )
{
	/* What this capture's reconstruction made of this packet: the periods
	 * it counted, plus the change in the reading. */
	int64_t claim = (int64_t) (ut->clk100ns_upper - upper_before) *
	                (int64_t) ut->clk100ns_period +
	                (int64_t) clk100ns - (int64_t) ut->last_clk100ns;

	ut->clk100ns_moved += claim - (int64_t) (since_last_ns / 100);
	ut->last_clkn_high = periods;
	ut->clk100ns_pending_move = 0;
}

static void track_clk100ns( ubertooth_t* ut, const usb_pkt_rx* rx,
                            uint64_t host_ns, uint64_t arrival_ns )
{
	uint32_t clk100ns = le32toh( rx->clk100ns );
	/* The periods counted before this packet, so that what the
	 * reconstruction makes of this packet's reading can be compared with
	 * the gap the host saw. */
	uint64_t upper_before = ut->clk100ns_upper;
	/* The period count the capture was counting from before this packet,
	 * which the counted branch below moves on. The test for a move of the
	 * clock reads the two together, so it needs the baseline as it stood. */
	uint8_t count_before = ut->last_clkn_high;
	/* How many times the clock stamping this packet has started over, as
	 * the packet itself reports it: clkn_high is the byte of CLKN directly
	 * above the 20 bits CLK100NS counts through, so it is that clock's
	 * period count. It is only read for a capture stamped with that clock:
	 * the low-energy physical-layer modes stamp from timer1, whose periods
	 * CLKN does not count, and they send a zero in the field. */
	uint8_t periods = (ut->clk100ns_period == CLK100NS_PERIOD) ?
	                  rx->clkn_high : 0;
	uint8_t advance;
	/* How much time the host saw pass since the last packet. */
	uint64_t since_last_ns;
	/* How many times the clock started over since the last packet, where no
	 * count says so, and how far the two packets' readings are from
	 * accounting for the gap the host saw once those wraps are allowed for.
	 * Both stay zero where there is nothing to go on. */
	uint64_t wraps = 0;
	uint64_t apart_ns = 0;
	/* Whether this is the packet right after the capture's first, the only
	 * one where what the record says has a rival reading: the packet before
	 * it can be one left over from the mode before. Taken once and cleared
	 * here, so no later packet is judged that way. */
	uint8_t anchor_open = ut->clk100ns_anchor_open;

	ut->clk100ns_anchor_open = 0;

	/* A count has to arrive before it can be believed: a mode that sends
	 * none leaves the field zero, which is also what the first period of a
	 * capture that does send one looks like. From the first non-zero count
	 * on, the count is the authority and the clock is not second-guessed. */
	if (periods != 0)
		ut->clk100ns_counted = 1;

	if (!ut->clk100ns_started) {
		ut->clk100ns_started = 1;
		ut->last_clk100ns = ut->start_clk100ns = clk100ns;
		ut->last_clkn_high = periods;
		ut->abs_start_ns = host_ns;
		ut->last_arrival_ns = arrival_ns;
		ut->clk100ns_anchor_open = 1;
		return;
	}

	since_last_ns = (arrival_ns > ut->last_arrival_ns) ?
	                arrival_ns - ut->last_arrival_ns : 0;

	if (ut->clk100ns_counted) {
		/* The count is one byte, read as a difference from the last
		 * packet's, so the byte's own wrap costs nothing. Only a
		 * forward difference is time passing: half the byte's range is
		 * kept for that, covering a gap of up to 127 periods, so a
		 * count that reads backwards - a record out of order or edited
		 * - is ignored rather than read as nearly 23 hours forwards. A
		 * longer gap cannot be counted at all; the host clock is what
		 * reports the loss. A rejected count is not kept either, or the
		 * climb back from it would be counted as time of its own. The
		 * cost of that is a capture past the covered range: its counts
		 * stay rejected until they come back around to the one last
		 * believed, so its times slide further behind rather than
		 * settling a fixed amount behind. An out-of-order record is
		 * much the likelier of the two inputs, and the host clock
		 * reports the other. */
		advance = (uint8_t) (periods - ut->last_clkn_high);
		if (anchor_open && count_came_from_the_mode_before( ut, clk100ns,
		                                                    periods,
		                                                    since_last_ns )) {
			/* The count the capture was anchored on was the
			 * leftover's, so the difference from it is not time.
			 * This packet's count becomes the baseline and the
			 * anchor moves to its reading, which is where the
			 * capture starts. The host time the anchor carries
			 * stays as it was, because that is when the capture
			 * started, which is what its times are measured from.
			 * Where some of the gap between the two packets really
			 * did pass - a quiet start, or a gap too long for the
			 * count to cover - those absolute times come out that
			 * much early. Nothing here can recover it: the count
			 * is the only record of such a gap and it is the count
			 * being rejected. The message below reports it. */
			ut->last_clkn_high = periods;
			ut->start_clk100ns = clk100ns;
		} else if (advance < 128) {
			ut->clk100ns_upper += advance;
			ut->last_clkn_high = periods;
		}
	} else {
		/* Without a count, nothing in the capture says how many times
		 * the clock started over between these two packets.
		 *
		 * A live capture has the host's own measure of the gap between
		 * them, so it takes the wrap count that fits it. A replay has
		 * only what the clock readings say: one wrap where the reading
		 * dropped, none where it rose, which is what a saved file has
		 * always replayed as. */
		if (the_host_measured_the_gap( ut, arrival_ns )) {
			wraps = wraps_the_gap_accounts_for( ut, clk100ns,
			                                    since_last_ns,
			                                    &apart_ns );
		} else if (clk100ns < ut->last_clk100ns) {
			/* The one wrap a lower reading can stand for, and how
			 * much time it claims: the clock ran from where the
			 * last packet read, round the end of its range, to
			 * where this one reads. Only a claim ahead of the gap
			 * counts against the records here, a reading that rose
			 * claiming no wrap at all, which a replay cannot tell
			 * from a quiet gap that hid one. */
			uint64_t wrap_ns = 100 * (ut->clk100ns_period -
			                          (ut->last_clk100ns - clk100ns));

			wraps = 1;
			apart_ns = (wrap_ns > since_last_ns) ?
			           wrap_ns - since_last_ns : 0;
		}

		/* Between the capture's first two packets, and only there, what
		 * the records say has a rival reading: the first packet can be
		 * one left over from the mode before, carrying that mode's
		 * clock, in which case nothing about it describes this capture.
		 * What says so is that no number of wraps makes the two
		 * readings account for the gap the host saw - a leftover packet
		 * was taken in moments before the next, so hardly any time
		 * passed, whether its reading is above the capture's own or
		 * below it.
		 *
		 * Further in, a run of packets agree about where the clock is,
		 * so this packet's reading is taken as it stands and the wraps
		 * are whatever fits the gap. A packet out of place there, with
		 * no time at all between it and the packet before, is read as
		 * no time passing where its reading dropped by less than half
		 * a period, and as the clock starting over where it dropped by
		 * more, that being the count that fits such a gap. */
		if (anchor_open && apart_ns > CLK100NS_WRAP_SLACK_NS) {
			/* The packet the capture was anchored on was the
			 * leftover. The anchor moves to this packet, so the
			 * capture starts at its own first reading and nothing
			 * after it lands before the capture began. The host
			 * time the anchor carries stays as it was: it is when
			 * the capture started, and this packet was taken in
			 * within a packet's latency of it. */
			ut->start_clk100ns = clk100ns;
		} else {
			ut->clk100ns_upper += wraps;
		}
	}

	/* A move of the clock this capture asked for and has not yet seen. Only
	 * where the host measured the gap, which is a live capture, that gap
	 * being what finds the move.
	 *
	 * Not between the capture's first two packets, where this packet's
	 * reading may be the capture's own anchor: the branches above may have
	 * moved the anchor and the count baseline onto it already, and taking
	 * the same disagreement out here as well would count it twice. A move
	 * larger than a period is what reaches that, so it is the large moves
	 * that would be doubled. What a move landing there costs instead is
	 * itself: a move wider than a period moves the anchor, which absorbs
	 * it, and a narrower one stays in the times. Neither is reachable in
	 * practice. A move is asked for well into a capture - a follow has to
	 * recover the piconet's clock first - or before the stream starts, as
	 * ubertooth-follow does, where the capture is anchored on the moved
	 * clock to begin with. */
	if (ut->clk100ns_pending_move != 0 && !anchor_open &&
	    the_host_measured_the_gap( ut, arrival_ns ) &&
	    the_move_landed_on_this_packet( ut, clk100ns, periods, count_before,
	                                    since_last_ns ))
		take_out_the_move_of_the_clock( ut, upper_before, clk100ns,
		                                periods, since_last_ns );

	ut->last_clk100ns = clk100ns;
	ut->last_arrival_ns = arrival_ns;
}

/* A wrap that cannot be counted - one in a gap past the range of the count a
 * packet carries, or in a gap longer than a period on a replay, where the
 * clock reading alone cannot show it - leaves nothing in the capture to show
 * it: the times simply come out short from then on. A live capture that
 * carries no count has the host's own measure of each gap and counts the
 * wraps in it, so what is left to report there is a host clock stepped
 * forwards, and a gap at the very start read as a leftover packet.
 *
 * The host clock shows a loss either way, because it kept
 * running, so it ends up ahead of the reconstructed times. What it is compared
 * against is the host time this packet arrived, not the time the loop reached
 * it, so a loop working through a backlog is not mistaken for lost time.
 *
 * Said once, and not used to correct them: it says that time was lost, not
 * where, and a host clock that is stepped during a capture must not move
 * packet times, which is why the reading that decides a wrap above is taken
 * from the monotonic clock instead. A step is also why this message does not
 * claim a lost wrap as the cause: a host clock jumped forwards looks the same
 * from here. */
static void warn_if_a_wrap_was_lost( ubertooth_t* ut, uint64_t packet_ns,
                                     uint64_t host_ns )
{
	uint64_t period_ns = 100ull * ut->clk100ns_period;

	if (ut->clk100ns_gap_warned)
		return;
	/* Half a period, not a whole one: a single lost wrap leaves the times
	 * exactly one period short, and the host time a replayed record carries
	 * is a whole second, so a whole-period test would turn on sub-second
	 * truncation and say nothing about the commonest case. A capture that
	 * keeps up is a packet's latency behind, far inside half a period. */
	if (host_ns < packet_ns || host_ns - packet_ns <= period_ns / 2)
		return;

	ut->clk100ns_gap_warned = 1;
	fprintf(stderr, "warning: packet times are behind the host clock by more "
	        "than half the capture clock's %.2f s period: a quiet gap lost a "
	        "clock wrap, or the host clock was stepped forwards\n",
	        period_ns / 1e9);
}

/* The capture clock of a packet, as 100 ns ticks since the board started
 * counting: each wrap seen adds the period of the clock this mode stamps with
 * (ut->clk100ns_period). Adding 2^32 instead, as if every clock were a 32-bit
 * counter, put 101.8 s into every packet after a wrap of the CLKN-derived
 * clock, which wraps at 3125 * 2^20. */
static uint64_t clk100ns_extended( const ubertooth_t* ut, const usb_pkt_rx* rx )
{
	return ut->clk100ns_upper * ut->clk100ns_period + le32toh( rx->clk100ns );
}

/* arrival_ns is when this packet arrived, read as its transfer completed and
 * carried with it through the ring buffer (fifo_popped_arrival_ns()). Reading
 * that clock here instead would say when this call was reached, which for a
 * packet taken from a backlog is no measure of the gap before it, nor of when
 * the capture itself began. */
static uint64_t now_ns_from_clk100ns( ubertooth_t* ut, const usb_pkt_rx* rx,
                                      uint64_t arrival_ns )
{
	uint64_t packet_ns;
	/* The host time this packet arrived, read once and used both to anchor
	 * the capture and to report a wrap that could not be told either way. */
	uint64_t host_ns = packet_host_ns( arrival_ns );

	track_clk100ns( ut, rx, host_ns, arrival_ns );
	/* The 100 ns ticks since the first packet, as nanoseconds: the whole
	 * difference is scaled, not just the current tick count. Signed,
	 * because a packet can read a little before the one a capture started
	 * on: the firmware latches clk100ns and the period count with separate
	 * reads of CLKN, so a packet caught as the count ticks over carries one
	 * that disagrees with its own clock reading by a period, in whichever
	 * direction that mode's two reads happen to be ordered. */
	packet_ns = (uint64_t) ((int64_t) ut->abs_start_ns + 100 *
	            ((int64_t) clk100ns_extended( ut, rx ) -
	             (int64_t) ut->start_clk100ns - ut->clk100ns_moved));
	warn_if_a_wrap_was_lost( ut, packet_ns, host_ns );
	return packet_ns;
}

/* How long since the previous packet, taken from the capture's own
 * reconstructed times (now_ns_from_clk100ns() above). Those have already
 * accounted for every time the clock started over, including the wraps a
 * quiet gap leaves nowhere in the records, so the line printed beside a
 * packet and the capture record written for it agree.
 *
 * Working the gap out from the two raw clock readings instead added a period
 * where the reading had dropped and nothing where it had risen, which is
 * right only for a gap shorter than one period. A gap of 905.6 s measured on
 * a board came out as 46.6 s, that gap less the two whole periods inside it,
 * beside a record that had it right.
 *
 * The first packet of a capture reports no gap: there is nothing to measure
 * from, and its own clock reading printed as a duration measured nothing.
 *
 * Call this once for each packet that is reported: it moves the handle on to
 * the packet it was given, so a second call for the same packet would say the
 * gap was nothing. */
static uint64_t ns_since_the_last_packet( ubertooth_t* ut, uint64_t nowns )
{
	uint64_t since = (ut->prev_packet_seen && nowns > ut->prev_packet_ns) ?
	                 nowns - ut->prev_packet_ns : 0;

	ut->prev_packet_ns = nowns;
	ut->prev_packet_seen = 1;
	return since;
}

/* The CLKN of the first bit of a packet's access code, from the stamp the
 * record carries, the period count in the same record, and where in the bank
 * the access code was found.
 *
 * The stamp is taken at the end of the bank, so the bank's first symbol is
 * BANK_100NS earlier and the access code is `offset` symbols after that. CLKN
 * is a counter that starts over, and the three parts are put together the way
 * the counter itself works: clkn_high is CLKN's top eight bits and clk100ns
 * counts 100 ns ticks through the bottom twenty, so moving back by the bank
 * borrows from the period count when the stamp is less than 400 µs into a
 * period, and a borrow from period zero wraps round to the top of CLKN's
 * range.
 *
 * Both callers used to subtract in plain unsigned arithmetic, which read that
 * borrow as about 2^32 ticks and put the packet 1374388 ticks - seven minutes
 * - ahead of the clock. It is reachable in the first 400 µs after a mode
 * starts and in a 400 µs window at every 327.68 s wrap of clk100ns. */
static uint32_t clkn_at_access_code( uint8_t periods, uint32_t clk100ns,
                                     int offset )
{
	/* Signed: this is the one subtraction that can go below zero, and it
	 * can only do so by less than one bank. */
	int64_t at = (int64_t) clk100ns + 10 * (int64_t) offset - BANK_100NS;
	uint32_t borrowed = 0;

	if (at < 0) {
		at += CLK100NS_PERIOD;
		borrowed = 1;
	}
	return ((((uint32_t) periods - borrowed) << 20) +
	        (uint32_t) (at / CLK100NS_PER_CLKN)) & CLKN_MASK;
}

/* Sniff for LAPs. If a piconet is provided, use the given LAP to
 * search for UAP.
 */
void ubertooth_count_capture_losses(ubertooth_t* ut, const usb_pkt_rx* rx)
{
	if (ut == NULL || rx == NULL)
		return;

	/* A keep-alive is one byte on the wire -- the record's type and nothing
	 * else -- so its other fields hold whatever the record before it left in
	 * the buffer, these flags among them. Counting one would repeat a loss
	 * that was already counted.
	 *
	 * The continuation records of a long low-energy packet are the other
	 * case: they repeat the readings of the record that started the packet,
	 * these flags among them, so one loss would be counted once for every
	 * record the packet took. */
	if (rx->pkt_type == KEEP_ALIVE || rx->pkt_type == LE_PACKET_CONT)
		return;

	if (rx->status & FIFO_OVERFLOW) {
		ut->queue_gaps++;
		if (!ut->queue_gap_warned) {
			ut->queue_gap_warned = 1;
			fprintf(stderr, "warning: the recording board's packet "
			        "queue filled up and it dropped at least one "
			        "packet; this capture has a gap\n");
		}
	}

	/* The board marks this on the record it was filling when the chip's
	 * transfer controller reported an error. The record's transfer had
	 * finished, which is why it was kept, but some of its bytes may be wrong,
	 * and what the fault cut short before it is lost with nothing else to
	 * show for it. Both capture engines mark it. */
	if (rx->status & DMA_ERROR) {
		ut->transfer_errors++;
		if (!ut->transfer_error_warned) {
			ut->transfer_error_warned = 1;
			fprintf(stderr, "warning: the recording board had a "
			        "transfer error while capturing; what it was "
			        "receiving was kept, but some of those bytes may "
			        "be wrong and the capture may be missing packets "
			        "around it\n");
		}
	}

	/* The board marks this when a block of symbols finished arriving before
	 * its capture loop had read the block before it, so the new symbols went
	 * over the old ones. Nothing ever looked in that block for a packet,
	 * which is why this loss has no packet to name: it is a stretch of the
	 * air the capture simply does not have.
	 *
	 * The Basic Rate stream and the low-energy symbol search mark it; the
	 * low-energy loop that follows a connection, which receives whole
	 * packets rather than a stream of symbols, does not. */
	if (rx->status & DMA_OVERFLOW) {
		ut->symbol_overwrites++;
		if (!ut->symbol_overwrite_warned) {
			ut->symbol_overwrite_warned = 1;
			fprintf(stderr, "warning: the recording board fell behind "
			        "while capturing and wrote new symbols over a "
			        "block it had not read yet; whatever was in the "
			        "air then is missing from this capture\n");
		}
	}
}

/* How many records carrying a signal figure are judged together, and how many
 * of them have to be at the top of the radio's range for the block to count as
 * pinned there.
 *
 * Measured on the bench at 2441 MHz: with nothing of ours transmitting, 26 of
 * 19937 records reached the ceiling, 0.13% -- the channel carries Wi-Fi, which
 * is loud. With another board a few centimeters away transmitting a carrier,
 * every record did, at every transmit power. So the two cases are three orders
 * of magnitude apart and the threshold only has to sit between them.
 *
 * The block is a count of records and not a stretch of time, because the modes
 * send them at very different rates: the Basic Rate stream sends one per block
 * of symbols, about 2500 a second, so a block here is a fraction of a second
 * of air, while the low-energy engine sends one per packet. A thousand records
 * of the stream is long enough that a burst of someone else's traffic cannot
 * fill it, and short enough to be reported while a capture is still running.
 */
#define SIGNAL_BLOCK_RECORDS 1000
#define SIGNAL_BLOCK_AT_CEILING 950

/* The counters these are compared against are 16-bit, so a block larger than
 * one can hold would wrap before it was ever judged and the warning would
 * never be said. */
_Static_assert(SIGNAL_BLOCK_RECORDS <= UINT16_MAX &&
               SIGNAL_BLOCK_AT_CEILING <= SIGNAL_BLOCK_RECORDS,
               "a block has to fit the counters in ubertooth_t");

void ubertooth_watch_signal_level(ubertooth_t* ut, const usb_pkt_rx* rx)
{
	if (ut == NULL || rx == NULL)
		return;

	/* Only a Basic Rate record, which is the one kind that is a sample of
	 * the air: the board sends one for every block of symbols it collects,
	 * whether or not a packet was in it, which is what makes "nearly every
	 * record at the top of the range" mean a receiver hearing nothing it can
	 * read. Both engines that take readings this way -- the Basic Rate
	 * stream and the generic receive's symbol path -- send this type.
	 *
	 * Every other type is either not a sample of the air or not a sample at
	 * all, so a positive test rather than a list of exclusions: a low-energy
	 * record exists because a packet decoded, so a run of them at the top of
	 * the range is an ordinary close link; a keep-alive is one byte on the
	 * wire, so its every other field holds whatever the record before it
	 * left in the buffer; a continuation record repeats the readings of the
	 * record that started its packet; and a promiscuous state change, a
	 * spectrum analyzer sweep and an E-GO packet carry no signal figure of
	 * their own.
	 *
	 * It matters on a replay as well as live. A dump holds whatever records
	 * were captured, and ubertooth-rx -i will replay one written by any tool,
	 * so the type has to be checked here rather than left to which callback
	 * is running.
	 */
	if (rx->pkt_type != BR_PACKET)
		return;

	/* And only a record that states the power of what it holds. A record
	 * without the flag carries either no packet or, from an older board or
	 * dump, the channel's running average in that field, which is not this
	 * record's level. */
	if (!(rx->status & SIGNAL_VALID))
		return;

	ut->signal_records++;
	if (rx->rssi_avg >= RSSI_CEILING_RAW)
		ut->signal_records_at_ceiling++;

	if (ut->signal_records < SIGNAL_BLOCK_RECORDS)
		return;

	if (ut->signal_records_at_ceiling >= SIGNAL_BLOCK_AT_CEILING) {
		ut->signal_ceiling_blocks++;
		if (!ut->signal_ceiling_warned) {
			ut->signal_ceiling_warned = 1;
			fprintf(stderr, "warning: the signal is at the top of "
			        "the receiver's range, so the board cannot "
			        "measure it and may not demodulate it; the "
			        "boards may be too close together, or the "
			        "transmit power too high\n");
		}
	}

	/* The next block is judged on its own air, not on this one's. */
	ut->signal_records = 0;
	ut->signal_records_at_ceiling = 0;
}

uint32_t ubertooth_signal_ceiling_blocks(ubertooth_t* ut)
{
	return ut != NULL ? ut->signal_ceiling_blocks : 0;
}

uint32_t ubertooth_queue_gaps(ubertooth_t* ut)
{
	return ut != NULL ? ut->queue_gaps : 0;
}

uint32_t ubertooth_transfer_errors(ubertooth_t* ut)
{
	return ut != NULL ? ut->transfer_errors : 0;
}

uint32_t ubertooth_symbol_overwrites(ubertooth_t* ut)
{
	return ut != NULL ? ut->symbol_overwrites : 0;
}

FILE* ubertooth_result_stream(ubertooth_t* ut)
{
	/* The one place in the library that names standard output for a
	 * result. A handle with no stream of its own, and a caller with no
	 * handle at all, both read as that; see result_stream in
	 * ubertooth.h. */
	if (ut == NULL || ut->result_stream == NULL)
		return stdout;
	return ut->result_stream;
}

void ubertooth_print_afh_map(FILE* out, btbb_piconet* pn)
{
	const uint8_t* map = btbb_piconet_get_afh_map(pn);
	int i;

	/* As hcitool prints it, and as afh_map_line() builds the same line for
	 * the two tools that read a map over a Bluetooth connection: the bytes
	 * in order, bit b of byte i being channel 8i + b. A byte at a time, as
	 * that function does it, so the length comes from the map and not from
	 * the number of arguments in a format string. */
	fputs("AFH map: 0x", out);
	for (i = 0; i < AFH_MAP_BYTES; i++)
		fprintf(out, "%02x", map[i]);
	fputc('\n', out);
}

void ubertooth_report_capture_losses(ubertooth_t* ut)
{
	uint32_t gaps = ubertooth_queue_gaps(ut);
	uint32_t errors = ubertooth_transfer_errors(ut);
	uint32_t overwrites = ubertooth_symbol_overwrites(ut);
	uint32_t blocks = ubertooth_signal_ceiling_blocks(ut);

	if (gaps > 0)
		fprintf(stderr, "warning: the capture has %u gap%s where the "
		        "board's queue filled up and it dropped packets\n",
		        gaps, gaps == 1 ? "" : "s");

	if (errors > 0)
		fprintf(stderr, "warning: the capture has %u transfer error%s "
		        "where a packet may be wrong or missing\n",
		        errors, errors == 1 ? "" : "s");

	if (overwrites > 0)
		fprintf(stderr, "warning: the capture has %u place%s where the "
		        "board wrote new symbols over a block it had not read\n",
		        overwrites, overwrites == 1 ? "" : "s");

	/* Not a loss, but the same kind of thing to say at the end: the running
	 * warning is said once, so without a total a reader cannot tell one bad
	 * stretch from a capture that was deaf throughout. */
	if (blocks > 0)
		fprintf(stderr, "warning: the capture has %u stretch%s where the "
		        "signal was at the top of the receiver's range\n",
		        blocks, blocks == 1 ? "" : "es");
}

void cb_scan(ubertooth_t* ut, void* args __attribute__((unused)))
{
	btbb_packet* pkt = NULL;
	char signal_text[RSSI_FIELD_LEN], noise_text[RSSI_FIELD_LEN];
	char snr_text[RSSI_FIELD_LEN];
	int offset;
	uint32_t clkn;

	usb_pkt_rx usb = fifo_pop(ut->fifo);
	usb_pkt_rx* rx = &usb;
	uint64_t arrival_ns = fifo_popped_arrival_ns(ut->fifo);
	char syms[BANK_LEN];
	ubertooth_unpack_symbols((uint8_t*)rx->data, syms);

	/* Before the checks below: a record this callback goes on to discard
	 * still carries the board's word that packets were lost before it. */
	ubertooth_count_capture_losses(ut, rx);
	ubertooth_watch_signal_level(ut, rx);

	/* Sanity check */
	if (rx->channel > (NUM_BREDR_CHANNELS-1))
		goto out;

	format_signal_noise_and_snr( rx, signal_text, noise_text, snr_text );

	/* Pass packet-pointer-pointer so that
	 * packet can be created in libbtbb. */
	offset = btbb_find_ac_n(syms, sizeof(syms), AC_SEARCH_POSITIONS, LAP_ANY, max_ac_errors, &pkt);
	if (offset < 0)
		goto out;

	/* Once offset is known for a valid packet, copy in symbols
	 * and other rx data. CLKN here is the 312.5us CLK27-0. The
	 * btbb library can shift it be CLK1 if needed. */
	clkn = clkn_at_access_code(rx->clkn_high, le32toh(rx->clk100ns), offset);
	btbb_packet_set_data(pkt, syms + offset, BANK_LEN - offset,
	                     rx->channel, clkn);

	/* The host time this record arrived. A replayed record keeps the one it
	 * was recorded with. */
	systime = ubertooth_packet_systime( arrival_ns );

	fprintf(ubertooth_result_stream(ut),
	        "systime=%u ch=%2d LAP=%06x err=%u clk100ns=%u clk1=%u s=%s n=%s snr=%s\n",
	        systime,
	        btbb_packet_get_channel(pkt),
	        btbb_packet_get_lap(pkt),
	        btbb_packet_get_ac_errors(pkt),
	        rx->clk100ns,
	        btbb_packet_get_clkn(pkt),
	        signal_text,
	        noise_text,
	        snr_text);

	btbb_process_packet(pkt, NULL);

out:
	if (pkt)
		btbb_packet_unref(pkt);
}

/* Fills a single unused channel next to one a packet just arrived on. This is
 * a guess, not a deduction: nothing stops a piconet from leaving out one
 * channel on its own, but a lone gap in a run of used channels is more often a
 * channel no packet has landed on yet. `neighbor` is the channel either side
 * of the packet's, `past` the one beyond it, and the gap counts as single only
 * when `past` is already marked used.
 *
 * Both have to name a real channel. Basic Rate has 79 of them, 0 to 78, so
 * looking outwards from a packet on channel 1 there is no channel below 0 to
 * judge the gap by, and from one on channel 77 no channel above 78: there the
 * rule has nothing to work from and does not apply. The bounds matter because
 * libbtbb reports a channel off the end of the band as used, which read as
 * evidence of a gap and marked channel 0 used on a packet from channel 1, and
 * channel 78 used on one from channel 77, with no packet ever seen on
 * either. */
static void afh_fill_single_gap(btbb_piconet* pn, int neighbor, int past)
{
	if (neighbor < 0 || neighbor > NUM_BREDR_CHANNELS - 1)
		return;
	if (past < 0 || past > NUM_BREDR_CHANNELS - 1)
		return;

	if (btbb_piconet_get_channel_seen(pn, (uint8_t)neighbor))
		return;
	if (!btbb_piconet_get_channel_seen(pn, (uint8_t)past))
		return;

	fprintf(stderr, "note: activating additional channel %d\n", neighbor);
	btbb_piconet_set_channel_seen(pn, (uint8_t)neighbor);
}

void cb_afh_initial(ubertooth_t* ut, void* args)
{
	btbb_piconet* pn = (btbb_piconet*)args;
	btbb_packet* pkt = NULL;
	int channel;

	usb_pkt_rx usb = fifo_pop(ut->fifo);
	usb_pkt_rx* rx = &usb;
	char syms[BANK_LEN];
	ubertooth_unpack_symbols((uint8_t*)rx->data, syms);

	/* Before the checks below: a record this callback goes on to discard
	 * still carries the board's word that packets were lost before it. */
	ubertooth_count_capture_losses(ut, rx);
	ubertooth_watch_signal_level(ut, rx);

	/* Sanity check: the channel names a bit of the AFH map below */
	if (rx->channel > (NUM_BREDR_CHANNELS-1))
		goto out;

	if( btbb_find_ac_n(syms, sizeof(syms), AC_SEARCH_POSITIONS, btbb_piconet_get_lap(pn), max_ac_errors, &pkt) < 0 )
		goto out;

	/* detect AFH map
	 * set current channel as used channel and send updated AFH
	 * map to ubertooth */
	channel = rx->channel;
	if(btbb_piconet_set_channel_seen(pn, (uint8_t)channel)) {

		afh_fill_single_gap(pn, channel+1, channel+2);
		afh_fill_single_gap(pn, channel-1, channel-2);

		cmd_set_afh_map(ut->devh, btbb_piconet_get_afh_map(pn));
		ubertooth_print_afh_map(ubertooth_result_stream(ut), pn);
	}
	cmd_hop(ut->devh);

out:
	if (pkt)
		btbb_packet_unref(pkt);
}

void cb_afh_monitor(ubertooth_t* ut, void* args)
{
	btbb_piconet* pn = (btbb_piconet*)args;
	btbb_packet* pkt = NULL;
	uint8_t channel;
	int i;

	usb_pkt_rx usb = fifo_pop(ut->fifo);
	usb_pkt_rx* rx = &usb;
	char syms[BANK_LEN];
	ubertooth_unpack_symbols((uint8_t*)rx->data, syms);

	/* Before the checks below: a record this callback goes on to discard
	 * still carries the board's word that packets were lost before it. */
	ubertooth_count_capture_losses(ut, rx);
	ubertooth_watch_signal_level(ut, rx);

	static unsigned long last_seen[NUM_BREDR_CHANNELS] = {0};
	static unsigned long counter = 0;

	/* Sanity check: the channel indexes last_seen below */
	if (rx->channel > (NUM_BREDR_CHANNELS-1))
		goto out;

	if( btbb_find_ac_n(syms, sizeof(syms), AC_SEARCH_POSITIONS, btbb_piconet_get_lap(pn), max_ac_errors, &pkt) < 0 )
		goto out;

	counter++;
	channel = rx->channel;
	last_seen[channel]=counter;

	FILE* out = ubertooth_result_stream(ut);

	if(btbb_piconet_set_channel_seen(pn, channel)) {
		fprintf(stderr, "note: + channel %2d is used now\n", channel);
		ubertooth_print_afh_map(out, pn);
	}

	for(i=0; i<NUM_BREDR_CHANNELS; i++) {
		if((counter - last_seen[i] >= packet_counter_max)) {
			if(btbb_piconet_clear_channel_seen(pn, i)) {
				fprintf(stderr, "note: - channel %2d is not used any more\n",
				        i);
				ubertooth_print_afh_map(out, pn);
			}
		}
	}
	cmd_hop(ut->devh);

out:
	if (pkt)
		btbb_packet_unref(pkt);
}

void cb_afh_r(ubertooth_t* ut, void* args)
{
	btbb_piconet* pn = (btbb_piconet*)args;
	btbb_packet* pkt = NULL;
	uint8_t channel;
	int i;

	usb_pkt_rx usb = fifo_pop(ut->fifo);
	usb_pkt_rx* rx = &usb;
	char syms[BANK_LEN];
	ubertooth_unpack_symbols((uint8_t*)rx->data, syms);

	/* Before the checks below: a record this callback goes on to discard
	 * still carries the board's word that packets were lost before it. */
	ubertooth_count_capture_losses(ut, rx);
	ubertooth_watch_signal_level(ut, rx);

	static unsigned long last_seen[NUM_BREDR_CHANNELS] = {0};
	static unsigned long counter = 0;

	/* Sanity check: the channel indexes last_seen below */
	if (rx->channel > (NUM_BREDR_CHANNELS-1))
		goto out;

	if( btbb_find_ac_n(syms, sizeof(syms), AC_SEARCH_POSITIONS, btbb_piconet_get_lap(pn), max_ac_errors, &pkt) < 0 )
		goto out;


	counter++;
	channel = rx->channel;
	last_seen[channel]=counter;

	btbb_piconet_set_channel_seen(pn, channel);

	for(i=0; i<NUM_BREDR_CHANNELS; i++) {
		if((counter - last_seen[i] >= packet_counter_max)) {
			btbb_piconet_clear_channel_seen(pn, i);
		}
	}
	cmd_hop(ut->devh);

out:
	if (pkt)
		btbb_packet_unref(pkt);
}


/* Writes one record to the dump named with -d, in that file's fixed-size
 * format: the host time it arrived, in network byte order, then the record
 * exactly as the board sent it. Does nothing when no dump was asked for.
 *
 * One record at a time, as received, so a packet too long for one record is
 * several records here and a replay puts them back together exactly as a live
 * capture does. */
static void dump_one_record(const usb_pkt_rx* rx, uint32_t when)
{
	uint32_t when_be;

	if (dumpfile == NULL)
		return;
	when_be = htobe32(when);
	fwrite(&when_be, sizeof(when_be), 1, dumpfile);
	fwrite(rx, sizeof(usb_pkt_rx), 1, dumpfile);
	fflush(dumpfile);
}

/*
 * Sniff Bluetooth Low Energy packets.
 */
void cb_btle(ubertooth_t* ut, void* args)
{
	lell_packet* pkt;
	btle_options* opts = (btle_options*) args;
	int i;
	usb_pkt_rx usb = fifo_pop(ut->fifo);
	const usb_pkt_rx* rx = &usb;
	uint64_t arrival_ns = fifo_popped_arrival_ns(ut->fifo);
	/* The whole captured packet and its length, once reassembly has it,
	 * and when the record its readings come from arrived. */
	const uint8_t* le_data;
	uint16_t le_data_len;
	const usb_pkt_rx* le_metadata;
	uint64_t le_arrival_ns;
	// u32 access_address = 0; // Build warning

	/* Each warning below is said once for the whole capture: the condition
	 * it reports holds for every packet that follows, and a line per packet
	 * would bury the capture's own output. */
	static int connect_info_warned = 0;
	static int pcapng_le_write_warned = 0;
	uint32_t refAA;
	int8_t sig, noise;

	/* A keep-alive only says a quiet capture is still alive. It carries no
	 * packet, so there is nothing to decode and nothing to record: a replay
	 * of an older capture file can still hold one. */
	if (rx->pkt_type == KEEP_ALIVE)
		return;

	/* Before anything that can return: a record dropped below for a bad
	 * channel, a filtered address or a broken chain still carries the
	 * board's word that packets were lost before it.
	 *
	 * No ubertooth_watch_signal_level() here. The low-energy engines send a
	 * record for a packet the board demodulated and for nothing else, so
	 * "most records at the top of the radio's range" would mean "most
	 * packets decoded at the top of the range" -- which is an ordinary close
	 * link and not a deafened receiver: a short packet from a board a few
	 * centimeters away arrives at the ceiling with a valid CRC. That rule is
	 * calibrated on records that are samples of the air, as the Basic Rate
	 * stream's are, and means nothing over records that exist only because a
	 * packet decoded. ubertooth(7) says to run ubertooth-rx on the same
	 * channel to tell a deafened receiver from an empty one. */
	ubertooth_count_capture_losses(ut, rx);

	/* The host time this record arrived, which the dump stores with it:
	 * per record, because that is what the dump's fixed-size format holds.
	 * A replayed record keeps the one it was recorded with. The packet's
	 * own time is set again once reassembly has the whole of it. */
	systime = ubertooth_packet_systime( arrival_ns );

	// display LE promiscuous mode state changes
	if (rx->pkt_type == LE_PROMISC) {
		u8 state = rx->data[0];
		const void *val = &rx->data[1];
		/* These four lines are what promiscuous mode is for: a capture
		 * written to a file has no other way to say which connection it
		 * is of. So they go to the stream the tool reports on, which is
		 * standard error once a capture has taken standard output.
		 *
		 * A caller that sets no stream gets the one its results go to --
		 * standard output, where a plain run wants them -- unless that
		 * caller also said a capture had taken standard output, in which
		 * case standard output is /dev/null and these lines would reach
		 * nobody. Only then: a caller whose results go somewhere else has
		 * said where it wants them, and /dev/null is not it. */
		FILE* out = ubertooth_result_stream(ut);

		if (opts != NULL && opts->report_stream != NULL)
			out = opts->report_stream;
		else if (opts != NULL && opts->capture_took_stdout
		         && out == stdout)
			out = stderr;

		fprintf(out, "--------------------\n");
		fprintf(out, "LE Promisc - ");
		switch (state) {
			case 0:
				fprintf(out, "Access Address: %08x\n", *(const uint32_t *)val);
				break;
			case 1:
				fprintf(out, "CRC Init: %06x\n", *(const uint32_t *)val);
				break;
			case 2:
				fprintf(out, "Hop interval: %g ms\n", *(const uint16_t *)val * 1.25);
				break;
			case 3:
				fprintf(out, "Hop increment: %u\n", *(const uint8_t *)val);
				break;
			case 4:
				/* A connection hopping with channel selection
				 * algorithm 2 has no hop increment: its channel
				 * per event comes from the access address and
				 * this counter, which is the one the follow
				 * starts on. */
				fprintf(out, "Algorithm 2 event counter: %u\n",
				        *(const uint16_t *)val);
				break;
			default:
				fprintf(out, "Unknown %u\n", state);
				break;
		};
		fprintf(out, "\n");

		/* These four readings are the only record of which connection
		 * a promiscuous capture belongs to, so they go in the dump
		 * too. Written here because this branch returns: the record is
		 * not a packet and never reaches the write below. */
		dump_one_record(rx, systime);

		return;
	}

	/* Sanity check */
	if (rx->channel > (NUM_BREDR_CHANNELS-1))
		return;

	dump_one_record(rx, systime);

	/* A packet too long for one record arrives as several. Nothing below
	 * runs until the whole packet is here: a chain still arriving returns,
	 * and so does a broken one, whose records are dropped. */
	if (le_usb_reassemble(&ut->le_reassembly, rx, arrival_ns, &le_data,
	                      &le_data_len, &le_metadata,
	                      &le_arrival_ns) != LE_REASSEMBLY_COMPLETE)
		return;
	/* The channel, timestamp and signal readings of the packet as a whole,
	 * which for a chain are the first record's. */
	rx = le_metadata;

	/* The host time of the packet, rather than of the record that completed
	 * it: the first record of a chain, which is where the capture below
	 * places the packet, so the column and the capture agree. */
	systime = ubertooth_packet_systime( le_arrival_ns );

	/* After reassembly, so the clock sees one timestamp per packet rather
	 * than the same one once per record. The arrival reading is the one
	 * belonging to the record the timestamp came from, so the two always
	 * describe the same moment. */
	uint64_t nowns = now_ns_from_clk100ns( ut, rx, le_arrival_ns );

	/* The decoder is told how many bytes were captured, so it reads no
	 * further than that. */
	lell_allocate_and_decode_n(le_data, le_data_len,
	                           rx->channel + BT_FREQ_MIN, rx->clk100ns, &pkt);
	/* The decoder hands back nothing if it could not allocate the packet. */
	if (pkt == NULL) {
		fprintf(stderr, "error: unable to allocate memory\n");
		return;
	}

	/* do nothing further if filtered due to bad AA */
	if (opts &&
	    (opts->allowed_access_address_errors <
	     lell_get_access_address_offenses(pkt))) {
		lell_packet_unref(pkt);
		return;
	}

	/* Dump to PCAP/PCAPNG if specified */
	refAA = lell_packet_is_data(pkt) ? 0 : 0x8e89bed6;
	determine_signal_and_noise( rx, &sig, &noise );

	if (ut->h_pcap_le) {
		/* only one of these two will succeed, depending on
		 * whether PCAP was opened with DLT_PPI or not */
		lell_pcap_append_packet(ut->h_pcap_le, nowns,
					sig, noise,
					refAA, pkt);
		// read the above comment: this function may silently fail
		lell_pcap_append_ppi_packet(ut->h_pcap_le, nowns,
		                            rx->clkn_high,
		                            rx->rssi_min, rx->rssi_max,
		                            rx->rssi_avg, rx->rssi_count,
		                            pkt);
	}
	if (ut->h_pcapng_le) {
		/* A CONNECT_IND's parameters are recorded as an option of the
		 * PCAPNG interface description block, and the room set aside
		 * for them when the file was created runs out after a few
		 * hundred connections. Past that the packets still reach the
		 * file but their parameters do not, so Wireshark cannot follow
		 * those connections. Said once, because every connection after
		 * the first one is in the same position.
		 *
		 * Tested for "< 0" and not for non-zero: this report is
		 * positive, because the packet was written, while a failed
		 * write is negative. */
		int written = lell_pcapng_append_packet(ut->h_pcapng_le, nowns,
		                                        sig, noise,
		                                        refAA, pkt);

		if (written == LELL_PCAPNG_CONNECT_INFO_NOT_RECORDED &&
		    !connect_info_warned) {
			connect_info_warned = 1;
			fprintf(stderr, "warning: the capture file has no more "
			        "room for connection parameters; the packets "
			        "are still recorded, but later connections "
			        "cannot be followed in Wireshark\n");
		} else if (written < 0 && !pcapng_le_write_warned) {
			pcapng_le_write_warned = 1;
			fprintf(stderr, "warning: cannot write to the PCAPNG "
			        "capture file\n");
		}
	}

	/* A capture on "-" owns standard output: this process's own standard
	 * output is /dev/null for the whole run, so the per-packet dump below
	 * would reach nobody. Skipping it also keeps the terminal clean,
	 * because the dump ends in lell_print(), which reports a field it
	 * cannot read on standard error -- and standard error is not
	 * redirected. */
	if (opts != NULL && opts->capture_took_stdout) {
		lell_packet_unref(pkt);
		return;
	}

	uint64_t ts_diff_ns = ns_since_the_last_packet( ut, nowns );
	FILE* out = ubertooth_result_stream(ut);
	/* `sig`, so this line and the capture record above report one level for
	 * one packet, and the word where that level is no measurement of the
	 * packet (signal_is_at_the_ceiling() above). The record keeps the figure
	 * either way, having no way to say a level was not measured. */
	char level[RSSI_FIELD_LEN];

	format_level( level, sig, !signal_is_at_the_ceiling( rx ) );

	fprintf(out, "systime=%u freq=%d addr=%08x delta_t=%.03f ms rssi=%s\n",
	        systime, rx->channel + BT_FREQ_MIN, lell_get_access_address(pkt),
	        ts_diff_ns / 1000000.0, level);

	/* The bytes of the packet itself: the PDU header, the payload the
	 * decoder found and the CRC, after the four-byte access address. Never
	 * more than was captured, so a header claiming a longer payload than
	 * arrived prints only what arrived. */
	unsigned len = lell_get_payload_length(pkt) + 4 + 2 + 3;
	if (len > le_data_len)
		len = le_data_len;

	for (i = 4; i < (int)len; ++i)
		fprintf(out, "%02x ", le_data[i]);
	fputc('\n', out);

	/* lell_print() counts the fields it cannot read rather than writing a
	 * line about each one, so the dump stays readable on a busy bench,
	 * where hundreds of packets in ten seconds carry data that does not
	 * match its own length fields. The count moving over this one packet
	 * is how the tool knows to include it in the summary it prints when
	 * the run ends; libbtbb's count is per field, so the comparison here
	 * is what makes the summary per packet. */
	uint64_t malformed_before = lell_malformed_count(LELL_MALFORMED_ANY, 0);
	lell_print(pkt);
	if (opts != NULL &&
	    lell_malformed_count(LELL_MALFORMED_ANY, 0) != malformed_before)
		opts->malformed_packets++;
	fputc('\n', out);

	lell_packet_unref(pkt);

	fflush(out);
}
/*
 * Sniff E-GO packets
 */
void cb_ego(ubertooth_t* ut, void* args)
{
	int i;
	uint8_t len = *(uint8_t *)args;
	usb_pkt_rx usb = fifo_pop(ut->fifo);
	usb_pkt_rx* rx = &usb;
	uint64_t arrival_ns = fifo_popped_arrival_ns(ut->fifo);

	/* No ubertooth_watch_signal_level() here: the E-GO engine builds its
	 * records with enqueue_with_ts(), which takes no readings and states no
	 * signal figure, and its receive leaves the high-gain mode off. */
	ubertooth_count_capture_losses(ut, rx);

	/* These packets are stamped with the CLKN-derived clock and carry no
	 * period count of their own, so the reconstruction counts the clock's
	 * wraps from the host time each record arrived with, as it does for the
	 * other modes that send no count. */
	uint64_t nowns = now_ns_from_clk100ns(ut, rx, arrival_ns);
	uint64_t ts_diff_ns = ns_since_the_last_packet(ut, nowns);

	FILE* out = ubertooth_result_stream(ut);

	fprintf(out, "time=%u delta_t=%.06f ms freq=%d \n",
	        le32toh(rx->clk100ns), ts_diff_ns / 1000000.0,
	        rx->channel + BT_FREQ_MIN);

	for (i = 0; i < len; ++i)
		fprintf(out, "%02x ", rx->data[i]);
	fputs("\n\n", out);

	fflush(out);
}

#define CLOCK_TRIM_THRESHOLD 2

/* What the firmware's clock trim can ask for, in 100 ns ticks. The request
 * carries one unsigned 16-bit field holding a correction modulo one slot: the
 * firmware reads 0 to 3124 as a delay of that many ticks, and 3125 to 6249 as
 * an advance of one slot less the value. So the largest delay is one tick
 * short of a CLKN tick and the largest advance is a whole one. A field of 6250
 * or more is a delay again, which is the arithmetic the old "advance" branch
 * leant on; nothing sends one now. */
#define CLOCK_TRIM_MAX_DELAY   (CLK100NS_PER_CLKN - 1)
#define CLOCK_TRIM_MAX_ADVANCE CLK100NS_PER_CLKN

/* The largest drift the firmware's correction can express, in parts per
 * million. It adds or removes one 100 ns tick every 320/PPM CLKN ticks, so
 * 320 PPM is one tick every tick; beyond that its division gives nothing,
 * which it reads as correcting on every tick, saturated at 320 PPM. This
 * bounds each request, not the total: the firmware adds each one to a running
 * figure of its own, which nothing bounds. */
#define DRIFT_PPM_MAX PPM_PER_100NS_PER_CLKN

/* How far the board's clock has to move for the next packet's access code to
 * arrive CLK_TUNE_TIME after a CLKN edge: positive to delay the clock,
 * negative to advance it.
 *
 * The offset the packet was measured at runs through one slot and starts over,
 * so an error of +3999 ticks and one of -2251 land the clock in the same
 * place. The shorter way round is the one to take: it perturbs the clock less,
 * and it is the only one of the two that the firmware's field can carry, which
 * is why nothing here needs clamping. The result is always between one whole
 * CLKN tick of advance and one tick less a 100 ns tick of delay, as long as
 * CLK_TUNE_TIME is no more than a CLKN tick; the test walks every offset a
 * packet can be measured at and checks that. */
static int32_t clock_correction_100ns( uint16_t clk_offset )
{
	int32_t error = (int32_t) clk_offset - CLK_TUNE_TIME;

	if (error > CLOCK_TRIM_MAX_DELAY)
		error -= CLK100NS_PER_SLOT;
	return error;
}

/* The field to send for such a correction. An advance goes out as one slot
 * less the amount, which is how the firmware reads the field.
 *
 * A negative correction used to be passed straight to the request's unsigned
 * parameter: -150 went out as 65386, which the firmware added to its tick
 * reload, so that CLKN tick lasted 6.85 ms while the count advanced by three -
 * leaving the clock 5.91 ms behind where it should have moved forward by
 * 15 µs. The other branch sent a value above one slot in the same way. */
static uint16_t clock_trim_field( int32_t correction_100ns )
{
	if (correction_100ns < 0)
		return (uint16_t) (CLK100NS_PER_SLOT + correction_100ns);
	return (uint16_t) correction_100ns;
}

/* How fast the board's clock is running against the piconet's, in parts per
 * million, from the correction this trim needed and the CLKN ticks since the
 * last one. Negative means the board is slow, which is the sign the firmware
 * reads as "speed up".
 *
 * Signed throughout. The division used to be by an unsigned tick count, which
 * converted a negative correction first: a real -15 PPM came out as 1342162,
 * was printed as that, and was narrowed to 31442 for the request. A positive
 * figure makes the firmware lengthen every tick, so a board already running
 * 15 PPM slow was slowed by a further 320 PPM - the same direction as the
 * error - for the rest of the run. The result is clamped to what the firmware
 * can act on, and a trim in the same CLKN tick as the last one reports nothing
 * rather than dividing by zero. */
static int drift_ppm( int32_t correction_100ns, uint32_t clkn_ticks )
{
	int32_t ppm;

	if (clkn_ticks == 0)
		return 0;
	ppm = correction_100ns * PPM_PER_100NS_PER_CLKN / (int32_t) clkn_ticks;
	if (ppm > DRIFT_PPM_MAX)
		ppm = DRIFT_PPM_MAX;
	if (ppm < -DRIFT_PPM_MAX)
		ppm = -DRIFT_PPM_MAX;
	return (int) ppm;
}

/* ---- following a piconet's clock ---------------------------------------- */

/* The state below lives on the handle, one set per board, because every value
 * in it describes one board: its crystal's drift, the requests sent to it, and
 * the clock the library handed the capture reading it. The fields are
 * ut->br_following, ut->br_calibrated, ut->br_heard_ms, ut->br_clock_gone,
 * ut->br_trim_counter and ut->br_clkn_trim.
 *
 * ut->br_following: whether the library has handed this capture a clock of the
 * piconet's that it has not since given up. Only then is there a clock to be
 * told about losing, and a board to take off its offset.
 *
 * ut->br_calibrated: whether the clock trim has been measured against the
 * offset being followed. A clock handed over, or given up, starts that again.
 *
 * ut->br_heard_ms: when a packet of that piconet was last heard, on the
 * monotonic clock. A clock handed over starts it, because nothing has been
 * heard on that clock yet. See ubertooth_follow_quiet_ms().
 *
 * ut->br_clock_gone: whether the library has no clock for this piconet any
 * more while the board may still be hopping on the old offset, which is where
 * a board that refused the request below leaves this capture.
 *
 * ut->br_trim_counter and ut->br_clkn_trim: how far the access code has been
 * arriving from CLK_TUNE_TIME, and the CLKN the last trim was sent at, which
 * is what the drift in PPM is measured over.
 *
 * ut->br_searching and ut->br_search_start_ms: whether a clock search is
 * running on this board with a packet of the piconet behind it and no clock
 * confirmed yet, and when it started, on the monotonic clock. See
 * ubertooth_clock_search_ms().
 *
 * ut->br_clock_confirmed: whether the library has accepted a clock for this
 * board at any point in this run, whether or not it turned out to be the
 * piconet's. It ends the reading above for the rest of the run: a search
 * running again after a clock was accepted and lost is not one that never got
 * that far, and a caller must not be told that the search cannot confirm a
 * clock in a run where it did. That a clock was wrong is reported where it is
 * lost. */

static uint64_t monotonic_ms(void)
{
	return clock_ns(CLOCK_MONOTONIC) / 1000000ull;
}

/* Takes the board off the clock offset it was hopping on, once that clock has
 * been given up. The plain symbol capture is what takes it off, and it leaves
 * the receive running, which is what discovery needs. It is a mode start,
 * though, so the board has forgotten its hop state with it and is sitting on
 * the channel the last piconet hop chose: the channel or sweep this capture
 * asked for has to be stated again, exactly as the tool states it after its
 * own mode start, or discovery looks for a piconet on one channel in 79. A
 * replay has no board to take off anything.
 *
 * The caller has already said why. br_following is cleared once the board is
 * off the offset; a board that refused leaves it set, so the capture is still
 * one whose silence means something and the request is made again when the
 * next report arrives or the next wait is up. */
static void br_stop_following(ubertooth_t* ut)
{
	ut->br_calibrated = 0;

	if (infile != NULL) {
		ut->br_following = 0;
		ut->br_clock_gone = 0;
		return;
	}

	if (cmd_rx_syms(ut->devh) < 0) {
		/* The board refused, so it is still hopping on the offset that
		 * is gone -- the request itself has said why. */
		fprintf(stderr, "warning: the board is still following that "
		        "clock; this capture may decode nothing from here "
		        "on\n");
		return;
	}

	ut->br_following = 0;
	ut->br_clock_gone = 0;
	/* Only when this capture set a channel. A caller that set none --
	 * ubertooth-follow, which shares this callback -- leaves the field
	 * zero, and zero is not a channel: it would be clamped to the bottom
	 * of the band and pin the capture there. */
	if (ut->capture_channel != 0 &&
	    cmd_set_channel(ut->devh, ut->capture_channel) < 0)
		fprintf(stderr, "warning: the board is left receiving on one "
		        "channel, so this capture may not find the piconet "
		        "again\n");
}

/* Puts the user's UAP back whenever the library has stopped holding it, for a
 * capture whose tool recorded one in ut->follow_uap. A UAP the user gave is
 * not in doubt, and the library has no way to know that.
 *
 * Giving a clock up is where it is really lost: libbtbb zeroes the UAP there
 * as well as clearing its flag, so the next packet goes to the brute-force
 * search with nothing to filter on. That search takes packets a quiet bench
 * may not provide and can settle on a wrong value, and until it does, the
 * clock search cannot start.
 *
 * Called per packet, not only on those two paths, for a smaller reason: the
 * flag reaches further than the drop paths do, so this does not have to track
 * every place the library clears it. Discovery starting over is one such
 * place, and the library puts a stated UAP back there itself.
 *
 * It cannot fight the library. While the UAP is held, libbtbb rules out every
 * clock candidate whose UAP differs from it, so it never installs a different
 * one for this to overwrite. Stated unconditionally rather than only where the
 * library has let go: the setter writes the UAP and raises its flag and does
 * nothing else, so on the packets where nothing was lost -- almost all of them
 * -- it writes back what is already there. Testing first would save two stores
 * a packet and cost a branch that no test could tell was there. */
static void br_restate_stated_uap(const ubertooth_t* ut, btbb_piconet* pn)
{
	if (pn == NULL || !ut->follow_uap_stated)
		return;
	btbb_piconet_set_uap(pn, ut->follow_uap);
}

/* Writes what a clock-given-up warning says about the UAP, as the tail of its
 * line.
 *
 * Where the user gave one it is named, and the line says it is being put
 * back rather than kept: on the lost-lock path libbtbb has already said on
 * this same stream that the clock and the UAP both went, so a line claiming
 * the UAP was never dropped would contradict the one above it. */
static void br_uap_tail(const ubertooth_t* ut, char* buf, size_t len)
{
	if (ut->follow_uap_stated)
		snprintf(buf, len, "its clock again, and putting UAP %02x back",
		         ut->follow_uap);
	else
		snprintf(buf, len, "its clock and UAP again");
}

long ubertooth_clock_search_ms(ubertooth_t* ut)
{
	if (!ut->br_searching)
		return -1;
	return (long)(monotonic_ms() - ut->br_search_start_ms);
}

long ubertooth_follow_quiet_ms(ubertooth_t* ut)
{
	if (!ut->br_following)
		return -1;
	return (long)(monotonic_ms() - ut->br_heard_ms);
}

int ubertooth_follow_drop_clock(ubertooth_t* ut, btbb_piconet* pn)
{
	if (!ut->br_following)
		return 0;

	/* The wait starts again whatever comes of this, so a caller whose
	 * follow stays quiet asks once per wait rather than once per record:
	 * for a clock the library will not give up, and for a board that will
	 * not come off one it has. */
	ut->br_heard_ms = monotonic_ms();

	if (!ut->br_clock_gone) {
		char tail[64];

		if (btbb_piconet_drop_clock(pn) <= 0)
			return 0;
		ut->br_clock_gone = 1;
		/* Here as well as per packet: no packet of this piconet may
		 * arrive for a long time, and the clock search wants the UAP
		 * from the first one that does. */
		br_restate_stated_uap(ut, pn);
		br_uap_tail(ut, tail, sizeof(tail));
		fprintf(stderr, "warning: nothing of this piconet has been "
		        "heard on the clock being followed; searching for "
		        "%s\n", tail);
	}
	/* So the warning is said once per clock, and a board that refused the
	 * request is asked again at the next wait without it being
	 * repeated. */
	br_stop_following(ut);
	return 1;
}

void cb_rx(ubertooth_t* ut, void* args)
{
	btbb_packet* pkt = NULL;
	btbb_piconet* pn = (btbb_piconet *)args;
	/* As many symbols as a record carries, and no more: the unpacking
	 * below fills exactly BANK_LEN of them. A buffer ten times that size
	 * left the decoder reading the zeros the rest of it started as. */
	char syms[BANK_LEN];
	int offset;
	uint16_t clk_offset;
	uint32_t clkn;
	int r;
	uint32_t lap = LAP_ANY;
	uint8_t uap = UAP_ANY;

	static int pcap_bredr_warned = 0;
	static int pcapng_bredr_warned = 0;

	usb_pkt_rx usb = fifo_pop(ut->fifo);
	usb_pkt_rx* rx = &usb;
	uint64_t arrival_ns = fifo_popped_arrival_ns(ut->fifo);
	ubertooth_unpack_symbols((uint8_t*)rx->data, syms);

	/* Before the checks below: a record this callback goes on to discard
	 * still carries the board's word that packets were lost before it. */
	ubertooth_count_capture_losses(ut, rx);
	ubertooth_watch_signal_level(ut, rx);

	if (rx->pkt_type != BR_PACKET) {
		goto out;
	}

	if (rx->status & DISCARD) {
		goto out;
	}

	// /* Sanity check */
	if (rx->channel > (NUM_BREDR_CHANNELS-1))
		goto out;

	/* The host time this record arrived, which the dump below stores with
	 * it. A replayed record keeps the one it was recorded with. */
	systime = ubertooth_packet_systime( arrival_ns );

	uint64_t nowns = now_ns_from_clk100ns( ut, rx, arrival_ns );

	int8_t signal_level, noise_level;
	char signal_text[RSSI_FIELD_LEN], noise_text[RSSI_FIELD_LEN];
	char snr_text[RSSI_FIELD_LEN];
	determine_signal_and_noise( rx, &signal_level, &noise_level );
	format_signal_noise_and_snr( rx, signal_text, noise_text, snr_text );

	/* Look for packets with specified LAP, if given. Otherwise
	 * search for any packet. */
	if (pn) {
		lap = btbb_piconet_get_flag(pn, BTBB_LAP_VALID) ? btbb_piconet_get_lap(pn) : LAP_ANY;
	}

	/* Pass packet-pointer-pointer so that
	 * packet can be created in libbtbb. */
	offset = btbb_find_ac_n(syms, sizeof(syms), AC_SEARCH_POSITIONS, lap, max_ac_errors, &pkt);
	if (offset < 0)
		goto out;

	/* calculate the offset between the first bit of the AC and the rising edge of CLKN */
	clk_offset = (le32toh(rx->clk100ns) + offset*10 +
	              CLK100NS_PER_SLOT - BANK_100NS) % CLK100NS_PER_SLOT;

	btbb_packet_set_modulation(pkt, BTBB_MOD_GFSK);
	btbb_packet_set_transport(pkt, BTBB_TRANSPORT_ANY);

	/* Once offset is known for a valid packet, copy in symbols
	 * and other rx data. CLKN here is the 312.5us CLK27-0. The
	 * btbb library can shift it be CLK1 if needed. */
	clkn = clkn_at_access_code(rx->clkn_high, le32toh(rx->clk100ns), offset);
	btbb_packet_set_data(pkt, syms + offset, BANK_LEN - offset,
	                     rx->channel, clkn);

	fprintf(ubertooth_result_stream(ut),
	        "systime=%u ch=%2d LAP=%06x err=%u clkn=%u clk_offset=%u s=%s n=%s snr=%s\n",
	        systime,
	        btbb_packet_get_channel(pkt),
	        btbb_packet_get_lap(pkt),
	        btbb_packet_get_ac_errors(pkt),
	        clkn,
	        clk_offset,
	        signal_text,
	        noise_text,
	        snr_text
	);

	/* A packet of the piconet heard, stamped here rather than where the
	 * decoder takes the packet, because the clock trim below keeps some
	 * packets back from it: what a tool watching for silence has to see is
	 * every packet of the piconet that arrived. */
	if (ut->br_following)
		ut->br_heard_ms = monotonic_ms();

	/* calibrate Ubertooth clock such that the first bit of the AC
	 * arrives CLK_TUNE_TIME after the rising edge of CLKN */
	if (pn != NULL && infile == NULL) {
		/* The correction this packet calls for. Its sign, and nothing
		 * else, decides which form the trim takes; the two were chosen
		 * by the trim counter instead, so a calibrated follow reached
		 * the "delay" form with a correction that was really an
		 * advance, and vice versa. */
		int32_t correction = clock_correction_100ns( clk_offset );
		/* Forward CLKN ticks since the last trim, masked because CLKN
		 * starts over. */
		uint32_t since_trim = (clkn - ut->br_clkn_trim) & CLKN_MASK;

		if (ut->br_trim_counter < -CLOCK_TRIM_THRESHOLD
		    || ut->br_trim_counter > CLOCK_TRIM_THRESHOLD
		    || (correction != 0 && !ut->br_calibrated)) {
			/* Which way the clock is about to move, read from the
			 * correction and not from the raw offset. The offset
			 * runs through one slot and starts over, so an offset
			 * well above CLK_TUNE_TIME is corrected the short way
			 * round, by an advance: taking "<" or ">" from the raw
			 * offset made this line disagree with the trim printed
			 * under it. */
			fprintf(stderr, "note: offset %s CLK_TUNE_TIME\n",
			        correction == 0 ? "=" :
			        correction < 0 ? "<" : ">");
			fprintf(stderr, "note: CLK100ns trim: %d\n", correction);
			cmd_trim_clock(ut->devh, clock_trim_field(correction));
			ut->br_trim_counter = 0;
			if (ut->br_calibrated) {
				int ppm = drift_ppm(correction, since_trim);

				fprintf(stderr, "note: clock drifted %d in %f s, "
				        "%d PPM too %s\n",
				       correction,
				       (double)since_trim/CLKN_PER_SECOND,
				       ppm, ppm < 0 ? "slow" : "fast");
				cmd_fix_clock_drift(ut->devh, (int16_t) ppm);
			}
			ut->br_clkn_trim = clkn;
			ut->br_calibrated = 1;
			goto out;
		}

		if (clk_offset < CLK_TUNE_TIME - CLK_TUNE_OFFSET) {
			ut->br_trim_counter--;
			goto out;
		} else if (clk_offset > CLK_TUNE_TIME + CLK_TUNE_OFFSET) {
			ut->br_trim_counter++;
			goto out;
		} else {
			ut->br_trim_counter = 0;
		}
	}

	/* The dump can hold the same symbols twice, because a bank is written
	 * once per LAP found within the span of NUM_BANKS. */
	dump_one_record(rx, systime);

	r = btbb_process_packet(pkt, pn);

	/* A UAP the user gave goes back before the record below is written, so
	 * the packet that made the library drop it is itself recorded with the
	 * UAP a reader needs to check its header. See
	 * br_restate_stated_uap(). */
	br_restate_stated_uap(ut, pn);

	/* The reference upper address part (UAP) the capture records alongside
	 * this packet, read now that the decoder has had the packet. A packet
	 * whose CRC is what finally settles the piconet's UAP settles it inside
	 * the call above, so reading it beforehand left that one packet -- the
	 * first evidence a reader has for the UAP, and the record that most
	 * needs it -- written as if nothing was known, with its CRC left with
	 * nothing to check it against.
	 *
	 * A survey (`ubertooth-rx -z`) is given no piconet of its own: the
	 * decoder keeps one per LAP it hears, and btbb_survey_piconet() reads
	 * the one for this packet's LAP without taking it out of the survey.
	 * Outside a survey that table is empty, so the lookup answers NULL and
	 * the record carries no reference UAP, as before.
	 *
	 * The two never arrive together: the only tool that surveys through
	 * this callback refuses a survey beside an address. */
	btbb_piconet* uap_pn = pn ? pn
	                          : btbb_survey_piconet(btbb_packet_get_lap(pkt));

	if (uap_pn && btbb_piconet_get_flag(uap_pn, BTBB_UAP_VALID))
		uap = btbb_piconet_get_uap(uap_pn);

	/* Dump to PCAP/PCAPNG if specified. Each said once per capture if it
	 * cannot be written: the condition holds for every packet after it,
	 * and a capture nobody could write to otherwise looks exactly like one
	 * that is being written. */
	if (ut->h_pcap_bredr) {
		if (btbb_pcap_append_packet(ut->h_pcap_bredr, nowns,
		                            signal_level, noise_level,
		                            lap, uap, pkt) < 0 &&
		    !pcap_bredr_warned) {
			pcap_bredr_warned = 1;
			fprintf(stderr, "warning: cannot write to the PCAP "
			        "capture file\n");
		}
	}
	if (ut->h_pcapng_bredr) {
		if (btbb_pcapng_append_packet(ut->h_pcapng_bredr, nowns,
		                              signal_level, noise_level,
		                              lap, uap, pkt) < 0 &&
		    !pcapng_bredr_warned) {
			pcapng_bredr_warned = 1;
			fprintf(stderr, "warning: cannot write to the PCAPNG "
			        "capture file\n");
		}
	}

	/* The library has built a list of clock candidates, which is where the
	 * CLK1-27 search begins, and no clock is being followed. Stamped once,
	 * so the reading is the whole span the search has been running over and
	 * not the time since the last packet.
	 *
	 * The candidate list rather than the first packet: a capture that has
	 * heard a packet or two of the piconet and has not settled CLK1-6 is
	 * waiting for traffic, not searching, and a reading taken from its
	 * first packet would let a caller say the search is not going to finish
	 * before any search had run. Measured on a link that went quiet: four
	 * packets in 100 s, no candidate list, and the whole span would
	 * otherwise have read as a search.
	 *
	 * The flag is transient: the library builds the list and compares the
	 * hop that built it in one call, and a list emptied there is thrown
	 * away again. So this sees a search whose candidate list outlived the
	 * packet that built it, which is what every search on the bench has
	 * done. */
	if (!ut->br_searching && !ut->br_following && !ut->br_clock_confirmed &&
	    pn != NULL && btbb_piconet_get_flag(pn, BTBB_HOP_REVERSAL_INIT)) {
		ut->br_searching = 1;
		ut->br_search_start_ms = monotonic_ms();
	}

	if (r < 0) {
		/* The library has recovered the piconet's clock. A live capture
		 * puts the board on the offset it reports, so it hops with the
		 * piconet from here on; a replay has no board to put anywhere,
		 * but the library is following either way. */
		if (infile == NULL) {
			int offset = btbb_piconet_get_clk_offset(pn);

			/* The board's clock moves to the piconet's, which is not
			 * time passing: the firmware adds this offset to CLKN
			 * once, at its next tick. Taken out of the capture's
			 * times by take_out_the_move_of_the_clock() above,
			 * which needs the amount to find the packet it landed
			 * on. Only a request that went out moves anything: a
			 * move written down for one that did not would be
			 * looked for in readings that never carry it, and a
			 * later discontinuity taken for it. */
			if (cmd_start_hopping(ut->devh, offset, 0) >= 0)
				note_a_move_of_the_clock( ut, offset );
		}
		ut->br_calibrated = 0;
		ut->br_following = 1;
		ut->br_clock_gone = 0;
		ut->br_heard_ms = monotonic_ms();
		ut->br_searching = 0;
		ut->br_clock_confirmed = 1;
	} else if (r == BTBB_PROCESS_LOCK_LOST && ut->br_following) {
		/* The clock being followed was not this piconet's. The library
		 * has given it up and started discovery again, so a board put
		 * on that offset has to come off it. The clock the library
		 * finds next arrives through the branch above.
		 *
		 * One warning per lost clock, not one per packet. The library
		 * reports a loss once -- the headers that failed are counted
		 * inside it, and giving the clock up resets that count -- and
		 * the following flag keeps it that way here regardless: one
		 * warning per clock the library handed over, and none until it
		 * hands over another. A replay warns too; it is the same
		 * silence for the reader of a capture file as for the user of
		 * a board.
		 *
		 * The UAP went with the clock, and a UAP the user gave has
		 * already gone back above, so the line names it: a user whose
		 * -u was wrong can see which UAP the capture is holding them
		 * to. */
		char tail[64];

		br_uap_tail(ut, tail, sizeof(tail));
		fprintf(stderr, "warning: the clock being followed was not "
		        "this piconet's; searching for %s\n", tail);
		ut->br_clock_gone = 1;
		br_stop_following(ut);
	}

out:
	if (pkt)
		btbb_packet_unref(pkt);
}
