SqueakyFloors/ubertooth/host/libubertooth/src/ubertooth.c

/*
 * Copyright 2010, 2011 Michael Ossmann
 *
 * This file is part of Project Ubertooth.
 *
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
 * You should have received a copy of the GNU General Public License
 * along with this program; see the file COPYING.  If not, write to
 * the Free Software Foundation, Inc., 51 Franklin Street,
 * Boston, MA 02110-1301, USA.
 */

/* dladdr(), which print_version() uses to say where libbtbb was loaded from.
 * glibc declares it only for this macro; macOS and the BSDs declare it
 * whatever is asked for. It has to come before the first header, because that
 * is where glibc reads it.
 *
 * Here rather than beside _DEFAULT_SOURCE in host/CMakeLists.txt, where the
 * other feature macro is set for every target: _GNU_SOURCE changes what the
 * standard headers declare, strerror_r's return type among it, so it is asked
 * for in the one file that needs it. */
#define _GNU_SOURCE

#include <dlfcn.h>
#include <errno.h>
#include <limits.h>
#include <pthread.h>
#include <signal.h>
#include <stdio.h>
#include <stdlib.h>
#include <string.h>
#include <strings.h>
#include <time.h>
#include <unistd.h>

#include "ubertooth.h"
#include "ubertooth_callback.h"
#include "ubertooth_control.h"
#include "ubertooth_interface.h"

#ifndef RELEASE
#define RELEASE "unknown"
#endif
#ifndef VERSION
#define VERSION "unknown"
#endif

uint32_t systime;
FILE* infile = NULL;
FILE* dumpfile = NULL;
/* Printed after "no Ubertooth at index": indexes are positions in the current
 * device list, so they shift when boards are added or removed. */
#define INDEX_SHIFT_HINT \
	"indexes change when boards are added or removed; select a board by " \
	"serial with -U<serial>\n"

int max_ac_errors = 2;
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
