SqueakyFloors/ubertooth/(commit log)

2026-10-15 feat: verify CRC on-device in the LE PHY engine
    The modern LE engine (le_phy.c, used by ubertooth-btle -n/-f) forwarded every
    received packet including bit-errored ones, so UBERTOOTH_SET_CRC_VERIFY had no
    effect there — only the legacy bt_le_sync() path (now just promiscuous mode)
    honoured le.crc_verify. Bit-flipped phantom advertisers leaked to the host.
    Verify the CRC after dewhitening and drop bad-CRC packets when le.crc_verify is
    set. Advertising-channel PDUs use the fixed CRCInit (reversed 0xAAAAAA);
    data-channel PDUs use the value recovered from CONNECT_IND. Disabled by
    default, so legacy behaviour is unchanged.
2026-10-15 Add TEST_PLAN.md covering build, device, BLE, BR/EDR, and stability tests
2026-10-15 Fix incorrect plural: Uberteeth -> Ubertooth devices
2026-10-15 python: fix py3.12 invalid escape and remove C-style syntax
    - Use raw string for re.match(r'ubertooth(\\d+)') to silence
    SyntaxWarning: invalid escape sequence on Python 3.12.
    - Drop C-style trailing semicolons and 'print (' spacing in btle-extcap.py
    and btctl.py (docstring C-struct lines left intact).
2026-10-15 host: fix device-lifecycle bugs in libubertooth
    - ubertooth_count(): return int, not unsigned, so the -1 libusb_init
    error does not wrap to UINT_MAX; caller in ubertooth-util now checks
    for a negative count instead of printing 4294967295.
    - ubertooth_stop(): only libusb_close(ut->devh) when devh != NULL, and
    null it after closing. Previously closed a possibly-NULL handle on the
    failed-connect path.
    - ubertooth_start(): guard against ubertooth_init() returning NULL, and
    free ut + ut->fifo on the connect-failure path (was leaked).
    - find_ubertooth_device(): set devh = NULL explicitly when the single
    device fails to open (consistent with the multi-device branch); rename
    shadowing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
2026-10-15 docs: add TEST_LAB.md - test rack / CI design notes
    Design for a permanent hardware test lab: OS/machine matrix (build tier
    vs device/radio tier), Bluetooth emitter requirements, 24h soak + data
    sampling approach, and deploy orchestration (CI + Docker for builds,
    Ansible for the radio rack). Complements TEST_PLAN.md. Planning only;
    open items flagged as TODO / future GitHub issues.
2026-10-15 ci: fix macOS firmware toolchain install
    The macOS firmware job used the dead 'armmbed/formulae' tap and the
    core arm-none-eabi-gcc formula, which left newlib missing: the link
    failed with 'cannot find crt0.o / -lc / -lg / -lm'. Use Arm's official
    gcc-arm-embedded cask, which bundles the compiler + newlib (crt0 and
    libc/libg/libm), so bare-metal linking resolves. Ubuntu branch
    (apt gcc-arm-none-eabi) was already correct and unchanged.
2026-10-15 ci: brew update before gcc-arm-embedded cask (fix stale checksum)
    The macOS firmware job failed at the toolchain install with a cask
    checksum mismatch: Arm bumped the toolchain point release (15.3.rel1 ->
    15.3.rel2) and replaced the download, but the runner image's Homebrew
    still had the old SHA-256 pinned, so the download was rejected. Run
    'brew update' first to pull the current cask definition + matching
    checksum. If this proves still too racy, fall back to a pinned direct
    tarball download of the Arm toolchain.
2026-10-15 ci: pinned OS matrix + soft-fail latest canary, checkout@v4
    Pin supported versions (hard fail): ubuntu-22.04/24.04, macos-14/15/26.
    Add ubuntu-latest as a soft-fail canary (continue-on-error on push/PR,
    hard-fails only on the weekly schedule so GitHub emails on OS/toolchain
    drift). macos-latest == macos-26 so it is pinned directly, no canary.
    Switch per-OS step conditions to runner.os (version-agnostic) and bump
    actions/checkout v2 -> v4 (v2 Node 20 is deprecated).
2026-10-15 ci: add Ubuntu 20.04 (container) host + firmware jobs
    20.04 is the oldest supported Linux (COMPATIBILITY.md). GitHub retired
    the hosted ubuntu-20.04 runner, so run it in a ubuntu:20.04 container on
    a current runner. Container is root (no sudo) and bare, so install
    git/cmake/toolchain explicitly. Proves the 20.04 support claim.
2026-10-15 ci: add host CLI smoke test (ubertooth-util -h exits 0)
    Confirms a built binary runs and prints usage without a device. Only
    ubertooth-util -h is device-less (exit 0); other tools' -h open the
    device and exit non-zero on a runner, so the smoke test uses util.
    Added to both the hosted-runner host job and the U20 container job.
    Not a unit test (tracked separately).
2026-10-15 docs: add missing per-tool pages + btbr hang note
    Add man-style docs for the three previously-undocumented tools:
    ubertooth-follow, ubertooth-tx (noted as currently non-functional per its
    own usage warning), and ubertooth-ducky. Options/behaviour taken from each
    tool's usage() output. Also document the known ubertooth-btbr hang
    (upstream #520) in firmware/btbr/README.md where users will see it.
    Larger DOCS_NEEDED.md guides (BR/EDR workflow, FHS/NAP, etc.) remain
    tracked there; several need on-device validation before writing.
2026-10-15 docs: add Release_2020-12-R1 install guide
    Docs trailed at 2018-12-R1; add the 2020-12-R1 release install guide
    (matching the existing format, with 2020-12-R1 URLs and a short summary
    of what the release added: btbr/classic-BT firmware, Python 3,
    API 1.07) and wire it into the index toctree. Added python3-setuptools
    to the Debian prereqs since 3.12+ no longer bundles it.
2026-10-20 ubertooth-util: add -H/--host-version for host tools version
    No CLI exposed the installed host/libubertooth version; -v is firmware
    revision and -V is firmware compile info (read from the device). Add
    -H / --host-version to print libubertooth VERSION (RELEASE, with git
    hash) via print_version(), before device init so it works with no
    Ubertooth attached.
2026-10-20 ubertooth-util: turn LEDs off on -I interrupt; document LEDs
    -I (identify) looped forever with no signal handler, so Ctrl-C left the
    USR/RX/TX LEDs lit (inconsistent with -r, which leaves them off). Add a
    SIGINT handler that clears the three LEDs before exit. Also correct the
    -I help/man wording ('all LEDs' -> 'the USR, RX, and TX LEDs') and add
    docs/source/hardware_leds.rst documenting the firmware-controlled LEDs
    vs. the always-on power indicators (source-verified pin map).
2026-10-20 docs: explain -U device selection (enumeration index vs serial)
    -U<n> picks by USB enumeration order, not serial, and is not stable across
    reboots/re-plug. Add a SELECTING A DEVICE section explaining how to map
    index to device (serial listing when ambiguous, or -U<n> -I LED flash) and
    to pin by serial for stable identity.
2026-10-20 ci: drop macos-13 (Intel) from matrix; document Intel as unverified
    GitHub's Intel macos-13 runners are capacity-constrained and queued >1h40m,
    stalling CI. Remove macos-13 so runs don't hang; arm64 macOS 14/15/26 stay
    covered. Document Intel macOS as expected-to-build but not CI-verified.
    (Re-applied fresh on main; the old ci/intel-mac-canary branch was stale.)
2026-10-20 ubertooth-util: speed up -I identify blink to ~3 Hz
    The identify loop slept 1s per half-cycle (1 Hz). Use usleep(166667) for
    ~3 Hz so the flashing is easier to spot when picking a device out of
    several. USB control-transfer rate at 3 Hz is negligible.
2026-10-20 libubertooth: add serial-based device selection + ubertooth_start_select helper
    Add find_ubertooth_device_serial(), ubertooth_connect_serial(),
    ubertooth_start_serial(), and a shared ubertooth_start_select(const char*)
    that routes a -U argument to index or serial selection. Tools will call the
    shared helper (no per-tool duplication). Preserves existing index-based
    functions and all prior libubertooth fixes.
2026-10-20 ubertooth tools: route -U through shared serial/index select helpers
    Wire every ubertooth-* CLI tool's -U option through the shared
    ubertooth_start_select / ubertooth_connect_select helpers so -U now
    accepts either a numeric index (existing behaviour) or a serial-number
    string. Each tool keeps the raw optarg string instead of atoi()'ing it
    into an int.
    - start-based tools (scan, afh, ego, dump, debug, specan, dfu, util):
    ubertooth_start() -> ubertooth_start_select()
    - connect-based tools (rx, btle, follow, tx, ducky):
    ubertooth_connect() -> ubertooth_connect_select()
    - ubertooth_device changed from int to char*; case 'U' stores optarg.
    Also stop dumping the full usage() help page on th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
2026-10-20 ubertooth-util: -I stops any running operation first (and on exit)
    -I (identify) toggled LEDs on top of whatever firmware mode was running
    (e.g. -x xmas, -q LED specan), so they interfered and the prior mode was
    left running after Ctrl-C. Call cmd_stop() before the identify loop and in
    the SIGINT cleanup so -I starts from and returns to idle. Also fix the -U
    usage string (-U<0-7> -> -U<index|serial>; no 0-7 cap).
2026-10-20 docs: -U accepts index or serial, attached or separated; no 0-7 cap
    Document that -U auto-detects index vs serial, that both attached (-U0) and
    separated (-U 0) forms work (getopt required-arg), and that there is no fixed
    device-count limit (the old -U<0-7> was convention only; real limits are USB
    topology/hub/power). Verified all four forms on hardware.
2026-10-21 ubertooth-scan: fix memory leak on connection-failure path
    get_remote_info() malloc'd the hci_conn_info request (cr) but the early
    return when hci_create_connection() fails skipped free(cr), leaking one
    allocation per failed device probe. Over a long scan this slowly exhausts
    memory. Free cr before that return. (upstream issue #542)
2026-10-21 build: feature summary + REQUIRE_ALL strict mode + REQUIREMENTS.md
    CMake now prints which host tools are enabled/disabled and why (so a missing
    optional dep like bluez is obvious, not silent). -DREQUIRE_ALL=ON turns a
    missing optional dep into a configure error (for CI/release). Add
    REQUIREMENTS.md (required vs optional deps, what each enables) and link it
    from the README.
2026-10-21 docs: add specan_ui install/run guide; modernize its README (#11)
    Users hit 'ModuleNotFoundError: No module named specan' after building,
    because the specan package was not installed for the Python running the
    launcher (ran without make install, or build used a different Python).
    Add docs/source/specan_ui.rst with modern requirements, install/run steps,
    and targeted troubleshooting for that error; replace the Python-2-era
    specan_ui README with a concise pointer; wire into the docs index.
2026-10-21 install.sh: one-command from-source setup (Debian/Ubuntu) (#23)
    Installs system deps, builds+installs libbtbb and the host tools
    (-DREQUIRE_ALL=ON), installs specan_ui Python deps, with opt-in firmware
    build/flash and a --venv mode that builds against a dedicated interpreter.
    --no-sudo prints privileged steps as a dry run. Codifies the sequence
    validated on the control server.
2026-10-21 install.sh: --flash-device <index|serial|all> + help fixes
    Add device targeting to the flash step: --flash-device selects one Ubertooth
    by index or serial, or 'all' to enumerate every attached device's serial and
    flash each (useful for a multi-device station). Fix --help duplication and
    make it render the header cleanly. Default --flash still targets the default
    device with a hint to use --flash-device when multiple are attached.
2026-10-21 install.sh: plain --flash enumerates; refuse on multiple devices
    Plain --flash no longer silently flashes the default device. It enumerates:
    flashes the sole attached Ubertooth (reporting its serial), or refuses and
    lists serials if several are attached, directing the user to --flash-device
    <serial> or all. Every flash path is now serial-aware.
2026-10-21 install.sh: flash first + fail fast; refactor flash into a function
    Restructure so that with --flash: (0) resolve/validate the flash target in a
    pre-flight that aborts immediately on ambiguity (multiple devices, no
    selector), (1) install only the firmware toolchain, (2) build+flash firmware
    FIRST when host tools already exist, then do the longer host/libbtbb/python
    build. On a fresh machine where ubertooth-dfu isn't built yet, flashing is
    deferred until after the host build. Flash logic is now one function; EXIT
    trap cleans the workdir.
2026-10-21 install.sh: clearer multi-device message (label the serials)
    The multi-device abort listed bare hex serials with no context. Add a
    multi_device_msg helper that prints an explanatory header, the attached
    serials under an 'attached device serials:' label (indented), and how to
    choose one or flash all. Used by both the pre-flight and flash paths.
2026-10-21 install.sh: concise multi-device message with index: serial
    List each attached device as '<index>: <serial>' (the serial list is in
    enumeration/index order, matching -U<n>), so the user can choose by index or
    serial. One concise line + the indented list.
2026-10-21 install.sh: show serial when flashing by index
    When --flash-device <index> is used, resolve the index to its serial and
    show both (e.g. 'index 0 (serial 05f0...)') so it's unambiguous which
    physical device is being flashed.
2026-10-21 ubertooth-util: stop current op before starting a new mode (-q/-x/-t/-n/-e)
    Like -I, these mode-starting ops now call cmd_stop() first so the device
    leaves any prior mode and starts from idle; prevents interference (e.g. -x
    then -q) and leftover modes, and lets a device be cleanly repurposed (incl.
    reversing range-test roles). Only the mode is reset; channel/PA are preserved.
    Documented in the man page and changelog.
2026-10-21 ubertooth-util: -s/-v list all devices when no -U given
    With multiple Ubertooths and no -U, 'ubertooth-util -s' and '-v' now list
    every device as '<index>: <serial>' / '<index>: <firmware version>' in
    enumeration order (the index is usable with -U), instead of the previous
    'multiple devices found ... could not open' error. -U <index|serial> still
    targets a single device. Implemented as self-contained loops over
    ubertooth_count()/ubertooth_start(i); query-only.
    Verified on sf-control-server-103 with two devices. Remaining query flags
    (-V/-p/-b) and an explicit -U all are tracked in #27/#28.
    Closes #27 partially — see follow-up.
2026-10-21 ubertooth-dfu: make DFU entry reliable (fix leak, release handle, longer wait)
    Three fixes to the auto-DFU-entry that made flashing flaky (esp. with multiple
    devices / stale state):
    - find_ubertooth_dfu_device(): free the device list (was leaked every call;
    called repeatedly while polling, accumulating libusb state).
    - Release the app-mode handle (ubertooth_stop) after cmd_flash, before the
    device re-enumerates as DFU; holding it open could block the DFU open/claim.
    - Poll up to ~10s for the DFU device (enumeration takes ~2s) instead of a short
    5x retry. Clearer error message.
2026-10-21 firmware: track the git revision via a generated version.h
    The firmware version string (-v / -V) must match the git revision it was built
    from, but GIT_REVISION was a -D compile flag with no dependency: make could not
    tell when the revision changed (no source edited), so an incremental build kept
    a stale version string and a good flash was indistinguishable from a stale one.
    Generate $(OBJDIR)/version.h (GIT_REVISION + COMPILE_BY/HOST + TIMESTAMP) and
    have the three version-bearing sources #include it. version.h is a real
    compiler input, so make's normal dependency tracking rebuilds exactly the
    objects that include it. It is regenerated only when the build identity
    changes -- git revision (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
2026-10-21 docs: reflect generated version.h for the firmware version string
    - release_procedure.rst: the release flow writes a version.h into the archive
    (via ubertooth-release.sh) instead of editing GIT_REVISION in common.mk.
    - firmware.rst: note dev builds report git-<hash> (with * when dirty) and that
    -v always matches the running firmware.
    - REQUIREMENTS.md: list GNU make; note macOS stock make 3.81 is sufficient.
2026-10-21 docs(COMPATIBILITY): record GNU make 3.81 + version.h firmware build findings
    - Add a GNU make dimension (3.81 verified on macOS, 4.3 on Linux; build avoids
    make >= 4.0 features).
    - Note arm-none-eabi-gcc output now verified running on real hardware.
    - Add a 'Firmware build: GNU make 3.81 and the generated version.h' note
    covering the version.h mechanism, incremental/hardware verification, and the
    no-git archive fallback.
    - Tighten the TODO wording to reflect hardware end-to-end verification.
2026-10-22 ubertooth-btle: make capture-to-stdout portable and tested (#7)
    Harden the upstream -q - / -c - PCAP streaming feature: use /dev/fd on macOS
    and Linux with a procfs fallback, validate dup/open/dup2/strdup paths, flush
    before redirecting status output, close the saved descriptor after libbtbb
    opens it, keep errors on stderr, reject PCAPNG stdout without polluting stdout,
    and refuse binary output to a terminal.
    Document the supported formats and Wireshark pipeline, hand-sync the roff man
    page, add changelog links, and add Linux/macOS CI checks that assert clean
    24-byte PCAP headers and empty stdout for rejected PCAPNG capture. Normal file
    capture behavior is unchanged.
2026-10-23 ubertooth-ducky: support explicit device selection (#36)
2026-10-23 ubertooth-util: report success status, do not mask failures (#60)
    A successful query stored its value (board ID, channel, PA level,
    squelch) in the shared return variable, so the value became the exit
    status, and a later success overwrote an earlier failure. Track a
    separate 0/1 status and merge it stickily (util_status_after), including
    LED reads/writes and the stop issued before each final action. Unknown
    board IDs are rejected instead of indexing past the name table.
    Identity reports (board ID, firmware, compile info, part ID, serial)
    move to util_report.c with injected device operations so they are
    tested without hardware. Output order is unchanged.
    Closes #40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
2026-10-23 Agent rules: drop model gate, delete merged branches, skip review for rule changes (#62)
    - Drop the different-model requirement and model-identifier reporting from
    the independent review gate; two independent reviews are still required.
    - Delete a PR's remote and local branch once it is merged or closed.
    - Changes limited to .kiro/steering/ are not agent-reviewed and merge
    without a maintainer-approval stop.
    Closes #56
    Also closes #61
2026-10-23 COMPATIBILITY: pin GCC, ARM GCC and libusb minimums from CI; close finished TODOs (#93)
    Closes #92
2026-10-23 tests: exercise ubertooth-util main() against a scripted fake device (#98)
    ubertooth-util.c is included into the test with main() renamed and the
    libubertooth device functions replaced by a scripted fake, so the real
    option parsing, report order, and exit statuses run without hardware.
    Covers nonzero query values (-b, -c, -a, -z, LEDs), every known board ID
    and unknown IDs, composed-option output order, earlier failures not masked
    by later successes, each failing report, setters and their arguments,
    -S/-r (including a failed reselect), every mode command and a failed stop
    before it, argument validation before the device is opened, the help,
    version and count paths, -9, and multi-device -v/-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
2026-10-23 ubertooth-util: list every device for -v/-V/-p/-b, not just -s (#111)
    With several devices and no -U, the read-only identity queries (-s, -v, -V, -p, -b, alone or combined) report every device in enumeration order. One query keeps the compact '<index>: <value>' form; several queries prefix each report line with the index. The two per-flag loops are replaced by one helper that reuses the util_report functions.
    An unopenable device, a failed read, or a report error (for example an unknown board ID) is shown on its own line, the other devices are still reported, and the command exits 1 (it exited 0 before). Devices are closed without sending STOP, so a query no longer stops a running mode. A q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
2026-10-23 install.sh: support macOS with Homebrew; add --prefix and --skip-deps (#112)
    install.sh detects the platform: Debian/Ubuntu keeps the apt + sudo + REQUIRE_ALL=ON path; macOS (Homebrew) installs only missing formulae (cmake pkg-config libusb fftw; dfu-util and the gcc-arm-embedded cask for firmware), builds without BlueZ, udev or ldconfig, and installs into the Homebrew prefix without sudo. It refuses to install over Homebrew's own ubertooth/libbtbb formulae.
    New --prefix and --skip-deps options on both platforms. Installed tools carry a run path to <prefix>/lib, so a non-default prefix works without ldconfig or DYLD settings.
    Fixes multi-device flash selection: it parsed only 'Serial No:'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
2026-10-23 ubertooth-util: support -U all for read-only queries (#114)
    ubertooth-util -U all reports the read-only identity queries (-b, -v, -V, -p, -s) for every attached device, also with a single device. Any other option, or no query, is refused before any device is counted or opened. Only the exact word 'all' is special; other tools treat it as a serial and report no match.
    Closes #28
2026-10-23 ubertooth-util -r: release the pre-reset device handle (#115)
    After cmd_reset() the old handle is released with ubertooth_close()/ubertooth_free(), without sending STOP, before the device is selected again. A failed reset or reselect still exits 1. Tests assert the old handle is released exactly once, before the reselect, and never used again.
    Closes #53
2026-10-23 libubertooth: report part ID read failures; add cmd_get_part_id() (#116)
    cmd_get_partnum() returned 0 (success) when the device reported a nonzero status byte, so ubertooth-util -p printed 'Part ID: 0' and exited 0, and it built the ID by shifting into an int (undefined for bit 31). The new cmd_get_part_id(devh, u32 *) returns 0 plus the full unsigned ID, or a negative libusb error for a transfer error, a short reply, or a nonzero status. cmd_get_partnum() keeps its signature as a wrapper and returns LIBUSB_ERROR_OVERFLOW for an ID above INT_MAX. ubertooth-util uses the new call. A library-level test runs the real ubertooth_control.c against a fake control transfer.
    Closes #52
2026-10-24 specan-ui: average line, plots again, on-screen key help, man page and guide (#120)
    ubertooth-specan-ui did not plot on main: it passed -U 0, -l and -u to ubertooth-specan as single arguments (the selector arrived as the serial ' 0') and asked for 2400-2483 MHz, which ubertooth-specan rejects. Options are now separate arguments, -U takes an index or a serial, the range is 2402-2480 MHz, and the tool's error is shown if it fails to start. Pressing c before the first frame no longer crashes.
    Adds the smoothed average line ported from Sirio Balmelli (siriobalmelli-foss/ubertooth@01c3bf9e), drawn in cyan and advanced once per sweep. Markers are drawn on top of the fading graph so labels leave n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
2026-10-24 ubertooth-util: print nothing for a failed query instead of a meaningless value (#121)
    When a device read fails, -c, -a, -z, -l, -d, -m and the -9 reply print nothing on stdout and 'error: <query> read failed' on stderr instead of a raw negative or default value; the exit status stays 1 and the other queries in the same command are still reported. -d leaves out only the LED whose read failed. -9 now exits 1 when its send or reply fails. Successful output is unchanged.
    Closes #59
2026-10-24 ubertooth-util: release the device handle on exit
    Closes https://github.com/SqueakyFloors/ubertooth/issues/117
2026-10-24 ubertooth-util -r: wait for re-enumeration instead of a fixed 2 s (#142)
    After a reset, poll for the same selection (by serial with -U <serial>) for up to 10 s instead of sleeping 2 s and re-selecting once, so a slow macOS re-enumeration no longer fails a successful reset. Adds libubertooth ubertooth_start_select_quiet().
    Hardware-verified with two boards on sf-control-server-103 and on macOS 26.
    Closes #94
2026-10-24 ubertooth-util: name failed -b/-p/-s reads on stderr (#133)
    A failed single-device -b, -p or -s read now prints "error: board ID read failed", "error: part ID read failed" or "error: serial read failed" on stderr, matching the other queries. stdout and the exit status are unchanged; so is the multi-device listing.
    Hardware-checked on sf-control-server-103 (two boards).
    Closes #123
2026-10-24 ubertooth-util: reject conflicting mode options (#134)
    ubertooth-util now refuses two or more mode options (-q, -n, -e, -t, -x, -I, -i, -f) with an error and exit 1 before opening the device, instead of running only one of them and exiting 0.
    Hardware-checked on sf-control-server-103 (all 56 ordered pairs, two boards).
    Closes #82
2026-10-24 Firmware CI: skip the ARM C++ runtime; test count_bits directly (#151)
    Linux firmware CI jobs install the ARM toolchain with --no-install-recommends (plus newlib, and ca-certificates in the Ubuntu 20.04 container), so they no longer pull in the unused C++ runtime: firmware (ubuntu-24.04) went from about 1m04s to 28-37s. Adds a full-width count_bits() unit test.
    Closes #150
2026-10-24 ubertooth-util: reject stray arguments; accept option values as the next word (#156)
    ubertooth-util refuses a word that is not an option (such as "- V") with "error: unexpected argument '<word>'" and exit 1 before opening the device, instead of ignoring it and running the rest of the command. This includes -h, -H and --host-version, which keep their old precedence. Optional option values may now be the next word: -c 2440, -C 39, -a 5, -l 1, -d 0, -q 100 and -z -90 work like the attached forms (-c 2440 used to read the channel). -z[level] is documented.
    Closes #146
2026-10-24 install.sh: check the Python version; install newlib explicitly (#157)
    install.sh stops with a clear error, before installing or building anything, when Python is older than 3.8 (checked early whenever python3 exists, and again before the venv step). The firmware apt step and REQUIREMENTS.md list libnewlib-arm-none-eabi explicitly, and the apt hints (install.sh, TEST_PLAN.md) name python3-pyqt5, because Ubuntu has no python3-pyside6 before 24.10.
    Closes #152
    Closes #154
2026-10-24 ubertooth-util: -a0 sets PA level 0; refuse -z with a mode (#162)
    -a used 0 as its read marker, so -a0 (and -a 0) read the PA level instead of setting it. Bare -a now reads, a single digit 0-7 sets, and anything else is refused before the device is opened. -z combined with a mode option, where it silently had no effect (a mode stops the device, which resets the squelch), is now refused. The man page documents the PA range, the boot level 7 (the CC2400 reset value), and which transmit modes change it.
    Closes #161
    Closes #159
    Closes #160
2026-10-24 libubertooth: reject short replies to fixed-size reads (#163)
    Every fixed-size libubertooth read (channel, clock, LEDs, PA level, squelch, board ID, serial, part ID, access address, register, modulation, CRC verify, range result, and the text reads) used to return a value made from stale buffer bytes when the board sent a short reply, such as the transient channel 0 after hopping starts. A short reply now prints one line, "error: <what> read failed: board returned <n> of <want> bytes", and returns UBERTOOTH_ERROR_SHORT_REPLY; ubertooth-util and ubertooth-btle add no second line. ubertooth-btle -v and -a fail with exit 1 instead of printing a wrong value. Adds cmd_read_access_address(). The f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
2026-10-24 docs: state the transmit power of the transmitting tools (#168)
    Adds a TRANSMIT POWER section to the ubertooth-tx, ubertooth-btle, ubertooth-ducky and ubertooth-ego man pages: Bluetooth/BLE transmit and BLE interference use CC2400 level 3 (-7 dBm) and ego interference level 7 (0 dBm), regardless of ubertooth-util -a, and the level stays set afterwards. Documents current behaviour; making these modes honour -a is tracked in #165.
    Part of #165
2026-10-24 ubertooth-specan: stop a leftover mode first; drop out-of-range samples (#180)
    Closes #173
2026-10-24 firmware: run ubertooth-util -I as a board-side mode; require matching firmware API (#183)
    Closes #167
2026-10-24 firmware: stop the board wedging when a BLE sniffing mode is stopped (#169)
    Closes #158
2026-10-24 ubertooth-afh, -follow: exit 1 when the selected board is not found (#196)
    Closes #185
2026-10-24 lib: refuse a -U index that is not attached (#201)
    Closes #188
2026-10-24 firmware: every LED specan threshold works, and stopping a mode resets the board (#204)
    Closes #189
    Closes #191
2026-10-24 lib: do not report a broken libusb as "0 attached" (#215)
    Follow-up to #188 (review nits from #201).
2026-10-24 ubertooth-dfu: check the image before the board leaves its application (#217)
    Closes #198
    Closes #199
2026-10-24 lib, docs: name the device count, not "uberteeth" (#226)
    Closes #205
2026-10-24 lib: -U<serial> takes the start of a serial, ignores case, refuses an ambiguity (#221)
    Closes #210
2026-10-24 tests: keep the host suite off attached boards (#225)
    Closes #219
2026-10-24 firmware: one mode-change path, and reliable control requests under LED specan (#230)
    Closes #209
    Closes #213
    Hardware measurement of the final version: #243.
2026-10-24 host tools: refuse impossible option combinations before opening a device (#249)
    Closes #236
2026-10-25 ubertooth-dfu: a detach that fails because the board reset is not a failure (#280)
    Closes #267
2026-10-25 btle-extcap: name the real options, select boards by serial (#289)
    Closes #268
    Closes #269
2026-10-25 ubertooth-util -r: follow the board that was reset by serial (#291)
    Closes #139
2026-10-25 tests: pin the control requests the AFH paths send (#296)
    Closes #262
2026-10-25 tests: stop the device-select test instead of crashing after a failed assertion (#294)
    Closes #276
2026-10-25 steering: one rule for stdout, stderr and exit status (#321)
    Agent and contributor rule; no code change.
2026-10-25 steering: rebase onto main before testing (#335)
    Agent-rule change only.
2026-10-25 btle-extcap: Wireshark's options, stable interface names, honest exit status (#342)
    Closes #297
    Closes #298
    Closes #334
2026-10-25 build: remove the unmaintained Dockerfile (#348)
    Nothing built the image in CI and no user of it is known, so any change to it
    was unverified. It built libbtbb and installed the Python and firmware
    toolchains but never built the Ubertooth host tools. It can be restored from
    git history if a sandbox image is wanted again.
    Removed with it: the Dockerfile entry in the "Check the libbtbb pin" step of
    build.yml, and the two mentions in COMPATIBILITY.md.
    The `docker/` per-OS build images in TEST_LAB.md are a separate, still-open
    proposal and are left alone. Jenkinsfile's `agent { dockerfile { } }` named
    this file; that pipeline is upstream's and does not run here, so it is left
    for #349 to decid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
2026-10-25 steering: short, current PR descriptions and code comments (#368)
    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
2026-10-25 steering: comments say why; PR text stays short (#369)
    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
2026-10-25 docs: keep the hedge in the API version comment, and say what moved it
    Review follow-ups to the API version policy correction, which merged before
    they landed.
    The comment beside UBERTOOTH_API_VERSION is where someone about to bump the
    number looks, so it keeps the caveat the compatibility note, the README and
    the man page already carry: a board on firmware from an earlier commit is
    normally, not always, refused, because a commit that leaves the firmware
    interface alone shares the number before it.
    The CHANGELOG reflash bullet names what moved the number to 1.15 (the removal
    of two developer requests) rather than only the policy issue, and the steering
    rule drops a worked example that goes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
2026-10-26 firmware: keep the amplifier level in btbr and generic transmit, drop the dead syncword (#378)
    The Classic Bluetooth (`btbr`) firmware set the power amplifier to level 3 when
    it brought the radio up, overriding `ubertooth-util -a` there; it now keeps the
    level it finds, so the default rises to the power-on level 7, as #165 did for
    the other transmit modes. The generic transmit request wrote the host's level
    byte into FREND whole, leaving the reserved bit clear and the board's level
    changed after the packet; it now masks the level, writes the reserved bit as 1
    and restores FREND afterwards. The firmware API version is 1.16.
    Also drops the unused global `syncword` in `bluetooth.c` and the con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
2026-10-26 steering: triage issues into release, post-release and backburner (#415)
    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
2026-10-26 steering: every advertised feature must work for the release (#417)
    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
2026-10-26 firmware: stop the board going quiet after a stream ends (#278)
    Part of #239
2026-10-26 debug, dump, tx: give the device handle back (#400)
    Part of #388
2026-10-26 ducky: free the device; ego: check its setup requests (#389)
    Closes #381
    Part of #379
    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
2026-10-26 ego -c and hopping modes; usage text only for a bare command (#406)
    The usage text now follows only a bare command line: every other refused
    command line is its one error: line, and -h prints the usage text. ubertooth-ego
    refuses -c in a mode that hops, and no longer calls 630f9ffe the default access
    code.
    Closes https://github.com/SqueakyFloors/ubertooth/issues/394
    Part of https://github.com/SqueakyFloors/ubertooth/issues/397
    Part of https://github.com/SqueakyFloors/ubertooth/issues/323
2026-10-26 build: pin the libbtbb that follows the spec for AFH hops (#420)
    Part of #143.
2026-10-26 tests: kill fakes with SIGTERM so macOS does not report a crash (#453)
    The extcap test covered the "killed by signal" path by aborting its fake ubertooth-util, and the btbr hop test's die() stub called abort(). macOS writes a crash report for an aborted process and shows a "Python quit unexpectedly" dialog, so every ctest run interrupted whoever was at the machine. The signal number is incidental (the assertion names whichever signal was sent), so the fake is killed with SIGTERM and the stub prints what it was called with and exits 1.
    Closes #451
2026-10-26 ubertooth-rx and -scan: name a request the board refused, instead of capturing anyway (#432)
    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
2026-10-26 A capture holds only packets from the mode it started (#437)
    A capture could open with records left over from the previous one: stale
    advertising records about one run in three, and PCAP times 327.68 s late when a
    leading record carried the previous mode's clock reading.
    The firmware now clears its packet queue when a mode stops as well as when one
    starts, usb_queue_init() resets the keep-alive timer, and libubertooth clears
    the bulk IN endpoint's halt feature as a stream starts so the endpoint's
    hardware buffers are flushed. Firmware API version 1.22.
    Closes #179
    Closes #318
2026-10-26 CHANGELOG: an Under the hood section for fixes users do not see (#469)
    Move 19 deep fixes a user does not meet in normal use out of the release's main sections into a new last section, Under the hood, one plain line each with its links and credits. Remove the test-only entry (#219). Record the three buckets in .kiro/steering/branch-and-review.md.
2026-10-26 firmware: keep answering control requests while a mode runs (#445)
    A board that was receiving, transmitting or scanning stopped answering control
    requests for as long as it waited on the radio. The mode loops now go through
    the bounded waits and service USB while they wait, so a request sent during a
    mode is answered and a mode stops when asked. Firmware API version 1.22 to
    1.23.
    Closes #149. Closes #223.
2026-10-26 firmware: bound a multi-register write, retry each device status event (#446)
    Closes #359
    Closes #409
2026-10-26 ci: time-limit and retry the package installs, and require a reachable libbtbb pin (#461)
    Closes #456
    Closes #428
2026-10-26 bootloader: bound the download, probe an unlisted part, build it in CI (#439)
    Part of #423
    Part of #424
    Closes #425
    Not hardware-tested: installing a bootloader needs ISP or JTAG. Bench test
    tracked in #491.
2026-10-26 libubertooth: say plainly when a board is in use or not answering (#380)
    Closes #232
2026-10-26 firmware: make the two-board range test actually exchange packets (#285)
    **Problem:** the two-board range test never produced anything. With one board on `ubertooth-util -e` and the other on `-n`, they never heard each other and `-m` said `no range test result yet` forever, on this fork and on stock 2020-12-R1.
    **Fix:** the exchange now happens, and `-m` answers a couple of seconds later.
    - Both modes hold the receive gain amplifier out of reset (`MANAND`), as every other receive path does. Without it the radio saw signal but never a sync word.
    - The repeater's turnaround delay was an empty loop the compiler deleted, so it replied while the sender was still transmitting. It is now a one-sec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
2026-10-26 libubertooth: do not ask a board it has lost to stop (#472)
    Closes #454
2026-10-27 firmware: run every CC2400 register transfer with interrupts masked (#430)
    cc2400_spi() bit-bangs the radio's configuration bus over three GPIO
    lines. The main loop and several interrupt handlers all reach the radio
    through it, so a handler could start its own transfer while one was in
    progress, with CSN already low. Both transfers then read or write a
    corrupt word, or lose a strobe, which is how a board ends up misreading
    registers or waiting for a radio state that never arrives.
    Mask interrupts across the transfer, restoring the mask that was in
    force rather than enabling, so the guard nests and is safe inside a
    handler. A bit of the loop costs about 19 cycles, so at 100 MHz an
    8-bit stat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
2026-10-27 A board no longer carries one run's hopping into the next (#485)
    Closes #261
    Closes #312
2026-10-27 ci: cache the ARM toolchain, lint and test tools/, bound the last installs (#513)
    Four faults a review of #461 found in the build workflows: the ARM toolchain was
    re-downloaded on every firmware run, several package installs had no limit,
    nothing linted or tested the scripts in tools/ that the rest of CI depends on,
    and the libbtbb pin check ran once per host matrix entry for one answer.
    The toolchain .deb files are now kept between runs with actions/cache, keyed on
    the files apt would fetch rather than the package names, so a point release of
    the compiler gets a cold download and a new cache. The remaining unbounded
    installs go through tools/retry.sh. A new scripts job shellchecks tools/*.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
2026-10-27 ubertooth-follow: zero the board clock before the capture starts (#503)
    `ubertooth-follow` zeroed the board's clock after it had already submitted the
    receive transfer, so a record sent in between carried the period count from
    before the reset: 150 followed by 0 read as 106 periods gone by and added about
    34,700 s to every later packet time. The address and clock sets, both
    synchronous, now go out before the stream starts; the asynchronous AFH map set
    and start-hopping request stay after the poll thread that completes them.
    Part of #494
    Hardware test pending: #518
2026-10-27 A BR/EDR board no longer stops answering when the radio stalls (#487)
    The BR/EDR image waited on the CC2400's state machine with bare spins,
    from slot tasks that run in the timer interrupt. USB in that image is
    handled from the USB interrupt at the same priority, so a radio that
    never reached the state a slot was waiting for blocked the USB handler
    behind it: every request timed out and the board answered nothing until
    it was re-plugged. That is the same fault as the one behind #158, with
    a different trigger.
    The four waits now go through cc2400_wait_fsm(), which gives up after a
    bound. The helper moves from firmware/bluetooth_rxtx to firmware/common
    so both images share one idiom, and the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
2026-10-27 A BR/EDR board no longer stops answering when a packet stops part-way (#514)
    Running `ubertooth-btbr`, if a packet started arriving and then stopped part-way
    through, the board went silent: every command failed until it was unplugged and
    plugged back in. The receive task was still waiting for the rest of the bytes,
    and it waits inside the timer interrupt, which in this image also holds up USB.
    Both waits in `firmware/btbr/src/btphy/rx_task.c` — for the packet header and
    for the first chunk of payload — now have a deadline on the slot clock, the
    shape `tx_task.c` already uses. The bytes are due at a known time, so the wait
    gives up when they are overdue, the slot ends, and the board keep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
2026-10-27 Stop every tool through one flag, and keep a Ctrl-C the -t timer used to drop (#535)
    Closes #515
    Closes #521
2026-10-27 ubertooth-follow takes the whole target address (-t) (#522)
    `-l` and `-u` give four of the six bytes of a Bluetooth address, so the
    connection `ubertooth-follow` makes to collect the target's clock offset could
    only reach a target whose address begins `00:00`. `-t 11:22:33:44:55:66` now
    names the whole address: that is what the connection is made to, and it gives
    the LAP and UAP the board follows.
    `-t` with `-l` or `-u` is refused, as is any of the three given twice, and `-a`
    now needs `-t`. The tool's progress moves to standard error. Man page, `-h`,
    README, `docs/source/`, CHANGELOG and the `cli_spec.json` matrix updated.
    Part of #316
    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
2026-10-27 Wait for the interrupt before typing the command after it (#553)
    Closes #539
2026-10-27 docs: a board running btbr can be flashed with -U (#582)
    Closes #558
2026-10-27 A firmware info block at a fixed offset, read by dfu and the board (#523)
    Closes #473
2026-10-27 docs: how to tell which firmware image a board or a file carries (#604)
    Closes #530
2026-10-27 firmware: a board that stops answering resets itself and says where it was (#520)
    Stopping a stream sometimes left a board that still enumerated and answered
    nothing (#239). The reset request travels over USB too, so it could not reach a
    board in that state: in a 602-cycle soak on two lab boards, `ubertooth-util -r`
    recovered 0 of 51 wedges and only cutting power to the board's hub port did.
    Both firmware images now arm the watchdog. A board that goes three seconds
    without servicing USB resets itself and comes back idle, and the tool sees it
    disappear and exits instead of hanging forever. It also records the mode and
    wait site it died in, in the no-init RAM that survives the reset, and
    `ube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
2026-10-27 A capture whose collecting thread was never started fails instead of waiting (#591)
    Closes #564
2026-10-27 ubertooth-follow gives the board back when its setup fails (#598)
    Closes #577
    Closes #586
2026-10-27 ubertooth-btle: a capture on standard output prints no dump (#611)
    Closes #602
2026-10-27 ubertooth-btbr: a command whose thread is refused leaves the board free (#599)
    Closes #567
2026-10-27 ubertooth-btbr: name the image to flash when the board takes no request (#623)
    Closes #1
2026-10-27 ubertooth-util -I: one wording for firmware the host tools were not built with (#651)
    -I checked the API version itself and printed its own message, which blamed -I for a requirement it does not have and told the user to flash firmware even when the board was the newer side. The library's text moved into ubertooth_report_api_mismatch(), called by both ubertooth_check_api() and -I.
    Closes #635
2026-10-27 Prototype the bundled getopt (#639)
    The bundled GNU getopt.h declared getopt() in the K&R form off glibc,
    which conflicts with the C library's own prototype and which C23 reads as
    taking no arguments. Declare the full prototype in both branches of the
    __STDC__ test, and the same for getopt_long, getopt_long_only and
    _getopt_internal; convert getopt.c's remaining K&R definitions and take
    getenv() from stdlib.h. macOS and Linux host builds, including with
    -std=c2x, now have no -Wdeprecated-non-prototype warnings.
    Closes #639.
2026-10-27 The dispatch scan reads a case to its own break, and covers the BR/EDR image (#615)
    Closes #594
    Closes #572
2026-10-27 docs: a range test step, version-neutral API samples, a specan example that runs (#675)
    COMPATIBILITY.md claimed the two-board range test as hardware-verified, but
    TEST_PLAN.md had no step for it, so there was nothing to re-run at a release.
    New step 2i: two boards at the same API version, -e on one and -n on the other,
    -m reporting a level in each direction, with the output a real run printed, then
    the weakened link, no range test result yet after a reset, -n with nothing
    answering, and the roles swapped.
    Sample output in the man pages, README.md, docs/ and one CHANGELOG line still
    showed API:1.33, stale since 1.35. They now write it as API:<version> and say
    where the current value lives,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
2026-10-27 Replay a chained low-energy packet where its chain started, and name the board in the mismatch note (#679)
    Closes #643
    Closes #652
2026-10-28 ubertooth-util -n: run the range test and report it (#687)
    -n printed "Starting range test" and returned, so there was no telling
    whether the exchange was running, had finished, or had never been
    answered without running -m afterwards -- and with no repeater in range,
    nothing told you at all.
    It now follows the test it starts: a progress line about once a second
    while it runs, then the same result block -m prints, and exit 0. Nothing
    answering within the wait (10 seconds by default; -n <seconds> to choose
    it, -n 0 to wait forever) stops the test, says so in one error: line and
    exits 1, as do a test that ended or never started and a reply that came
    back corrupted.
    Host only: the board's ran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
2026-10-28 ubertooth-follow: refuse half a -l/-u pair and ask for -t on a failed page (#695)
    Half of the -l/-u pair named no piconet and was taken as no target at all: the
    tool said "No address given, reading address from device" and followed the local
    adapter's own address. It is now refused with the missing half named, as
    ubertooth-rx refuses a -u without its -l.
    A follow keyed on -l and -u pages a guessed 00:00:<UAP>:<LAP>. When that page
    fails the command still stops, and the line now says to give the whole address
    with -t, in the same terms as -a needing -t. It also clears errno first, so it
    reports a reason only when the call left one.
    The man page gains the refused-request report and its libus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
2026-10-28 ubertooth-btbr picks a board with -U, instead of whichever enumerated first (#688)
    With several boards attached the tool opened an arbitrary one, so a session
    could reach a board still carrying bluetooth_rxtx and report its write
    timeout as the btbr board failing. It now takes -U <index|serial> as
    ubertooth(7) describes, refuses a selection that names no board or more than
    one, and names the board a failed setup was talking to. Selecting by index
    reads no serial, so it disturbs none of the other boards. -h prints the usage
    text on standard output and exits 0; a command line it will not take is one
    error: line on standard error, and each option may be given once.
    Closes #642
    Part of #410
2026-10-28 libubertooth: hand a capture's records over properly between its two threads (#712)
    Closes #576
    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
2026-10-28 BLE: a target filter needs a whole address, not the CRC behind a runt one (#606)
    Closes #593
2026-10-28 Free the handle in every tool, make closing a board idempotent, and lock the receive transfer (#702)
    Closes #385
    Closes #387
    Closes #388
    Closes #399
    Closes #407
    Closes #580
2026-10-28 Every version line ubertooth-util prints says what it is
    The host tools version had no label and the multi-board listing replaced each
    report's label with a bare index, so the same information read differently
    depending on how it was asked for. -H (and -V in ubertooth-rx, -tx and -afh)
    now says "Host tools version: libubertooth ...", and a listed line keeps its
    own label with the board's index in it: "Firmware version (0): bluetooth_rxtx
    git-1b62ced (API:1.37)".
    A board the listing cannot open says why where its value would be,
    "Firmware version (1): unavailable, in use by another program", one line per
    query asked for, beside libubertooth's error line on standard error, and the
    command exi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
2026-10-28 btbr reports the tree's API version, and a fault reads back as a fault (#717)
    The btbr image reported a fixed bcdDevice of 1.06 that nothing bumped and
    nothing checked, so a board carrying it was refused by every tool but
    ubertooth-util -v. It now reports UBERTOOTH_API_VERSION, firmware/btbr joins
    the files tools/check-api-version.sh watches, and the bootloader's 0x0100
    becomes UBERTOOTH_BOOTLOADER_API_VERSION, fixed on purpose.
    Both images' fault handlers mark which of the four faults they are in, and
    btbr's die() marks that the firmware stopped the board itself. Each of those
    paths ends in a loop nothing feeds, so the watchdog resets the board and
    ubertooth-util -w reads the record back o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
2026-10-28 The programmer answers the host first, and the radio waits are counted (#724)
    `ubertooth-util -i` used to look like a broken board: both firmware images
    handed the chip to its on-chip programmer from inside the request handler, so
    the board left the bus with the answer still in the endpoint 0 buffer and the
    host was told the request had timed out. Each image now defers the hand-over
    the way it defers a reset, masks interrupts across it, and the command says the
    board stays in the programmer until its power is cut.
    The radio waits that give up are counted per shape and read with
    UBERTOOTH_GET_RADIO_TIMEOUTS, which `ubertooth-util -w` prints: a radio that
    never reaches the state it was asked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
2026-10-28 A development build warns about firmware of another API version (#636)
    A release build still refuses it, and CI configures with -DUBERTOOTH_RELEASE=ON so what it tests refuses it too. UBERTOOTH_ALLOW_API_MISMATCH sets either answer whatever the build was.
    A request the board's firmware has not got now has one wording everywhere, naming the request and both firmware API versions, in place of the three lines that said it before.
    Closes #636
2026-10-28 A listing that could not open a board is a failed listing (#766)
    Part of #386
2026-10-28 A board in use, a bus that could not be read, and the follow delay (#753)
    ubertooth-btbr reports a board another program holds in the words every other
    tool uses, instead of as a set-up the board refused with a note about firmware
    that had nothing to do with it.
    ubertooth-dfu tells a USB bus it could not read, and a board that left the bus
    between the listing and the open, apart from a board that came back and would
    not open; the stage trace keeps the raw code behind each.
    ubertooth-follow -w is applied in the unit it documents: a timeslot of 625 us
    is two of the board's 312.5 us clock ticks, so the default compensates the
    3125 us it says rather than half of it.
    The soak #584 asked for wa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
2026-10-28 BLE follow: the connection's CRC init, and a channel map with no channels (#765)
    `ubertooth-btle -f -v1` gave an empty capture on a followed connection: the
    board reversed the connection's 24-bit CRC starting value over a whole 32-bit
    word, so every data packet of the connection failed verification and was
    dropped. Advertising was unaffected, where the fixed literal makes the mistake
    cancel.
    A channel map update with no channels in it is now refused, as the connection
    request handler already refuses the same field. The remapping divides by the
    number of channels in use, and with the divide-by-zero trap off the division
    returned 0, so every connection event from the update's instant on tuned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
2026-10-28 ubertooth-util -r recovers a board that answers nothing (#761)
    A board whose firmware has stopped answering control requests refuses the
    reset request like every other request, so -r left it exactly as it was and
    then reported that it never came back: the board needed a re-plug, or on a hub
    a port power cycle. -r now resets the board's USB connection first -- the
    re-plug done in software -- and then resets the board as usual, so it comes
    back idle. Select such a board by index: its serial cannot be read.
    The serial-scan note names -r beside -S, and TEST_PLAN.md gains the manual
    check, including how to reach a board in that state.
    Part of #731
    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
2026-10-28 The radio's FIFO transfers are atomic, and a long generic transmit packet goes in a piece at a time (#772)
    cc2400_fifo_write() and cc2400_fifo_read() bit-bang the radio's bus themselves
    instead of going through cc2400_spi(), so the guard #430 gave the register
    transfers did not cover them: a control request arriving from the USB interrupt
    while a mode wrote the FIFO from its loop could begin its own transfer with CSN
    already low and corrupt both. Both now mask interrupts from before CSN drops
    until after it rises, and the comment above them says what that costs and which
    modes pay it.
    tx_generic() wrote up to 50 bytes into the 32-byte FIFO in one call. It now
    writes a FIFO's worth at a time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
2026-10-28 The range test waits for the radio to have the packet before reading it (#755)
    Both the sender and the repeater started clocking a packet out of the radio's
    FIFO the moment the radio reported the sync word, which is before the first
    payload byte exists, so byte 0 came back wrong every five to ten runs -- and
    only byte 0, because the bit-banged read trails the air from the second byte
    on. The radio's CRC flag cannot see it: that is computed over what arrived on
    the air, not over what the read returned.
    Both now wait four byte times of air time on timer 0 before they read, with a
    poll cap so a counter that is not advancing cannot leave the wait spinning.
    The firmware API version is now 1.44,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
2026-10-28 BLE capture: the first connection event, checked updates, and honest timestamps (#762)
    A connection request names a transmit window, and the master's first packet may
    arrive anywhere inside it, but the first connection event was given the time of
    one packet, so a window longer than the 1.25 ms minimum could expire unwatched.
    A connection update's parameters were taken straight off the wire; they are now
    checked against the ranges a connection request's already were, and one outside
    them is ignored rather than acted on, because any data packet whose first bytes
    look like an update reaches that handler. Every LE packet's timestamp was 8
    microseconds late, because the back-dating left out the h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
2026-10-28 ubertooth-debug: say why the ADC readings are unsigned, and pin it (#789)
    Closes #732
2026-10-28 Make the audit's latent arithmetic right on its own (#746)
    Sixteen buffers, bounds, timeouts, types and byte-order conversions that are wrong but that nothing in the tree can reach. Each is corrected so it is right by itself, so a later change that makes one reachable is not wrong.
    No shipped tool behaves differently. The firmware API version moves to 1.46 for the three places where what the host can ask for changes at all: two requests refuse a value they used to accept, and a record names no channel when the board is tuned outside the band.
    The bootloader's flash clock is chosen per board; the image built for the shipped board is byte-identical.
    Part of #656
2026-10-28 firmware tests: run the specification's published hop sample data (#809)
    Both firmware images work out the BR/EDR hop sequence on the board, and a wrong
    answer means the board tunes somewhere the piconet is not. Their hop tests
    pinned a few dozen vectors from a transcription of the selection rules; the Core
    specification publishes the sequence itself, so check against that.
    firmware/tests/spec_hop_vectors.h carries Vol 2 Part G Section 2 as C tables,
    shared by both images' tests: 7680 connection-state vectors (three addresses,
    the basic sequence and four channel maps, 512 clock values each) through
    bluetooth_rxtx's precalc()/next_hop() and btbr's
    hop_init()/hop_cfg_afh()/hop_basic(), and 19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
2026-10-28 The word a stray dash is in, one wording for an address, and -s and -t each own one (#776)
    A stray dash after an option named a word nobody typed: "ubertooth-util -v-"
    blamed "--" and "ubertooth-util -v- -h" blamed "-h". Both now name the word the
    dash was written in, as a dash inside a word already did. The shared reporter
    works out which word that is from where the option parser stopped;
    ubertooth-btbr, which has its own copy, asks getopt again instead and so names
    it exactly.
    A value that is not a Bluetooth address was worded three ways across three
    tools, with a fourth wording in ubertooth-btle for a bad hex digit. One wording
    now, naming the address the option sets, from a printing wra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
2026-10-28 Shared test harness for the last five tests, the libbtbb in use
    The five tests that still carried their own copy of the main() harness use
    the shared one, which gained the capture pair the DFU tests need for the
    calls they drive directly. Folding ubertooth-util in found a bug in the
    shared harness: it freed the argument copies from the argv the tool was
    handed, and that tool rewrites "--host-version" to "-H" in place, so the
    free hit a string literal.
    The host tools version now says which libbtbb the run loaded, asked of the
    loader, and install.sh ends by printing it and warns when the tools load a
    libbtbb from outside the install prefix.
    The ToorCon 13 badge's range test listened about 90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
2026-10-28 Device selection says what happened, and specan checks every write (#777)
    The lines a tool prints while choosing a board are the last of the
    output-stream rule's holes: "could not open Ubertooth device" had no prefix,
    named no cause, and followed whatever the selection had already said. With no
    board attached every tool now says "error: no Ubertooth devices found"; with
    several attached and no -U, one error: line that says -U takes a serial too,
    and then the boards. A libusb failure nothing can put in words reads
    "error: Input/Output Error (libusb -1)". A bus the host could not list is
    reported as that rather than as an empty bench.
    ubertooth-specan checks every text write as it checks the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
2026-10-28 Firmware: waits that give up in a slot, and loops that say where they stopped (#794)
    Firmware: waits that give up in a slot, and loops that say where they stopped
    The BR/EDR image's per-slot waits on the radio's state machine take their
    deadline from the slot clock instead of a poll count of about 9 ms, so a radio
    that is late costs at most the slot it is in rather than about 28 piconet clock
    counts. The ceiling comes from the timer's match register, so a shortened tick
    cannot leave a wait with a deadline it will never see.
    The ToorCon badge's transfers to the radio give up rather than spinning on a
    UART flag, with a byte that never arrived reading as zero so the radio reads as
    not ready.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
2026-10-28 btle-extcap.py: answer the capture-filter check, and exit 0 or 1 (#806)
    A capture filter typed for an Ubertooth interface in Wireshark is reported as one this interface does not apply, which Wireshark shows in red in the filter box; an empty filter is still good. --capture exits 0 or 1 and nothing else instead of passing ubertooth-btle's status through, Ctrl-C under tshark ends a capture with exit 0, and ubertooth-btle's own decode no longer lands on this script's standard output.
    Closes #343
2026-10-28 ubertooth-btle -s takes a plain address: none and /<bits> are refused (#816)
    A faux slave advertises from one whole address, so the target's "/<bits>" mask had nothing to narrow and "none" nothing to clear. Both parsed and were then dropped, so "-s none" advertised from 00:00:00:00:00:00. Each is now refused with one error: line and exit 1, before a board is opened. -t is unchanged.
    Closes #779
2026-10-28 ubertooth-btbr: decoded packets on standard output, progress plain on standard error (#797)
    The packets a command decodes, and the inquiry responses with their EIR, were
    log lines on standard error, so a session piped into anything got nothing.
    They now go to standard output, one line each with the HH:MM:SS time in front
    of it, and the progress a command makes stays on standard error as plain
    lines, without the time or the level.
    A session holding a connection reports its LMP packets there too, which it
    printed nowhere a reader could see before, and packet lines carry no terminal
    color. A standard output that has gone away, as `| head -5` leaves it, is one
    `error: standard output has gone a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
2026-10-29 Endings a run got wrong: a refused teardown, a board that left the bus, a capture file left behind (#833)
    Ten tools exited 0 after the request that ends their capture mode was
    refused, leaving a board no other tool could open. ubertooth_stop() now keeps
    what its STOP came back with, read through ubertooth_stop_failed(), and every
    one of those tools turns it into exit 1 with whatever was captured still
    written out.
    ubertooth-btbr exits 1 when the thread reading the board stopped on a
    failure; a single refused command still leaves the prompt up and the status
    alone.
    A capture file is created once the board is open and its firmware accepted, so
    a run refused for its firmware leaves no empty f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
2026-10-29 BLE capture: keep up with a followed connection, recover a failed transfer, and report a fault
    A followed connection whose first event received nothing left the next one
    armed at a moment the board's 100 ns clock had gone past, which it only reaches
    when that clock wraps 429 seconds later, so the receiver sat on one data
    channel; and the same path refreshed the supervision timer on every empty
    event, so a connection that stopped delivering was chased forever instead of
    letting the capture pick up the next one. The engine now counts intervals from
    the transmit window the connection named, arms every event a margin ahead of
    the counter, skips whole intervals with their hops when the estimate h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
2026-10-29 A stray dash names the word it is in, and the badge reads the radio's FIFO (#831)
    The shared option reporter is given each tool's option letters and parses the
    command line again to find the word a rejected dash was written in, so a
    command line holding two dashes names the one that is wrong rather than an
    attached option value that happens to hold one.
    The ToorCon 13 badge's range test gets its own framed FIFO transfers, at the
    slower clock a FIFO read needs, so it can pass: it used to transmit empty
    packets and read zeros back, and so failed however close the two boards were.
    Closes #790. Closes #705.
2026-10-29 BLE promiscuous mode discovers its own access address (#834)
    ubertooth-btle -p has two halves: it listens for an access address to repeat
    on the channel it is holding, then follows that address. It skipped the first
    half whenever le.target_set was on, and UBERTOOTH_BTLE_SET_TARGET sets that
    too -- for a device address and no access address at all. So
    "-t <address> -p" synced on the advertising access address and captured
    nothing, and the setting outlived the tool, so every later -p did the same.
    Promiscuous mode now has its own le.access_address_set, set only by
    UBERTOOTH_SET_ACCESS_ADDRESS and cleared by reset_le(), so neither a target
    left by a follow run nor a connection timeout during -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
2026-10-29 One Ctrl-C ends a capture, even one that arrives while the board is being opened (#839)
    Closes #584
2026-10-29 A scan collected in a file holds the devices it found and nothing else (#853)
    Part of #323
2026-10-29 Refuse radio values the board cannot use, and bound the LE byte wait (#822)
    Closes #818
    Closes #819
    Closes #820
2026-10-29 An interrupted firmware download leaves nothing the bootloader will start (#863)
    Part of #242
2026-10-29 A capture reports a transfer error the board marked on a packet (#868)
    Closes #849
2026-10-29 ubertooth-btle page: put back the three paragraphs a rebase dropped (#876)
    Restores the rssi= explanation, the note on what earlier releases printed, and the capture transfer error paragraph, lost when a branch was rebased over #867 and #868. Documentation only.
2026-10-29 docs: a one-page guide to using Ubertooth with Wireshark (#895)
    Part of #892
2026-10-29 Capture records claim no noise power nothing measured (#888)
    Closes #873
2026-10-29 A capture says when the board wrote new symbols over a block it had not read (#875)
    Closes #869
2026-10-29 ubertooth-btbr: what `?` prints goes to standard error (#885)
    Closes #874
2026-10-29 The range test's wait is no longer cut short by a lengthened clock period (#880)
    Closes #870
2026-10-29 docs: bring the Ubertooth One hardware page up to date (#923)
    Add a short Hardware section to the README with the board photo and links on
    to the hardware page and the design files. Rewrite the hardware page: which
    LPC part a board carries and how much flash and RAM it has, what the radio can
    and cannot do, the connectors and the LEDs as the firmware drives them today,
    and the KiCad design files the board is built from. The page no longer says
    the board connects to a host running Kismet.
    Drop the Ubertooth Zero page, its image and its index entry; the fork's
    documentation covers Ubertooth One.
2026-10-29 firmware: close the timer and capture races that lose a buffer (#889)
    Closes #877
    Part of #505
2026-10-30 firmware: the low-energy LED blink gets a counter of its own (#936)
    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
2026-10-30 agent rules: say what an agent may merge, in the maintainer's own words (#940)
    Copies the maintainer's 2026-10-27 and 2026-10-29 merge rules into .kiro/steering/branch-and-review.md, which contradicted them.
2026-10-30 btbr: a progress line from the board carries no NUL terminator (#944)
    Closes #943
2026-10-30 firmware: audit the state the interrupt handlers and the main loop share (#932)
    Part of #884
2026-10-30 README: the current pre-release is 2026-10-DEV2 (#954)
    Part of #354
2026-10-30 btbr: complete a page heard in the second half of the pager's slot (#921)
    Part of #807.
2026-10-30 A good Wireshark capture no longer ends in an error (#965)
    Closes #804
2026-10-30 firmware: the board keeps answering when it is asked for its serial number (#955)
    Closes #505
2026-10-30 btbr: answer an LMP request with no handler, report a peer's detach, and name the power control PDUs correctly (#958)
    Closes #950
    Closes #951
    Closes #949
2026-10-30 btbr: carry on through a short LMP PDU and a peer's refusal, and refuse a session with nowhere to print (#970)
    Closes #960
    Closes #957
    Closes #959
2026-10-30 docs: describe the capture files the tools write today (#985)
    Rewrite docs/source/bluetooth_captures_PCAP.rst to describe what libbtbb and the fork's tools write today: formats and link types per tool, the two pseudo-headers with their real field names, the record flags and when each is set, the three PCAPNG interface options that are written, the wideband RF option that is defined but never written, what a long LE capture does when it runs out of room for connection records, and how Wireshark reads these files.
2026-10-30 btle: the gap printed beside a packet is the gap the capture recorded (#979)
    Part of #974
2026-10-30 ego: the gap printed beside a packet is the gap the capture recorded (#990)
    Part of #981
2026-10-30 Move the libbtbb pin to the clock-recovery fix (#1016)
    Part of #968
2026-10-31 Move the libbtbb pin to the PCAP capture-file fix (#1020)
    The pinned libbtbb now carries SqueakyFloors/libbtbb#119, so a PCAP capture file the writer could not finish is taken away again instead of being left behind empty, and the tools report the reason themselves.
2026-10-31 btbr: a message from the board that ends early is dropped, not raised on (#982)
    Closes #978
2026-10-31 firmware: read and arm GIO6 on the port the pin is on, per board (#1010)
    Closes #1006
    Closes #1007
2026-10-31 tests: pin the error line for a capture file that cannot be created (#1030)
    Closes #1023
2026-10-31 firmware: arm btbr's GIO6 interrupt on the port the pin is on (#1018)
    Part of #1011
2026-10-31 Rename the Bluetooth roles to Central/Peripheral, SPI to chip select (#1033)
    Closes #1031
2026-11-01 Bump the libbtbb pin to the current master (#1042)
    Part of #736
2026-11-01 firmware: audit the two blink timers the shared-state audit left out (#1051)
    Closes #884
2026-11-01 Expose the board's generic radio mode (experimental): ubertooth-debug -w and ubertooth-dump -g (#1052)
    Part of #352
2026-11-01 ubertooth-btbr: say that two boards close together need a lower transmit level (#1070)
    Part of #807
2026-11-01 Report which bootloader a board has: a version block in the bootloader and ubertooth-util -B (#1062)
    Part of #1056
2026-11-01 ubertooth-btbr: finish the link setup between two boards, and answer an echo request (#1071)
    Closes #807
2026-11-01 Say when a capture's receiver is being driven past what it can measure (#1073)
    A capture whose receiver is deafened by a signal it cannot measure used to look like a capture of an empty channel. It now says so once, on standard error, with a total of such stretches when the capture ends, for the captures whose records are samples of the air.
    Part of #1040
2026-11-01 Pin the shared man page sections, and refuse an older installed libubertooth (#1085)
    Part of #745
2026-11-01 ubertooth-scan: name the manufacturer of a recent device (#1086)
    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
2026-11-01 Print the survey heading on standard error (#1082)
    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
2026-11-02 ubertooth-rx: read several boards at once and share what they find (#1063)
    Part of #783
2026-11-02 ubertooth-scan: a device that will not give its name no longer holds the survey (#1091)
    Part of #1090
2026-11-02 Keep a stated UAP across a clock drop, dump the promiscuous report, and read a vanished DFU device as absent (#1076)
    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
2026-11-02 Move the libbtbb pin to the scored clock search, so ubertooth-rx follows an adapted piconet (#1088)
    Closes #968
2026-11-02 Add a legible PDF of the Ubertooth One schematic (#1093)
    The 2011-format .sch plots with no symbol bodies from kicad-cli. The script converts it to the current format with the project cache library's symbol graphics embedded, and checks the result against ubertooth-one.net before writing the PDF.
2026-11-03 changelog: bootloader and flash protections, and what needs a reflash (#1096)
    Consolidates the release's bootloader and flash notes into one entry: reflashing is not required to run this firmware, and lists the protections a board gains only with a bootloader built from this tree. Part of #354.
2026-11-03 tests: time the quiet-wait cases from a stated moment, not a 5 ms sleep (#1102)
    Removes the 5 ms usleep margin that let scheduler jitter flip bredr-callback's quiet-wait assertions on the CI runners; the cases now state the moment outright. 4/300 failures on main to 0/300. Closes #1094.
2026-11-03 Remove code the linker and the compiler show nothing reaches (#1106)
    Tool-driven removal of unreachable firmware code: six functions, a block of declarations, and about twenty unused locals with no readers. Images build the same size, firmware API unchanged, 133/133 host tests, board runs clean. Bootloader files left for a later sweep while the bootloader PRs are in flight. Part of #747.
2026-11-03 tests: the two basic-rate format tables must agree (#1107)
    Adds a test that reads the firmware btbr format tables and ubtbr's TX_FORMATS from source and checks they agree on every format's slot count, length range, header, and voice field, so a divergence fails the build instead of surfacing on the board. Part of #745.
2026-11-03 ci: the libbtbb pin check reads the line that pins the commit (#1100)
    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
2026-11-03 Pin that a replay reports the signal levels the live capture reported (#1117)
    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
2026-11-03 firmware: give the algorithm-2 search its own watchdog site (#1111)
    The promiscuous capture's search for a connection hopping with channel
    selection algorithm 2 runs in the capture's packet callback and takes a
    couple of hundred milliseconds. No watchdog site named it, so a
    ubertooth-util -w read taken during the search, and a watchdog reset
    recorded inside it, both read as "not in a wait".
    Add WATCHDOG_SITE_LE_CSA2, mark it around le_csa2_recover(), and give the
    previous site back, so -w says "searching for a BLE connection's hop
    sequence" instead. The enum gains a value at the end and renumbers
    nothing, so the firmware API version is unchanged. Nothing else changes:
    no on-air behavior, no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
2026-11-03 Say which transport a Classic capture record's payload came in on (#1122)
    A BR/EDR capture record always said the logical transport was unknown,
    whatever the decoder had read the payload as. An HV3 record and an EV3 one
    were therefore indistinguishable: the two share TYPE code 0111 and a payload
    of the same length, and that byte is the only field in a record that tells
    them apart, and so says whether the payload ends in a CRC. The capture format
    also reads a record's count of corrected payload bits according to it.
    The pin moves to libbtbb 09b9512, whose records name the transport the
    payload decoded on, and which also keeps a failed allocation in one of its
    hash tables from ending the tool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
2026-11-03 Install a bootloader over USB (#1064)
    A bootloader refuses USB writes to its own region, so it cannot replace
    itself: in earlier releases a new bootloader reached a board only over the
    serial programming interface or JTAG. firmware/bl_update is an ordinary
    application image carrying the 16 KiB of bootloader region, and
    ubertooth-dfu --update-bootloader -d bl_update.dfu installs it over USB.
    The sector holding the vector table is programmed last, so an interruption
    leaves erased flash at address 0, which the boot ROM refuses: the board waits
    in the part's own serial programmer rather than running something half
    written. The host prints the region hash the new bootloader will report, and
    uber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
2026-11-03 Say what reaches a board waiting in the DFU bootloader (#1109)
    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
2026-11-03 Move the libbtbb pin on to 5c4e5359 (#1125)
    The pin moves from 09b9512 to 5c4e5359, so the host tools are built against
    a libbtbb that starts the clock search for a piconet whose address part (UAP)
    is given as 0x00, which is what `ubertooth-rx -u 00` gives it, and that
    chooses no clock candidates for a piconet it has observed no packets from
    instead of tens of thousands.
    The two fixes the previous pin bump brought, naming a BR/EDR record's logical
    transport and a hash table short of memory reporting instead of ending the
    calling program, are in this commit's library too.
    The pin is written out in seven files and the libbtbb-pin check requires them
    to agree, so all seven move together. No c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
2026-11-03 Move the libbtbb pin on to 7e1cdf0 (#1135)
    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
2026-11-03 btbr: drop the DMA transmit path nothing builds (#1158)
    Removes btbr's never-compiled USE_TX_DMA transmit half, the module variables the linker reported unreferenced, dma_rx_lli, dma_get_error() and the never-defined dma_init_gen() declaration. Same instructions; .bss loses 24 bytes.
    Part of #747
2026-11-03 rx: refuse an output file that is the replay's own input (#1132)
    Part of #1130 — on macOS and the BSDs #1130's symptom is still reachable
    through a descriptor path, which #1146 carries, so #1130 stays open until that
    is settled too.
2026-11-03 ubertooth-btbr: refuse -f and -b values the board would narrow (#1153)
    Closes #1142
2026-11-03 Remove three pieces of code no build reaches (#1163)
    Third pass of the unreachable-code sweep. Each removal is code the compiler or
    the linker already reports as unreferenced, and all nine firmware images come
    out byte for byte identical to main's.
    - firmware/common/usb_serial.h declared six static functions that it never
    defines. usb_serial.c defines each of them before its first use, so it does
    not need the declarations; every other file that includes the header got a
    static declaration with no definition behind it, which GCC reports.
    - firmware/assembly_test/assembly_test.c kept two USB endpoint handlers that
    nothing registers, along with the commented-out registration lines that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
2026-11-04 scan: print a name only where the device's own answer carried it (#1175)
    Closes #1172
2026-11-04 dfu: say whether a bootloader update installed anything (#1138)
    * dfu: say whether a bootloader update installed anything
    --update-bootloader decided it had worked by finding a DFU device after
    the reset. A board whose bootloader entry pin is bridged looks the same:
    the bootloader stays in DFU instead of starting the updater image, so
    nothing is written, and the command still told the user to write their
    firmware again and exited 0.
    Read the bootloader report before the write, while an application is
    still running and can give it, then read the region back over DFU
    afterwards and compare. A region that holds the image's bootloader is
    reported with its hash; a region that is still exactly w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
2026-11-04 rx: report no level where the board could not measure one (#1192)
    Closes #1162
2026-11-04 changelog: tighten the Highlights to be short and punchy (#1199)
    Per maintainer feedback: #1184 landed the Highlights, but the section read too
    long for highlights. Cut the intro to two sentences and each highlight to a
    bold headline plus one sentence, dropping the measurement and mechanism detail
    that the per-tool sections already carry. Every issue/PR link and the libbtbb
    references are kept.
2026-11-04 dfu: leave a board that already has this bootloader alone (#1190)
    Closes #1123
2026-11-04 btle: report no level where the board could not measure one (#1198)
    Part of #1194
2026-11-04 follow: pin what -a does with an AFH map it cannot stand behind (#1181)
    Closes #44
2026-11-04 doc: say which mode starts put the squelch and the LEDs back (#1196)
    Closes #1193
2026-11-05 CONTRIBUTING: twelve required checks, and who may merge past a pending macOS leg (#1206)
    Part of the pre-release documentation review.
2026-11-05 steering: twelve required checks, the macOS delay rule, and less CI text repeated from CONTRIBUTING (#1207)
    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
2026-11-05 steering: current labels, the PR body layout in use, and the library's own result stream (#1209)
    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
2026-11-05 README: name the current pre-release, and say the version rules once (#1217)
    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
2026-11-05 doc: ubertooth-rx and ubertooth-dump man pages (#1208)
    Documentation review of the two Classic capture pages: the multi-board and replay refusals are quoted, the noise estimate's reference and the end of the dBm scale are corrected, the signal and noise explanation moves out of the OPTIONS list, and EXIT STATUS is one list instead of eleven overlapping paragraphs.
2026-11-05 doc: board administration, firmware and transmit pages (#1214)
    Documentation review of ubertooth-util(1), ubertooth-dfu(1), ubertooth-debug(1), and ubertooth-tx(1). The range test's progress lines are on standard error, not standard output as the -n entry said; -x, the refused USB reset, the second -w list refusal and its cap of 256 writes are documented; and the history and bench measurements go.
2026-11-05 install.sh: print only the usage text for --help (#1224)
    Closes #1205
2026-11-05 docs: restore the --admin rule to maintainer-only (#1223)
    * docs: restore the --admin rule to maintainer-only
    A pull request with a required check red, stuck, or still to report is the
    maintainer's call. CONTRIBUTING.md and the branch-and-review rules say so
    again, in both places, and no longer describe a case where an agent merges
    past a pending check itself.
    * Review fixes: one wording for the prohibition, and name both check states
    Both files now say "Never use `--admin`" in the same words, and say that a
    check still to report is the same call as a red one. In CONTRIBUTING.md the
    exemption, not the repository owner, is what the sentence is about.
    * docs: drop the repository owner's ex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
2026-11-06 install.sh: install or update the bootloader (#1231)
    * install.sh: install or update the bootloader
    Updating a board's bootloader meant building bl_update by hand, running
    ubertooth-dfu --update-bootloader, flashing the firmware again, and
    checking the result with ubertooth-util -B. --update-bootloader, beside
    --flash-device, does all of that for the board named.
    A board that already has the bootloader the image carries is left alone,
    which ubertooth-dfu decides and this reports. A board that was written is
    left in DFU, where it has no serial for -U to name, so the firmware goes
    back on with no selector; a board already waiting there stops the run
    before anything is written, because uberto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
2026-11-06 Record only the version in an image, and take an archive's release from git (#1233)
    * Record only the version in an image, and take an archive's release from git
    Closes #1230.
    * Check the release tag patterns against the placeholder git fills in
    * Keep a checkout's own history ahead of an archive's release
    * Move the libbtbb pin to the release-from-git commit
    * Let the version line read unknown where a checkout reaches no release tag
    * Stop every tool's -V description promising a build line
    * Refuse a release name a build cannot report, and read one line the same way twice
2026-11-07 tests: move the generated command-line cases to the matrix, keep the two it cannot generate (#1239)
    Removes test_ducky_options.py and cuts test_output_streams.py from 375 lines
    to 158, keeping the two rules test_cli_matrix.py cannot generate: a refusal
    pinned as a whole line with standard output empty, and a capture sent to a
    terminal, which needs a pty where every matrix run gets a pipe.
    Closes three spec gaps the review found: ubertooth-afh's removed option, the
    rx survey refusal held only by substring, and follow's -t with no case in the
    user's own case. The long selector is two combinations entries, taking
    ubertooth-ducky from 90 generated cases to 96.
    258 lines removed net. Host binar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
2026-11-11 install.sh: skip builds when already up to date, merge --flash options (#1251)
    Three changes to install.sh:
    1. Skip libbtbb and host tools when already installed at the same
    version. libbtbb is compared by its pinned ref (from the install
    record), host tools by their version string (ubertooth-util -V vs
    git describe). --force rebuilds everything.
    2. Merge --flash and --flash-device into one option with an optional
    selector. --flash is kept as an alias. With one board attached the
    selector is optional for both --flash-device and
    --update-bootloader.
    3. Always flash with the tools this run just built, instead of using
    whatever older binary happened to be on PATH. Fixes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
